Shnassar25/-Digital-IC-Design-SoC-RTL2GDS/spyglass/post_rtl/spyglass-1/consolidated_reports/lint_lint_abstract/README

################################################################################
#
# This file has been generated by SpyGlass:
#     Consolidated Reports Created by: ICer
#     Consolidated Reports Created on: Sun Sep 27 03:24:59 2026
#     Working Directory              : /home/ICer/ASS/Final_System/spyglass/post_rtl
#     Consolidated Reports Location  : ./spyglass-1/consolidated_reports/lint_lint_abstract/
#     SpyGlass Version               : SpyGlass_vL-2016.06
#
################################################################################

This directory contains critical reports generated in current run
In case this directory needs to be compressed using gtar, you may use - 

    % gtar -cvzf <compressed_tar_file_name> ./spyglass-1/consolidated_reports/lint_lint_abstract/
