Shnassar25/-Digital-IC-Design-SoC-RTL2GDS/spyglass/post_syn/spyglass-1/consolidated_reports/Design_Read/README

################################################################################
#
# This file has been generated by SpyGlass:
#     Consolidated Reports Created by: ICer
#     Consolidated Reports Created on: Mon Sep 21 02:56:27 2026
#     Working Directory              : /home/ICer/ASS/Final_System/spyglass/post_syn
#     Consolidated Reports Location  : ./spyglass-1/consolidated_reports/Design_Read/
#     SpyGlass Version               : SpyGlass_vL-2016.06
#
################################################################################

This directory contains critical reports generated in current run
In case this directory needs to be compressed using gtar, you may use - 

    % gtar -cvzf <compressed_tar_file_name> ./spyglass-1/consolidated_reports/Design_Read/
