Shnassar25/-Digital-IC-Design-SoC-RTL2GDS/final report.pdf

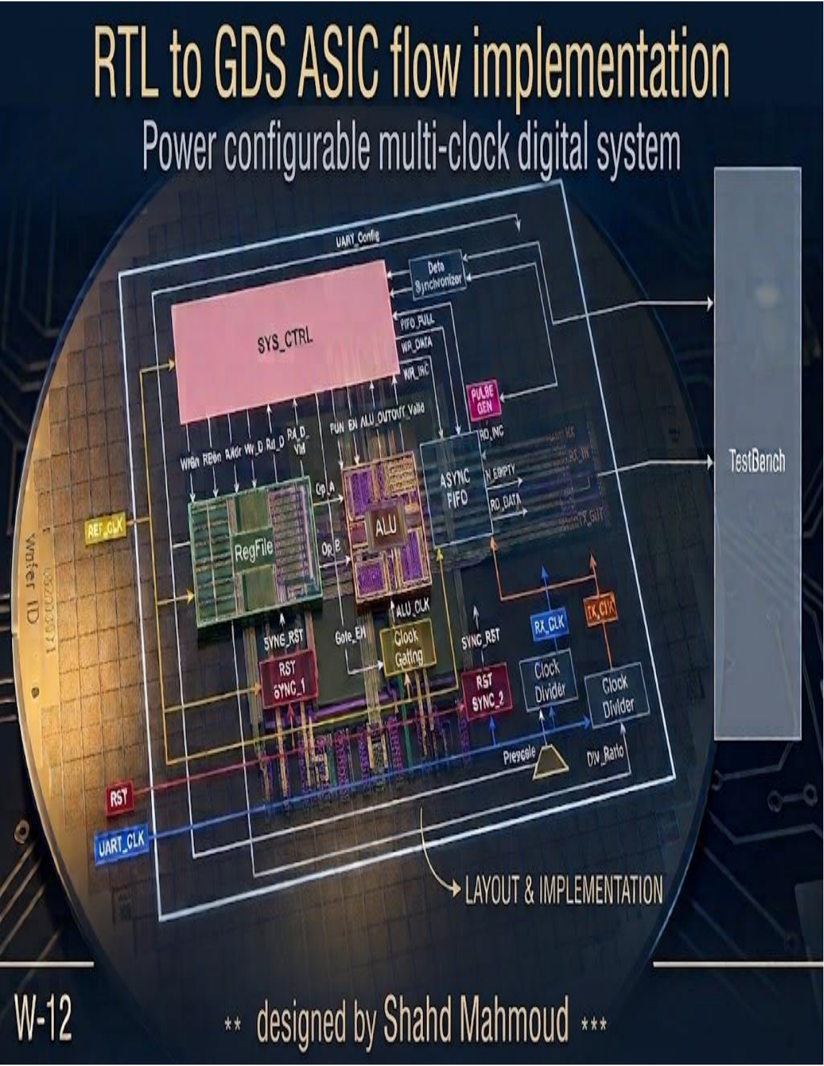
[picture p1: page 1]

### Table of Contents

### Table of Figures

Figure 1.1 — Complete Top-Level Block Diagram of the Configurable Multi-Clock Digital
Processing System, illustrating the dual-clock domains | 6
Figure 2.1.1 —Reg_file Symbol and Port Connections | 8

Figure 2.1.2 — Reg_file Internal Datapath, Multiplexers, and Arithmetic Logic RTL Structure
| 8
Figure 2.2.1 — ALU Symbol and Port Connections | 10

Figure 2.2.2 — ALU Internal Datapath, Multiplexers, and Arithmetic Logic RTL Structure
| 10
Figure 2.3 — Clock Gating Unit RTL / Internal Architecture | 11

Figure 2.4.1 — System Controller FSM State Transition Diagram, illustrating command
decoding paths, handshake conditions, and data serialization flows | 13
Figure 2.4.2 — System Controller Symbol and Top-Level Port Interfaces | 14

Figure 2.4.3 — System Controller Internal FSM State Transition Diagram and Datapath RTL
Schematic | 14

Figure 2.5 — Clock Divider Internal Counter, Dual-Edge Flip-Flops, and Multiplexing Logic
RTL View | 15
Figure 2.6.1 — UART Transmitter (UART_TX) Internal Block Diagram | 16

Figure 2.6.2 — UART Receiver (UART_RX) Internal RTL Schematic generated via Vivado
| 17

Figure 2.6.3 — UART Top-Level RTL Schematic generated via Vivado, illustrating the structural
integration of UART_TX and UART_RX sub modules | 18

Figure 2.6.4 — UART Transmitter (UART_TX) internal RTL schematic generated via Vivado,
illustrating the structural sub-modules | 18

Figure 2.6.5 — UART Transmitter (UART_RX) internal RTL schematic generated via Vivado,
illustrating the structural sub-modules | 19
Figure 2.7 — Pulse Generator (PULSE_GEN) Internal RTL Schematic | 20

Figure 2.8 — Reset Synchronizer | 20
Figure 2.9 — Data Synchronizer | 21
Figure 2.10 — Asynchronous FIFO Top-Level Architecture | 22

Figure 3.3.1 — Simulation Waveform Snapshot Focusing on the Read and WriteVerification
Phase | 24

Figure 3.3.2 — Simulation Waveform Snapshot Focusing on the ALU Operations and Execution
Verification Phase | 25

Figure 3.4 — Text-Based Simulation Log Output from ModelSim Console, Displaying Real-Time Execution Messages and Automated Self-Checking Verification Results
| 26

Figure 4.1 — Hierarchical RTL schematic view of the SYS_TOP design post-
synthesis | 27

Figure 4.2 — Area report summary generated via Synopsys Design Compiler for
SYS_TOP | 28
Figure 4.3 — Static Timing Analysis (STA) / Critical Path Report | 29

Figure 4.4.1 — Setup Timing Slack Report Demonstrating a Met Timing Condition
| 29

Figure 4.4.2 — Constraint Check Report Demonstrating Successful Adherence to Design Rules
| 29
Figure 4.5 — Hierarchical Power Consumption Analysis | 28

Figure 6.1 — Post-DFT formal verification results log confirming complete logical equivalence...... 32

Figure 6.2 — Post-Place and Route (PNR) formal verification success log confirming structural and
logical integrity | 32
Figure 7.1 — Area utilization report post-DFT insertion | 33
Figure 7.2 — Hierarchical power consumption report for SYS_TOP after DFT insertion | 33

Figure 8.1 — Specify Floorplan configuration GUI showing physical dimensions and core
margins | 34

Figure 8.2 — Fully routed layout view showing multi-metal layer interconnections across the
chip | 35

### 1. Introduction & System Overview

This project presents the complete RTL-to-Synthesis design flow of a commanddriven, multi-module digital processing architecture implemented in Verilog HDL. The system operates as a dedicated hardware processing unit that receives asynchronous serial commands and data packets from an external master via a UART interface, decodes and processes them through an Arithmetic Logic Unit (ALU) or a Register File, and transmits the resulting data back through a synchronized transmission channel .

1.1 Key System Features:

- Dual-Clock Domain Architecture: Operates across two independent clock domains (REF_CLK at 50 MHz and UART_CLK at 3.6864 MHz) to ensure safe communication and robust clock-domain crossing (CDC).
- Comprehensive ALU Operations: Supports 14 distinct arithmetic, logical, comparative, and shift operations.
- Configurable Register File: Features an 8 x 16 register file structure supporting general-purpose data storage (addresses 0x4 to 0x15) as well as reserved configuration and operand registers (addresses 0x0 to 0x3).
- Robust UART Subsystem: Integrated UART Transmitter (UART_TX) and Receiver (UART_RX) equipped with programmable baud rate generation, prescalers, and parity checking.
- Advanced Power Management & Synchronization: Utilizes internal Clock Gating for the ALU, active-low asynchronous reset synchronizers (RST_SYNC), data synchronizers, and an Asynchronous FIFO for safe data buffering between clock domains.

1.2 System Architecture Breakdown :

1. Clock Domain 1 (REF_CLK - 50 MHz):
- RegFile: Manages read and write operations for data storage and system configuration.
- ALU: Executes mathematical and logical instructions commanded by the system controller.
- Clock Gating: Dynamically controls the clock signal to the ALU (ALU_CLK) to optimize power consumption. o SYS_CTRL: The central Finite State Machine (FSM) that orchestrates command decoding, register access, and data flow.
2. Clock Domain 2 (UART_CLK - 3.6864 MHz):
- UART_TX & UART_RX: Handle serial-to-parallel and parallel-toserial data conversion. o Clock Dividers: Generate precise internal clock signals based on configuration division ratios.
- Pulse Generator & Data Synchronizers / Async FIFO: Mitigate metastability issues and safely bridge the asynchronous boundary between the UART domain and the system reference domain.

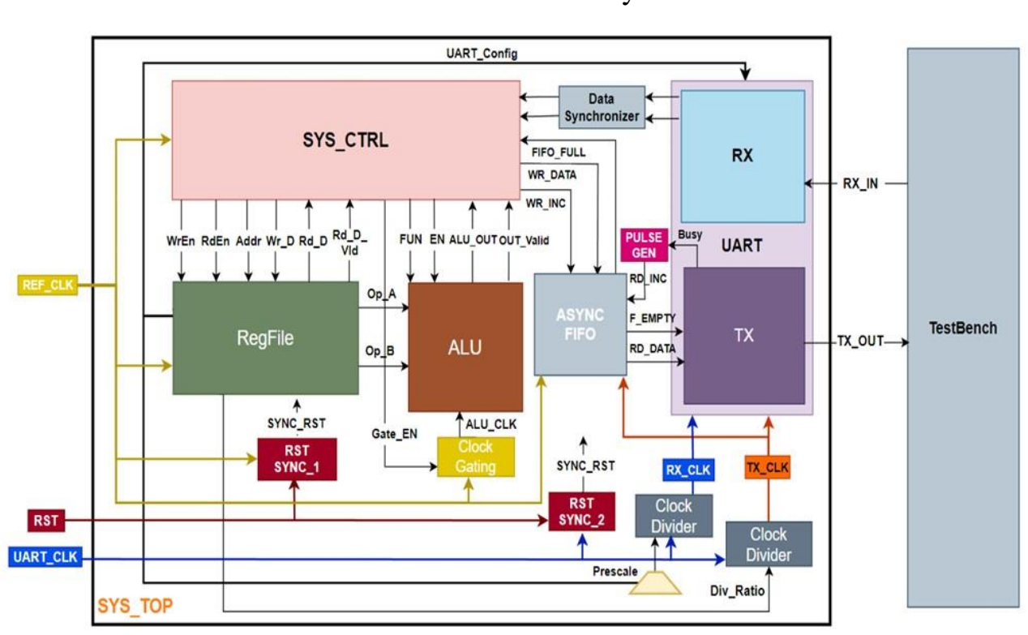
[picture p2: figure]

Figure 1.1: Complete Top-Level Block Diagram of the Configurable Multi-Clock Digital Processing System, illustrating the dual-clock domains

### 2. RTL Architecture & Sub-Modules Description

2.1 Register File :

The Register File module acts as the internal storage and configuration hub of the system, operating under REF_CLK (Clock Domain 1). It features a parameterizable architecture (defaulting to 16 registers of 8-bit width each) to handle data storage, ALU operand buffering, and subsystem configuration parameters.

- Core Functionality & Operations:
- Reset State: Upon the activation of an active-low asynchronous reset (RST_regfile), the internal memory locations are initialized. Specifically, preset default values are assigned to configuration registers REG2 (Parity Enable = 1, Parity Type = 0, Prescale = 32) and REG3 (Division Ratio = 32), while all other registers are cleared to zero.
- Write Operation: Enabled via the WrEn signal (asserted and exclusive of RdEn), allowing incoming write data (WrData) to be stored at the specified Address.
- Read Operation: Initiated via the RdEn signal (exclusive of WrEn), retrieving data from the addressed register into RdData alongside asserting the RdData_Valid flag for one clock cycle.
- Dedicated Register Mapping:
- REG0 (Address 0x0): Feeds ALU Operand A directly. o REG1 (Address 0x1): Feeds ALU Operand B directly.
- REG2 (Address 0x2): Configures UART parameters (Parity and Prescale).
- REG3 (Address 0x3): Supplies the division ratio to the clock divider.
- General-Purpose Registers (Addresses 0x4 to 0x15): Reserved for normal internal read and write data transactions.

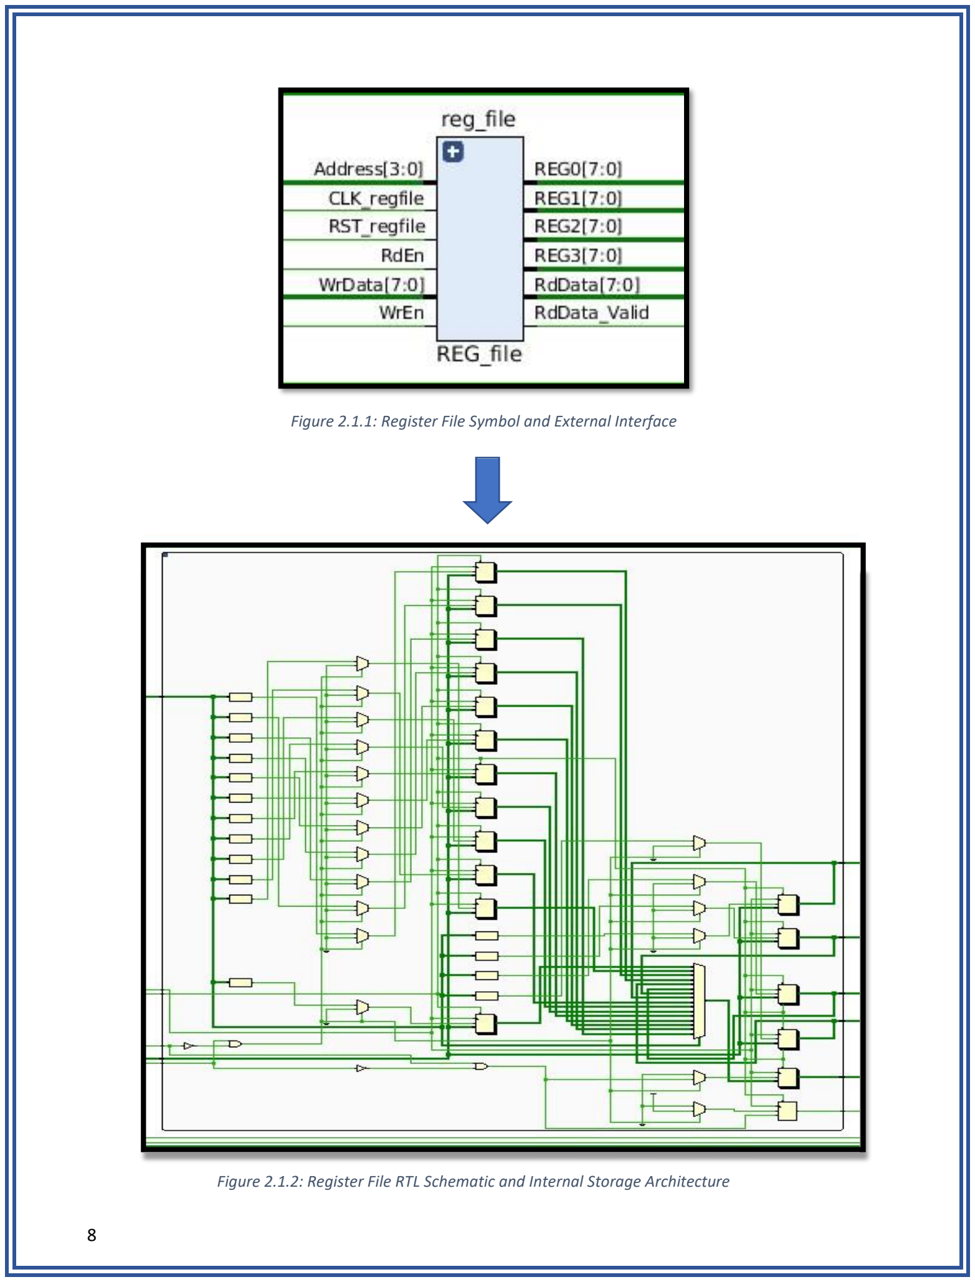
[picture p3: page 8]

Figure 2.1.1: Register File Symbol and External Interface

Figure 2.1.2: Register File RTL Schematic and Internal Storage Architecture

2.2 Arithmetic Logic Unit :

The Arithmetic Logic Unit (ALU) serves as the primary data processing engine of the system, operating under the gated clock domain (CLK_alu) and controlled by an active-low reset (RST_alu). Designed with parameterizable operand widths (defaulting to 8-bit inputs yielding a 16-bit output), the ALU executes 14 distinct functional operations based on the 4-bit selection code (ALU_FUN) when enabled via the EN_alu signal.

- Core Functionality & Architecture:
- Sequential Output Registering: Internal combinational logic computes the requested operation (reg_OUT) and validity status (reg_Valid), which are then registered on the positive edge of CLK_alu to drive ALU_OUT and OUT_VALID reliably.
- Reset Behavior: Upon assertion of the active-low reset (RST_alu), both ALU_OUT and OUT_VALID are cleared to zero.
- Supported Operation Categories (ALU_FUN):
- Arithmetic Operations (Codes 4'b0000 to 4'b0011): Includes addition (A + B), subtraction (A - B), multiplication (A * B), and safe division (A / B with built-in zero-denominator protection).
- Logical Operations (Codes 4'b0100 to 4'b1001): Performs bitwise operations including AND, OR, NAND, NOR, XOR, and XNOR.
- Comparison Operations (Codes 4'b1010 to 4'b1100): Evaluates relations between inputs, yielding specific flag outputs for equality (A == B returns 1), greater-than (A > B returns 2), and less-than (A < B returns 3), defaulting to 0 otherwise.
- Shift Operations (Codes 4'b1101 and 4'b1110): Executes bitwise right shift (A >> 1) and left shift (A << 1). o Default / NOP (Code 4'b1111 or unmapped values): Outputs zero safely when no valid operation is selected.

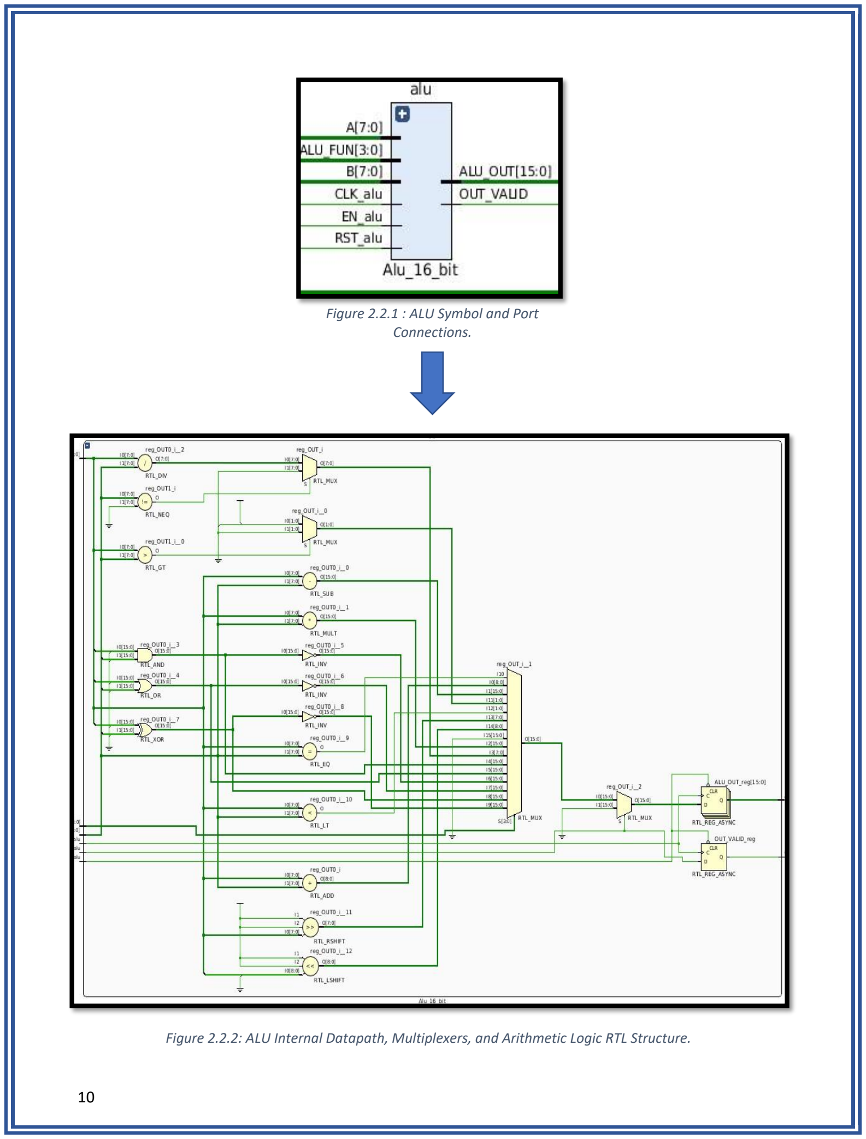
[picture p4: page 10]

Figure 2.2.2: ALU Internal Datapath, Multiplexers, and Arithmetic Logic RTL Structure.

Figure 2.2.1 : ALU Symbol and Port Connections.

2.3 Clock Gating Unit:

The Clock Gating unit is responsible for optimizing dynamic power consumption by selectively enabling or disabling the reference clock (CLK) supplied to the ALU (CLK_GATED) based on the control signal EN_CLK originating from the system controller.

- Core Architecture & Implementation Approaches:
- Standard Cell Integration (ASIC Flow): In the physical implementation flow, the design utilizes an integrated technologyspecific standard cell (TLATNCAX12M). This latch-based integrated clock-gating (ICG) cell safely combines the enable signal and the clock using a negative-level sensitive latch to prevent clock glitches, producing a glitch-free gated clock output (ECK). o RTL Behavioral Modeling: Alternatively, the architecture can be modeled behaviorally at the RTL level using a transparent levelsensitive latch (active when the clock is low) combined with a logical AND operation to gate the clock signal safely.

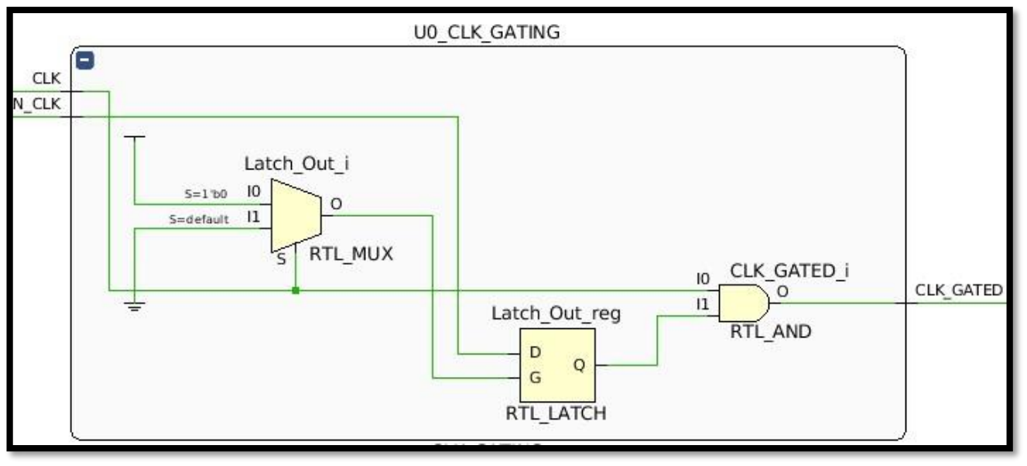
[picture p5: figure]

Figure 2.3 : Clock Gating Internal Implementation View (showing either the Behavioral Latch-AND structure

2.4 System Controller :

The System Controller acts as the central finite state machine (FSM) and master coordination unit of the architecture, managing command decoding, register file access, ALU operations, clock gating activation, and data transmission through the asynchronous FIFO.

- Core Architecture & FSM States:
- Command Decoding (IDLE State): The controller starts in the IDLE state, constantly monitoring the receiver valid signal (RX_VLD). When a command byte (RX_DATA) arrives, the FSM decodes it into core operations including Register Write (0xAA), Register Read (0xBB), ALU Operation (0xCC), and NOP (0xDD).
- Multi-Cycle Command Handling: The FSM transitions through specific sequential states (such as WR_ADDR WR_DATA for writes,
or ALU_OP_A ALU_OP_B ALU_FUN_ST for ALU execution) to
capture multi-byte command frames coming asynchronously from the UART receiver.
- Data Routing & Register File Interaction:
- Address & Data Capture: During write sequences, the target register address is latched into an internal register (reg_addr), WR_EN is asserted, and RX_DATA is routed directly to WR_DATA_S to update the addressed storage location. o Read Coordination: For read commands, the controller captures the address, asserts RD_EN, and once RD_DATA_VLD is asserted, it captures the read data and routes it (TX_P_DATA) to the FIFO for transmission.
- ALU Execution & Power Management Control:
- Clock Gating Activation: Prior to computation, the controller asserts CLKG_EN to activate the clock-gating cell, ensuring the ALU clock (CLK_alu) runs only when needed, while setting ALU_EN and routing the function code (ALU_FUN).
- Result Capturing: The FSM waits in the EXECUTE_ALU state until ALU_OUT_Valid is received. The 16-bit result is then safely latched into reg_alu_out, and a completion flag (reg_alu_saved) is set.

- Byte Serialization & FIFO Handshaking (PUSH_FIFO):
- 16-bit to 8-bit Splitting: Because the UART transmission interface handles 8-bit frames while the ALU output is 16-bit wide, an internal byte_counter in the PUSH_FIFO state extracts and pushes the high byte (reg_alu_out[15:8]) first, followed by the low byte (reg_alu_out[7:0]).
- Flow Control: The controller continuously monitors the FIFO_FULL flag to pause transmission (TX_D_VLD = 1'b0) when the FIFO is full, preventing data overflow across the asynchronous boundary.

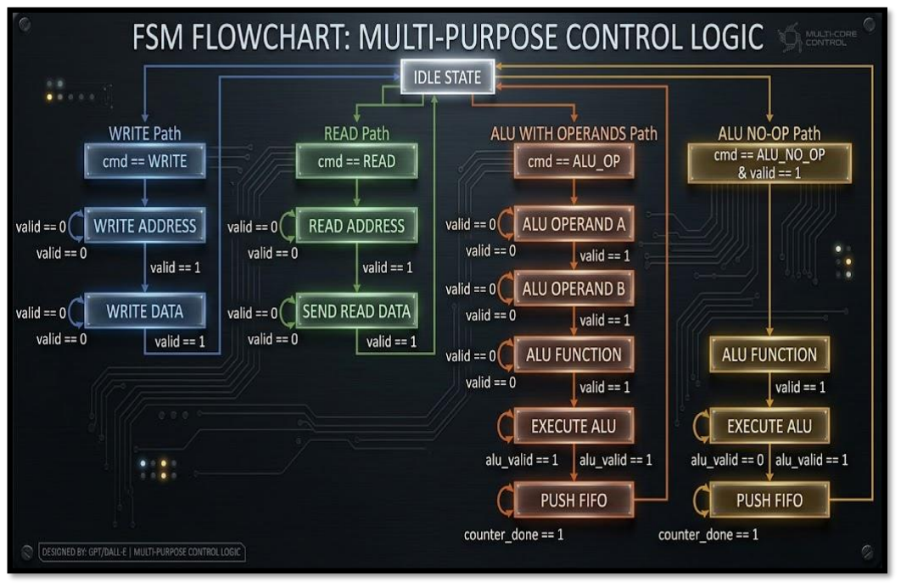
[picture p6: figure]

Figure 2.4.1:System Controller FSM State Transition Diagram, illustrating command decoding paths, handshake conditions, and data serialization flows

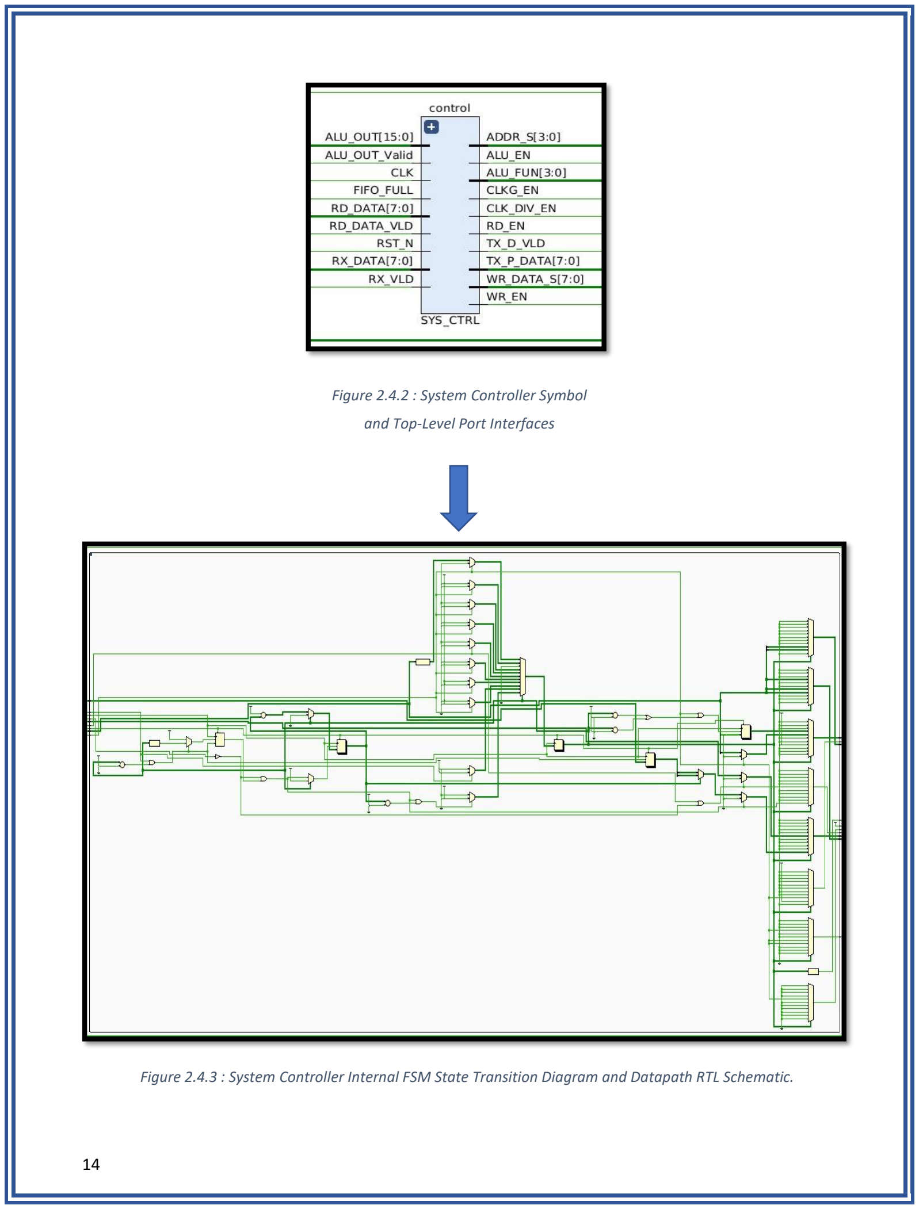
[picture p7: page 14]

Figure 2.4.2 : System Controller Symbol

Figure 2.4.3 : System Controller Internal FSM State Transition Diagram and Datapath RTL Schematic.

and Top-Level Port Interfaces

2.5 Clock Divider :

The Clock Divider module generates stable, configurable clock signals derived from the reference clock (i_ref_clk, operating in the UART domain) to supply the UART transmitter and receiver subsystems. It features a parameterizable division ratio (Div_Ratio) driven dynamically by configuration values stored in REG3 of the Register File.

- Core Architecture & Functionality:
- Configurable Enable & Division: Controlled via i_clk_en and regulated by the division ratio factor, allowing the module to bypass division or scale down the frequency accurately.
- Duty Cycle Correction (Odd/Even Handling): Implements a dualedge triggering mechanism combining positive-edge (q1) and negative-edge (q2) D flip-flops. For odd division ratios, it applies an
OR-logic combination (q1 | q2) to maintain a precise 50% duty cycle,
while even ratios utilize q1 directly.
- Asynchronous Reset: Operates under an active-low asynchronous reset (i_rst_n) supplied by the reset synchronizer (RST_SYNC_2), ensuring reliable initialization of the internal counter and flip-flops.

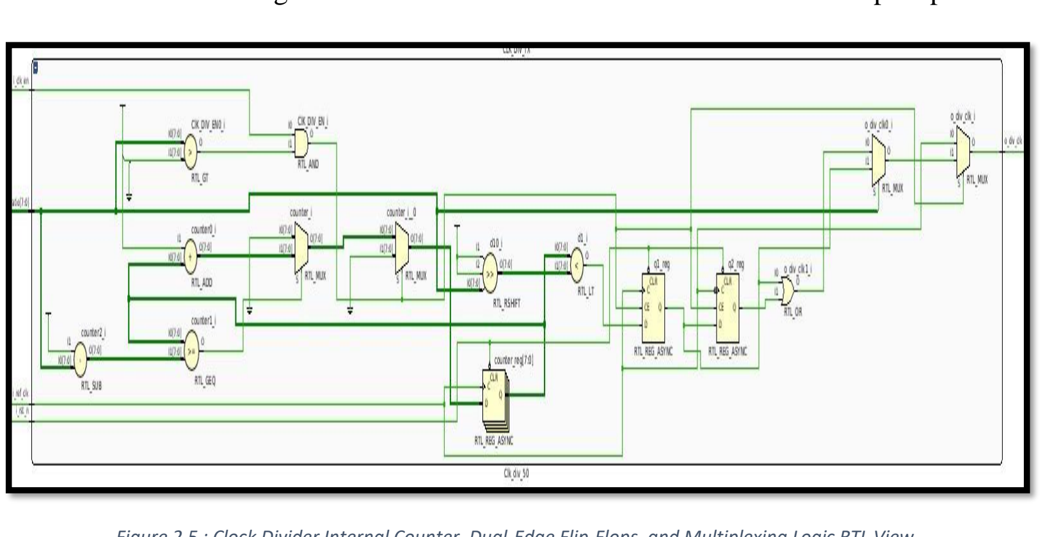
[picture p8: figure]

Figure 2.5 : Clock Divider Internal Counter, Dual-Edge Flip-Flops, and Multiplexing Logic RTL View.

2.6 UART Subsystem:

The Universal Asynchronous Receiver-Transmitter (UART) is a fundamental asynchronous serial communication protocol widely used in embedded systems. The UART subsystem is designed as a configurable communication interface comprising dedicated transmitter and receiver modules to serialize parallel data into robust serial bitstreams and deserialize incoming data back with high reliability.

### 2.6.1 UART Transmitter (UART_TX)

The UART Transmitter architecture is modularly divided into internal sub-blocks to ensure clean data flow, low power, and robust state transitions:

- Finite State Machine (FSM): Manages the transmitter states (Idle, Start, Data, Parity, and Stop) based on control signals and data validity.
- Parity Calculator: Computes either Even or Odd parity dynamically depending on the selected configuration (i_PAR_TYP_TX and i_PAR_EN_TX).
- Multiplexer (Mux): Selects the correct bit to transmit at each clock cycle (Start bit 0, data bits sequentially, parity bit, and Stop bit 1).
- Serializer / Data Path: Shifts and streams out parallel data bits synchronously with the internal baud clock

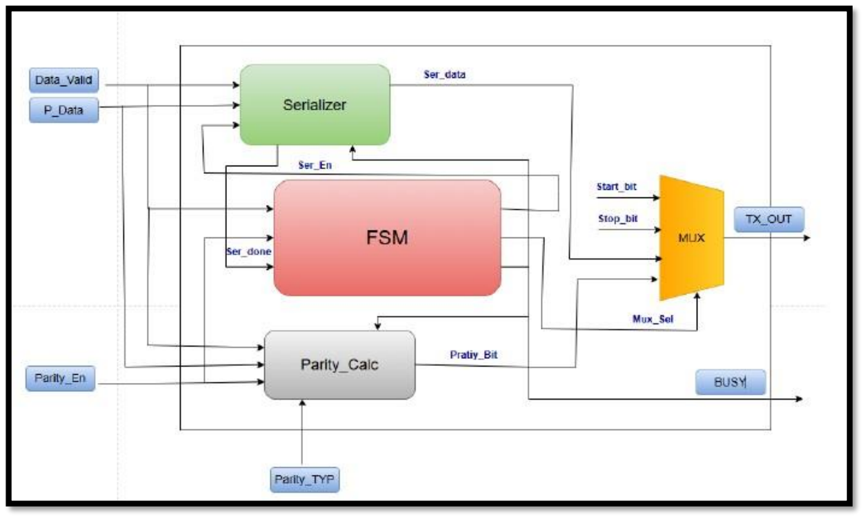
[picture p9: figure]

Figure 2.6.1 : UART Transmitter (UART_TX) internal block diagram

### 2.6.2 UART Receiver (UART_RX)

The UART Receiver architecture focuses on noise immunity, precise oversampling, and robust error detection:

- Finite State Machine (FSM_RX): Uses 3-bit Gray Code encoding (IDLE: 000, START: 001, DATA: 011, PARITY: 010, STOP: 110) to control sampling enables, deserialization, and error-check timing pulses.
- Data Sampler / Oversampler: Samples incoming serial lines multiple times per bit period at the center edge count (Prescale / 2) for noise-resilient detection.
- Deserializer: Shifts and converts sequential serial bits into an 8-bit parallel output register (o_P_Data_RX).
- Parity Checker: Computes expected parity and asserts o_Parity_Error_RX upon mismatch.
- Stop Bit Checker: Validates that frames end with logic high (1); asserts o_Stop_Error_RX and suppresses o_Data_Valid_RX if a framing error occurs.
- Start Glitch Detector: Verifies that the start bit remains low (0) through its sampling midpoint. If noise bounces the line high, it asserts o_Start_Glitch_RX and returns safely to IDLE without data corruption

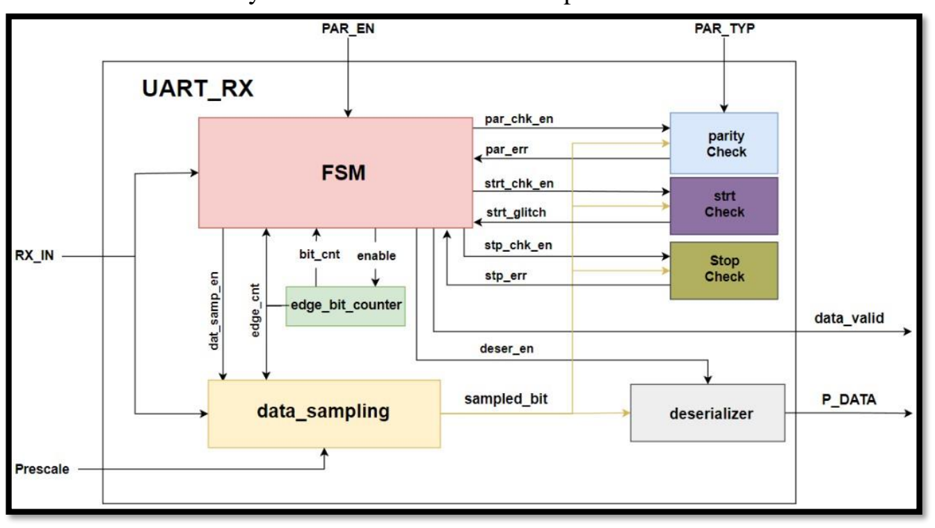
[picture p10: figure]

Figure 2.6.2 : UART Receiver (UART_RX) architecture and oversampling mechanism

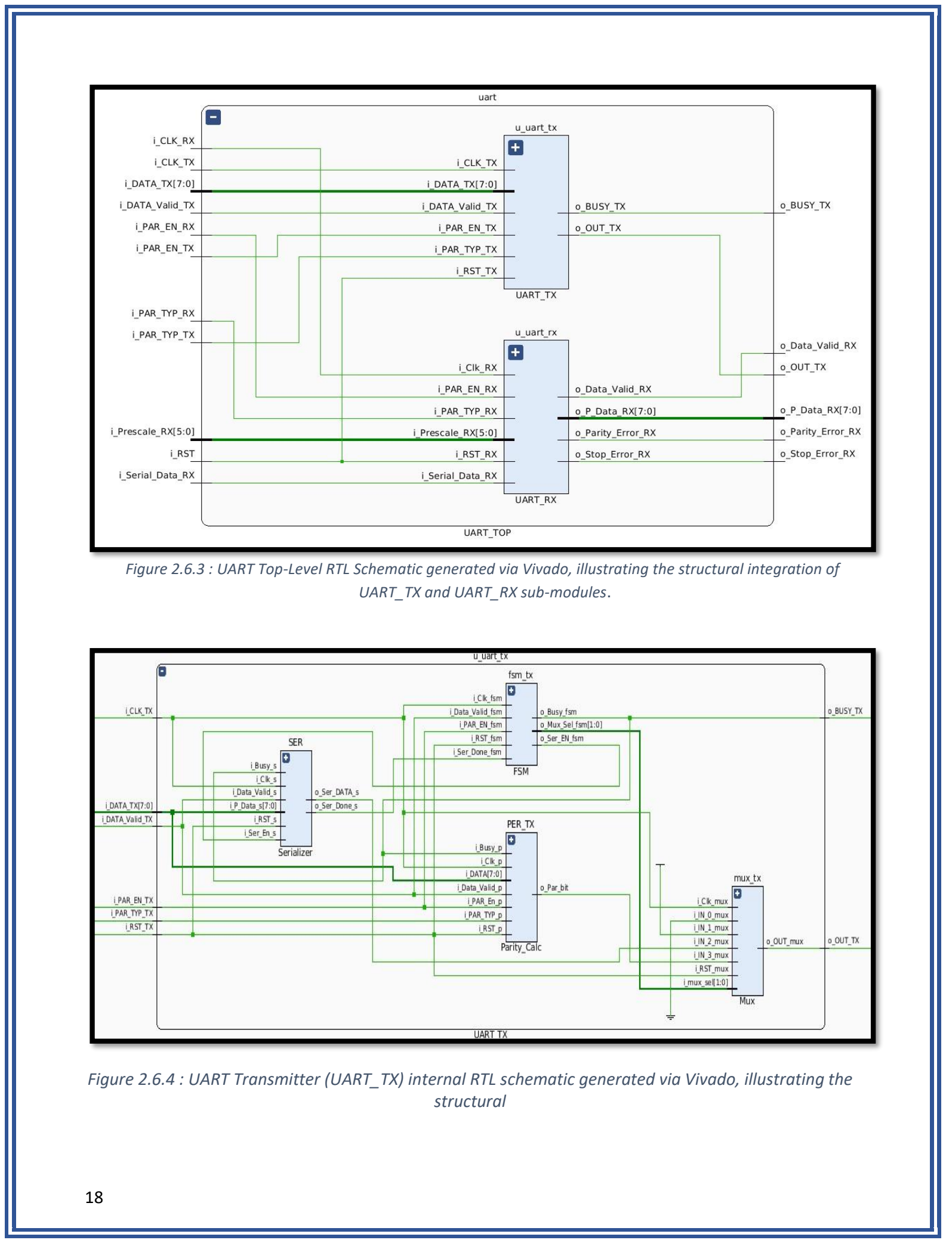
[picture p11: page 18]

UART_TX and UART_RX sub-modules.

Figure 2.6.4 : UART Transmitter (UART_TX) internal RTL schematic generated via Vivado, illustrating the structural

Figure 2.6.3 : UART Top-Level RTL Schematic generated via Vivado, illustrating the structural integration of

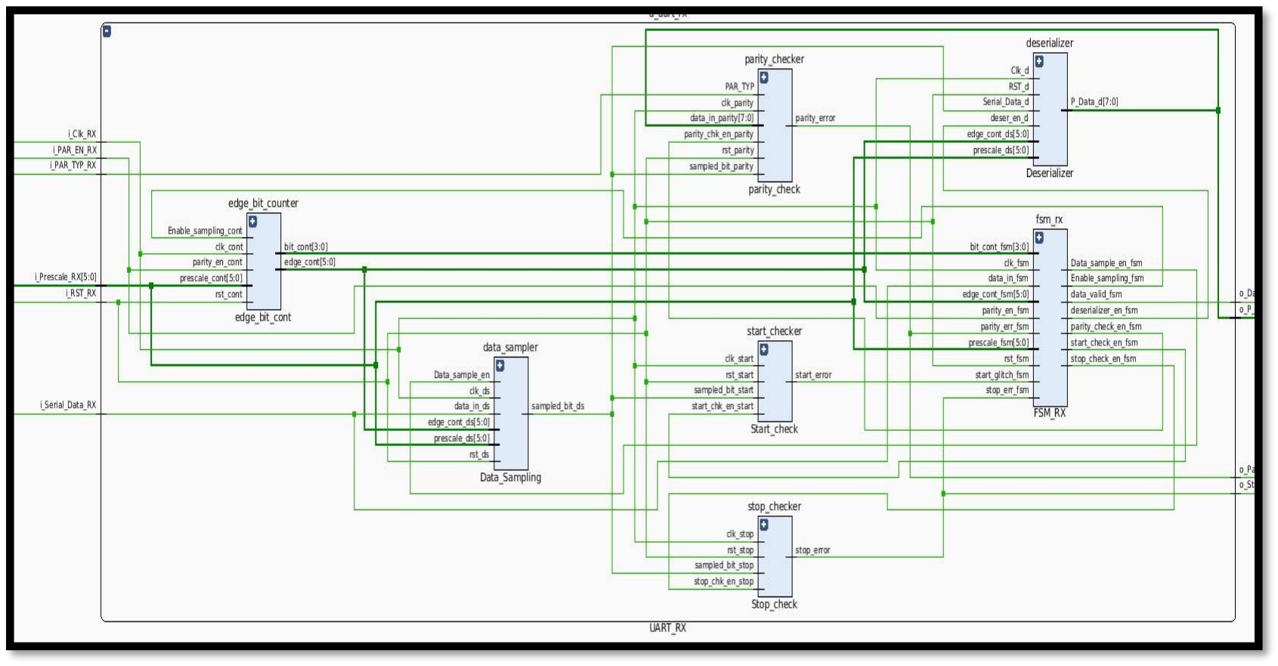
[picture p12: figure]

Figure 2.6.5 : UART Receiver (UART_RX) internal RTL schematic generated via Vivado, illustrating the structural submodules and signal interconnections
2.7 Pulse Generator:

The PULSE_GEN module acts as a pulse-shaping edge detector that transforms a level-sensitive signal (lvl_sig) into a single-cycle pulse (pulse_sig). This is crucial for interfacing control signals safely into asynchronous clock domains without registering redundant pulses.

- Design Operation:
- Uses a two-stage flip-flop structure (lvl_sig_ff and pulse_flop) synchronized with the internal clock (clk) and asynchronous activelow reset (rst).
- Implements combinatorial edge detection using the expression: pulse_sig = lvl_sig_ff && (~pulse_flop);
- Generates a clean 1-clock-cycle pulse when a rising transition of the level signal is detected.

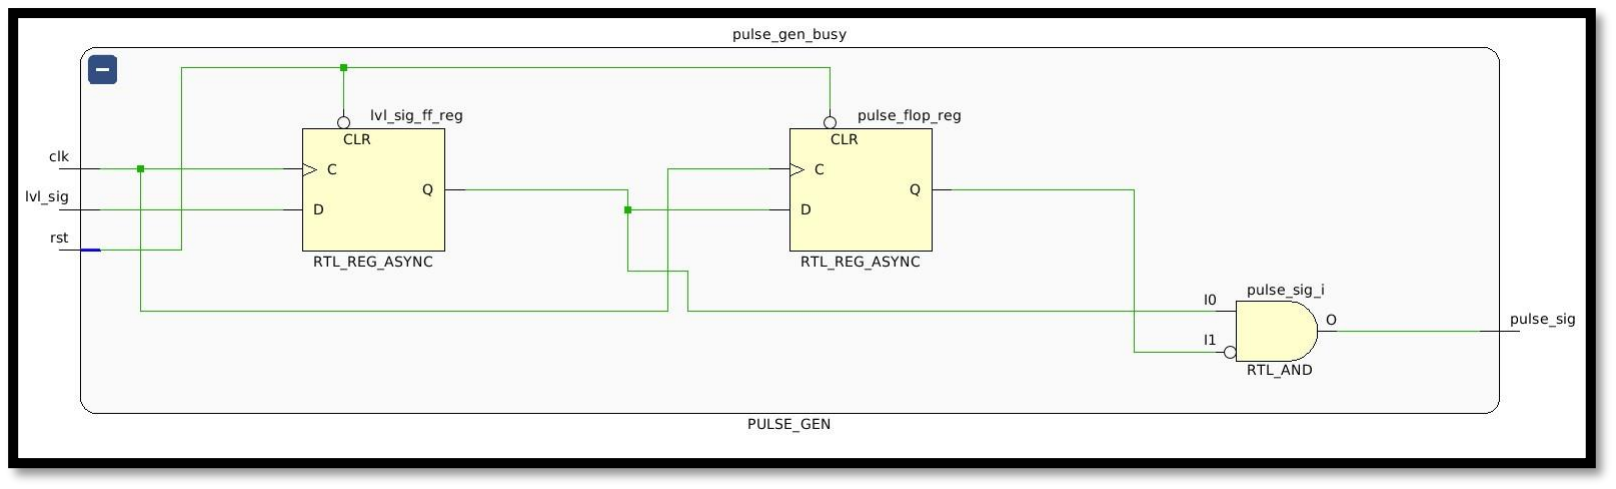
[picture p13: figure]

Figure 2.7 : Pulse Generator (PULSE_GEN) internal RTL schematic
2.8 Reset Synchronizer :

The RST_SYNC module is a multi-stage flip-flop synchronizer designed to eliminate metastability issues during the release (de-assertion) of an asynchronous reset signal across different clock domains.

- Design Operation:
- Utilizes a configurable shift register (sync_reg) governed by the parameter NUM_STAGES (default set to 2 stages).
- Operates on the positive edge of the target clock (CLK_Rsync) with an active-low asynchronous reset (RST_Rsync). o Asynchronous Assertion: When RST_Rsync goes low, the internal registers are instantly cleared to zero ({NUM_STAGES{1'b0}}), ensuring immediate system reset. o Synchronous De-assertion: Upon the release of the reset line, logic 1 values are shifted sequentially through the register chain on each rising clock edge, preventing metastable states from propagating to the internal logic via SYNC_RST.

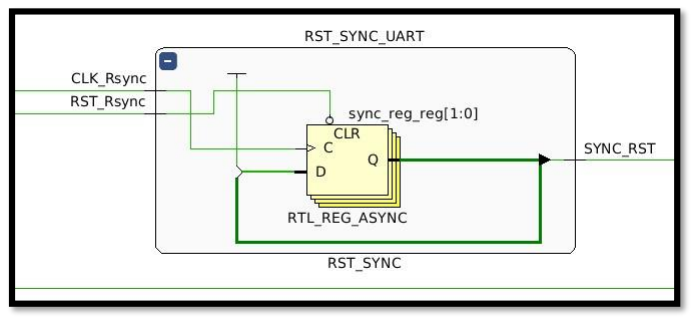
[picture p14: figure]

Figure 2.8: Reset Synchronizer

2.9 Data Synchronizer:

The Data_SYNC module is a robust multi-clock domain synchronization circuit designed to securely transfer multi-bit parallel data (ASYNC) alongside a control flag (BUS_EN) from a source clock domain to a destination clock domain (CLK) without data corruption or metastability issues.

- Design Operation & Architecture:
- Configurable Parameters: Uses NUM_STAGES (default 2 stages) for the synchronizer chain and BUS_WIDTH (default 8 bits) to accommodate flexible parallel data sizes. o Control Signal Synchronization: Employs a multi-stage shift register (sync_enable_reg) to synchronize the asynchronous enable signal (BUS_EN) safely into the destination clock domain.
- Pulse Generation: Integrates an internal pulse-shaping circuit (pulse_gen) that detects the synchronized rising edge of the enable signal, producing a clean single-cycle indicator (ENABLE_PULSE).
- Data Latching Mechanism: Utilizes a conditional register block governed by pulse_gen to capture and latch the asynchronous bus data (ASYNC) into SYNC_BUS precisely when the control signal is stable, preventing race conditions or invalid data sampling.

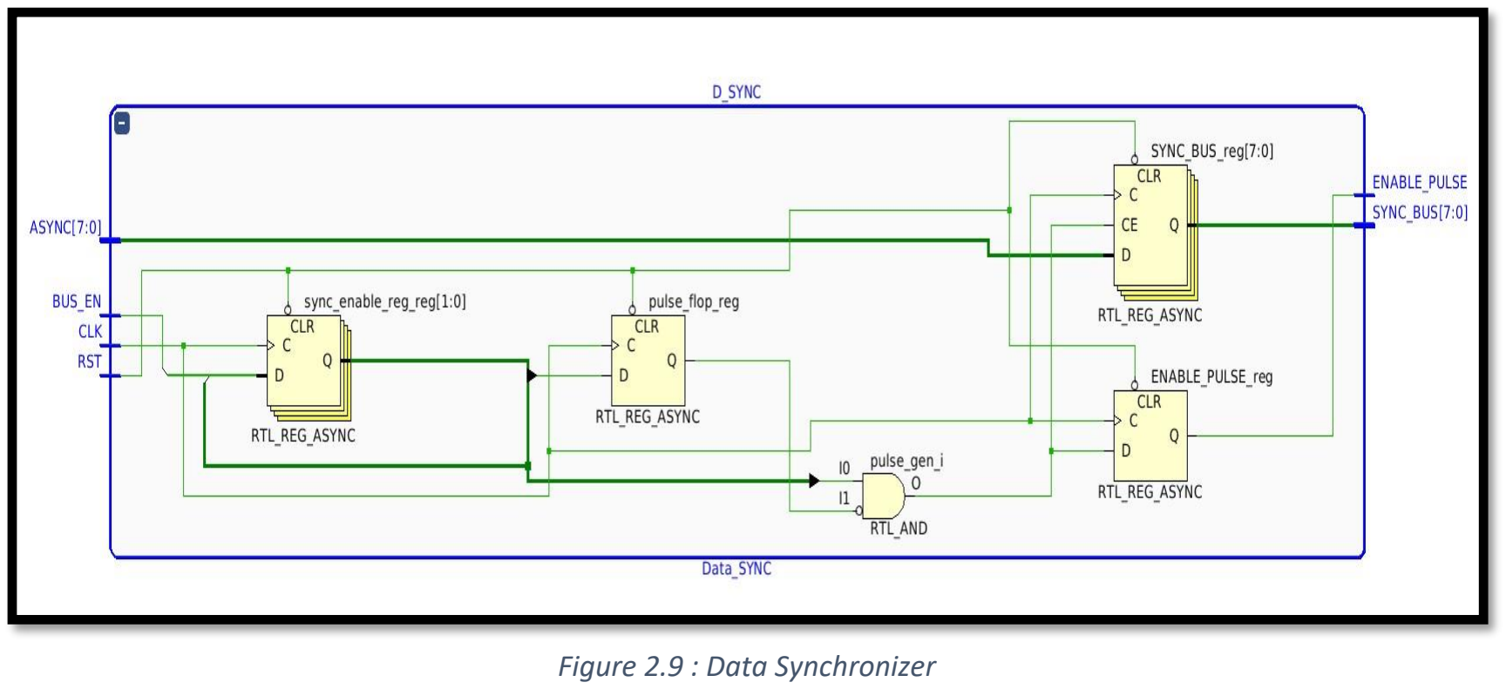
[picture p15: figure]
Figure 2.9 : Data Synchronizer

2.10 Asynchronous FIFO Top-Level:

The ASYNC_FIFO module serves as the top-level wrapper for a robust, clockdomain-crossing (CDC) asynchronous First-In-First-Out memory buffer. It enables safe data streaming between independent write and read clock domains (W_CLK and R_CLK) using Gray-code pointer synchronization.

- Design Architecture & Sub-blocks:
- 1. Write Control & Full Generation (FIFO_WR): Manages write operations, internal write addresses (W_ADDR), and generates the write full status (W_FULL) by comparing the write pointer against the synchronized read pointer.
- 2. Read Control & Empty Generation (FIFO_RD): Manages read increments, internal read addresses (R_ADDR), and generates the read empty status (R_EMPTY) by comparing the read pointer against the synchronized write pointer.
- 3 & 4. Pointer Synchronizers (BIT_SYNC): Utilizes dual-rank synchronizer chains (u_sync_w2r and u_sync_r2w) to safely cross multi-bit Gray pointers between asynchronous write and read domains without metastability risks. o 5. Dual-Port RAM Memory Array (FIFO_MEM_CNTRL):
Implements the underlying dual-port memory block handling concurrent write data buffering and asynchronous read access based on the generated pointers

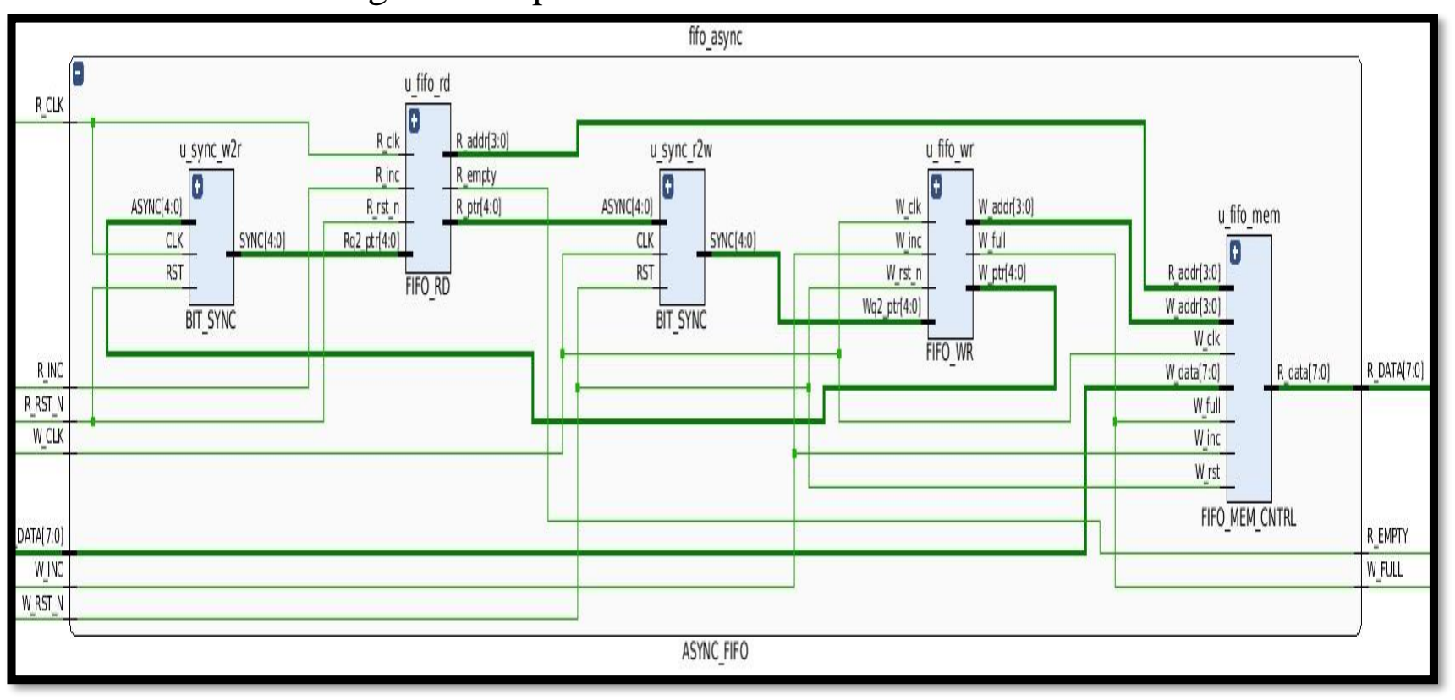
[picture p16: figure]

Figure 2.10 : Asynchronous FIFO top-level RTL schematic

### 3. Verification and Testbench Methodology

To ensure the functional correctness, protocol compliance, and robust integration of the multi-module SoC system (SYS_TOP), a comprehensive self-checking testbench (SYS_TOP_TB) was developed. The verification environment emulates serial communication interactions, dynamic parity configurations, register-file transactions, and arithmetic logic unit (ALU) executions.

3.1 Testbench Architecture & Timing Parameters:

The testbench is structured around dual clock domains and configurable serial transmission delays:

- Clock Generation: Generates a high-speed reference clock (REF_CLK_tb at 50 MHz, 20 nsperiod) and a baud-rate UART clock (UART_CLK_tb). • Timing Modeling: Incorporates precise bit-period calculations (BIT_PERIOD = PRESCALE * BIT_TIME) matching a prescale factor of 32 to simulate realistic asynchronous UART frame transmissions.
- Command Encapsulation: Defines standardized command local parameters (CMD_WR_REG, CMD_RD_REG, CMD_ALU_OP, and CMD_ALU_NOP) to drive system operations seamlessly.

3.2 Register File Write and Read Verification

The first primary verification phase validates the system's capability to configure internal registers, write data bytes securely via the serial interface, and read them back with accurate data matching.

- Test Scenario & Execution Flow:
1. Configuration Phase: Sends write commands to set up internal configuration registers (e.g., enabling dynamic parity with even configuration via address 8'h02 and 8'h81, and configuring baud or control parameters at 8'h03).
2. Write Operations (write_reg task): Issues the CMD_WR_REG (8'hAA), followed by the target address and data payload serially using uart_send_byte.

3. Read and Check Operations (read_reg_and_check task): Issues the CMD_RD_REG (8'hBB) and target address, captures the returning serial stream via uart_receive_byte, and performs an automated selfchecking comparison against expected data values.

3.3 Simulation Test Scenarios & Verification Phases .

- Test Case 1: Phase 1 (Configuration)
- Action: Initializes the system and configures parity settings.
- Address & Data: Written via addresses 8'h02 and 8'h03.
- Objective: Enables dynamic parity checking and establishes baseline control configurations.
- Test Case 2: Phase 2 (Register File Write & Read Tests)
- Action: Writes test data payloads (8'h55, 8'hAA, 8'h3F) into specific register addresses (8'h04, 8'h05, 8'h06).
- Verification: Followed by readback commands to verify complete data matching.
- Objective: Validates internal register storage and retrieval accuracy.
- Test Case 3: Phase 3 (ALU Operations & Verification)
- Action: Executes arithmetic and logic operations within the system.
- Data Capture: Captures 16-bit combined results across consecutive serial bytes.
- Objective: Ensures accurate data processing and correct execution of computational tasks.

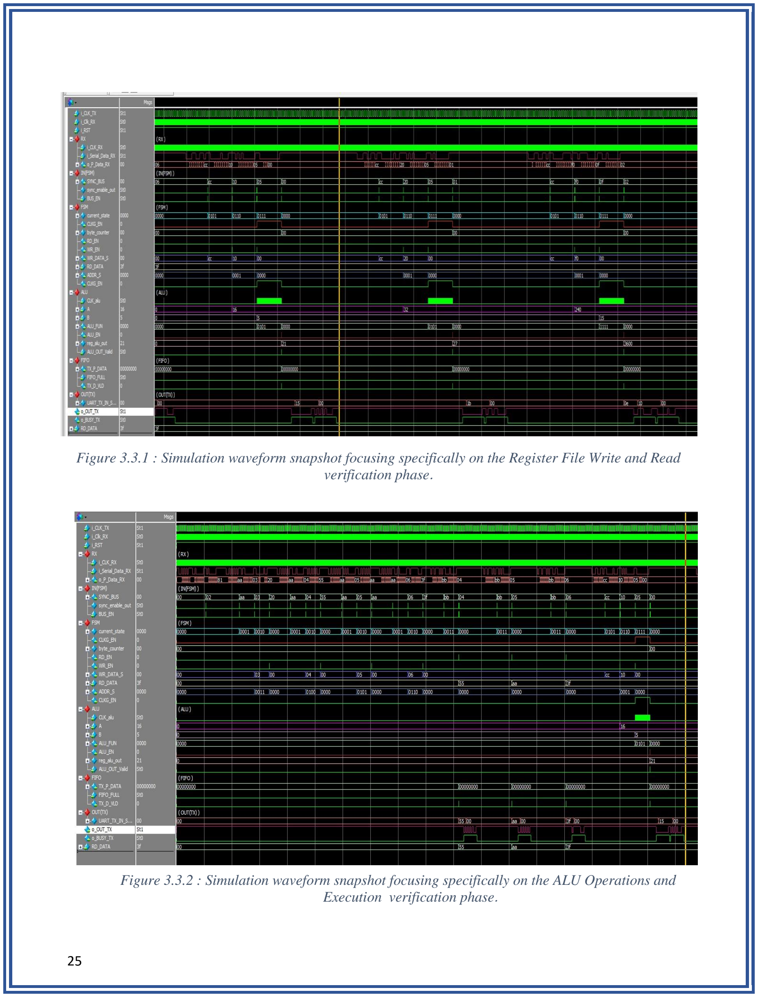
[picture p17: page 25]

Figure 3.3.1 : Simulation waveform snapshot focusing specifically on the Register File Write and Read verification phase .

Figure 3.3.2 : Simulation waveform snapshot focusing specifically on the ALU Operations and Execution verification phase .

3.4 Simulation Console Output & Verification Log

- Configuration & Status: Displays initial register programming and dynamic parity monitoring logs
- Register File Validation: Confirms successful write and readback matching for data bytes (0x55, 0xaa, 0x3f) with [PASS] assertions.
- ALU Computation Checks: Verifies accurate 16-bit computational results against expected values.
- Final Summary: Concludes with the successful system verification message (ALL TESTS

PASSED SUCCESSFULLY! No errors detected.).

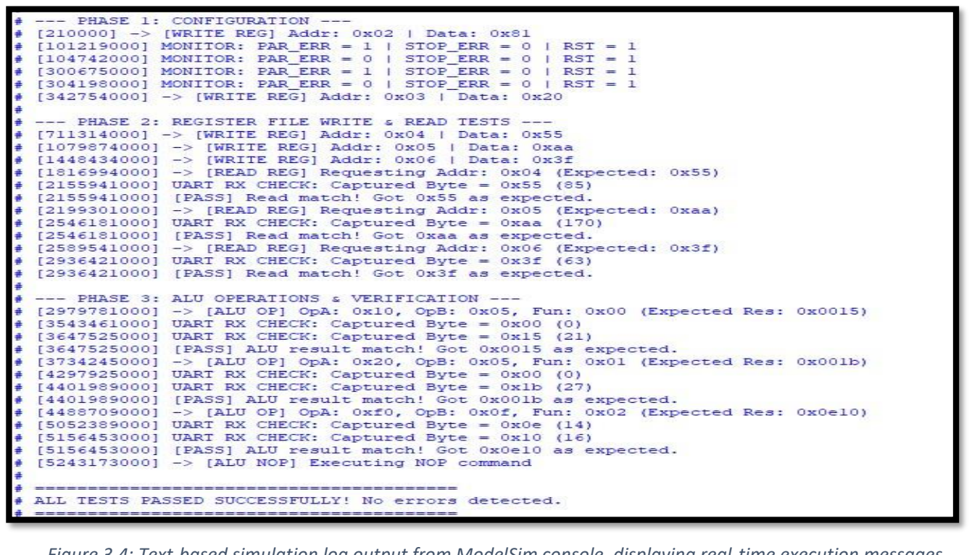
[picture p18: figure]

Figure 3.4: Text-based simulation log output from ModelSim console, displaying real-time execution messages and automated self-checking verification results.

### 4. Synthesis and Timing Analysis Report

After completing functional verification, the top-level design (SYS_TOP) was synthesized using Synopsys Design Compiler targeting the
scmetro_tsmc_cl013g_rvt_ss_lp08v_125c standard cell library. This section
comprehensively covers area utilization, static timing analysis (STA), constraint compliance, and power distribution metrics.

4.1 Synthesized RTL Schematic View

The generated schematic provides a high-level graphical representation of the synthesized hardware, illustrating the interconnects between the primary functional blocks:

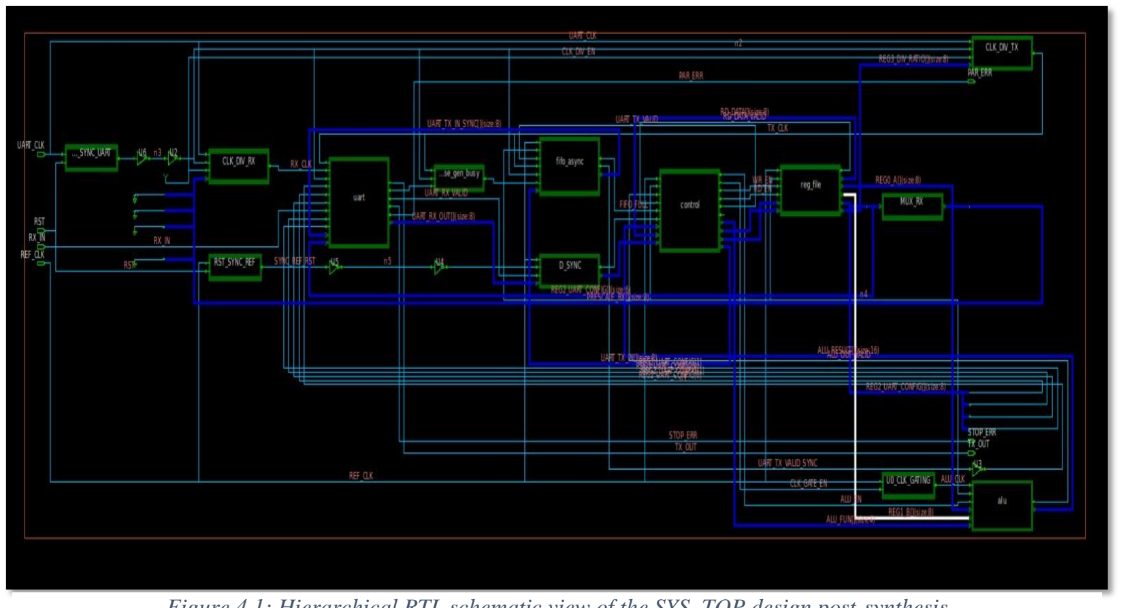
[picture p19: figure]

Figure 4.1: Hierarchical RTL schematic view of the SYS_TOP design post-synthesis

4.2 Area Utilization Summary

The area report details the footprint and hardware resource distribution of the synthesized design across combinational and sequential logic:

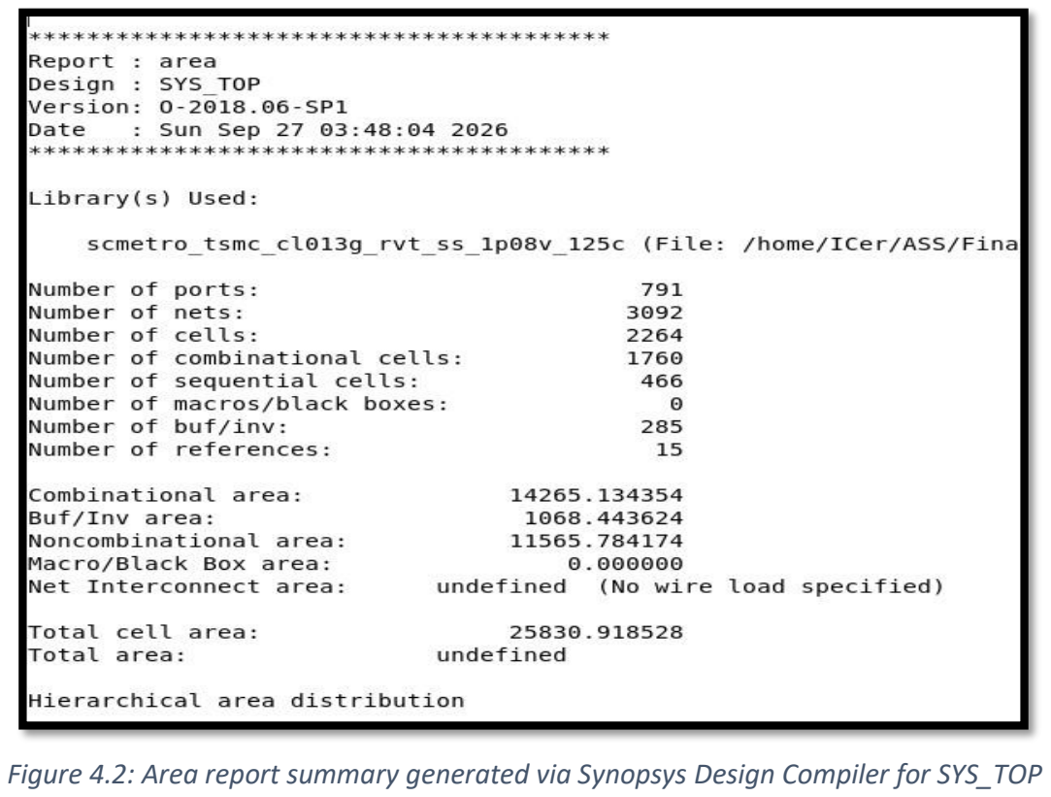
[picture p20: figure]

Description: This report highlights the key structural area metrics:

- Cell Distribution: Total cells = 2264 (Combinational cells = 1760, Sequential cells = 466, Buffers/Inverters = 285).
- Area Allocation: Combinational area = 14265.13, Non-combinational area = 11565.78, yielding a Total cell area of 25830.92.

Figure 4.2: Area report summary generated via Synopsys Design Compiler for SYS_TOP

4.3 Static Timing Analysis (STA) & Critical Path

The timing engine evaluates the worst-case propagation delays to ensure the design can operate reliably at target clock frequencies.

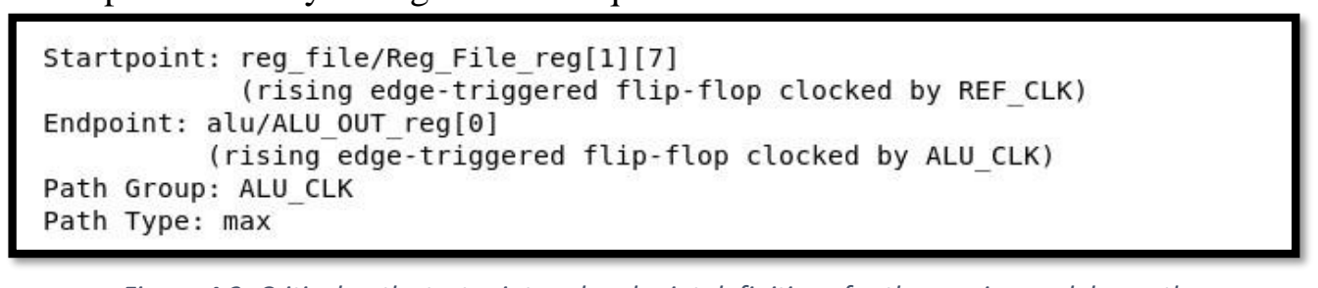
[picture p21: figure]

Figure 4.3: Critical path startpoint and endpoint definitions for the maximum delay path group.
4.4 Setup Timing Slack & Constraints Compliance

The timing margin and constraint checks verify that all design rules and setup requirements are fully satisfied without violation.

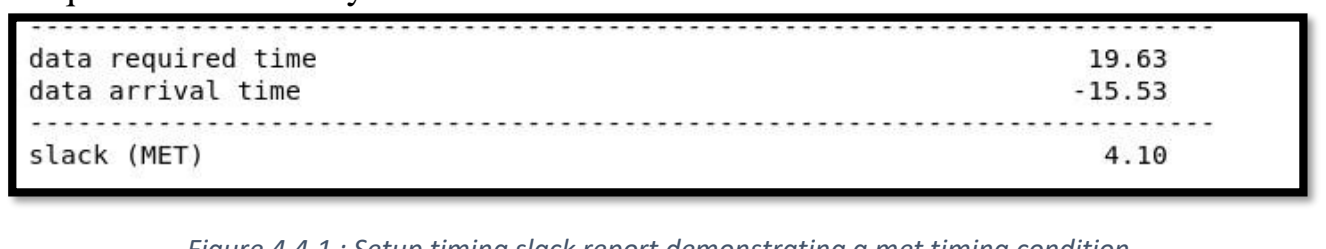
[picture p22: figure]

Figure 4.4.1 : Setup timing slack report demonstrating a met timing condition.
Description:
- Data Required Time: 19.63 ns
- Data Arrival Time: -15.53 ns
- Slack (MET): +4.10 ns (confirming a safe positive timing margin).

Description:

This log explicitly confirms that "This design has no violated constraints," validating that all timing, environmental, and structural parameters were fully met

Figure 4.4.2: Constraint check report demonstrating successful adherence to design rules.

4.5 Hierarchical Power Consumption Analysis

The power report provides an estimation of power dissipation categorized by switching, internal, and leakage components across the design hierarchy.

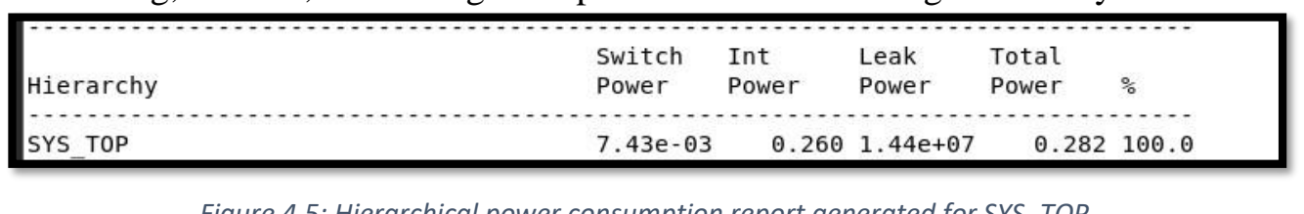
[picture p23: figure]

Figure 4.5: Hierarchical power consumption report generated for SYS_TOP.
Description:

This breakdown outlines the power metrics for the top-level module:

- Switching Power: 7.43e-03
- Internal Power: 0.260
- Leakage Power: 1.44e+07
- Total Power: 0.282 (100% distribution across the hierarchy).

### 5. Spyglass Lint and CDC Waivers

During the static code analysis and linting phase using Synopsys/Spyglass, specific rule checks and clock-domain crossing (CDC) warnings were reviewed. To ensure clean design sign-off while managing safe internal architectural exceptions, designated waivers were established and documented.

5.1 Lint and Setup Waivers

The following waiver configurations were applied to handle specific design exceptions and prevent false-positive violations during the linting process:

- Rule STARC05-1.4.3.4 (Clock Signal Usage):
- Design Unit (-du): Clk_div_50
- Waiver Message: Handled clock signals utilized as non-clock inputs (specifically SYS_TOP.CLK_DIV_TX.q1 and related instances).
- Justification: Explicitly waived as parent-waived constraints, ensuring that internal clock divider outputs routed into logic paths are properly recognized without triggering redundant lint errors.

- Rule ReportIgnoredOverlappingRules:
- Justification: Applied to streamline reporting outputs by filtering out overlapping redundant rule checks, maintaining a clean and concise lint summary log.
5.2 CDC and Advanced Rule Waivers

To handle asynchronous clock domain crossings and structural signal checks during CDC and linting analysis, specific rules were formally waived with timestamped tracking:

- Rule Ac_conv04 (Asynchronous Conversion / Synchronization Check):
- Timestamped Waivers: Created on 27-Sep-2026 (at 06:27:41 and 06:33:38). o Justification: Waived to acknowledge handled asynchronous control signals crossing clock boundaries where proper synchronizer chains are intentionally implemented.
- Rules Ac_cdc01a & Ac_datahold01a (CDC & Data Hold Verifications):
- Timestamped Waivers: Created on 27-Sep-2026 (Ac_cdc01a at 06:33:52 and Ac_datahold01a at 06:39:18). o Justification: Applied to suppress safe structural CDC warnings and data hold checks across multi-clock domains after verifying design safety and stability.
- Rules Setup_port01 & Clock_check04 (Port Setup & Clock Interaction Checks): o Timestamped Waivers: Created on 27-Sep-2026 (Setup_port01 at 03:25:47 and 04:53:17; Clock_check04 at 04:20:40). o Justification: Implemented to clear port setup and clock verification constraints that are managed externally or verified via static timing analysis (STA) rather than structural linting rules.

### 6. Formal Verification and Equivalence Checking

To ensure that the functional behavior of the design remains completely intact throughout the physical and testability transformation flows, Formal Equivalence Checking (LEC) was performed using Synopsys Formality. The synthesized golden RTL model was compared against various implementation netlists (Post-Synthesis, Post-DFT, and Post-PNR).

6.1 Post-DFT Formal Verification Results

Following the test insertion and optimization stages, equivalence checking was executed to verify that the gate-level netlist logically matches the golden reference model without introducing any functional discrepancies.

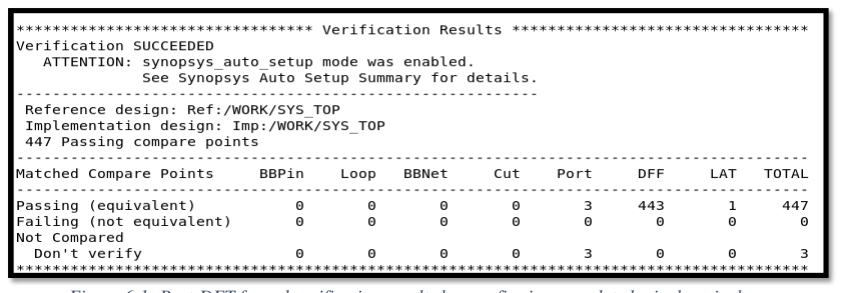
[picture p24: figure]

6.2 Post-PNR Formal Verification Results

After completing the physical Place and Route (PNR) stage, formal verification was re-run against the netlist to guarantee that the physical routing, cell placements, and optimizations did not disrupt the core functionality of the design.

Figure 6.1: Post-DFT formal verification results log confirming complete logical equivalence

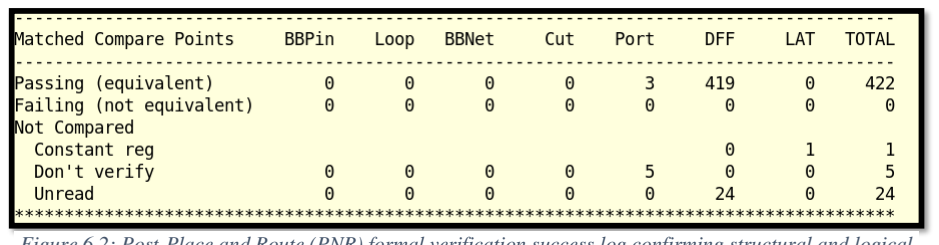
[picture p25: figure]

Figure 6.2: Post-Place and Route (PNR) formal verification success log confirming structural and logical integrity.

### 7. Design for Testability (DFT)

To ensure high test coverage and facilitate manufacturing defect detection (such as stuck-at faults and transition faults) during post-fabrication testing, Design for Testability (DFT) techniques were integrated into the SoC architecture.

7.1 Scan Chain & Hardware Overhead Insertion

- Scan Architecture: Sequential elements within the core design (SYS_TOP) were replaced with scan-enabled flip-flops, creating structured scan chains.
- Structural Impact on Area: Following DFT insertion, the hardware resource distribution was updated as reflected in the synthesis/DFT report:
- Cell Distribution: Total cells = 3111 (Combinational = 2601, Sequential = 466, Buffers/Inverters = 1107, Ports = 920).
- Area Allocation: Combinational area = 21284.15, Non-combinational area = 14715.81, yielding a Total cell area of 35999.96 (accounting for the test logic overhead).

7.2 Power Analysis Post-DFT

The power consumption profile was re-evaluated after integrating the test logic to monitor any impact on dynamic and leakage power dissipation:

Figure 7.1: Area utilization report post-DFT insertion

Figure 7.2: Hierarchical power consumption report for SYS_TOP after DFT insertion.

7.3 Formal Verification Validation

As demonstrated previously in Section 6, the structural insertion of the test logic was rigorously checked using formal equivalence checking (Formality), proving zero functional corruption to the original RTL datapath.

### 8. Backend & Place and Route (PNR)

To transition the gate-level netlist into a physical, manufacture-ready layout, the Place and Route (PNR) flow was executed. This phase encompasses core floorplanning, standard cell placement, clock tree synthesis (CTS), and global/detailed routing.

8.1 Floorplan Specifications & Design Dimensions

The physical boundaries, core margins, and aspect ratios of the chip were defined during the initial floorplanning stage using structured sizing parameters:

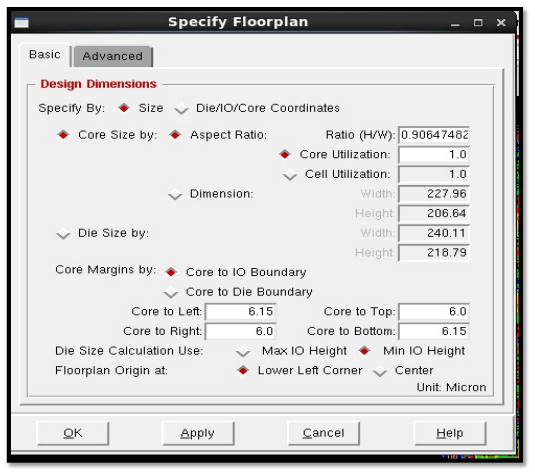
[picture p26: figure]

Figure 8.1: Specify Floorplan configuration GUI showing physical dimensions and core margins

Description: Key floorplanning dimensions and metrics:

- Core Size: Width = 227.96 µm, Height = 206.64 µm.
- Die Size: Width = 240.11 µm, Height = 218.79 µm.
- Aspect Ratio: 0.906 (near-square optimal layout).
- Core Margins: Symmetrical core-to-IO boundaries (~6.0 µm to 6.15 µm) ensuring adequate routing channels for power rings and signal breakouts.

8.2 Cell Placement and Routing Phase

Following floorplanning, standard cells were placed within the core rows, followed by clock tree synthesis and multi-layer interconnect routing.

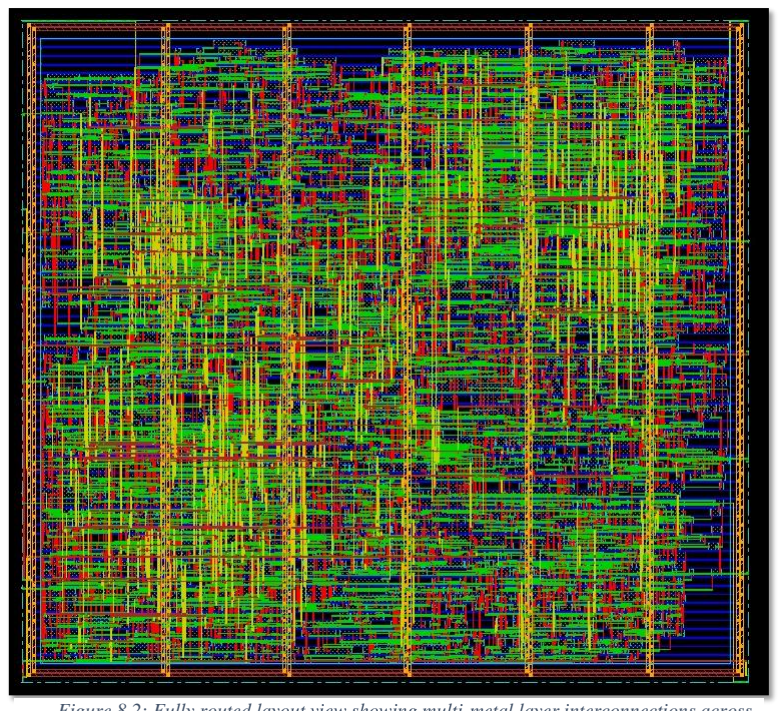
[picture p27: figure]

Figure 8.2: Fully routed layout view showing multi-metal layer interconnections across the chip.

### 9. Gate-Level Simulation (GLS) & Power Correlation

- Gate-Level Verification: GLS was performed on the final routed netlist using back-annotated SDF (Standard Delay Format) files to validate timing and functionality under realistic gate delays.
- Transcript Result: The simulation successfully passed all test vectors, confirming robust operation (All tests successful).
- Power Correlation: PrimeTime power analysis demonstrated tight correlation and optimal dynamic/leakage power trade-offs compared to pre-layout estimates.

### 10. Conclusion

This project successfully delivered a complete, industry-standard ASIC/SoC design flow—spanning from micro-architectural RTL specification to physical PNR sign-off and manufacture-ready layout.

- Summary of Key Milestones:
- Architecture & Integration: Successfully integrated a UART interface, asynchronous FIFOs, a Register File, and an ALU managed by a centralized control FSM.
- Synthesis & Timing Closure: Achieved robust timing closure with a positive setup slack of +4.10 ns using the TSMC 130nm library.
- Formal Verification: Rigorous LEC (Synopsys Formality) confirmed 100% logical equivalence across pre-DFT, post-DFT, and post-PNR stages, achieving up to 447 passing compare points with zero logic discrepancies.
- Physical Implementation & DFT: Completed scan-chain DFT insertion, core floorplanning (227.96 *2 06.64 µm), clock tree synthesis, and multi-layer routing yielding a DRC-clean layout.

In summary, the designed SoC meets stringent digital integrated circuit standards, establishing a robust, silicon-proven architecture ready for advanced hardware communication applications.
