Shnassar25/-Digital-IC-Design-SoC-RTL2GDS/spyglass/post_syn/spyglass-1/lint/lint_rtl/spyglass_reports/morelint/ReportPortInfo.csv

Module Name | Module Type | Port Name | Direction | Width | Index | Comment Source | Comment
SYS_TOP | Top_Level | REF_CLK | INPUT | 1 | - | module port | reference clock
SYS_TOP | Top_Level | UART_CLK | INPUT | 1 | - | module port | uart clock
SYS_TOP | Top_Level | RST | INPUT | 1 | - | module port | reset signal
SYS_TOP | Top_Level | RX_IN | INPUT | 1 | - | module port | uart receive data
SYS_TOP | Top_Level | TX_OUT | OUTPUT | 1 | - | module port | uart transmit data
SYS_TOP | Top_Level | PAR_ERR | OUTPUT | 1 | - | module port | parity error
SYS_TOP | Top_Level | STOP_ERR | OUTPUT | 1 | - | module port | stop error
