Shnassar25/-Digital-IC-Design-SoC-RTL2GDS/spyglass/post_syn/spyglass-1/Design_Read/spyglass_reports/sdc2sgdc/sdcMapping.csv

# Purpose:
# This file contains the information about the sdc2sgdc commands Mapping.n##Sheet_Prop: coltooltip: 1##SDC command defined in the sdc file 2##Line num and SDC file name 3##Translated SGDC command
SDC Command | SDC FileName:LineNumber | Mapped SGDC Command
create_clock | ../../syn/sdc/SYS_TOP.sdc:14 | clock
create_clock | ../../syn/sdc/SYS_TOP.sdc:22 | clock
create_clock | ../../syn/sdc/SYS_TOP.sdc:30 | clock
create_clock | ../../syn/sdc/SYS_TOP.sdc:33 | clock
create_clock | ../../syn/sdc/SYS_TOP.sdc:36 | clock
set_input_delay | ../../syn/sdc/SYS_TOP.sdc:39 | abstract_port
set_output_delay | ../../syn/sdc/SYS_TOP.sdc:40 | output
set_output_delay | ../../syn/sdc/SYS_TOP.sdc:41 | output
set_output_delay | ../../syn/sdc/SYS_TOP.sdc:42 | output
