Shnassar25/-Digital-IC-Design-SoC-RTL2GDS/Logs.png

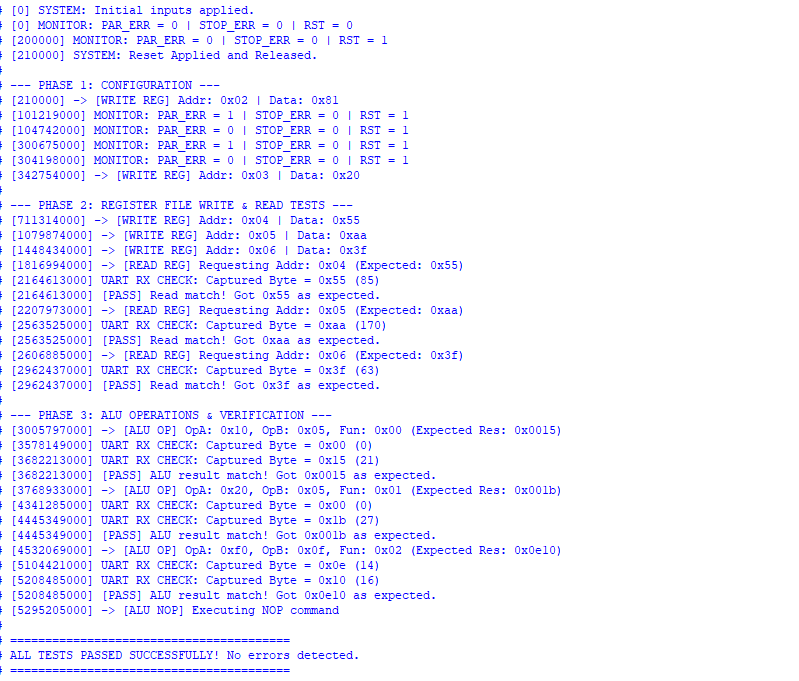
Logs.png
