Shnassar25/-Digital-IC-Design-SoC-RTL2GDS/(list of files, cad)

Other CAD files:
GLS/rtl/RTL/work/@f@i@f@o_@m@e@m_@c@n@t@r@l/verilog.psm
GLS/rtl/RTL/work/@f@i@f@o_@r@d/verilog.psm
GLS/rtl/RTL/work/@f@s@m/verilog.psm
GLS/rtl/RTL/work/@f@s@m_@r@x/verilog.psm
GLS/rtl/RTL/work/@p@u@l@s@e_@g@e@n/verilog.psm
GLS/rtl/RTL/work/@r@s@t_@s@y@n@c/verilog.psm
GLS/rtl/RTL/work/@serializer/verilog.psm
GLS/rtl/RTL/work/@u@a@r@t_@r@x/verilog.psm
GLS/rtl/RTL/work/@u@a@r@t_@t@o@p/verilog.psm
GLS/rtl/RTL/work/@u@a@r@t_@t@x/verilog.psm
GLS/rtl/RTL/work/edge_bit_cont/verilog.psm
rtl/RTL/work/@a@s@y@n@c_@f@i@f@o/verilog.psm
rtl/RTL/work/@b@i@t_@s@y@n@c/verilog.psm
rtl/RTL/work/@c@l@k_@d@i@v_@m@u@x/verilog.psm
rtl/RTL/work/@data_@s@y@n@c/verilog.psm
rtl/RTL/work/@r@e@g_file/verilog.psm
rtl/RTL/work/@s@y@s_@t@o@p/verilog.psm
rtl/RTL/work/@s@y@s_@t@o@p_@t@b/verilog.psm
rtl/RTL/work/@start_check/verilog.psm
rtl/RTL/work/parity_check/verilog.psm
work/@alu_16_bit/verilog.psm
work/@c@l@k_@g@a@t@i@n@g/verilog.psm
work/@data_@s@y@n@c/verilog.psm
work/@data_@sampling/verilog.psm
work/@deserializer/verilog.psm
work/@f@i@f@o_@w@r/verilog.psm
work/@mux/verilog.psm
work/@parity_@calc/verilog.psm
work/@s@y@s_@c@t@r@l/verilog.psm
work/@s@y@s_@t@o@p/verilog.psm
work/@s@y@s_@t@o@p_@t@b/verilog.psm
work/@stop_check/verilog.psm
