Shnassar25/-Digital-IC-Design-SoC-RTL2GDS/spyglass/post_rtl/spyglass-1/.SG_SaveRestoreDB/autogenerated__default_snapshot/analyzer/1789927923_macro_usage.txt

begin 0
end
begin 1
end
begin 2
end
begin 3
end
begin 4
end
begin 5
end
begin 6
end
begin 7
end
begin 8
end
begin 9
end
begin 10
end
begin 11
end
begin 12
end
begin 13
end
begin 14
end
begin 15
end
begin 16
end
begin 17
end
begin 18
end
begin 19
end
begin 20
end
begin 21
end
begin 22
end
begin 23
end
begin 24
end
begin 25
end
begin 26
end
begin 27
end
begin 28
end
begin 29
end
begin 30
end
begin 30
end
begin 31
end
