Shnassar25/-Digital-IC-Design-SoC-RTL2GDS/Back end/syn/netlists/SYS_TOP.v

/////////////////////////////////////////////////////////////
// Created by: Synopsys DC Expert(TM) in wire load mode
// Version   : O-2018.06-SP1
// Date      : Sun Sep 27 03:48:04 2026
/////////////////////////////////////////////////////////////


module RST_SYNC_NUM_STAGES2_0 ( CLK_Rsync, RST_Rsync, SYNC_RST );
  input CLK_Rsync, RST_Rsync;
  output SYNC_RST;
  wire   \sync_reg[0] ;

  DFFRQX2M \sync_reg_reg[1]  ( .D(\sync_reg[0] ), .CK(CLK_Rsync), .RN(
        RST_Rsync), .Q(SYNC_RST) );
  DFFRQX2M \sync_reg_reg[0]  ( .D(1'b1), .CK(CLK_Rsync), .RN(RST_Rsync), .Q(
        \sync_reg[0] ) );
endmodule


module RST_SYNC_NUM_STAGES2_1 ( CLK_Rsync, RST_Rsync, SYNC_RST );
  input CLK_Rsync, RST_Rsync;
  output SYNC_RST;
  wire   \sync_reg[0] ;

  DFFRQX2M \sync_reg_reg[1]  ( .D(\sync_reg[0] ), .CK(CLK_Rsync), .RN(
        RST_Rsync), .Q(SYNC_RST) );
  DFFRQX2M \sync_reg_reg[0]  ( .D(1'b1), .CK(CLK_Rsync), .RN(RST_Rsync), .Q(
        \sync_reg[0] ) );
endmodule


module Clk_div_50_Div_Ratio8_0_DW01_inc_0 ( A, SUM );
  input [7:0] A;
  output [7:0] SUM;

  wire   [7:2] carry;

  ADDHX1M U1_1_6 ( .A(A[6]), .B(carry[6]), .CO(carry[7]), .S(SUM[6]) );
  ADDHX1M U1_1_1 ( .A(A[1]), .B(A[0]), .CO(carry[2]), .S(SUM[1]) );
  ADDHX1M U1_1_4 ( .A(A[4]), .B(carry[4]), .CO(carry[5]), .S(SUM[4]) );
  ADDHX1M U1_1_3 ( .A(A[3]), .B(carry[3]), .CO(carry[4]), .S(SUM[3]) );
  ADDHX1M U1_1_2 ( .A(A[2]), .B(carry[2]), .CO(carry[3]), .S(SUM[2]) );
  ADDHX1M U1_1_5 ( .A(A[5]), .B(carry[5]), .CO(carry[6]), .S(SUM[5]) );
  CLKXOR2X2M U1 ( .A(carry[7]), .B(A[7]), .Y(SUM[7]) );
  CLKINVX1M U2 ( .A(A[0]), .Y(SUM[0]) );
endmodule


module Clk_div_50_Div_Ratio8_0 ( i_ref_clk, i_rst_n, i_clk_en, i_div_ratio, 
        o_div_clk );
  input [7:0] i_div_ratio;
  input i_ref_clk, i_rst_n, i_clk_en;
  output o_div_clk;
  wire   N8, N9, N10, N11, N12, N15, N18, N19, N20, N21, N22, N23, N24, N25,
         N34, N35, N36, N37, N38, N39, N40, N41, q1, q2, n16, n17, n1, n2, n3,
         n4, n5, n6, n7, n8, n9, n10, n11, n12, n13, n14, n18, n19, n20, n21,
         n22, n23, n24, n25, n26, n27, n28, n29, n30, n31, n32, n33, n34, n35,
         n36, n37, n38, n39, n40, n41, n42, n43, n44, n45, n46, n47, n48, n49,
         n50;
  wire   [7:0] counter;

  DFFNSRHX2M q2_reg ( .D(n16), .CKN(i_ref_clk), .SN(1'b1), .RN(i_rst_n), .Q(q2) );
  Clk_div_50_Div_Ratio8_0_DW01_inc_0 add_36 ( .A(counter), .SUM({N25, N24, N23, 
        N22, N21, N20, N19, N18}) );
  DFFRX1M q1_reg ( .D(n17), .CK(i_ref_clk), .RN(i_rst_n), .Q(q1), .QN(n11) );
  DFFRX1M \counter_reg[7]  ( .D(N41), .CK(i_ref_clk), .RN(i_rst_n), .Q(
        counter[7]), .QN(n18) );
  DFFRX1M \counter_reg[6]  ( .D(N40), .CK(i_ref_clk), .RN(i_rst_n), .Q(
        counter[6]) );
  DFFRX1M \counter_reg[5]  ( .D(N39), .CK(i_ref_clk), .RN(i_rst_n), .Q(
        counter[5]), .QN(n23) );
  DFFRX1M \counter_reg[4]  ( .D(N38), .CK(i_ref_clk), .RN(i_rst_n), .Q(
        counter[4]), .QN(n22) );
  DFFRX1M \counter_reg[3]  ( .D(N37), .CK(i_ref_clk), .RN(i_rst_n), .Q(
        counter[3]), .QN(n29) );
  DFFRX1M \counter_reg[2]  ( .D(N36), .CK(i_ref_clk), .RN(i_rst_n), .Q(
        counter[2]), .QN(n28) );
  DFFRX1M \counter_reg[1]  ( .D(N35), .CK(i_ref_clk), .RN(i_rst_n), .Q(
        counter[1]), .QN(n35) );
  DFFRX1M \counter_reg[0]  ( .D(N34), .CK(i_ref_clk), .RN(i_rst_n), .Q(
        counter[0]), .QN(n34) );
  OA21X2M U3 ( .A0(n6), .A1(n26), .B0(n7), .Y(n1) );
  CLKXOR2X2M U4 ( .A(i_div_ratio[6]), .B(n7), .Y(n2) );
  OR2X2M U5 ( .A(i_div_ratio[1]), .B(i_div_ratio[0]), .Y(n3) );
  CLKINVX1M U6 ( .A(i_div_ratio[0]), .Y(N8) );
  OAI2BB1X1M U7 ( .A0N(i_div_ratio[0]), .A1N(i_div_ratio[1]), .B0(n3), .Y(N9)
         );
  OR2X1M U8 ( .A(n3), .B(i_div_ratio[2]), .Y(n4) );
  OAI2BB1X1M U9 ( .A0N(n3), .A1N(i_div_ratio[2]), .B0(n4), .Y(N10) );
  OR2X1M U10 ( .A(n4), .B(i_div_ratio[3]), .Y(n5) );
  OAI2BB1X1M U11 ( .A0N(n4), .A1N(i_div_ratio[3]), .B0(n5), .Y(N11) );
  NOR2X1M U12 ( .A(n5), .B(i_div_ratio[4]), .Y(n6) );
  AO21XLM U13 ( .A0(n5), .A1(i_div_ratio[4]), .B0(n6), .Y(N12) );
  CLKNAND2X2M U14 ( .A(n6), .B(n26), .Y(n7) );
  NOR2X1M U15 ( .A(i_div_ratio[6]), .B(n7), .Y(n8) );
  CLKXOR2X2M U16 ( .A(i_div_ratio[7]), .B(n8), .Y(N15) );
  CLKMX2X2M U17 ( .A(i_ref_clk), .B(n9), .S0(n10), .Y(o_div_clk) );
  AO21XLM U18 ( .A0(q2), .A1(i_div_ratio[0]), .B0(q1), .Y(n9) );
  MXI2X1M U19 ( .A(n11), .B(n12), .S0(n10), .Y(n17) );
  OAI21X1M U20 ( .A0(n13), .A1(n14), .B0(n18), .Y(n12) );
  NOR2X1M U21 ( .A(counter[6]), .B(n19), .Y(n14) );
  AOI221XLM U22 ( .A0(counter[5]), .A1(n20), .B0(counter[6]), .B1(n19), .C0(
        n21), .Y(n13) );
  AOI221XLM U23 ( .A0(i_div_ratio[5]), .A1(n22), .B0(i_div_ratio[6]), .B1(n23), 
        .C0(n24), .Y(n21) );
  AOI221XLM U25 ( .A0(counter[3]), .A1(n25), .B0(counter[4]), .B1(n26), .C0(
        n27), .Y(n24) );
  AOI221XLM U26 ( .A0(i_div_ratio[3]), .A1(n28), .B0(i_div_ratio[4]), .B1(n29), 
        .C0(n30), .Y(n27) );
  AOI211X1M U27 ( .A0(counter[2]), .A1(n31), .B0(n32), .C0(n33), .Y(n30) );
  AOI31X1M U28 ( .A0(n34), .A1(n35), .A2(i_div_ratio[1]), .B0(i_div_ratio[2]), 
        .Y(n33) );
  AOI21X1M U29 ( .A0(i_div_ratio[1]), .A1(n34), .B0(n35), .Y(n32) );
  CLKINVX1M U30 ( .A(i_div_ratio[3]), .Y(n31) );
  CLKMX2X2M U31 ( .A(q2), .B(q1), .S0(n10), .Y(n16) );
  NOR2BX1M U32 ( .AN(N25), .B(n36), .Y(N41) );
  NOR2BX1M U33 ( .AN(N24), .B(n36), .Y(N40) );
  NOR2BX1M U34 ( .AN(N23), .B(n36), .Y(N39) );
  NOR2BX1M U35 ( .AN(N22), .B(n36), .Y(N38) );
  NOR2BX1M U36 ( .AN(N21), .B(n36), .Y(N37) );
  NOR2BX1M U37 ( .AN(N20), .B(n36), .Y(N36) );
  NOR2BX1M U38 ( .AN(N19), .B(n36), .Y(N35) );
  NOR2BX1M U39 ( .AN(N18), .B(n36), .Y(N34) );
  OAI211X1M U40 ( .A0(N15), .A1(n18), .B0(n37), .C0(n10), .Y(n36) );
  OA21X1M U41 ( .A0(n38), .A1(n39), .B0(i_clk_en), .Y(n10) );
  OR3X1M U42 ( .A(i_div_ratio[2]), .B(i_div_ratio[3]), .C(i_div_ratio[1]), .Y(
        n39) );
  NAND4X1M U43 ( .A(n25), .B(n26), .C(n20), .D(n19), .Y(n38) );
  CLKINVX1M U44 ( .A(i_div_ratio[7]), .Y(n19) );
  CLKINVX1M U45 ( .A(i_div_ratio[6]), .Y(n20) );
  CLKINVX1M U46 ( .A(i_div_ratio[5]), .Y(n26) );
  CLKINVX1M U47 ( .A(i_div_ratio[4]), .Y(n25) );
  OAI221X1M U48 ( .A0(counter[6]), .A1(n2), .B0(counter[7]), .B1(n40), .C0(n41), .Y(n37) );
  OAI2BB2X1M U49 ( .B0(n42), .B1(n43), .A0N(n2), .A1N(counter[6]), .Y(n41) );
  NOR2X1M U50 ( .A(counter[5]), .B(n1), .Y(n43) );
  AOI221XLM U51 ( .A0(counter[4]), .A1(n44), .B0(counter[5]), .B1(n1), .C0(n45), .Y(n42) );
  AOI221XLM U52 ( .A0(N11), .A1(n29), .B0(N12), .B1(n22), .C0(n46), .Y(n45) );
  AOI222X1M U53 ( .A0(counter[2]), .A1(n47), .B0(n48), .B1(n49), .C0(
        counter[3]), .C1(n50), .Y(n46) );
  CLKINVX1M U54 ( .A(N11), .Y(n50) );
  OAI211X1M U55 ( .A0(N9), .A1(n35), .B0(n34), .C0(N8), .Y(n49) );
  AOI22X1M U56 ( .A0(N10), .A1(n28), .B0(N9), .B1(n35), .Y(n48) );
  CLKINVX1M U57 ( .A(N10), .Y(n47) );
  CLKINVX1M U58 ( .A(N12), .Y(n44) );
  CLKINVX1M U59 ( .A(N15), .Y(n40) );
endmodule


module Clk_div_50_Div_Ratio8_1_DW01_inc_0 ( A, SUM );
  input [7:0] A;
  output [7:0] SUM;

  wire   [7:2] carry;

  ADDHX1M U1_1_6 ( .A(A[6]), .B(carry[6]), .CO(carry[7]), .S(SUM[6]) );
  ADDHX1M U1_1_1 ( .A(A[1]), .B(A[0]), .CO(carry[2]), .S(SUM[1]) );
  ADDHX1M U1_1_4 ( .A(A[4]), .B(carry[4]), .CO(carry[5]), .S(SUM[4]) );
  ADDHX1M U1_1_3 ( .A(A[3]), .B(carry[3]), .CO(carry[4]), .S(SUM[3]) );
  ADDHX1M U1_1_2 ( .A(A[2]), .B(carry[2]), .CO(carry[3]), .S(SUM[2]) );
  ADDHX1M U1_1_5 ( .A(A[5]), .B(carry[5]), .CO(carry[6]), .S(SUM[5]) );
  CLKXOR2X2M U1 ( .A(carry[7]), .B(A[7]), .Y(SUM[7]) );
  CLKINVX1M U2 ( .A(A[0]), .Y(SUM[0]) );
endmodule


module Clk_div_50_Div_Ratio8_1 ( i_ref_clk, i_rst_n, i_clk_en, i_div_ratio, 
        o_div_clk );
  input [7:0] i_div_ratio;
  input i_ref_clk, i_rst_n, i_clk_en;
  output o_div_clk;
  wire   N8, N9, N10, N11, N12, N15, N18, N19, N20, N21, N22, N23, N24, N25,
         N34, N35, N36, N37, N38, N39, N40, N41, q1, q2, n1, n2, n3, n4, n5,
         n6, n7, n8, n9, n10, n11, n12, n13, n14, n18, n19, n20, n21, n22, n23,
         n24, n25, n26, n27, n28, n29, n30, n31, n32, n33, n34, n35, n36, n37,
         n38, n39, n40, n41, n42, n43, n44, n45, n46, n47, n48, n49, n50, n51,
         n52;
  wire   [7:0] counter;

  DFFNSRHX2M q2_reg ( .D(n52), .CKN(i_ref_clk), .SN(1'b1), .RN(i_rst_n), .Q(q2) );
  Clk_div_50_Div_Ratio8_1_DW01_inc_0 add_36 ( .A(counter), .SUM({N25, N24, N23, 
        N22, N21, N20, N19, N18}) );
  DFFRQX2M \counter_reg[7]  ( .D(N41), .CK(i_ref_clk), .RN(i_rst_n), .Q(
        counter[7]) );
  DFFRQX2M \counter_reg[4]  ( .D(N38), .CK(i_ref_clk), .RN(i_rst_n), .Q(
        counter[4]) );
  DFFRQX2M \counter_reg[5]  ( .D(N39), .CK(i_ref_clk), .RN(i_rst_n), .Q(
        counter[5]) );
  DFFRQX2M \counter_reg[6]  ( .D(N40), .CK(i_ref_clk), .RN(i_rst_n), .Q(
        counter[6]) );
  DFFRQX2M \counter_reg[0]  ( .D(N34), .CK(i_ref_clk), .RN(i_rst_n), .Q(
        counter[0]) );
  DFFRQX2M \counter_reg[1]  ( .D(N35), .CK(i_ref_clk), .RN(i_rst_n), .Q(
        counter[1]) );
  DFFRQX2M \counter_reg[3]  ( .D(N37), .CK(i_ref_clk), .RN(i_rst_n), .Q(
        counter[3]) );
  DFFRQX2M \counter_reg[2]  ( .D(N36), .CK(i_ref_clk), .RN(i_rst_n), .Q(
        counter[2]) );
  DFFRQX2M q1_reg ( .D(n51), .CK(i_ref_clk), .RN(i_rst_n), .Q(q1) );
  CLKXOR2X2M U3 ( .A(i_div_ratio[6]), .B(n7), .Y(n1) );
  OA21X2M U4 ( .A0(n6), .A1(n9), .B0(n7), .Y(n2) );
  OR2X2M U5 ( .A(i_div_ratio[1]), .B(i_div_ratio[0]), .Y(n3) );
  INVX2M U6 ( .A(i_div_ratio[5]), .Y(n9) );
  CLKINVX1M U7 ( .A(i_div_ratio[0]), .Y(N8) );
  OAI2BB1X1M U8 ( .A0N(i_div_ratio[0]), .A1N(i_div_ratio[1]), .B0(n3), .Y(N9)
         );
  OR2X1M U9 ( .A(n3), .B(i_div_ratio[2]), .Y(n4) );
  OAI2BB1X1M U10 ( .A0N(n3), .A1N(i_div_ratio[2]), .B0(n4), .Y(N10) );
  OR2X1M U11 ( .A(n4), .B(i_div_ratio[3]), .Y(n5) );
  OAI2BB1X1M U12 ( .A0N(n4), .A1N(i_div_ratio[3]), .B0(n5), .Y(N11) );
  NOR2X1M U13 ( .A(n5), .B(i_div_ratio[4]), .Y(n6) );
  AO21XLM U14 ( .A0(n5), .A1(i_div_ratio[4]), .B0(n6), .Y(N12) );
  CLKNAND2X2M U15 ( .A(n6), .B(n9), .Y(n7) );
  NOR2X1M U16 ( .A(i_div_ratio[6]), .B(n7), .Y(n8) );
  CLKXOR2X2M U17 ( .A(i_div_ratio[7]), .B(n8), .Y(N15) );
  CLKMX2X2M U18 ( .A(i_ref_clk), .B(n10), .S0(n11), .Y(o_div_clk) );
  AO21XLM U19 ( .A0(q2), .A1(i_div_ratio[0]), .B0(q1), .Y(n10) );
  MXI2X1M U20 ( .A(n12), .B(n13), .S0(n11), .Y(n51) );
  OAI21X1M U21 ( .A0(n14), .A1(n18), .B0(n19), .Y(n13) );
  NOR2X1M U22 ( .A(counter[6]), .B(n20), .Y(n18) );
  AOI221XLM U23 ( .A0(counter[5]), .A1(n21), .B0(counter[6]), .B1(n20), .C0(
        n22), .Y(n14) );
  AOI221XLM U25 ( .A0(i_div_ratio[5]), .A1(n23), .B0(i_div_ratio[6]), .B1(n24), 
        .C0(n25), .Y(n22) );
  AOI221XLM U26 ( .A0(counter[3]), .A1(n26), .B0(counter[4]), .B1(n9), .C0(n27), .Y(n25) );
  AOI221XLM U27 ( .A0(i_div_ratio[3]), .A1(n28), .B0(i_div_ratio[4]), .B1(n29), 
        .C0(n30), .Y(n27) );
  AOI211X1M U28 ( .A0(counter[2]), .A1(n31), .B0(n32), .C0(n33), .Y(n30) );
  AOI31X1M U29 ( .A0(n34), .A1(n35), .A2(i_div_ratio[1]), .B0(i_div_ratio[2]), 
        .Y(n33) );
  AOI21X1M U30 ( .A0(i_div_ratio[1]), .A1(n34), .B0(n35), .Y(n32) );
  CLKINVX1M U31 ( .A(i_div_ratio[3]), .Y(n31) );
  CLKINVX1M U32 ( .A(counter[5]), .Y(n24) );
  CLKINVX1M U33 ( .A(q1), .Y(n12) );
  CLKMX2X2M U34 ( .A(q2), .B(q1), .S0(n11), .Y(n52) );
  NOR2BX1M U35 ( .AN(N25), .B(n36), .Y(N41) );
  NOR2BX1M U36 ( .AN(N24), .B(n36), .Y(N40) );
  NOR2BX1M U37 ( .AN(N23), .B(n36), .Y(N39) );
  NOR2BX1M U38 ( .AN(N22), .B(n36), .Y(N38) );
  NOR2BX1M U39 ( .AN(N21), .B(n36), .Y(N37) );
  NOR2BX1M U40 ( .AN(N20), .B(n36), .Y(N36) );
  NOR2BX1M U41 ( .AN(N19), .B(n36), .Y(N35) );
  NOR2BX1M U42 ( .AN(N18), .B(n36), .Y(N34) );
  OAI211X1M U43 ( .A0(N15), .A1(n19), .B0(n37), .C0(n11), .Y(n36) );
  OA21X1M U44 ( .A0(n38), .A1(n39), .B0(i_clk_en), .Y(n11) );
  OR3X1M U45 ( .A(i_div_ratio[2]), .B(i_div_ratio[3]), .C(i_div_ratio[1]), .Y(
        n39) );
  NAND4X1M U46 ( .A(n26), .B(n9), .C(n21), .D(n20), .Y(n38) );
  CLKINVX1M U47 ( .A(i_div_ratio[7]), .Y(n20) );
  CLKINVX1M U48 ( .A(i_div_ratio[6]), .Y(n21) );
  CLKINVX1M U49 ( .A(i_div_ratio[4]), .Y(n26) );
  OAI221X1M U50 ( .A0(counter[6]), .A1(n1), .B0(counter[7]), .B1(n40), .C0(n41), .Y(n37) );
  OAI2BB2X1M U51 ( .B0(n42), .B1(n43), .A0N(n1), .A1N(counter[6]), .Y(n41) );
  NOR2X1M U52 ( .A(counter[5]), .B(n2), .Y(n43) );
  AOI221XLM U53 ( .A0(counter[4]), .A1(n44), .B0(counter[5]), .B1(n2), .C0(n45), .Y(n42) );
  AOI221XLM U54 ( .A0(N11), .A1(n29), .B0(N12), .B1(n23), .C0(n46), .Y(n45) );
  AOI222X1M U55 ( .A0(counter[2]), .A1(n47), .B0(n48), .B1(n49), .C0(
        counter[3]), .C1(n50), .Y(n46) );
  CLKINVX1M U56 ( .A(N11), .Y(n50) );
  OAI211X1M U57 ( .A0(N9), .A1(n35), .B0(n34), .C0(N8), .Y(n49) );
  CLKINVX1M U58 ( .A(counter[0]), .Y(n34) );
  AOI22X1M U59 ( .A0(N10), .A1(n28), .B0(N9), .B1(n35), .Y(n48) );
  CLKINVX1M U60 ( .A(counter[1]), .Y(n35) );
  CLKINVX1M U61 ( .A(counter[2]), .Y(n28) );
  CLKINVX1M U62 ( .A(N10), .Y(n47) );
  CLKINVX1M U63 ( .A(counter[4]), .Y(n23) );
  CLKINVX1M U64 ( .A(counter[3]), .Y(n29) );
  CLKINVX1M U65 ( .A(N12), .Y(n44) );
  CLKINVX1M U66 ( .A(N15), .Y(n40) );
  CLKINVX1M U67 ( .A(counter[7]), .Y(n19) );
endmodule


module CLK_DIV_MUX_WIDTH8 ( IN, OUT );
  input [5:0] IN;
  output [7:0] OUT;
  wire   n5, n6, n7, n8, n9, n14, n15, n16, n17;

  INVX2M U3 ( .A(1'b1), .Y(OUT[7]) );
  INVX2M U5 ( .A(1'b1), .Y(OUT[6]) );
  INVX2M U7 ( .A(1'b1), .Y(OUT[5]) );
  INVX2M U9 ( .A(1'b1), .Y(OUT[4]) );
  NAND4BX1M U11 ( .AN(IN[4]), .B(IN[3]), .C(n15), .D(n14), .Y(n6) );
  NAND4BX1M U12 ( .AN(IN[3]), .B(IN[4]), .C(n15), .D(n14), .Y(n7) );
  OAI211X2M U13 ( .A0(n8), .A1(n9), .B0(n17), .C0(n16), .Y(OUT[0]) );
  NAND2X2M U14 ( .A(n7), .B(n6), .Y(n9) );
  NOR4X1M U15 ( .A(IN[5]), .B(IN[4]), .C(IN[3]), .D(n15), .Y(n8) );
  NOR3X2M U16 ( .A(n7), .B(IN[1]), .C(IN[0]), .Y(OUT[1]) );
  NOR4X1M U17 ( .A(n5), .B(IN[3]), .C(IN[5]), .D(IN[4]), .Y(OUT[3]) );
  NAND3X2M U18 ( .A(n17), .B(n16), .C(IN[2]), .Y(n5) );
  NOR3X2M U19 ( .A(n6), .B(IN[1]), .C(IN[0]), .Y(OUT[2]) );
  INVX2M U20 ( .A(IN[2]), .Y(n15) );
  INVX2M U21 ( .A(IN[0]), .Y(n17) );
  INVX2M U22 ( .A(IN[1]), .Y(n16) );
  INVX2M U23 ( .A(IN[5]), .Y(n14) );
endmodule


module PULSE_GEN ( clk, rst, lvl_sig, pulse_sig );
  input clk, rst, lvl_sig;
  output pulse_sig;
  wire   lvl_sig_ff, pulse_flop;

  DFFRQX2M lvl_sig_ff_reg ( .D(lvl_sig), .CK(clk), .RN(rst), .Q(lvl_sig_ff) );
  DFFRQX2M pulse_flop_reg ( .D(lvl_sig_ff), .CK(clk), .RN(rst), .Q(pulse_flop)
         );
  NOR2BX2M U3 ( .AN(lvl_sig_ff), .B(pulse_flop), .Y(pulse_sig) );
endmodule


module CLK_GATING ( CLK, EN_CLK, CLK_GATED );
  input CLK, EN_CLK;
  output CLK_GATED;


  TLATNCAX12M U0_TLATNCAX12M ( .E(EN_CLK), .CK(CLK), .ECK(CLK_GATED) );
endmodule


module Data_SYNC_NUM_STAGES2_BUS_WIDTH8 ( CLK, RST, ASYNC, BUS_EN, 
        ENABLE_PULSE, SYNC_BUS );
  input [7:0] ASYNC;
  output [7:0] SYNC_BUS;
  input CLK, RST, BUS_EN;
  output ENABLE_PULSE;
  wire   pulse_flop, n1, n2, n3, n4, n5, n6, n7, n8, n9, n10;
  wire   [1:0] sync_enable_reg;

  DFFRQX2M pulse_flop_reg ( .D(sync_enable_reg[1]), .CK(CLK), .RN(RST), .Q(
        pulse_flop) );
  DFFRQX2M \SYNC_BUS_reg[7]  ( .D(n9), .CK(CLK), .RN(RST), .Q(SYNC_BUS[7]) );
  DFFRQX2M \sync_enable_reg_reg[1]  ( .D(sync_enable_reg[0]), .CK(CLK), .RN(
        RST), .Q(sync_enable_reg[1]) );
  DFFRQX2M \SYNC_BUS_reg[5]  ( .D(n7), .CK(CLK), .RN(RST), .Q(SYNC_BUS[5]) );
  DFFRQX2M \SYNC_BUS_reg[6]  ( .D(n8), .CK(CLK), .RN(RST), .Q(SYNC_BUS[6]) );
  DFFRQX2M \SYNC_BUS_reg[4]  ( .D(n6), .CK(CLK), .RN(RST), .Q(SYNC_BUS[4]) );
  DFFRQX2M \SYNC_BUS_reg[3]  ( .D(n5), .CK(CLK), .RN(RST), .Q(SYNC_BUS[3]) );
  DFFRQX2M \SYNC_BUS_reg[2]  ( .D(n4), .CK(CLK), .RN(RST), .Q(SYNC_BUS[2]) );
  DFFRQX2M ENABLE_PULSE_reg ( .D(n10), .CK(CLK), .RN(RST), .Q(ENABLE_PULSE) );
  DFFRQX2M \SYNC_BUS_reg[1]  ( .D(n3), .CK(CLK), .RN(RST), .Q(SYNC_BUS[1]) );
  DFFRQX2M \SYNC_BUS_reg[0]  ( .D(n2), .CK(CLK), .RN(RST), .Q(SYNC_BUS[0]) );
  DFFRQX2M \sync_enable_reg_reg[0]  ( .D(BUS_EN), .CK(CLK), .RN(RST), .Q(
        sync_enable_reg[0]) );
  INVX2M U3 ( .A(n1), .Y(n10) );
  NAND2BX2M U4 ( .AN(pulse_flop), .B(sync_enable_reg[1]), .Y(n1) );
  AO22X1M U5 ( .A0(ASYNC[0]), .A1(n10), .B0(SYNC_BUS[0]), .B1(n1), .Y(n2) );
  AO22X1M U6 ( .A0(ASYNC[1]), .A1(n10), .B0(SYNC_BUS[1]), .B1(n1), .Y(n3) );
  AO22X1M U7 ( .A0(ASYNC[2]), .A1(n10), .B0(SYNC_BUS[2]), .B1(n1), .Y(n4) );
  AO22X1M U8 ( .A0(ASYNC[3]), .A1(n10), .B0(SYNC_BUS[3]), .B1(n1), .Y(n5) );
  AO22X1M U9 ( .A0(ASYNC[4]), .A1(n10), .B0(SYNC_BUS[4]), .B1(n1), .Y(n6) );
  AO22X1M U10 ( .A0(ASYNC[5]), .A1(n10), .B0(SYNC_BUS[5]), .B1(n1), .Y(n7) );
  AO22X1M U11 ( .A0(ASYNC[6]), .A1(n10), .B0(SYNC_BUS[6]), .B1(n1), .Y(n8) );
  AO22X1M U12 ( .A0(ASYNC[7]), .A1(n10), .B0(SYNC_BUS[7]), .B1(n1), .Y(n9) );
endmodule


module REG_file_WIDTH8_NO_OF_REG16_ADDR4 ( CLK_regfile, RST_regfile, WrData, 
        Address, WrEn, RdEn, RdData, RdData_Valid, REG0, REG1, REG2, REG3 );
  input [7:0] WrData;
  input [3:0] Address;
  output [7:0] RdData;
  output [7:0] REG0;
  output [7:0] REG1;
  output [7:0] REG2;
  output [7:0] REG3;
  input CLK_regfile, RST_regfile, WrEn, RdEn;
  output RdData_Valid;
  wire   N11, N12, N13, N14, \Reg_File[15][7] , \Reg_File[15][6] ,
         \Reg_File[15][5] , \Reg_File[15][4] , \Reg_File[15][3] ,
         \Reg_File[15][2] , \Reg_File[15][1] , \Reg_File[15][0] ,
         \Reg_File[14][7] , \Reg_File[14][6] , \Reg_File[14][5] ,
         \Reg_File[14][4] , \Reg_File[14][3] , \Reg_File[14][2] ,
         \Reg_File[14][1] , \Reg_File[14][0] , \Reg_File[13][7] ,
         \Reg_File[13][6] , \Reg_File[13][5] , \Reg_File[13][4] ,
         \Reg_File[13][3] , \Reg_File[13][2] , \Reg_File[13][1] ,
         \Reg_File[13][0] , \Reg_File[12][7] , \Reg_File[12][6] ,
         \Reg_File[12][5] , \Reg_File[12][4] , \Reg_File[12][3] ,
         \Reg_File[12][2] , \Reg_File[12][1] , \Reg_File[12][0] ,
         \Reg_File[11][7] , \Reg_File[11][6] , \Reg_File[11][5] ,
         \Reg_File[11][4] , \Reg_File[11][3] , \Reg_File[11][2] ,
         \Reg_File[11][1] , \Reg_File[11][0] , \Reg_File[10][7] ,
         \Reg_File[10][6] , \Reg_File[10][5] , \Reg_File[10][4] ,
         \Reg_File[10][3] , \Reg_File[10][2] , \Reg_File[10][1] ,
         \Reg_File[10][0] , \Reg_File[9][7] , \Reg_File[9][6] ,
         \Reg_File[9][5] , \Reg_File[9][4] , \Reg_File[9][3] ,
         \Reg_File[9][2] , \Reg_File[9][1] , \Reg_File[9][0] ,
         \Reg_File[8][7] , \Reg_File[8][6] , \Reg_File[8][5] ,
         \Reg_File[8][4] , \Reg_File[8][3] , \Reg_File[8][2] ,
         \Reg_File[8][1] , \Reg_File[8][0] , \Reg_File[7][7] ,
         \Reg_File[7][6] , \Reg_File[7][5] , \Reg_File[7][4] ,
         \Reg_File[7][3] , \Reg_File[7][2] , \Reg_File[7][1] ,
         \Reg_File[7][0] , \Reg_File[6][7] , \Reg_File[6][6] ,
         \Reg_File[6][5] , \Reg_File[6][4] , \Reg_File[6][3] ,
         \Reg_File[6][2] , \Reg_File[6][1] , \Reg_File[6][0] ,
         \Reg_File[5][7] , \Reg_File[5][6] , \Reg_File[5][5] ,
         \Reg_File[5][4] , \Reg_File[5][3] , \Reg_File[5][2] ,
         \Reg_File[5][1] , \Reg_File[5][0] , \Reg_File[4][7] ,
         \Reg_File[4][6] , \Reg_File[4][5] , \Reg_File[4][4] ,
         \Reg_File[4][3] , \Reg_File[4][2] , \Reg_File[4][1] ,
         \Reg_File[4][0] , N36, N37, N38, N39, N40, N41, N42, N43, n12, n13,
         n14, n15, n16, n17, n18, n19, n20, n21, n22, n23, n24, n25, n26, n27,
         n28, n29, n30, n31, n32, n33, n34, n35, n36, n37, n38, n39, n40, n41,
         n42, n43, n44, n45, n46, n47, n48, n49, n50, n51, n52, n53, n54, n55,
         n56, n57, n58, n59, n60, n61, n62, n63, n64, n65, n66, n67, n68, n69,
         n70, n71, n72, n73, n74, n75, n76, n77, n78, n79, n80, n81, n82, n83,
         n84, n85, n86, n87, n88, n89, n90, n91, n92, n93, n94, n95, n96, n97,
         n98, n99, n100, n101, n102, n103, n104, n105, n106, n107, n108, n109,
         n110, n111, n112, n113, n114, n115, n116, n117, n118, n119, n120,
         n121, n122, n123, n124, n125, n126, n127, n128, n129, n130, n131,
         n132, n133, n134, n135, n136, n137, n138, n139, n140, n141, n142,
         n143, n144, n145, n146, n147, n148, n149, n150, n151, n152, n153,
         n154, n155, n156, n157, n158, n159, n160, n161, n162, n163, n164,
         n165, n166, n167, n168, n169, n170, n171, n172, n173, n174, n175,
         n176, n1, n2, n3, n4, n5, n6, n7, n8, n9, n10, n11, n177, n178, n179,
         n180, n181, n182, n183, n184, n185, n186, n187, n188, n189, n190,
         n191, n192, n193, n194, n195, n196, n197, n198, n199, n200, n201,
         n202, n203, n204, n205, n206, n207, n208, n209, n210, n211, n212,
         n213, n214, n215, n216, n217, n218, n219, n220, n221, n222, n223,
         n224, n225, n226, n227, n228, n229, n230, n231, n232, n233, n234,
         n235, n236, n237, n238, n239, n240, n241, n242, n243, n244, n245,
         n246, n247, n248, n249, n250, n251, n252, n253, n254, n255, n256,
         n257, n258, n259, n260, n261, n262, n263, n264, n265, n266, n267,
         n268, n269, n270, n271, n272, n273, n274, n275, n276, n277, n278,
         n279, n280, n281, n282, n283, n284, n285, n286, n287, n288, n289,
         n290, n291, n292, n293, n294, n295, n296, n297, n298, n299, n300,
         n301, n302, n303;
  assign N11 = Address[0];
  assign N12 = Address[1];
  assign N13 = Address[2];
  assign N14 = Address[3];

  DFFRQX2M \Reg_File_reg[15][7]  ( .D(n175), .CK(CLK_regfile), .RN(n280), .Q(
        \Reg_File[15][7] ) );
  DFFRQX2M \Reg_File_reg[15][6]  ( .D(n174), .CK(CLK_regfile), .RN(n284), .Q(
        \Reg_File[15][6] ) );
  DFFRQX2M \Reg_File_reg[15][5]  ( .D(n173), .CK(CLK_regfile), .RN(n281), .Q(
        \Reg_File[15][5] ) );
  DFFRQX2M \Reg_File_reg[15][4]  ( .D(n172), .CK(CLK_regfile), .RN(n281), .Q(
        \Reg_File[15][4] ) );
  DFFRQX2M \Reg_File_reg[15][3]  ( .D(n171), .CK(CLK_regfile), .RN(n281), .Q(
        \Reg_File[15][3] ) );
  DFFRQX2M \Reg_File_reg[15][2]  ( .D(n170), .CK(CLK_regfile), .RN(n281), .Q(
        \Reg_File[15][2] ) );
  DFFRQX2M \Reg_File_reg[15][1]  ( .D(n169), .CK(CLK_regfile), .RN(n281), .Q(
        \Reg_File[15][1] ) );
  DFFRQX2M \Reg_File_reg[15][0]  ( .D(n168), .CK(CLK_regfile), .RN(n280), .Q(
        \Reg_File[15][0] ) );
  DFFRQX2M \Reg_File_reg[13][7]  ( .D(n159), .CK(CLK_regfile), .RN(n280), .Q(
        \Reg_File[13][7] ) );
  DFFRQX2M \Reg_File_reg[13][6]  ( .D(n158), .CK(CLK_regfile), .RN(n282), .Q(
        \Reg_File[13][6] ) );
  DFFRQX2M \Reg_File_reg[13][5]  ( .D(n157), .CK(CLK_regfile), .RN(n282), .Q(
        \Reg_File[13][5] ) );
  DFFRQX2M \Reg_File_reg[13][4]  ( .D(n156), .CK(CLK_regfile), .RN(n282), .Q(
        \Reg_File[13][4] ) );
  DFFRQX2M \Reg_File_reg[13][3]  ( .D(n155), .CK(CLK_regfile), .RN(n282), .Q(
        \Reg_File[13][3] ) );
  DFFRQX2M \Reg_File_reg[13][2]  ( .D(n154), .CK(CLK_regfile), .RN(n282), .Q(
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
         );
  AOI21X1M U309 ( .A0(n262), .A1(n261), .B0(n260), .Y(n267) );
  AOI22X1M U310 ( .A0(\Reg_File[6][7] ), .A1(n276), .B0(\Reg_File[7][7] ), 
        .B1(n275), .Y(n265) );
  AOI22X1M U311 ( .A0(\Reg_File[4][7] ), .A1(n279), .B0(\Reg_File[5][7] ), 
        .B1(n277), .Y(n264) );
  AOI21X1M U312 ( .A0(n265), .A1(n264), .B0(n263), .Y(n266) );
  OR4X1M U313 ( .A(n269), .B(n268), .C(n267), .D(n266), .Y(N36) );
endmodule


module Alu_16_bit_OPER_WIDTH8_OUT_WIDTH16_ALU_FUN_WIDTH4_DW_div_uns_0 ( a, b, 
        quotient, remainder, divide_by_0 );
  input [7:0] a;
  input [7:0] b;
  output [7:0] quotient;
  output [7:0] remainder;
  output divide_by_0;
  wire   \u_div/SumTmp[1][0] , \u_div/SumTmp[1][1] , \u_div/SumTmp[1][2] ,
         \u_div/SumTmp[1][3] , \u_div/SumTmp[1][4] , \u_div/SumTmp[1][5] ,
         \u_div/SumTmp[1][6] , \u_div/SumTmp[2][0] , \u_div/SumTmp[2][1] ,
         \u_div/SumTmp[2][2] , \u_div/SumTmp[2][3] , \u_div/SumTmp[2][4] ,
         \u_div/SumTmp[2][5] , \u_div/SumTmp[3][0] , \u_div/SumTmp[3][1] ,
         \u_div/SumTmp[3][2] , \u_div/SumTmp[3][3] , \u_div/SumTmp[3][4] ,
         \u_div/SumTmp[4][0] , \u_div/SumTmp[4][1] , \u_div/SumTmp[4][2] ,
         \u_div/SumTmp[4][3] , \u_div/SumTmp[5][0] , \u_div/SumTmp[5][1] ,
         \u_div/SumTmp[5][2] , \u_div/SumTmp[6][0] , \u_div/SumTmp[6][1] ,
         \u_div/SumTmp[7][0] , \u_div/CryTmp[0][1] , \u_div/CryTmp[0][2] ,
         \u_div/CryTmp[0][3] , \u_div/CryTmp[0][4] , \u_div/CryTmp[0][5] ,
         \u_div/CryTmp[0][6] , \u_div/CryTmp[0][7] , \u_div/CryTmp[1][1] ,
         \u_div/CryTmp[1][2] , \u_div/CryTmp[1][3] , \u_div/CryTmp[1][4] ,
         \u_div/CryTmp[1][5] , \u_div/CryTmp[1][6] , \u_div/CryTmp[1][7] ,
         \u_div/CryTmp[2][1] , \u_div/CryTmp[2][2] , \u_div/CryTmp[2][3] ,
         \u_div/CryTmp[2][4] , \u_div/CryTmp[2][5] , \u_div/CryTmp[2][6] ,
         \u_div/CryTmp[3][1] , \u_div/CryTmp[3][2] , \u_div/CryTmp[3][3] ,
         \u_div/CryTmp[3][4] , \u_div/CryTmp[3][5] , \u_div/CryTmp[4][1] ,
         \u_div/CryTmp[4][2] , \u_div/CryTmp[4][3] , \u_div/CryTmp[4][4] ,
         \u_div/CryTmp[5][1] , \u_div/CryTmp[5][2] , \u_div/CryTmp[5][3] ,
         \u_div/CryTmp[6][1] , \u_div/CryTmp[6][2] , \u_div/CryTmp[7][1] ,
         \u_div/PartRem[1][1] , \u_div/PartRem[1][2] , \u_div/PartRem[1][3] ,
         \u_div/PartRem[1][4] , \u_div/PartRem[1][5] , \u_div/PartRem[1][6] ,
         \u_div/PartRem[1][7] , \u_div/PartRem[2][1] , \u_div/PartRem[2][2] ,
         \u_div/PartRem[2][3] , \u_div/PartRem[2][4] , \u_div/PartRem[2][5] ,
         \u_div/PartRem[2][6] , \u_div/PartRem[3][1] , \u_div/PartRem[3][2] ,
         \u_div/PartRem[3][3] , \u_div/PartRem[3][4] , \u_div/PartRem[3][5] ,
         \u_div/PartRem[4][1] , \u_div/PartRem[4][2] , \u_div/PartRem[4][3] ,
         \u_div/PartRem[4][4] , \u_div/PartRem[5][1] , \u_div/PartRem[5][2] ,
         \u_div/PartRem[5][3] , \u_div/PartRem[6][1] , \u_div/PartRem[6][2] ,
         \u_div/PartRem[7][1] , n1, n2, n3, n4, n5, n6, n7, n8, n9, n10, n11,
         n12, n13, n14, n15, n16, n17, n18, n19, n20, n21;

  ADDFX2M \u_div/u_fa_PartRem_0_2_5  ( .A(\u_div/PartRem[3][5] ), .B(n13), 
        .CI(\u_div/CryTmp[2][5] ), .CO(\u_div/CryTmp[2][6] ), .S(
        \u_div/SumTmp[2][5] ) );
  ADDFX2M \u_div/u_fa_PartRem_0_4_3  ( .A(\u_div/PartRem[5][3] ), .B(n15), 
        .CI(\u_div/CryTmp[4][3] ), .CO(\u_div/CryTmp[4][4] ), .S(
        \u_div/SumTmp[4][3] ) );
  ADDFX2M \u_div/u_fa_PartRem_0_5_2  ( .A(\u_div/PartRem[6][2] ), .B(n16), 
        .CI(\u_div/CryTmp[5][2] ), .CO(\u_div/CryTmp[5][3] ), .S(
        \u_div/SumTmp[5][2] ) );
  ADDFX2M \u_div/u_fa_PartRem_0_6_1  ( .A(\u_div/PartRem[7][1] ), .B(n17), 
        .CI(\u_div/CryTmp[6][1] ), .CO(\u_div/CryTmp[6][2] ), .S(
        \u_div/SumTmp[6][1] ) );
  ADDFX2M \u_div/u_fa_PartRem_0_3_4  ( .A(\u_div/PartRem[4][4] ), .B(n14), 
        .CI(\u_div/CryTmp[3][4] ), .CO(\u_div/CryTmp[3][5] ), .S(
        \u_div/SumTmp[3][4] ) );
  ADDFX2M \u_div/u_fa_PartRem_0_0_7  ( .A(\u_div/PartRem[1][7] ), .B(n11), 
        .CI(\u_div/CryTmp[0][7] ), .CO(quotient[0]) );
  ADDFX2M \u_div/u_fa_PartRem_0_0_1  ( .A(\u_div/PartRem[1][1] ), .B(n17), 
        .CI(\u_div/CryTmp[0][1] ), .CO(\u_div/CryTmp[0][2] ) );
  ADDFX2M \u_div/u_fa_PartRem_0_0_2  ( .A(\u_div/PartRem[1][2] ), .B(n16), 
        .CI(\u_div/CryTmp[0][2] ), .CO(\u_div/CryTmp[0][3] ) );
  ADDFX2M \u_div/u_fa_PartRem_0_1_1  ( .A(\u_div/PartRem[2][1] ), .B(n17), 
        .CI(\u_div/CryTmp[1][1] ), .CO(\u_div/CryTmp[1][2] ), .S(
        \u_div/SumTmp[1][1] ) );
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
        quotient[2]), .Y(\u_div/PartRem[2][3] ) );
  CLKMX2X2M U54 ( .A(\u_div/PartRem[4][1] ), .B(\u_div/SumTmp[3][1] ), .S0(
        quotient[3]), .Y(\u_div/PartRem[3][2] ) );
  CLKMX2X2M U55 ( .A(a[4]), .B(\u_div/SumTmp[4][0] ), .S0(quotient[4]), .Y(
        \u_div/PartRem[4][1] ) );
  CLKMX2X2M U56 ( .A(\u_div/PartRem[2][2] ), .B(\u_div/SumTmp[1][2] ), .S0(
        quotient[1]), .Y(\u_div/PartRem[1][3] ) );
  CLKMX2X2M U57 ( .A(\u_div/PartRem[3][1] ), .B(\u_div/SumTmp[2][1] ), .S0(
        quotient[2]), .Y(\u_div/PartRem[2][2] ) );
  CLKMX2X2M U58 ( .A(a[3]), .B(\u_div/SumTmp[3][0] ), .S0(quotient[3]), .Y(
        \u_div/PartRem[3][1] ) );
  CLKMX2X2M U59 ( .A(\u_div/PartRem[2][1] ), .B(\u_div/SumTmp[1][1] ), .S0(
        quotient[1]), .Y(\u_div/PartRem[1][2] ) );
  CLKMX2X2M U60 ( .A(a[2]), .B(\u_div/SumTmp[2][0] ), .S0(quotient[2]), .Y(
        \u_div/PartRem[2][1] ) );
  CLKMX2X2M U61 ( .A(a[1]), .B(\u_div/SumTmp[1][0] ), .S0(quotient[1]), .Y(
        \u_div/PartRem[1][1] ) );
  AND4X1M U62 ( .A(\u_div/CryTmp[7][1] ), .B(n19), .C(n17), .D(n16), .Y(
        quotient[7]) );
  AND3X1M U63 ( .A(n19), .B(n16), .C(\u_div/CryTmp[6][2] ), .Y(quotient[6]) );
  AND2X1M U64 ( .A(\u_div/CryTmp[5][3] ), .B(n19), .Y(quotient[5]) );
  AND2X1M U65 ( .A(n20), .B(n15), .Y(n19) );
  AND2X1M U66 ( .A(\u_div/CryTmp[4][4] ), .B(n20), .Y(quotient[4]) );
  AND3X1M U67 ( .A(n21), .B(n14), .C(n13), .Y(n20) );
  AND3X1M U68 ( .A(n21), .B(n13), .C(\u_div/CryTmp[3][5] ), .Y(quotient[3]) );
  AND2X1M U69 ( .A(\u_div/CryTmp[2][6] ), .B(n21), .Y(quotient[2]) );
  NOR2X1M U70 ( .A(b[6]), .B(b[7]), .Y(n21) );
  AND2X1M U71 ( .A(\u_div/CryTmp[1][7] ), .B(n11), .Y(quotient[1]) );
endmodule


module Alu_16_bit_OPER_WIDTH8_OUT_WIDTH16_ALU_FUN_WIDTH4_DW01_sub_0 ( A, B, CI, 
        DIFF, CO );
  input [8:0] A;
  input [8:0] B;
  output [8:0] DIFF;
  input CI;
  output CO;
  wire   n1, n2, n3, n4, n5, n6, n7, n8, n9;
  wire   [9:0] carry;

  ADDFX2M U2_5 ( .A(A[5]), .B(n4), .CI(carry[5]), .CO(carry[6]), .S(DIFF[5])
         );
  ADDFX2M U2_4 ( .A(A[4]), .B(n5), .CI(carry[4]), .CO(carry[5]), .S(DIFF[4])
         );
  ADDFX2M U2_3 ( .A(A[3]), .B(n6), .CI(carry[3]), .CO(carry[4]), .S(DIFF[3])
         );
  ADDFX2M U2_2 ( .A(A[2]), .B(n7), .CI(carry[2]), .CO(carry[3]), .S(DIFF[2])
         );
  ADDFX2M U2_7 ( .A(A[7]), .B(n2), .CI(carry[7]), .CO(carry[8]), .S(DIFF[7])
         );
  ADDFX2M U2_1 ( .A(A[1]), .B(n8), .CI(carry[1]), .CO(carry[2]), .S(DIFF[1])
         );
  ADDFX2M U2_6 ( .A(A[6]), .B(n3), .CI(carry[6]), .CO(carry[7]), .S(DIFF[6])
         );
  INVX2M U1 ( .A(B[6]), .Y(n3) );
  INVX2M U2 ( .A(B[1]), .Y(n8) );
  NAND2X2M U3 ( .A(B[0]), .B(n1), .Y(carry[1]) );
  INVX2M U4 ( .A(A[0]), .Y(n1) );
  INVX2M U5 ( .A(B[7]), .Y(n2) );
  XNOR2X2M U6 ( .A(n9), .B(A[0]), .Y(DIFF[0]) );
  INVX2M U7 ( .A(B[0]), .Y(n9) );
  INVX2M U8 ( .A(B[2]), .Y(n7) );
  INVX2M U9 ( .A(B[3]), .Y(n6) );
  INVX2M U10 ( .A(B[4]), .Y(n5) );
  INVX2M U11 ( .A(B[5]), .Y(n4) );
  CLKINVX1M U12 ( .A(carry[8]), .Y(DIFF[8]) );
endmodule


module Alu_16_bit_OPER_WIDTH8_OUT_WIDTH16_ALU_FUN_WIDTH4_DW01_add_0 ( A, B, CI, 
        SUM, CO );
  input [8:0] A;
  input [8:0] B;
  output [8:0] SUM;
  input CI;
  output CO;
  wire   n1;
  wire   [8:1] carry;

  ADDFX2M U1_1 ( .A(A[1]), .B(B[1]), .CI(n1), .CO(carry[2]), .S(SUM[1]) );
  ADDFX2M U1_5 ( .A(A[5]), .B(B[5]), .CI(carry[5]), .CO(carry[6]), .S(SUM[5])
         );
  ADDFX2M U1_4 ( .A(A[4]), .B(B[4]), .CI(carry[4]), .CO(carry[5]), .S(SUM[4])
         );
  ADDFX2M U1_3 ( .A(A[3]), .B(B[3]), .CI(carry[3]), .CO(carry[4]), .S(SUM[3])
         );
  ADDFX2M U1_2 ( .A(A[2]), .B(B[2]), .CI(carry[2]), .CO(carry[3]), .S(SUM[2])
         );
  ADDFX2M U1_7 ( .A(A[7]), .B(B[7]), .CI(carry[7]), .CO(SUM[8]), .S(SUM[7]) );
  ADDFX2M U1_6 ( .A(A[6]), .B(B[6]), .CI(carry[6]), .CO(carry[7]), .S(SUM[6])
         );
  AND2X2M U1 ( .A(B[0]), .B(A[0]), .Y(n1) );
  CLKXOR2X2M U2 ( .A(B[0]), .B(A[0]), .Y(SUM[0]) );
endmodule


module Alu_16_bit_OPER_WIDTH8_OUT_WIDTH16_ALU_FUN_WIDTH4_DW01_add_1 ( A, B, CI, 
        SUM, CO );
  input [13:0] A;
  input [13:0] B;
  output [13:0] SUM;
  input CI;
  output CO;
  wire   n1, n8, n9, n10, n11, n12, n13, n14, n15, n16, n17, n18, n19, n20,
         n21, n22, n23, n24, n25, n26, n27;

  AOI21BX2M U2 ( .A0(n18), .A1(A[12]), .B0N(n19), .Y(n1) );
  NAND2X2M U3 ( .A(A[7]), .B(B[7]), .Y(n15) );
  XNOR2X2M U4 ( .A(B[13]), .B(n1), .Y(SUM[13]) );
  XNOR2X2M U5 ( .A(A[7]), .B(n8), .Y(SUM[7]) );
  INVX2M U6 ( .A(B[7]), .Y(n8) );
  INVX2M U7 ( .A(A[6]), .Y(n9) );
  INVX2M U8 ( .A(n9), .Y(SUM[6]) );
  BUFX2M U9 ( .A(A[0]), .Y(SUM[0]) );
  BUFX2M U10 ( .A(A[1]), .Y(SUM[1]) );
  BUFX2M U11 ( .A(A[2]), .Y(SUM[2]) );
  BUFX2M U12 ( .A(A[3]), .Y(SUM[3]) );
  BUFX2M U13 ( .A(A[4]), .Y(SUM[4]) );
  BUFX2M U14 ( .A(A[5]), .Y(SUM[5]) );
  XNOR2X1M U15 ( .A(n10), .B(n11), .Y(SUM[9]) );
  NOR2X1M U16 ( .A(n12), .B(n13), .Y(n11) );
  CLKXOR2X2M U17 ( .A(n14), .B(n15), .Y(SUM[8]) );
  NAND2BX1M U18 ( .AN(n16), .B(n17), .Y(n14) );
  OAI21X1M U19 ( .A0(A[12]), .A1(n18), .B0(B[12]), .Y(n19) );
  XOR3XLM U20 ( .A(B[12]), .B(A[12]), .C(n18), .Y(SUM[12]) );
  OAI21BX1M U21 ( .A0(n20), .A1(n21), .B0N(n22), .Y(n18) );
  XNOR2X1M U22 ( .A(n21), .B(n23), .Y(SUM[11]) );
  NOR2X1M U23 ( .A(n22), .B(n20), .Y(n23) );
  NOR2X1M U24 ( .A(B[11]), .B(A[11]), .Y(n20) );
  AND2X1M U25 ( .A(B[11]), .B(A[11]), .Y(n22) );
  OA21X1M U26 ( .A0(n24), .A1(n25), .B0(n26), .Y(n21) );
  CLKXOR2X2M U27 ( .A(n27), .B(n25), .Y(SUM[10]) );
  AOI2BB1X1M U28 ( .A0N(n10), .A1N(n13), .B0(n12), .Y(n25) );
  AND2X1M U29 ( .A(B[9]), .B(A[9]), .Y(n12) );
  NOR2X1M U30 ( .A(B[9]), .B(A[9]), .Y(n13) );
  OA21X1M U31 ( .A0(n15), .A1(n16), .B0(n17), .Y(n10) );
  CLKNAND2X2M U32 ( .A(B[8]), .B(A[8]), .Y(n17) );
  NOR2X1M U33 ( .A(B[8]), .B(A[8]), .Y(n16) );
  NAND2BX1M U34 ( .AN(n24), .B(n26), .Y(n27) );
  CLKNAND2X2M U35 ( .A(B[10]), .B(A[10]), .Y(n26) );
  NOR2X1M U36 ( .A(B[10]), .B(A[10]), .Y(n24) );
endmodule


module Alu_16_bit_OPER_WIDTH8_OUT_WIDTH16_ALU_FUN_WIDTH4_DW02_mult_0 ( A, B, 
        TC, PRODUCT );
  input [7:0] A;
  input [7:0] B;
  output [15:0] PRODUCT;
  input TC;
  wire   \ab[7][7] , \ab[7][6] , \ab[7][5] , \ab[7][4] , \ab[7][3] ,
         \ab[7][2] , \ab[7][1] , \ab[7][0] , \ab[6][7] , \ab[6][6] ,
         \ab[6][5] , \ab[6][4] , \ab[6][3] , \ab[6][2] , \ab[6][1] ,
         \ab[6][0] , \ab[5][7] , \ab[5][6] , \ab[5][5] , \ab[5][4] ,
         \ab[5][3] , \ab[5][2] , \ab[5][1] , \ab[5][0] , \ab[4][7] ,
         \ab[4][6] , \ab[4][5] , \ab[4][4] , \ab[4][3] , \ab[4][2] ,
         \ab[4][1] , \ab[4][0] , \ab[3][7] , \ab[3][6] , \ab[3][5] ,
         \ab[3][4] , \ab[3][3] , \ab[3][2] , \ab[3][1] , \ab[3][0] ,
         \ab[2][7] , \ab[2][6] , \ab[2][5] , \ab[2][4] , \ab[2][3] ,
         \ab[2][2] , \ab[2][1] , \ab[2][0] , \ab[1][7] , \ab[1][6] ,
         \ab[1][5] , \ab[1][4] , \ab[1][3] , \ab[1][2] , \ab[1][1] ,
         \ab[1][0] , \ab[0][7] , \ab[0][6] , \ab[0][5] , \ab[0][4] ,
         \ab[0][3] , \ab[0][2] , \ab[0][1] , \CARRYB[7][6] , \CARRYB[7][5] ,
         \CARRYB[7][4] , \CARRYB[7][3] , \CARRYB[7][2] , \CARRYB[7][1] ,
         \CARRYB[7][0] , \CARRYB[6][6] , \CARRYB[6][5] , \CARRYB[6][4] ,
         \CARRYB[6][3] , \CARRYB[6][2] , \CARRYB[6][1] , \CARRYB[6][0] ,
         \CARRYB[5][6] , \CARRYB[5][5] , \CARRYB[5][4] , \CARRYB[5][3] ,
         \CARRYB[5][2] , \CARRYB[5][1] , \CARRYB[5][0] , \CARRYB[4][6] ,
         \CARRYB[4][5] , \CARRYB[4][4] , \CARRYB[4][3] , \CARRYB[4][2] ,
         \CARRYB[4][1] , \CARRYB[4][0] , \CARRYB[3][6] , \CARRYB[3][5] ,
         \CARRYB[3][4] , \CARRYB[3][3] , \CARRYB[3][2] , \CARRYB[3][1] ,
         \CARRYB[3][0] , \CARRYB[2][6] , \CARRYB[2][5] , \CARRYB[2][4] ,
         \CARRYB[2][3] , \CARRYB[2][2] , \CARRYB[2][1] , \CARRYB[2][0] ,
         \SUMB[7][6] , \SUMB[7][5] , \SUMB[7][4] , \SUMB[7][3] , \SUMB[7][2] ,
         \SUMB[7][1] , \SUMB[7][0] , \SUMB[6][6] , \SUMB[6][5] , \SUMB[6][4] ,
         \SUMB[6][3] , \SUMB[6][2] , \SUMB[6][1] , \SUMB[5][6] , \SUMB[5][5] ,
         \SUMB[5][4] , \SUMB[5][3] , \SUMB[5][2] , \SUMB[5][1] , \SUMB[4][6] ,
         \SUMB[4][5] , \SUMB[4][4] , \SUMB[4][3] , \SUMB[4][2] , \SUMB[4][1] ,
         \SUMB[3][6] , \SUMB[3][5] , \SUMB[3][4] , \SUMB[3][3] , \SUMB[3][2] ,
         \SUMB[3][1] , \SUMB[2][6] , \SUMB[2][5] , \SUMB[2][4] , \SUMB[2][3] ,
         \SUMB[2][2] , \SUMB[2][1] , \SUMB[1][6] , \SUMB[1][5] , \SUMB[1][4] ,
         \SUMB[1][3] , \SUMB[1][2] , \SUMB[1][1] , \A1[12] , \A1[11] ,
         \A1[10] , \A1[9] , \A1[8] , \A1[7] , \A1[6] , \A1[4] , \A1[3] ,
         \A1[2] , \A1[1] , \A1[0] , n3, n4, n5, n6, n7, n8, n9, n10, n11, n12,
         n13, n14, n15, n16, n17, n18, n19, n20, n21, n22, n23, n24, n25, n26,
         n27, n28, n29, n30, n31, n32, n33, n34, n35, n36, n37, n38, n39;

  Alu_16_bit_OPER_WIDTH8_OUT_WIDTH16_ALU_FUN_WIDTH4_DW01_add_1 FS_1 ( .A({1'b0, 
        \A1[12] , \A1[11] , \A1[10] , \A1[9] , \A1[8] , \A1[7] , \A1[6] , 
        \SUMB[7][0] , \A1[4] , \A1[3] , \A1[2] , \A1[1] , \A1[0] }), .B({n10, 
        n16, n15, n14, n13, n11, n12, 1'b0, 1'b0, 1'b0, 1'b0, 1'b0, 1'b0, 1'b0}), .CI(1'b0), .SUM(PRODUCT[15:2]) );
  ADDFX2M S1_6_0 ( .A(\ab[6][0] ), .B(\CARRYB[5][0] ), .CI(\SUMB[5][1] ), .CO(
        \CARRYB[6][0] ), .S(\A1[4] ) );
  ADDFX2M S1_5_0 ( .A(\ab[5][0] ), .B(\CARRYB[4][0] ), .CI(\SUMB[4][1] ), .CO(
        \CARRYB[5][0] ), .S(\A1[3] ) );
  ADDFX2M S1_4_0 ( .A(\ab[4][0] ), .B(\CARRYB[3][0] ), .CI(\SUMB[3][1] ), .CO(
        \CARRYB[4][0] ), .S(\A1[2] ) );
  ADDFX2M S1_3_0 ( .A(\ab[3][0] ), .B(\CARRYB[2][0] ), .CI(\SUMB[2][1] ), .CO(
        \CARRYB[3][0] ), .S(\A1[1] ) );
  ADDFX2M S1_2_0 ( .A(\ab[2][0] ), .B(n6), .CI(\SUMB[1][1] ), .CO(
        \CARRYB[2][0] ), .S(\A1[0] ) );
  ADDFX2M S2_6_5 ( .A(\ab[6][5] ), .B(\CARRYB[5][5] ), .CI(\SUMB[5][6] ), .CO(
        \CARRYB[6][5] ), .S(\SUMB[6][5] ) );
  ADDFX2M S4_5 ( .A(\ab[7][5] ), .B(\CARRYB[6][5] ), .CI(\SUMB[6][6] ), .CO(
        \CARRYB[7][5] ), .S(\SUMB[7][5] ) );
  ADDFX2M S4_4 ( .A(\ab[7][4] ), .B(\CARRYB[6][4] ), .CI(\SUMB[6][5] ), .CO(
        \CARRYB[7][4] ), .S(\SUMB[7][4] ) );
  ADDFX2M S2_6_2 ( .A(\ab[6][2] ), .B(\CARRYB[5][2] ), .CI(\SUMB[5][3] ), .CO(
        \CARRYB[6][2] ), .S(\SUMB[6][2] ) );
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
  NOR2X1M U66 ( .A(n28), .B(n33), .Y(\ab[6][3] ) );
  NOR2X1M U67 ( .A(n29), .B(n33), .Y(\ab[6][2] ) );
  NOR2X1M U68 ( .A(n30), .B(n33), .Y(\ab[6][1] ) );
  NOR2X1M U69 ( .A(n31), .B(n33), .Y(\ab[6][0] ) );
  NOR2X1M U70 ( .A(n24), .B(n34), .Y(\ab[5][7] ) );
  NOR2X1M U71 ( .A(n25), .B(n34), .Y(\ab[5][6] ) );
  NOR2X1M U72 ( .A(n26), .B(n34), .Y(\ab[5][5] ) );
  NOR2X1M U73 ( .A(n27), .B(n34), .Y(\ab[5][4] ) );
  NOR2X1M U74 ( .A(n28), .B(n34), .Y(\ab[5][3] ) );
  NOR2X1M U75 ( .A(n29), .B(n34), .Y(\ab[5][2] ) );
  NOR2X1M U76 ( .A(n30), .B(n34), .Y(\ab[5][1] ) );
  NOR2X1M U77 ( .A(n31), .B(n34), .Y(\ab[5][0] ) );
  NOR2X1M U78 ( .A(n24), .B(n35), .Y(\ab[4][7] ) );
  NOR2X1M U79 ( .A(n25), .B(n35), .Y(\ab[4][6] ) );
  NOR2X1M U80 ( .A(n26), .B(n35), .Y(\ab[4][5] ) );
  NOR2X1M U81 ( .A(n27), .B(n35), .Y(\ab[4][4] ) );
  NOR2X1M U82 ( .A(n28), .B(n35), .Y(\ab[4][3] ) );
  NOR2X1M U83 ( .A(n29), .B(n35), .Y(\ab[4][2] ) );
  NOR2X1M U84 ( .A(n30), .B(n35), .Y(\ab[4][1] ) );
  NOR2X1M U85 ( .A(n31), .B(n35), .Y(\ab[4][0] ) );
  NOR2X1M U86 ( .A(n24), .B(n36), .Y(\ab[3][7] ) );
  NOR2X1M U87 ( .A(n25), .B(n36), .Y(\ab[3][6] ) );
  NOR2X1M U88 ( .A(n26), .B(n36), .Y(\ab[3][5] ) );
  NOR2X1M U89 ( .A(n27), .B(n36), .Y(\ab[3][4] ) );
  NOR2X1M U90 ( .A(n28), .B(n36), .Y(\ab[3][3] ) );
  NOR2X1M U91 ( .A(n29), .B(n36), .Y(\ab[3][2] ) );
  NOR2X1M U92 ( .A(n30), .B(n36), .Y(\ab[3][1] ) );
  NOR2X1M U93 ( .A(n31), .B(n36), .Y(\ab[3][0] ) );
  NOR2X1M U94 ( .A(n24), .B(n37), .Y(\ab[2][7] ) );
  NOR2X1M U95 ( .A(n25), .B(n37), .Y(\ab[2][6] ) );
  NOR2X1M U96 ( .A(n26), .B(n37), .Y(\ab[2][5] ) );
  NOR2X1M U97 ( .A(n27), .B(n37), .Y(\ab[2][4] ) );
  NOR2X1M U98 ( .A(n28), .B(n37), .Y(\ab[2][3] ) );
  NOR2X1M U99 ( .A(n29), .B(n37), .Y(\ab[2][2] ) );
  NOR2X1M U100 ( .A(n30), .B(n37), .Y(\ab[2][1] ) );
  NOR2X1M U101 ( .A(n31), .B(n37), .Y(\ab[2][0] ) );
  NOR2X1M U102 ( .A(n24), .B(n38), .Y(\ab[1][7] ) );
  NOR2X1M U103 ( .A(n25), .B(n38), .Y(\ab[1][6] ) );
  NOR2X1M U104 ( .A(n26), .B(n38), .Y(\ab[1][5] ) );
  NOR2X1M U105 ( .A(n27), .B(n38), .Y(\ab[1][4] ) );
  NOR2X1M U106 ( .A(n28), .B(n38), .Y(\ab[1][3] ) );
  NOR2X1M U107 ( .A(n29), .B(n38), .Y(\ab[1][2] ) );
  NOR2X1M U108 ( .A(n30), .B(n38), .Y(\ab[1][1] ) );
  NOR2X1M U109 ( .A(n31), .B(n38), .Y(\ab[1][0] ) );
  NOR2X1M U110 ( .A(n24), .B(n39), .Y(\ab[0][7] ) );
  NOR2X1M U111 ( .A(n25), .B(n39), .Y(\ab[0][6] ) );
  NOR2X1M U112 ( .A(n26), .B(n39), .Y(\ab[0][5] ) );
  NOR2X1M U113 ( .A(n27), .B(n39), .Y(\ab[0][4] ) );
  NOR2X1M U114 ( .A(n28), .B(n39), .Y(\ab[0][3] ) );
  NOR2X1M U115 ( .A(n29), .B(n39), .Y(\ab[0][2] ) );
  NOR2X1M U116 ( .A(n30), .B(n39), .Y(\ab[0][1] ) );
  NOR2X1M U117 ( .A(n31), .B(n39), .Y(PRODUCT[0]) );
endmodule


module Alu_16_bit_OPER_WIDTH8_OUT_WIDTH16_ALU_FUN_WIDTH4 ( CLK_alu, RST_alu, 
        EN_alu, A, B, ALU_FUN, ALU_OUT, OUT_VALID );
  input [7:0] A;
  input [7:0] B;
  input [3:0] ALU_FUN;
  output [15:0] ALU_OUT;
  input CLK_alu, RST_alu, EN_alu;
  output OUT_VALID;
  wire   N91, N92, N93, N94, N95, N96, N97, N98, N99, N100, N101, N102, N103,
         N104, N105, N106, N107, N108, N109, N110, N111, N112, N113, N114,
         N115, N116, N117, N118, N119, N120, N121, N122, N123, N124, N127,
         N128, N129, N130, N131, N132, N133, N134, N167, N168, N169, n35, n36,
         n37, n38, n39, n40, n41, n42, n43, n44, n45, n46, n47, n48, n49, n50,
         n51, n52, n53, n54, n55, n56, n57, n58, n59, n60, n61, n62, n63, n64,
         n65, n66, n67, n68, n69, n70, n71, n72, n73, n74, n75, n76, n77, n78,
         n79, n80, n81, n82, n83, n84, n85, n86, n87, n88, n89, n90, n91, n92,
         n93, n94, n95, n96, n97, n98, n99, n100, n101, n102, n103, n104, n105,
         n106, n107, n108, n109, n110, n111, n112, n113, n114, n115, n116,
         n117, n118, n3, n4, n5, n6, n7, n8, n9, n10, n11, n12, n13, n14, n15,
         n16, n17, n18, n19, n20, n21, n22, n23, n24, n25, n26, n27, n28, n29,
         n30, n31, n32, n33, n34, n119, n120, n121, n122, n123, n124, n125,
         n126, n127, n128, n129, n130, n131, n132, n133, n134, n135, n136,
         n137, n138, n139, n140, n141, n142, n143, n144, n145, n146, n147,
         n148, n149, n150, n151, n152;
  wire   [15:0] reg_OUT;

  Alu_16_bit_OPER_WIDTH8_OUT_WIDTH16_ALU_FUN_WIDTH4_DW_div_uns_0 div_45 ( .a({
        n15, n14, n13, n12, n11, n10, n9, n8}), .b({n7, n6, B[5:2], n5, B[0]}), 
        .quotient({N134, N133, N132, N131, N130, N129, N128, N127}) );
  Alu_16_bit_OPER_WIDTH8_OUT_WIDTH16_ALU_FUN_WIDTH4_DW01_sub_0 sub_38 ( .A({
        1'b0, n15, n14, n13, n12, n11, n10, n9, n8}), .B({1'b0, n7, n6, B[5:2], 
        n5, B[0]}), .CI(1'b0), .DIFF({N108, N107, N106, N105, N104, N103, N102, 
        N101, N100}) );
  Alu_16_bit_OPER_WIDTH8_OUT_WIDTH16_ALU_FUN_WIDTH4_DW01_add_0 add_35 ( .A({
        1'b0, n15, n14, n13, n12, n11, n10, n9, n8}), .B({1'b0, n7, n6, B[5:2], 
        n5, B[0]}), .CI(1'b0), .SUM({N99, N98, N97, N96, N95, N94, N93, N92, 
        N91}) );
  Alu_16_bit_OPER_WIDTH8_OUT_WIDTH16_ALU_FUN_WIDTH4_DW02_mult_0 mult_41 ( .A({
        n15, n14, n13, n12, n11, n10, n9, n8}), .B({n7, n6, B[5:2], n5, B[0]}), 
        .TC(1'b0), .PRODUCT({N124, N123, N122, N121, N120, N119, N118, N117, 
        N116, N115, N114, N113, N112, N111, N110, N109}) );
  DFFRQX2M \ALU_OUT_reg[15]  ( .D(reg_OUT[15]), .CK(CLK_alu), .RN(RST_alu), 
        .Q(ALU_OUT[15]) );
  DFFRQX2M \ALU_OUT_reg[14]  ( .D(reg_OUT[14]), .CK(CLK_alu), .RN(RST_alu), 
        .Q(ALU_OUT[14]) );
  DFFRQX2M \ALU_OUT_reg[13]  ( .D(reg_OUT[13]), .CK(CLK_alu), .RN(RST_alu), 
        .Q(ALU_OUT[13]) );
  DFFRQX2M \ALU_OUT_reg[12]  ( .D(reg_OUT[12]), .CK(CLK_alu), .RN(RST_alu), 
        .Q(ALU_OUT[12]) );
  DFFRQX2M \ALU_OUT_reg[11]  ( .D(reg_OUT[11]), .CK(CLK_alu), .RN(RST_alu), 
        .Q(ALU_OUT[11]) );
  DFFRQX2M \ALU_OUT_reg[10]  ( .D(reg_OUT[10]), .CK(CLK_alu), .RN(RST_alu), 
        .Q(ALU_OUT[10]) );
  DFFRQX2M \ALU_OUT_reg[9]  ( .D(reg_OUT[9]), .CK(CLK_alu), .RN(RST_alu), .Q(
        ALU_OUT[9]) );
  DFFRQX2M \ALU_OUT_reg[8]  ( .D(reg_OUT[8]), .CK(CLK_alu), .RN(RST_alu), .Q(
        ALU_OUT[8]) );
  DFFRQX2M \ALU_OUT_reg[7]  ( .D(reg_OUT[7]), .CK(CLK_alu), .RN(RST_alu), .Q(
        ALU_OUT[7]) );
  DFFRQX2M \ALU_OUT_reg[6]  ( .D(reg_OUT[6]), .CK(CLK_alu), .RN(RST_alu), .Q(
        ALU_OUT[6]) );
  DFFRQX2M \ALU_OUT_reg[5]  ( .D(reg_OUT[5]), .CK(CLK_alu), .RN(RST_alu), .Q(
        ALU_OUT[5]) );
  DFFRQX2M \ALU_OUT_reg[4]  ( .D(reg_OUT[4]), .CK(CLK_alu), .RN(RST_alu), .Q(
        ALU_OUT[4]) );
  DFFRQX2M \ALU_OUT_reg[3]  ( .D(reg_OUT[3]), .CK(CLK_alu), .RN(RST_alu), .Q(
        ALU_OUT[3]) );
  DFFRQX2M \ALU_OUT_reg[2]  ( .D(reg_OUT[2]), .CK(CLK_alu), .RN(RST_alu), .Q(
        ALU_OUT[2]) );
  DFFRQX2M \ALU_OUT_reg[1]  ( .D(reg_OUT[1]), .CK(CLK_alu), .RN(RST_alu), .Q(
        ALU_OUT[1]) );
  DFFRQX2M \ALU_OUT_reg[0]  ( .D(reg_OUT[0]), .CK(CLK_alu), .RN(RST_alu), .Q(
        ALU_OUT[0]) );
  DFFRQX2M OUT_VALID_reg ( .D(EN_alu), .CK(CLK_alu), .RN(RST_alu), .Q(
        OUT_VALID) );
  BUFX2M U3 ( .A(A[7]), .Y(n15) );
  BUFX2M U4 ( .A(A[6]), .Y(n14) );
  BUFX2M U5 ( .A(A[1]), .Y(n9) );
  INVX2M U8 ( .A(n97), .Y(n138) );
  INVX2M U9 ( .A(n47), .Y(n137) );
  INVX2M U10 ( .A(n53), .Y(n140) );
  INVX2M U11 ( .A(n102), .Y(n136) );
  OAI2BB1X2M U12 ( .A0N(N123), .A1N(n35), .B0(n36), .Y(reg_OUT[14]) );
  OAI2BB1X2M U13 ( .A0N(N124), .A1N(n35), .B0(n36), .Y(reg_OUT[15]) );
  OAI2BB1X2M U14 ( .A0N(N120), .A1N(n35), .B0(n36), .Y(reg_OUT[11]) );
  OAI2BB1X2M U15 ( .A0N(N121), .A1N(n35), .B0(n36), .Y(reg_OUT[12]) );
  OAI2BB1X2M U16 ( .A0N(N122), .A1N(n35), .B0(n36), .Y(reg_OUT[13]) );
  OAI2BB1X2M U17 ( .A0N(N118), .A1N(n35), .B0(n36), .Y(reg_OUT[9]) );
  OAI2BB1X2M U18 ( .A0N(N119), .A1N(n35), .B0(n36), .Y(reg_OUT[10]) );
  OAI21X2M U19 ( .A0(n3), .A1(n112), .B0(n111), .Y(n52) );
  OAI2B1X2M U20 ( .A1N(n110), .A0(n101), .B0(n111), .Y(n97) );
  NAND2X2M U21 ( .A(n141), .B(n110), .Y(n47) );
  INVX2M U22 ( .A(n50), .Y(n135) );
  INVX2M U23 ( .A(n112), .Y(n141) );
  NOR2X2M U24 ( .A(n101), .B(n3), .Y(n53) );
  NOR2BX2M U25 ( .AN(n113), .B(n3), .Y(n41) );
  NOR2BX2M U26 ( .AN(n40), .B(n133), .Y(n35) );
  NAND2X2M U27 ( .A(n113), .B(n110), .Y(n102) );
  OAI2BB2X1M U28 ( .B0(n146), .B1(n47), .A0N(N116), .A1N(n40), .Y(n46) );
  NOR2X2M U29 ( .A(ALU_FUN[2]), .B(ALU_FUN[1]), .Y(n113) );
  NOR2X2M U30 ( .A(n139), .B(n4), .Y(n110) );
  NAND3X2M U31 ( .A(n113), .B(n139), .C(n4), .Y(n50) );
  NAND2X2M U32 ( .A(ALU_FUN[2]), .B(ALU_FUN[1]), .Y(n101) );
  NAND2X2M U33 ( .A(ALU_FUN[2]), .B(n142), .Y(n112) );
  NAND2X2M U34 ( .A(EN_alu), .B(n42), .Y(n36) );
  INVX2M U35 ( .A(ALU_FUN[0]), .Y(n139) );
  INVX2M U36 ( .A(ALU_FUN[1]), .Y(n142) );
  NAND3X2M U37 ( .A(n113), .B(ALU_FUN[0]), .C(n4), .Y(n111) );
  AND4X2M U38 ( .A(N169), .B(n141), .C(n4), .D(n139), .Y(n100) );
  OAI2B11X2M U39 ( .A1N(N108), .A0(n102), .B0(n140), .C0(n138), .Y(n42) );
  NOR3BX2M U40 ( .AN(n4), .B(n101), .C(ALU_FUN[0]), .Y(n39) );
  NOR3BX2M U41 ( .AN(n4), .B(n139), .C(n112), .Y(n57) );
  NOR3X2M U42 ( .A(n3), .B(ALU_FUN[2]), .C(n142), .Y(n40) );
  OR2X2M U43 ( .A(n4), .B(ALU_FUN[0]), .Y(n3) );
  INVX2M U44 ( .A(EN_alu), .Y(n133) );
  AOI31X2M U45 ( .A0(n103), .A1(n104), .A2(n105), .B0(n133), .Y(reg_OUT[0]) );
  AOI22X1M U46 ( .A0(N100), .A1(n136), .B0(N91), .B1(n41), .Y(n103) );
  AOI222X1M U47 ( .A0(N109), .A1(n40), .B0(n53), .B1(n152), .C0(n8), .C1(n137), 
        .Y(n104) );
  AOI211X2M U48 ( .A0(n9), .A1(n57), .B0(n106), .C0(n107), .Y(n105) );
  OAI2BB1X2M U49 ( .A0N(N127), .A1N(n48), .B0(n114), .Y(n106) );
  AOI31X2M U50 ( .A0(N167), .A1(n4), .A2(n115), .B0(n100), .Y(n114) );
  NOR3X2M U51 ( .A(n142), .B(ALU_FUN[2]), .C(ALU_FUN[0]), .Y(n115) );
  AOI31X2M U52 ( .A0(n90), .A1(n91), .A2(n92), .B0(n133), .Y(reg_OUT[1]) );
  AOI222X1M U53 ( .A0(N92), .A1(n41), .B0(N110), .B1(n40), .C0(N101), .C1(n136), .Y(n90) );
  AOI222X1M U54 ( .A0(n9), .A1(n137), .B0(n10), .B1(n57), .C0(n53), .C1(n126), 
        .Y(n91) );
  AOI211X2M U55 ( .A0(n8), .A1(n39), .B0(n93), .C0(n94), .Y(n92) );
  OAI2BB1X2M U56 ( .A0N(N128), .A1N(n48), .B0(n98), .Y(n93) );
  AOI31X2M U57 ( .A0(N168), .A1(n4), .A2(n99), .B0(n100), .Y(n98) );
  NOR3X2M U58 ( .A(n139), .B(ALU_FUN[2]), .C(n142), .Y(n99) );
  AOI31X2M U59 ( .A0(n83), .A1(n84), .A2(n85), .B0(n133), .Y(reg_OUT[2]) );
  AOI22X1M U60 ( .A0(N102), .A1(n136), .B0(N93), .B1(n41), .Y(n83) );
  AOI222X1M U61 ( .A0(N111), .A1(n40), .B0(n53), .B1(n151), .C0(n10), .C1(n137), .Y(n84) );
  AOI221XLM U62 ( .A0(n9), .A1(n39), .B0(n11), .B1(n57), .C0(n86), .Y(n85) );
  AOI31X2M U63 ( .A0(n76), .A1(n77), .A2(n78), .B0(n133), .Y(reg_OUT[3]) );
  AOI22X1M U64 ( .A0(N103), .A1(n136), .B0(N94), .B1(n41), .Y(n76) );
  AOI222X1M U65 ( .A0(N112), .A1(n40), .B0(n53), .B1(n150), .C0(n11), .C1(n137), .Y(n77) );
  AOI221XLM U66 ( .A0(n10), .A1(n39), .B0(n12), .B1(n57), .C0(n79), .Y(n78) );
  AOI31X2M U67 ( .A0(n69), .A1(n70), .A2(n71), .B0(n133), .Y(reg_OUT[4]) );
  AOI22X1M U68 ( .A0(N104), .A1(n136), .B0(N95), .B1(n41), .Y(n69) );
  AOI222X1M U69 ( .A0(N113), .A1(n40), .B0(n53), .B1(n149), .C0(n12), .C1(n137), .Y(n70) );
  AOI221XLM U70 ( .A0(n11), .A1(n39), .B0(n57), .B1(n13), .C0(n72), .Y(n71) );
  AOI31X2M U71 ( .A0(n62), .A1(n63), .A2(n64), .B0(n133), .Y(reg_OUT[5]) );
  AOI22X1M U72 ( .A0(N105), .A1(n136), .B0(N96), .B1(n41), .Y(n62) );
  AOI222X1M U73 ( .A0(N114), .A1(n40), .B0(n53), .B1(n148), .C0(n13), .C1(n137), .Y(n63) );
  AOI221XLM U74 ( .A0(n12), .A1(n39), .B0(n57), .B1(n14), .C0(n65), .Y(n64) );
  AOI21X2M U75 ( .A0(n37), .A1(n38), .B0(n133), .Y(reg_OUT[8]) );
  AOI21X2M U76 ( .A0(N99), .A1(n41), .B0(n42), .Y(n37) );
  AOI22X1M U77 ( .A0(n15), .A1(n39), .B0(N117), .B1(n40), .Y(n38) );
  AOI31X2M U78 ( .A0(n54), .A1(n55), .A2(n56), .B0(n133), .Y(reg_OUT[6]) );
  AOI22X1M U79 ( .A0(N106), .A1(n136), .B0(N97), .B1(n41), .Y(n54) );
  AOI221XLM U80 ( .A0(n13), .A1(n39), .B0(n57), .B1(n15), .C0(n58), .Y(n56) );
  AOI222X1M U81 ( .A0(N115), .A1(n40), .B0(n53), .B1(n147), .C0(n137), .C1(n14), .Y(n55) );
  AOI31X2M U82 ( .A0(n43), .A1(n44), .A2(n45), .B0(n133), .Y(reg_OUT[7]) );
  AOI22X1M U83 ( .A0(n14), .A1(n39), .B0(n53), .B1(n146), .Y(n43) );
  AOI222X1M U84 ( .A0(n7), .A1(n134), .B0(N134), .B1(n48), .C0(n49), .C1(n143), 
        .Y(n44) );
  AOI221XLM U85 ( .A0(N107), .A1(n136), .B0(N98), .B1(n41), .C0(n46), .Y(n45)
         );
  INVX2M U86 ( .A(n6), .Y(n132) );
  OAI2B2X1M U87 ( .A1N(n5), .A0(n95), .B0(n5), .B1(n96), .Y(n94) );
  AOI221XLM U88 ( .A0(n135), .A1(n126), .B0(n9), .B1(n52), .C0(n137), .Y(n95)
         );
  AOI221XLM U89 ( .A0(n9), .A1(n135), .B0(n97), .B1(n126), .C0(n53), .Y(n96)
         );
  OAI221X1M U90 ( .A0(n10), .A1(n138), .B0(n50), .B1(n151), .C0(n140), .Y(n89)
         );
  OAI221X1M U91 ( .A0(n11), .A1(n138), .B0(n50), .B1(n150), .C0(n140), .Y(n82)
         );
  OAI221X1M U92 ( .A0(n12), .A1(n138), .B0(n50), .B1(n149), .C0(n140), .Y(n75)
         );
  OAI221X1M U93 ( .A0(n13), .A1(n138), .B0(n50), .B1(n148), .C0(n140), .Y(n68)
         );
  OAI221X1M U94 ( .A0(n14), .A1(n138), .B0(n50), .B1(n147), .C0(n140), .Y(n61)
         );
  OAI221X1M U95 ( .A0(n15), .A1(n138), .B0(n146), .B1(n50), .C0(n140), .Y(n49)
         );
  INVX2M U96 ( .A(n16), .Y(n128) );
  INVX2M U97 ( .A(n27), .Y(n130) );
  OAI21X2M U98 ( .A0(n59), .A1(n132), .B0(n60), .Y(n58) );
  AOI221XLM U99 ( .A0(n135), .A1(n147), .B0(n14), .B1(n52), .C0(n137), .Y(n59)
         );
  AOI22X1M U100 ( .A0(N133), .A1(n48), .B0(n61), .B1(n132), .Y(n60) );
  INVX2M U101 ( .A(n51), .Y(n134) );
  AOI221XLM U102 ( .A0(n52), .A1(n15), .B0(n146), .B1(n135), .C0(n137), .Y(n51) );
  INVX2M U103 ( .A(n9), .Y(n126) );
  BUFX2M U104 ( .A(ALU_FUN[3]), .Y(n4) );
  INVX2M U105 ( .A(n15), .Y(n146) );
  INVX2M U106 ( .A(n14), .Y(n147) );
  INVX2M U107 ( .A(n8), .Y(n152) );
  INVX2M U108 ( .A(n10), .Y(n151) );
  INVX2M U109 ( .A(n11), .Y(n150) );
  INVX2M U110 ( .A(n13), .Y(n148) );
  INVX2M U111 ( .A(n12), .Y(n149) );
  INVX2M U112 ( .A(n7), .Y(n143) );
  BUFX2M U113 ( .A(B[6]), .Y(n6) );
  BUFX2M U114 ( .A(B[7]), .Y(n7) );
  BUFX2M U115 ( .A(B[1]), .Y(n5) );
  BUFX2M U116 ( .A(A[5]), .Y(n13) );
  OAI21X2M U117 ( .A0(n87), .A1(n129), .B0(n88), .Y(n86) );
  AOI221XLM U118 ( .A0(n135), .A1(n151), .B0(n10), .B1(n52), .C0(n137), .Y(n87) );
  AOI22X1M U119 ( .A0(N129), .A1(n48), .B0(n89), .B1(n129), .Y(n88) );
  BUFX2M U120 ( .A(A[4]), .Y(n12) );
  BUFX2M U121 ( .A(A[3]), .Y(n11) );
  OAI21X2M U122 ( .A0(n80), .A1(n131), .B0(n81), .Y(n79) );
  AOI221XLM U123 ( .A0(n135), .A1(n150), .B0(n11), .B1(n52), .C0(n137), .Y(n80) );
  AOI22X1M U124 ( .A0(N130), .A1(n48), .B0(n82), .B1(n131), .Y(n81) );
  BUFX2M U125 ( .A(A[2]), .Y(n10) );
  OAI21X2M U126 ( .A0(n73), .A1(n145), .B0(n74), .Y(n72) );
  AOI221XLM U127 ( .A0(n135), .A1(n149), .B0(n12), .B1(n52), .C0(n137), .Y(n73) );
  AOI22X1M U128 ( .A0(N131), .A1(n48), .B0(n75), .B1(n145), .Y(n74) );
  INVX2M U129 ( .A(B[4]), .Y(n145) );
  BUFX2M U130 ( .A(A[0]), .Y(n8) );
  OAI21X2M U131 ( .A0(n66), .A1(n144), .B0(n67), .Y(n65) );
  AOI221XLM U132 ( .A0(n135), .A1(n148), .B0(n13), .B1(n52), .C0(n137), .Y(n66) );
  AOI22X1M U133 ( .A0(N132), .A1(n48), .B0(n68), .B1(n144), .Y(n67) );
  INVX2M U134 ( .A(B[5]), .Y(n144) );
  OAI2B2X1M U135 ( .A1N(B[0]), .A0(n108), .B0(B[0]), .B1(n109), .Y(n107) );
  AOI221XLM U136 ( .A0(n135), .A1(n152), .B0(n8), .B1(n52), .C0(n137), .Y(n108) );
  AOI221XLM U137 ( .A0(n8), .A1(n135), .B0(n97), .B1(n152), .C0(n53), .Y(n109)
         );
  INVX2M U138 ( .A(B[0]), .Y(n127) );
  INVX2M U139 ( .A(B[2]), .Y(n129) );
  AND3X2M U140 ( .A(n110), .B(ALU_FUN[1]), .C(n116), .Y(n48) );
  AOI21X2M U141 ( .A0(n117), .A1(n118), .B0(ALU_FUN[2]), .Y(n116) );
  NOR4X1M U142 ( .A(n7), .B(n6), .C(B[5]), .D(B[4]), .Y(n118) );
  NOR4X1M U143 ( .A(B[3]), .B(B[2]), .C(n5), .D(B[0]), .Y(n117) );
  INVX2M U144 ( .A(B[3]), .Y(n131) );
  NOR2X1M U145 ( .A(n146), .B(n7), .Y(n122) );
  NAND2BX1M U146 ( .AN(B[4]), .B(n12), .Y(n31) );
  NAND2BX1M U147 ( .AN(n12), .B(B[4]), .Y(n20) );
  CLKNAND2X2M U148 ( .A(n31), .B(n20), .Y(n33) );
  NOR2X1M U149 ( .A(n131), .B(n11), .Y(n28) );
  NOR2X1M U150 ( .A(n129), .B(n10), .Y(n19) );
  NOR2X1M U151 ( .A(n127), .B(n8), .Y(n16) );
  CLKNAND2X2M U152 ( .A(n10), .B(n129), .Y(n30) );
  NAND2BX1M U153 ( .AN(n19), .B(n30), .Y(n25) );
  AOI21X1M U154 ( .A0(n16), .A1(n126), .B0(n5), .Y(n17) );
  AOI211X1M U155 ( .A0(n9), .A1(n128), .B0(n25), .C0(n17), .Y(n18) );
  CLKNAND2X2M U156 ( .A(n11), .B(n131), .Y(n29) );
  OAI31X1M U157 ( .A0(n28), .A1(n19), .A2(n18), .B0(n29), .Y(n21) );
  NAND2BX1M U158 ( .AN(n13), .B(B[5]), .Y(n120) );
  OAI211X1M U159 ( .A0(n33), .A1(n21), .B0(n20), .C0(n120), .Y(n22) );
  NAND2BX1M U160 ( .AN(B[5]), .B(n13), .Y(n32) );
  XNOR2X1M U161 ( .A(n14), .B(n6), .Y(n119) );
  AOI32X1M U162 ( .A0(n22), .A1(n32), .A2(n119), .B0(n6), .B1(n147), .Y(n23)
         );
  CLKNAND2X2M U163 ( .A(n7), .B(n146), .Y(n123) );
  OAI21X1M U164 ( .A0(n122), .A1(n23), .B0(n123), .Y(N169) );
  CLKNAND2X2M U165 ( .A(n8), .B(n127), .Y(n26) );
  OA21X1M U166 ( .A0(n26), .A1(n126), .B0(n5), .Y(n24) );
  AOI211X1M U167 ( .A0(n26), .A1(n126), .B0(n25), .C0(n24), .Y(n27) );
  AOI31X1M U168 ( .A0(n130), .A1(n30), .A2(n29), .B0(n28), .Y(n34) );
  OAI2B11X1M U169 ( .A1N(n34), .A0(n33), .B0(n32), .C0(n31), .Y(n121) );
  AOI32X1M U170 ( .A0(n121), .A1(n120), .A2(n119), .B0(n14), .B1(n132), .Y(
        n124) );
  AOI2B1X1M U171 ( .A1N(n124), .A0(n123), .B0(n122), .Y(n125) );
  CLKINVX1M U172 ( .A(n125), .Y(N168) );
  NOR2X1M U173 ( .A(N169), .B(N168), .Y(N167) );
endmodule


module FIFO_WR_ADDR4 ( W_clk, W_rst_n, W_inc, Wq2_ptr, W_ptr, W_addr, W_full
 );
  input [4:0] Wq2_ptr;
  output [4:0] W_ptr;
  output [3:0] W_addr;
  input W_clk, W_rst_n, W_inc;
  output W_full;
  wire   \reg_W_bin[4] , N0, wire_W_full, n1, n2, n3, n4, n5, n6,
         \add_28/carry[4] , \add_28/carry[3] , \add_28/carry[2] ,
         \add_28/carry[1] ;
  wire   [4:0] wire_W_bin_next;
  wire   [3:0] wire_W_gray;

  DFFRQX2M \reg_W_bin_reg[4]  ( .D(wire_W_bin_next[4]), .CK(W_clk), .RN(
        W_rst_n), .Q(\reg_W_bin[4] ) );
  DFFRQX2M \reg_W_bin_reg[3]  ( .D(wire_W_bin_next[3]), .CK(W_clk), .RN(
        W_rst_n), .Q(W_addr[3]) );
  DFFRQX2M \reg_W_bin_reg[0]  ( .D(wire_W_bin_next[0]), .CK(W_clk), .RN(
        W_rst_n), .Q(W_addr[0]) );
  DFFRQX2M \reg_W_bin_reg[2]  ( .D(wire_W_bin_next[2]), .CK(W_clk), .RN(
        W_rst_n), .Q(W_addr[2]) );
  DFFRQX2M \reg_W_bin_reg[1]  ( .D(wire_W_bin_next[1]), .CK(W_clk), .RN(
        W_rst_n), .Q(W_addr[1]) );
  DFFRQX2M W_full_reg ( .D(wire_W_full), .CK(W_clk), .RN(W_rst_n), .Q(W_full)
         );
  DFFRQX2M \W_ptr_reg[4]  ( .D(wire_W_bin_next[4]), .CK(W_clk), .RN(W_rst_n), 
        .Q(W_ptr[4]) );
  DFFRQX2M \W_ptr_reg[0]  ( .D(wire_W_gray[0]), .CK(W_clk), .RN(W_rst_n), .Q(
        W_ptr[0]) );
  DFFRQX2M \W_ptr_reg[1]  ( .D(wire_W_gray[1]), .CK(W_clk), .RN(W_rst_n), .Q(
        W_ptr[1]) );
  DFFRQX2M \W_ptr_reg[2]  ( .D(wire_W_gray[2]), .CK(W_clk), .RN(W_rst_n), .Q(
        W_ptr[2]) );
  DFFRQX2M \W_ptr_reg[3]  ( .D(wire_W_gray[3]), .CK(W_clk), .RN(W_rst_n), .Q(
        W_ptr[3]) );
  CLKXOR2X2M U3 ( .A(wire_W_bin_next[2]), .B(wire_W_bin_next[3]), .Y(
        wire_W_gray[2]) );
  CLKXOR2X2M U4 ( .A(wire_W_bin_next[1]), .B(wire_W_bin_next[2]), .Y(
        wire_W_gray[1]) );
  CLKXOR2X2M U5 ( .A(wire_W_bin_next[3]), .B(wire_W_bin_next[4]), .Y(
        wire_W_gray[3]) );
  CLKXOR2X2M U6 ( .A(wire_W_bin_next[1]), .B(wire_W_bin_next[0]), .Y(
        wire_W_gray[0]) );
  XNOR2X2M U7 ( .A(wire_W_gray[3]), .B(Wq2_ptr[3]), .Y(n4) );
  XNOR2X2M U8 ( .A(wire_W_gray[1]), .B(Wq2_ptr[1]), .Y(n6) );
  XNOR2X2M U9 ( .A(wire_W_gray[0]), .B(Wq2_ptr[0]), .Y(n5) );
  NOR4X1M U10 ( .A(n1), .B(n2), .C(n3), .D(n4), .Y(wire_W_full) );
  NAND2X2M U11 ( .A(n5), .B(n6), .Y(n1) );
  XNOR2X2M U12 ( .A(wire_W_bin_next[4]), .B(Wq2_ptr[4]), .Y(n3) );
  CLKXOR2X2M U13 ( .A(Wq2_ptr[2]), .B(wire_W_gray[2]), .Y(n2) );
  NOR2BX2M U14 ( .AN(W_inc), .B(W_full), .Y(N0) );
  CLKXOR2X2M U15 ( .A(\reg_W_bin[4] ), .B(\add_28/carry[4] ), .Y(
        wire_W_bin_next[4]) );
  AND2X1M U16 ( .A(W_addr[3]), .B(\add_28/carry[3] ), .Y(\add_28/carry[4] ) );
  CLKXOR2X2M U17 ( .A(W_addr[3]), .B(\add_28/carry[3] ), .Y(wire_W_bin_next[3]) );
  AND2X1M U18 ( .A(W_addr[2]), .B(\add_28/carry[2] ), .Y(\add_28/carry[3] ) );
  CLKXOR2X2M U19 ( .A(W_addr[2]), .B(\add_28/carry[2] ), .Y(wire_W_bin_next[2]) );
  AND2X1M U20 ( .A(W_addr[1]), .B(\add_28/carry[1] ), .Y(\add_28/carry[2] ) );
  CLKXOR2X2M U21 ( .A(W_addr[1]), .B(\add_28/carry[1] ), .Y(wire_W_bin_next[1]) );
  AND2X1M U22 ( .A(N0), .B(W_addr[0]), .Y(\add_28/carry[1] ) );
  CLKXOR2X2M U23 ( .A(N0), .B(W_addr[0]), .Y(wire_W_bin_next[0]) );
endmodule


module FIFO_RD_ADDR4 ( R_clk, R_rst_n, R_inc, Rq2_ptr, R_ptr, R_addr, R_empty
 );
  input [4:0] Rq2_ptr;
  output [4:0] R_ptr;
  output [3:0] R_addr;
  input R_clk, R_rst_n, R_inc;
  output R_empty;
  wire   \reg_R_bin[4] , N0, wire_R_empty, \add_28/carry[4] ,
         \add_28/carry[3] , \add_28/carry[2] , \add_28/carry[1] , n1, n2, n3,
         n4, n5, n6, n7, n8;
  wire   [4:0] wire_R_bin_next;
  wire   [3:0] wire_R_gray;

  DFFRQX2M \reg_R_bin_reg[4]  ( .D(wire_R_bin_next[4]), .CK(R_clk), .RN(
        R_rst_n), .Q(\reg_R_bin[4] ) );
  DFFRQX2M \reg_R_bin_reg[3]  ( .D(wire_R_bin_next[3]), .CK(R_clk), .RN(
        R_rst_n), .Q(R_addr[3]) );
  DFFSQX2M R_empty_reg ( .D(wire_R_empty), .CK(R_clk), .SN(R_rst_n), .Q(
        R_empty) );
  DFFRQX2M \reg_R_bin_reg[0]  ( .D(wire_R_bin_next[0]), .CK(R_clk), .RN(
        R_rst_n), .Q(R_addr[0]) );
  DFFRQX2M \reg_R_bin_reg[1]  ( .D(wire_R_bin_next[1]), .CK(R_clk), .RN(
        R_rst_n), .Q(R_addr[1]) );
  DFFRQX2M \reg_R_bin_reg[2]  ( .D(wire_R_bin_next[2]), .CK(R_clk), .RN(
        R_rst_n), .Q(R_addr[2]) );
  DFFRQX2M \R_ptr_reg[4]  ( .D(wire_R_bin_next[4]), .CK(R_clk), .RN(R_rst_n), 
        .Q(R_ptr[4]) );
  DFFRQX2M \R_ptr_reg[0]  ( .D(wire_R_gray[0]), .CK(R_clk), .RN(R_rst_n), .Q(
        R_ptr[0]) );
  DFFRQX2M \R_ptr_reg[1]  ( .D(wire_R_gray[1]), .CK(R_clk), .RN(R_rst_n), .Q(
        R_ptr[1]) );
  DFFRQX2M \R_ptr_reg[2]  ( .D(wire_R_gray[2]), .CK(R_clk), .RN(R_rst_n), .Q(
        R_ptr[2]) );
  DFFRQX2M \R_ptr_reg[3]  ( .D(wire_R_gray[3]), .CK(R_clk), .RN(R_rst_n), .Q(
        R_ptr[3]) );
  CLKXOR2X2M U3 ( .A(wire_R_bin_next[2]), .B(wire_R_bin_next[1]), .Y(
        wire_R_gray[1]) );
  CLKXOR2X2M U4 ( .A(wire_R_bin_next[4]), .B(wire_R_bin_next[3]), .Y(
        wire_R_gray[3]) );
  CLKXOR2X2M U5 ( .A(wire_R_bin_next[3]), .B(wire_R_bin_next[2]), .Y(
        wire_R_gray[2]) );
  CLKXOR2X2M U6 ( .A(wire_R_bin_next[1]), .B(wire_R_bin_next[0]), .Y(
        wire_R_gray[0]) );
  NOR2BX2M U7 ( .AN(R_inc), .B(R_empty), .Y(N0) );
  CLKXOR2X2M U8 ( .A(\reg_R_bin[4] ), .B(\add_28/carry[4] ), .Y(
        wire_R_bin_next[4]) );
  AND2X1M U9 ( .A(R_addr[3]), .B(\add_28/carry[3] ), .Y(\add_28/carry[4] ) );
  CLKXOR2X2M U10 ( .A(R_addr[3]), .B(\add_28/carry[3] ), .Y(wire_R_bin_next[3]) );
  AND2X1M U11 ( .A(R_addr[2]), .B(\add_28/carry[2] ), .Y(\add_28/carry[3] ) );
  CLKXOR2X2M U12 ( .A(R_addr[2]), .B(\add_28/carry[2] ), .Y(wire_R_bin_next[2]) );
  AND2X1M U13 ( .A(R_addr[1]), .B(\add_28/carry[1] ), .Y(\add_28/carry[2] ) );
  CLKXOR2X2M U14 ( .A(R_addr[1]), .B(\add_28/carry[1] ), .Y(wire_R_bin_next[1]) );
  AND2X1M U15 ( .A(N0), .B(R_addr[0]), .Y(\add_28/carry[1] ) );
  CLKXOR2X2M U16 ( .A(N0), .B(R_addr[0]), .Y(wire_R_bin_next[0]) );
  CLKXOR2X2M U17 ( .A(Rq2_ptr[2]), .B(wire_R_gray[2]), .Y(n8) );
  NOR2BX1M U18 ( .AN(Rq2_ptr[0]), .B(wire_R_gray[0]), .Y(n1) );
  OAI2B2X1M U19 ( .A1N(wire_R_gray[1]), .A0(n1), .B0(Rq2_ptr[1]), .B1(n1), .Y(
        n4) );
  NOR2BX1M U20 ( .AN(wire_R_gray[0]), .B(Rq2_ptr[0]), .Y(n2) );
  OAI2B2X1M U21 ( .A1N(Rq2_ptr[1]), .A0(n2), .B0(wire_R_gray[1]), .B1(n2), .Y(
        n3) );
  CLKNAND2X2M U22 ( .A(n4), .B(n3), .Y(n7) );
  CLKXOR2X2M U23 ( .A(Rq2_ptr[3]), .B(wire_R_gray[3]), .Y(n6) );
  CLKXOR2X2M U24 ( .A(Rq2_ptr[4]), .B(wire_R_bin_next[4]), .Y(n5) );
  NOR4X1M U25 ( .A(n8), .B(n7), .C(n6), .D(n5), .Y(wire_R_empty) );
endmodule


module BIT_SYNC_NUM_STAGES2_BUS_WIDTH5_0 ( CLK, RST, ASYNC, SYNC );
  input [4:0] ASYNC;
  output [4:0] SYNC;
  input CLK, RST;
  wire   \sync_reg[0][4] , \sync_reg[0][3] , \sync_reg[0][2] ,
         \sync_reg[0][1] , \sync_reg[0][0] ;

  DFFRQX2M \sync_reg_reg[1][1]  ( .D(\sync_reg[0][1] ), .CK(CLK), .RN(RST), 
        .Q(SYNC[1]) );
  DFFRQX2M \sync_reg_reg[1][4]  ( .D(\sync_reg[0][4] ), .CK(CLK), .RN(RST), 
        .Q(SYNC[4]) );
  DFFRQX2M \sync_reg_reg[1][3]  ( .D(\sync_reg[0][3] ), .CK(CLK), .RN(RST), 
        .Q(SYNC[3]) );
  DFFRQX2M \sync_reg_reg[1][2]  ( .D(\sync_reg[0][2] ), .CK(CLK), .RN(RST), 
        .Q(SYNC[2]) );
  DFFRQX2M \sync_reg_reg[1][0]  ( .D(\sync_reg[0][0] ), .CK(CLK), .RN(RST), 
        .Q(SYNC[0]) );
  DFFRQX2M \sync_reg_reg[0][4]  ( .D(ASYNC[4]), .CK(CLK), .RN(RST), .Q(
        \sync_reg[0][4] ) );
  DFFRQX2M \sync_reg_reg[0][3]  ( .D(ASYNC[3]), .CK(CLK), .RN(RST), .Q(
        \sync_reg[0][3] ) );
  DFFRQX2M \sync_reg_reg[0][2]  ( .D(ASYNC[2]), .CK(CLK), .RN(RST), .Q(
        \sync_reg[0][2] ) );
  DFFRQX2M \sync_reg_reg[0][1]  ( .D(ASYNC[1]), .CK(CLK), .RN(RST), .Q(
        \sync_reg[0][1] ) );
  DFFRQX2M \sync_reg_reg[0][0]  ( .D(ASYNC[0]), .CK(CLK), .RN(RST), .Q(
        \sync_reg[0][0] ) );
endmodule


module BIT_SYNC_NUM_STAGES2_BUS_WIDTH5_1 ( CLK, RST, ASYNC, SYNC );
  input [4:0] ASYNC;
  output [4:0] SYNC;
  input CLK, RST;
  wire   \sync_reg[0][4] , \sync_reg[0][3] , \sync_reg[0][2] ,
         \sync_reg[0][1] , \sync_reg[0][0] ;

  DFFRQX2M \sync_reg_reg[1][4]  ( .D(\sync_reg[0][4] ), .CK(CLK), .RN(RST), 
        .Q(SYNC[4]) );
  DFFRQX2M \sync_reg_reg[1][3]  ( .D(\sync_reg[0][3] ), .CK(CLK), .RN(RST), 
        .Q(SYNC[3]) );
  DFFRQX2M \sync_reg_reg[1][1]  ( .D(\sync_reg[0][1] ), .CK(CLK), .RN(RST), 
        .Q(SYNC[1]) );
  DFFRQX2M \sync_reg_reg[1][0]  ( .D(\sync_reg[0][0] ), .CK(CLK), .RN(RST), 
        .Q(SYNC[0]) );
  DFFRQX2M \sync_reg_reg[1][2]  ( .D(\sync_reg[0][2] ), .CK(CLK), .RN(RST), 
        .Q(SYNC[2]) );
  DFFRQX2M \sync_reg_reg[0][4]  ( .D(ASYNC[4]), .CK(CLK), .RN(RST), .Q(
        \sync_reg[0][4] ) );
  DFFRQX2M \sync_reg_reg[0][3]  ( .D(ASYNC[3]), .CK(CLK), .RN(RST), .Q(
        \sync_reg[0][3] ) );
  DFFRQX2M \sync_reg_reg[0][2]  ( .D(ASYNC[2]), .CK(CLK), .RN(RST), .Q(
        \sync_reg[0][2] ) );
  DFFRQX2M \sync_reg_reg[0][1]  ( .D(ASYNC[1]), .CK(CLK), .RN(RST), .Q(
        \sync_reg[0][1] ) );
  DFFRQX2M \sync_reg_reg[0][0]  ( .D(ASYNC[0]), .CK(CLK), .RN(RST), .Q(
        \sync_reg[0][0] ) );
endmodule
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
