Shnassar25/-Digital-IC-Design-SoC-RTL2GDS/PNR/dft/netlists/SYS_TOP.v

/////////////////////////////////////////////////////////////
// Created by: Synopsys DC Expert(TM) in wire load mode
// Version   : O-2018.06-SP1
// Date      : Wed Oct  7 01:18:13 2026
/////////////////////////////////////////////////////////////


module mux2X1_1 ( IN_0, IN_1, SEL, OUT );
  input IN_0, IN_1, SEL;
  output OUT;
  wire   N0;
  assign N0 = SEL;

  MX2X6M U1 ( .A(IN_0), .B(IN_1), .S0(N0), .Y(OUT) );
endmodule


module mux2X1_4 ( IN_0, IN_1, SEL, OUT );
  input IN_0, IN_1, SEL;
  output OUT;
  wire   N0;
  assign N0 = SEL;

  MX2X6M U1 ( .A(IN_0), .B(IN_1), .S0(N0), .Y(OUT) );
endmodule


module mux2X1_3 ( IN_0, IN_1, SEL, OUT );
  input IN_0, IN_1, SEL;
  output OUT;
  wire   N0;
  assign N0 = SEL;

  MX2X6M U1 ( .A(IN_0), .B(IN_1), .S0(N0), .Y(OUT) );
endmodule


module mux2X1_2 ( IN_0, IN_1, SEL, OUT );
  input IN_0, IN_1, SEL;
  output OUT;
  wire   N0;
  assign N0 = SEL;

  MX2X6M U1 ( .A(IN_0), .B(IN_1), .S0(N0), .Y(OUT) );
endmodule


module mux2X1_0 ( IN_0, IN_1, SEL, OUT );
  input IN_0, IN_1, SEL;
  output OUT;
  wire   N0;
  assign N0 = SEL;

  MX2X2M U1 ( .A(IN_0), .B(IN_1), .S0(N0), .Y(OUT) );
endmodule


module mux2X1_6 ( IN_0, IN_1, SEL, OUT );
  input IN_0, IN_1, SEL;
  output OUT;
  wire   N0;
  assign N0 = SEL;

  MX2X2M U1 ( .A(IN_0), .B(IN_1), .S0(N0), .Y(OUT) );
endmodule


module mux2X1_5 ( IN_0, IN_1, SEL, OUT );
  input IN_0, IN_1, SEL;
  output OUT;
  wire   N0;
  assign N0 = SEL;

  MX2X2M U1 ( .A(IN_0), .B(IN_1), .S0(N0), .Y(OUT) );
endmodule


module RST_SYNC_NUM_STAGES2_test_0 ( CLK_Rsync, RST_Rsync, SYNC_RST, test_si, 
        test_se );
  input CLK_Rsync, RST_Rsync, test_si, test_se;
  output SYNC_RST;
  wire   \sync_reg[0] ;

  SDFFRQX2M \sync_reg_reg[1]  ( .D(\sync_reg[0] ), .SI(\sync_reg[0] ), .SE(
        test_se), .CK(CLK_Rsync), .RN(RST_Rsync), .Q(SYNC_RST) );
  SDFFRQX2M \sync_reg_reg[0]  ( .D(1'b1), .SI(test_si), .SE(test_se), .CK(
        CLK_Rsync), .RN(RST_Rsync), .Q(\sync_reg[0] ) );
endmodule


module RST_SYNC_NUM_STAGES2_test_1 ( CLK_Rsync, RST_Rsync, SYNC_RST, test_si, 
        test_se );
  input CLK_Rsync, RST_Rsync, test_si, test_se;
  output SYNC_RST;
  wire   \sync_reg[0] ;

  SDFFRQX1M \sync_reg_reg[1]  ( .D(\sync_reg[0] ), .SI(\sync_reg[0] ), .SE(
        test_se), .CK(CLK_Rsync), .RN(RST_Rsync), .Q(SYNC_RST) );
  SDFFRQX1M \sync_reg_reg[0]  ( .D(1'b1), .SI(test_si), .SE(test_se), .CK(
        CLK_Rsync), .RN(RST_Rsync), .Q(\sync_reg[0] ) );
endmodule


module Clk_div_50_Div_Ratio8_0_DW01_inc_0 ( A, SUM );
  input [7:0] A;
  output [7:0] SUM;

  wire   [7:2] carry;

  ADDHX1M U1_1_6 ( .A(A[6]), .B(carry[6]), .CO(carry[7]), .S(SUM[6]) );
  ADDHX1M U1_1_4 ( .A(A[4]), .B(carry[4]), .CO(carry[5]), .S(SUM[4]) );
  ADDHX1M U1_1_5 ( .A(A[5]), .B(carry[5]), .CO(carry[6]), .S(SUM[5]) );
  ADDHX1M U1_1_3 ( .A(A[3]), .B(carry[3]), .CO(carry[4]), .S(SUM[3]) );
  ADDHX1M U1_1_2 ( .A(A[2]), .B(carry[2]), .CO(carry[3]), .S(SUM[2]) );
  ADDHX1M U1_1_1 ( .A(A[1]), .B(A[0]), .CO(carry[2]), .S(SUM[1]) );
  CLKXOR2X2M U1 ( .A(carry[7]), .B(A[7]), .Y(SUM[7]) );
  CLKINVX1M U2 ( .A(A[0]), .Y(SUM[0]) );
endmodule


module Clk_div_50_Div_Ratio8_test_0 ( i_ref_clk, i_rst_n, i_clk_en, 
        i_div_ratio, o_div_clk, test_si2, test_si1, test_so2, test_so1, 
        test_se );
  input [7:0] i_div_ratio;
  input i_ref_clk, i_rst_n, i_clk_en, test_si2, test_si1, test_se;
  output o_div_clk, test_so2, test_so1;
  wire   N8, N9, N10, N11, N12, N13, N14, N15, N18, N19, N20, N21, N22, N23,
         N24, N25, N34, N35, N36, N37, N38, N39, N40, N41, q1, n17, n19, n1,
         n2, n3, n4, n9, n10, n11, n12, n13, n14, n28, n29, n30, n31, n32, n33,
         n34, n35, n36, n37, n38, n39, n40, n41, n42, n43, n44, n45, n46, n47,
         n48, n49, n50, n51, n52, n53, n54, n55, n56, n57, n58, n59, n60, n61,
         n62, n63, n64, n65, n66, n67, n68, n69, n70, n71, n75, n76, n77, n78,
         n79, n80, n81, n82, n83, n84, n85, n86, n87, n88, n90, n5;
  wire   [7:0] counter;
  assign test_so1 = q1;

  SDFFRQX2M \counter_reg[4]  ( .D(N38), .SI(n85), .SE(n82), .CK(i_ref_clk), 
        .RN(n9), .Q(counter[4]) );
  SDFFRQX2M \counter_reg[5]  ( .D(N39), .SI(counter[4]), .SE(n82), .CK(
        i_ref_clk), .RN(n9), .Q(counter[5]) );
  SDFFRQX2M \counter_reg[3]  ( .D(N37), .SI(n86), .SE(n81), .CK(i_ref_clk), 
        .RN(n9), .Q(counter[3]) );
  SDFFRQX2M \counter_reg[1]  ( .D(N35), .SI(counter[0]), .SE(n80), .CK(
        i_ref_clk), .RN(n9), .Q(counter[1]) );
  SDFFRQX2M \counter_reg[2]  ( .D(N36), .SI(n84), .SE(n79), .CK(i_ref_clk), 
        .RN(n9), .Q(counter[2]) );
  SDFFNSRHX1M q2_reg ( .D(n17), .SI(test_si2), .SE(n78), .CKN(i_ref_clk), .SN(
        1'b1), .RN(n9), .Q(n90) );
  SDFFRQX2M q1_reg ( .D(n19), .SI(counter[7]), .SE(n78), .CK(i_ref_clk), .RN(
        n9), .Q(q1) );
  SDFFRQX2M \counter_reg[7]  ( .D(N41), .SI(counter[6]), .SE(n81), .CK(
        i_ref_clk), .RN(n9), .Q(counter[7]) );
  INVX2M U3 ( .A(n1), .Y(n2) );
  INVX2M U4 ( .A(counter[0]), .Y(n1) );
  INVX2M U5 ( .A(i_div_ratio[5]), .Y(n46) );
  INVX2M U6 ( .A(n3), .Y(n4) );
  INVX2M U7 ( .A(counter[6]), .Y(n3) );
  XNOR2X4M U12 ( .A(i_div_ratio[6]), .B(n28), .Y(N14) );
  AOI222X2M U13 ( .A0(counter[3]), .A1(n43), .B0(n44), .B1(n45), .C0(
        counter[4]), .C1(n46), .Y(n42) );
  AOI222X2M U14 ( .A0(N15), .A1(n36), .B0(n60), .B1(n61), .C0(N14), .C1(n3), 
        .Y(n56) );
  OAI32X2M U15 ( .A0(n62), .A1(n63), .A2(n64), .B0(counter[5]), .B1(n65), .Y(
        n60) );
  OAI31X2M U16 ( .A0(n52), .A1(counter[1]), .A2(n2), .B0(n53), .Y(n49) );
  AOI221X2M U17 ( .A0(n87), .A1(n38), .B0(n4), .B1(n37), .C0(n39), .Y(n34) );
  AOI221X2M U18 ( .A0(i_div_ratio[5]), .A1(n40), .B0(i_div_ratio[6]), .B1(n41), 
        .C0(n42), .Y(n39) );
  AOI221X2M U19 ( .A0(N11), .A1(n51), .B0(N12), .B1(n40), .C0(n66), .Y(n63) );
  AOI222X2M U20 ( .A0(n67), .A1(counter[2]), .B0(n68), .B1(n69), .C0(n70), 
        .C1(counter[3]), .Y(n66) );
  NAND2X2M U21 ( .A(n14), .B(n46), .Y(n28) );
  AO21X2M U22 ( .A0(n13), .A1(i_div_ratio[4]), .B0(n14), .Y(N12) );
  NOR2X4M U23 ( .A(n13), .B(i_div_ratio[4]), .Y(n14) );
  OR3X4M U35 ( .A(n56), .B(n57), .C(n31), .Y(n55) );
  MX2X2M U36 ( .A(q1), .B(n88), .S0(n31), .Y(n17) );
  OAI21X6M U37 ( .A0(n58), .A1(n59), .B0(i_clk_en), .Y(n31) );
  OAI21X2M U38 ( .A0(n14), .A1(n46), .B0(n28), .Y(N13) );
  MX2XLM U39 ( .A(n30), .B(i_ref_clk), .S0(n31), .Y(o_div_clk) );
  INVX2M U40 ( .A(i_div_ratio[7]), .Y(n37) );
  INVX2M U41 ( .A(i_div_ratio[1]), .Y(n52) );
  INVXLM U42 ( .A(N13), .Y(n65) );
  OR2X2M U43 ( .A(n12), .B(i_div_ratio[3]), .Y(n13) );
  OR2X2M U44 ( .A(n11), .B(i_div_ratio[2]), .Y(n12) );
  INVX2M U45 ( .A(counter[4]), .Y(n40) );
  INVX2M U46 ( .A(counter[7]), .Y(n36) );
  INVX6M U47 ( .A(n10), .Y(n9) );
  INVX2M U48 ( .A(i_rst_n), .Y(n10) );
  OR2X2M U49 ( .A(i_div_ratio[1]), .B(i_div_ratio[0]), .Y(n11) );
  CLKINVX1M U50 ( .A(i_div_ratio[0]), .Y(N8) );
  OAI2BB1X1M U51 ( .A0N(i_div_ratio[0]), .A1N(i_div_ratio[1]), .B0(n11), .Y(N9) );
  OAI2BB1X1M U52 ( .A0N(n11), .A1N(i_div_ratio[2]), .B0(n12), .Y(N10) );
  OAI2BB1X1M U53 ( .A0N(n12), .A1N(i_div_ratio[3]), .B0(n13), .Y(N11) );
  NOR2X1M U54 ( .A(i_div_ratio[6]), .B(n28), .Y(n29) );
  CLKXOR2X2M U55 ( .A(i_div_ratio[7]), .B(n29), .Y(N15) );
  OAI2BB1X1M U56 ( .A0N(n88), .A1N(i_div_ratio[0]), .B0(n32), .Y(n30) );
  MXI2X1M U57 ( .A(n33), .B(n32), .S0(n31), .Y(n19) );
  CLKINVX1M U58 ( .A(q1), .Y(n32) );
  OAI21X1M U59 ( .A0(n34), .A1(n35), .B0(n36), .Y(n33) );
  NOR2X1M U60 ( .A(n4), .B(n37), .Y(n35) );
  CLKNAND2X2M U61 ( .A(i_div_ratio[3]), .B(n47), .Y(n45) );
  AOI32X1M U62 ( .A0(n48), .A1(n49), .A2(n50), .B0(i_div_ratio[4]), .B1(n51), 
        .Y(n44) );
  OAI21X1M U63 ( .A0(n2), .A1(n52), .B0(counter[1]), .Y(n50) );
  CLKNAND2X2M U64 ( .A(counter[2]), .B(n54), .Y(n48) );
  NOR2BX1M U65 ( .AN(N25), .B(n55), .Y(N41) );
  NOR2BX1M U66 ( .AN(N24), .B(n55), .Y(N40) );
  NOR2BX1M U67 ( .AN(N23), .B(n55), .Y(N39) );
  NOR2BX1M U68 ( .AN(N22), .B(n55), .Y(N38) );
  NOR2BX1M U69 ( .AN(N21), .B(n55), .Y(N37) );
  NOR2BX1M U70 ( .AN(N20), .B(n55), .Y(N36) );
  NOR2BX1M U71 ( .AN(N19), .B(n55), .Y(N35) );
  NOR2BX1M U72 ( .AN(N18), .B(n55), .Y(N34) );
  NAND3X1M U73 ( .A(n53), .B(n54), .C(n52), .Y(n59) );
  CLKINVX1M U74 ( .A(i_div_ratio[3]), .Y(n54) );
  CLKINVX1M U75 ( .A(i_div_ratio[2]), .Y(n53) );
  NAND4X1M U76 ( .A(n43), .B(n46), .C(n38), .D(n37), .Y(n58) );
  CLKINVX1M U77 ( .A(i_div_ratio[6]), .Y(n38) );
  CLKINVX1M U78 ( .A(i_div_ratio[4]), .Y(n43) );
  NOR2X1M U79 ( .A(N15), .B(n36), .Y(n57) );
  NAND2BX1M U80 ( .AN(N14), .B(n4), .Y(n61) );
  NOR2X1M U81 ( .A(N13), .B(n41), .Y(n64) );
  CLKINVX1M U82 ( .A(counter[5]), .Y(n41) );
  CLKINVX1M U83 ( .A(N11), .Y(n70) );
  OAI211X1M U84 ( .A0(N9), .A1(n71), .B0(n1), .C0(N8), .Y(n69) );
  AOI22X1M U85 ( .A0(N10), .A1(n47), .B0(N9), .B1(n71), .Y(n68) );
  CLKINVX1M U86 ( .A(counter[1]), .Y(n71) );
  CLKINVX1M U87 ( .A(counter[2]), .Y(n47) );
  CLKINVX1M U88 ( .A(N10), .Y(n67) );
  CLKINVX1M U89 ( .A(counter[3]), .Y(n51) );
  NOR2X1M U90 ( .A(N12), .B(n40), .Y(n62) );
  DLY1X1M U91 ( .A(test_se), .Y(n75) );
  DLY1X1M U92 ( .A(n75), .Y(n76) );
  DLY1X1M U93 ( .A(n75), .Y(n77) );
  DLY1X1M U94 ( .A(n76), .Y(n78) );
  DLY1X1M U95 ( .A(n76), .Y(n79) );
  DLY1X1M U96 ( .A(n77), .Y(n80) );
  DLY1X1M U97 ( .A(n77), .Y(n81) );
  DLY1X1M U98 ( .A(n80), .Y(n82) );
  DLY1X1M U99 ( .A(n79), .Y(n83) );
  DLY1X1M U100 ( .A(counter[1]), .Y(n84) );
  DLY1X1M U101 ( .A(counter[3]), .Y(n85) );
  DLY1X1M U102 ( .A(counter[2]), .Y(n86) );
  DLY1X1M U103 ( .A(counter[5]), .Y(n87) );
  DLY1X1M U104 ( .A(test_so2), .Y(n88) );
  Clk_div_50_Div_Ratio8_0_DW01_inc_0 add_36 ( .A({counter[7], n4, counter[5:4], 
        n85, n86, n84, n2}), .SUM({N25, N24, N23, N22, N21, N20, N19, N18}) );
  SDFFRQX2M \counter_reg[6]  ( .D(N40), .SI(n87), .SE(n83), .CK(i_ref_clk), 
        .RN(n9), .Q(counter[6]) );
  SDFFRQX2M \counter_reg[0]  ( .D(N34), .SI(test_si1), .SE(n83), .CK(i_ref_clk), .RN(n9), .Q(counter[0]) );
  INVXLM U8 ( .A(n90), .Y(n5) );
  INVX2M U9 ( .A(n5), .Y(test_so2) );
endmodule


module Clk_div_50_Div_Ratio8_1_DW01_inc_0 ( A, SUM );
  input [7:0] A;
  output [7:0] SUM;

  wire   [7:2] carry;

  ADDHX1M U1_1_6 ( .A(A[6]), .B(carry[6]), .CO(carry[7]), .S(SUM[6]) );
  ADDHX1M U1_1_4 ( .A(A[4]), .B(carry[4]), .CO(carry[5]), .S(SUM[4]) );
  ADDHX1M U1_1_5 ( .A(A[5]), .B(carry[5]), .CO(carry[6]), .S(SUM[5]) );
  ADDHX1M U1_1_3 ( .A(A[3]), .B(carry[3]), .CO(carry[4]), .S(SUM[3]) );
  ADDHX1M U1_1_2 ( .A(A[2]), .B(carry[2]), .CO(carry[3]), .S(SUM[2]) );
  ADDHX1M U1_1_1 ( .A(A[1]), .B(A[0]), .CO(carry[2]), .S(SUM[1]) );
  CLKXOR2X2M U1 ( .A(carry[7]), .B(A[7]), .Y(SUM[7]) );
  CLKINVX1M U2 ( .A(A[0]), .Y(SUM[0]) );
endmodule


module Clk_div_50_Div_Ratio8_test_1 ( i_ref_clk, i_rst_n, i_clk_en, 
        i_div_ratio, o_div_clk, test_si2, test_si1, test_so2, test_so1, 
        test_se );
  input [7:0] i_div_ratio;
  input i_ref_clk, i_rst_n, i_clk_en, test_si2, test_si1, test_se;
  output o_div_clk, test_so2, test_so1;
  wire   N9, N10, N11, N12, N13, N14, N15, N18, N19, N20, N21, N22, N23, N24,
         N25, N34, N35, N36, N37, N38, N39, N40, N41, q1, q2, n1, n2, n3, n4,
         n5, n6, n7, n8, n9, n10, n11, n12, n13, n14, n28, n29, n30, n31, n32,
         n33, n34, n35, n36, n37, n38, n39, n40, n41, n42, n43, n44, n45, n46,
         n47, n48, n49, n50, n51, n52, n53, n54, n55, n56, n57, n58, n59, n60,
         n61, n62, n63, n64, n65, n66, n67, n76, n78, n85, n86, n87, n88, n89,
         n90, n91, n92, n93, n94, n95, n96, n98;
  wire   [7:0] counter;

  SDFFRQX4M \counter_reg[6]  ( .D(N40), .SI(n96), .SE(n85), .CK(i_ref_clk), 
        .RN(n2), .Q(counter[6]) );
  SDFFRQX1M \counter_reg[7]  ( .D(N41), .SI(counter[6]), .SE(n86), .CK(
        i_ref_clk), .RN(n2), .Q(counter[7]) );
  SDFFRQX2M \counter_reg[4]  ( .D(N38), .SI(n94), .SE(n86), .CK(i_ref_clk), 
        .RN(n2), .Q(counter[4]) );
  SDFFRQX4M \counter_reg[0]  ( .D(N34), .SI(test_si1), .SE(n92), .CK(i_ref_clk), .RN(n2), .Q(counter[0]) );
  SDFFRQX1M q1_reg ( .D(n76), .SI(counter[7]), .SE(n91), .CK(i_ref_clk), .RN(
        n2), .Q(q1) );
  SDFFRQX2M \counter_reg[5]  ( .D(N39), .SI(counter[4]), .SE(n91), .CK(
        i_ref_clk), .RN(n2), .Q(counter[5]) );
  SDFFRQX2M \counter_reg[3]  ( .D(N37), .SI(n95), .SE(n85), .CK(i_ref_clk), 
        .RN(n2), .Q(counter[3]) );
  SDFFRQX2M \counter_reg[1]  ( .D(N35), .SI(counter[0]), .SE(n90), .CK(
        i_ref_clk), .RN(n2), .Q(counter[1]) );
  SDFFRQX2M \counter_reg[2]  ( .D(N36), .SI(n93), .SE(n89), .CK(i_ref_clk), 
        .RN(n2), .Q(counter[2]) );
  SDFFNSRHX1M q2_reg ( .D(n78), .SI(test_si2), .SE(n89), .CKN(i_ref_clk), .SN(
        1'b1), .RN(n2), .Q(q2), .QN(test_so2) );
  OR2X1M U3 ( .A(n5), .B(i_div_ratio[3]), .Y(n1) );
  AOI222X2M U4 ( .A0(counter[3]), .A1(n38), .B0(n39), .B1(n40), .C0(counter[4]), .C1(n10), .Y(n37) );
  INVX2M U5 ( .A(i_div_ratio[1]), .Y(n46) );
  OAI32X2M U6 ( .A0(n57), .A1(n58), .A2(n59), .B0(counter[5]), .B1(n60), .Y(
        n54) );
  NOR2X2M U7 ( .A(N13), .B(n36), .Y(n59) );
  AOI221X2M U8 ( .A0(n96), .A1(n33), .B0(counter[6]), .B1(n32), .C0(n34), .Y(
        n29) );
  AOI221X2M U9 ( .A0(i_div_ratio[5]), .A1(n35), .B0(i_div_ratio[6]), .B1(n36), 
        .C0(n37), .Y(n34) );
  AOI221X2M U10 ( .A0(N11), .A1(n45), .B0(N12), .B1(n35), .C0(n61), .Y(n58) );
  AOI222X2M U11 ( .A0(n62), .A1(counter[2]), .B0(n63), .B1(n64), .C0(n65), 
        .C1(counter[3]), .Y(n61) );
  OAI21X6M U12 ( .A0(n52), .A1(n53), .B0(i_clk_en), .Y(n13) );
  NAND3X1M U13 ( .A(n47), .B(n48), .C(n46), .Y(n53) );
  OR2X2M U14 ( .A(n4), .B(i_div_ratio[2]), .Y(n5) );
  NAND2BX2M U15 ( .AN(i_div_ratio[1]), .B(n11), .Y(n4) );
  OAI31X2M U16 ( .A0(n46), .A1(counter[1]), .A2(counter[0]), .B0(n47), .Y(n43)
         );
  NAND2X2M U17 ( .A(n7), .B(n10), .Y(n8) );
  AO21X1M U18 ( .A0(n1), .A1(i_div_ratio[4]), .B0(n7), .Y(N12) );
  NOR2X3M U19 ( .A(n1), .B(i_div_ratio[4]), .Y(n7) );
  OR3X4M U20 ( .A(n50), .B(n51), .C(n13), .Y(n49) );
  AOI222X2M U21 ( .A0(N15), .A1(n31), .B0(n54), .B1(n55), .C0(N14), .C1(n56), 
        .Y(n50) );
  OAI21X2M U22 ( .A0(n7), .A1(n10), .B0(n8), .Y(N13) );
  MX2XLM U23 ( .A(n12), .B(i_ref_clk), .S0(n13), .Y(o_div_clk) );
  MX2XLM U35 ( .A(q1), .B(q2), .S0(n13), .Y(n78) );
  INVXLM U36 ( .A(N13), .Y(n60) );
  XNOR2X2M U37 ( .A(i_div_ratio[6]), .B(n8), .Y(N14) );
  NAND2XLM U38 ( .A(i_div_ratio[3]), .B(n41), .Y(n40) );
  INVX2M U39 ( .A(counter[4]), .Y(n35) );
  INVX2M U40 ( .A(counter[7]), .Y(n31) );
  INVX2M U41 ( .A(i_div_ratio[7]), .Y(n32) );
  INVX2M U42 ( .A(i_div_ratio[0]), .Y(n11) );
  INVX6M U43 ( .A(n3), .Y(n2) );
  INVX2M U44 ( .A(i_rst_n), .Y(n3) );
  INVX2M U45 ( .A(i_div_ratio[5]), .Y(n10) );
  OAI2BB1X1M U46 ( .A0N(i_div_ratio[0]), .A1N(i_div_ratio[1]), .B0(n4), .Y(N9)
         );
  OAI2BB1X1M U47 ( .A0N(n4), .A1N(i_div_ratio[2]), .B0(n5), .Y(N10) );
  OR2X1M U48 ( .A(n5), .B(i_div_ratio[3]), .Y(n6) );
  OAI2BB1X1M U49 ( .A0N(n5), .A1N(i_div_ratio[3]), .B0(n6), .Y(N11) );
  NOR2X1M U50 ( .A(i_div_ratio[6]), .B(n8), .Y(n9) );
  CLKXOR2X2M U51 ( .A(i_div_ratio[7]), .B(n9), .Y(N15) );
  OAI2BB1X1M U52 ( .A0N(q2), .A1N(i_div_ratio[0]), .B0(n14), .Y(n12) );
  MXI2X1M U53 ( .A(n28), .B(n14), .S0(n13), .Y(n76) );
  CLKINVX1M U54 ( .A(test_so1), .Y(n14) );
  OAI21X1M U55 ( .A0(n29), .A1(n30), .B0(n31), .Y(n28) );
  NOR2X1M U56 ( .A(counter[6]), .B(n32), .Y(n30) );
  AOI32X1M U57 ( .A0(n42), .A1(n43), .A2(n44), .B0(i_div_ratio[4]), .B1(n45), 
        .Y(n39) );
  OAI21X1M U58 ( .A0(counter[0]), .A1(n46), .B0(counter[1]), .Y(n44) );
  CLKNAND2X2M U59 ( .A(counter[2]), .B(n48), .Y(n42) );
  NOR2BX1M U60 ( .AN(N25), .B(n49), .Y(N41) );
  NOR2BX1M U61 ( .AN(N24), .B(n49), .Y(N40) );
  NOR2BX1M U62 ( .AN(N23), .B(n49), .Y(N39) );
  NOR2BX1M U63 ( .AN(N22), .B(n49), .Y(N38) );
  NOR2BX1M U64 ( .AN(N21), .B(n49), .Y(N37) );
  NOR2BX1M U65 ( .AN(N20), .B(n49), .Y(N36) );
  NOR2BX1M U66 ( .AN(N19), .B(n49), .Y(N35) );
  NOR2BX1M U67 ( .AN(N18), .B(n49), .Y(N34) );
  CLKINVX1M U68 ( .A(i_div_ratio[3]), .Y(n48) );
  CLKINVX1M U69 ( .A(i_div_ratio[2]), .Y(n47) );
  NAND4X1M U70 ( .A(n38), .B(n10), .C(n33), .D(n32), .Y(n52) );
  CLKINVX1M U71 ( .A(i_div_ratio[6]), .Y(n33) );
  CLKINVX1M U72 ( .A(i_div_ratio[4]), .Y(n38) );
  NOR2X1M U73 ( .A(N15), .B(n31), .Y(n51) );
  CLKINVX1M U74 ( .A(counter[6]), .Y(n56) );
  NAND2BX1M U75 ( .AN(N14), .B(counter[6]), .Y(n55) );
  CLKINVX1M U76 ( .A(counter[5]), .Y(n36) );
  CLKINVX1M U77 ( .A(N11), .Y(n65) );
  OAI211X1M U78 ( .A0(N9), .A1(n66), .B0(n67), .C0(n11), .Y(n64) );
  CLKINVX1M U79 ( .A(counter[0]), .Y(n67) );
  AOI22X1M U80 ( .A0(N10), .A1(n41), .B0(N9), .B1(n66), .Y(n63) );
  CLKINVX1M U81 ( .A(counter[1]), .Y(n66) );
  CLKINVX1M U82 ( .A(counter[2]), .Y(n41) );
  CLKINVX1M U83 ( .A(N10), .Y(n62) );
  CLKINVX1M U84 ( .A(counter[3]), .Y(n45) );
  NOR2X1M U85 ( .A(N12), .B(n35), .Y(n57) );
  DLY1X1M U86 ( .A(n92), .Y(n85) );
  DLY1X1M U87 ( .A(n90), .Y(n86) );
  DLY1X1M U88 ( .A(test_se), .Y(n87) );
  DLY1X1M U89 ( .A(test_se), .Y(n88) );
  DLY1X1M U90 ( .A(n87), .Y(n89) );
  DLY1X1M U91 ( .A(n87), .Y(n90) );
  DLY1X1M U92 ( .A(n88), .Y(n91) );
  DLY1X1M U93 ( .A(n88), .Y(n92) );
  DLY1X1M U94 ( .A(counter[1]), .Y(n93) );
  DLY1X1M U95 ( .A(counter[3]), .Y(n94) );
  DLY1X1M U96 ( .A(counter[2]), .Y(n95) );
  DLY1X1M U97 ( .A(counter[5]), .Y(n96) );
  DLY1X1M U98 ( .A(q1), .Y(test_so1) );
  INVXLM U99 ( .A(n31), .Y(n98) );
  Clk_div_50_Div_Ratio8_1_DW01_inc_0 add_36 ( .A({n98, counter[6:4], n94, n95, 
        n93, counter[0]}), .SUM({N25, N24, N23, N22, N21, N20, N19, N18}) );
endmodule


module CLK_DIV_MUX_WIDTH8 ( IN, OUT );
  input [5:0] IN;
  output [7:0] OUT;
  wire   n5, n6, n7, n8, n9, n14, n15, n16, n17;

  OAI211X4M U11 ( .A0(n8), .A1(n9), .B0(n17), .C0(n16), .Y(OUT[0]) );
  NOR4X6M U12 ( .A(n5), .B(IN[3]), .C(IN[5]), .D(IN[4]), .Y(OUT[3]) );
  INVX2M U13 ( .A(IN[2]), .Y(n15) );
  NOR3X6M U14 ( .A(n6), .B(IN[1]), .C(IN[0]), .Y(OUT[2]) );
  NOR3X6M U15 ( .A(n7), .B(IN[1]), .C(IN[0]), .Y(OUT[1]) );
  NOR4X2M U16 ( .A(IN[5]), .B(IN[4]), .C(IN[3]), .D(n15), .Y(n8) );
  CLKINVX1M U17 ( .A(IN[1]), .Y(n16) );
  NAND4BX2M U18 ( .AN(IN[3]), .B(IN[4]), .C(n15), .D(n14), .Y(n7) );
  NAND4BX2M U19 ( .AN(IN[4]), .B(IN[3]), .C(n15), .D(n14), .Y(n6) );
  NAND3X1M U20 ( .A(n17), .B(n16), .C(IN[2]), .Y(n5) );
  CLKINVX1M U21 ( .A(IN[5]), .Y(n14) );
  INVX2M U22 ( .A(IN[0]), .Y(n17) );
  NAND2X2M U23 ( .A(n7), .B(n6), .Y(n9) );
  INVX2M U3 ( .A(1'b1), .Y(OUT[7]) );
  INVX2M U5 ( .A(1'b1), .Y(OUT[6]) );
  INVX2M U7 ( .A(1'b1), .Y(OUT[5]) );
  INVX2M U9 ( .A(1'b1), .Y(OUT[4]) );
endmodule


module PULSE_GEN_test_1 ( clk, rst, lvl_sig, pulse_sig, test_si, test_so, 
        test_se );
  input clk, rst, lvl_sig, test_si, test_se;
  output pulse_sig, test_so;
  wire   lvl_sig_ff, pulse_flop;
  assign test_so = pulse_flop;

  SDFFRQX2M pulse_flop_reg ( .D(lvl_sig_ff), .SI(lvl_sig_ff), .SE(test_se), 
        .CK(clk), .RN(rst), .Q(pulse_flop) );
  SDFFRQX2M lvl_sig_ff_reg ( .D(lvl_sig), .SI(test_si), .SE(test_se), .CK(clk), 
        .RN(rst), .Q(lvl_sig_ff) );
  NOR2BX2M U5 ( .AN(lvl_sig_ff), .B(pulse_flop), .Y(pulse_sig) );
endmodule


module Data_SYNC_NUM_STAGES2_BUS_WIDTH8_test_1 ( CLK, RST, ASYNC, BUS_EN, 
        ENABLE_PULSE, SYNC_BUS, test_si, test_so, test_se );
  input [7:0] ASYNC;
  output [7:0] SYNC_BUS;
  input CLK, RST, BUS_EN, test_si, test_se;
  output ENABLE_PULSE, test_so;
  wire   pulse_flop, n1, n4, n6, n8, n10, n12, n14, n16, n18, n27, n28, n29,
         n30, n33, n34, n35, n36, n37, n38, n39, n40, n41, n42, n43, n44;
  wire   [1:0] sync_enable_reg;
  assign test_so = sync_enable_reg[1];

  SDFFRQX2M pulse_flop_reg ( .D(sync_enable_reg[1]), .SI(SYNC_BUS[7]), .SE(n41), .CK(CLK), .RN(n28), .Q(pulse_flop) );
  SDFFRQX2M \sync_enable_reg_reg[1]  ( .D(sync_enable_reg[0]), .SI(
        sync_enable_reg[0]), .SE(n42), .CK(CLK), .RN(n28), .Q(
        sync_enable_reg[1]) );
  SDFFRQX2M \SYNC_BUS_reg[7]  ( .D(n18), .SI(SYNC_BUS[6]), .SE(n39), .CK(CLK), 
        .RN(n28), .Q(SYNC_BUS[7]) );
  SDFFRQX2M \SYNC_BUS_reg[3]  ( .D(n10), .SI(SYNC_BUS[2]), .SE(n35), .CK(CLK), 
        .RN(n28), .Q(SYNC_BUS[3]) );
  SDFFRQX2M \sync_enable_reg_reg[0]  ( .D(BUS_EN), .SI(pulse_flop), .SE(n36), 
        .CK(CLK), .RN(n28), .Q(sync_enable_reg[0]) );
  SDFFRQX2M \SYNC_BUS_reg[5]  ( .D(n14), .SI(SYNC_BUS[4]), .SE(n40), .CK(CLK), 
        .RN(n28), .Q(SYNC_BUS[5]) );
  SDFFRQX2M \SYNC_BUS_reg[1]  ( .D(n6), .SI(SYNC_BUS[0]), .SE(n36), .CK(CLK), 
        .RN(n28), .Q(SYNC_BUS[1]) );
  INVX4M U8 ( .A(n1), .Y(n30) );
  BUFX4M U9 ( .A(n1), .Y(n27) );
  INVX6M U10 ( .A(n29), .Y(n28) );
  INVX2M U11 ( .A(RST), .Y(n29) );
  NAND2BX2M U12 ( .AN(pulse_flop), .B(sync_enable_reg[1]), .Y(n1) );
  AO22X1M U25 ( .A0(ASYNC[0]), .A1(n30), .B0(SYNC_BUS[0]), .B1(n27), .Y(n4) );
  AO22X1M U26 ( .A0(ASYNC[4]), .A1(n30), .B0(SYNC_BUS[4]), .B1(n27), .Y(n12)
         );
  AO22X1M U27 ( .A0(ASYNC[2]), .A1(n30), .B0(SYNC_BUS[2]), .B1(n27), .Y(n8) );
  AO22X1M U28 ( .A0(ASYNC[6]), .A1(n30), .B0(SYNC_BUS[6]), .B1(n27), .Y(n16)
         );
  AO22X1M U29 ( .A0(ASYNC[1]), .A1(n30), .B0(n43), .B1(n27), .Y(n6) );
  AO22X1M U30 ( .A0(ASYNC[5]), .A1(n30), .B0(n44), .B1(n27), .Y(n14) );
  AO22X1M U31 ( .A0(ASYNC[3]), .A1(n30), .B0(SYNC_BUS[3]), .B1(n27), .Y(n10)
         );
  AO22X1M U32 ( .A0(ASYNC[7]), .A1(n30), .B0(SYNC_BUS[7]), .B1(n27), .Y(n18)
         );
  DLY1X1M U33 ( .A(test_se), .Y(n33) );
  DLY1X1M U34 ( .A(n33), .Y(n34) );
  DLY1X1M U35 ( .A(n38), .Y(n35) );
  DLY1X1M U36 ( .A(n37), .Y(n36) );
  DLY1X1M U37 ( .A(test_se), .Y(n37) );
  DLY1X1M U38 ( .A(n33), .Y(n38) );
  DLY1X1M U41 ( .A(n34), .Y(n41) );
  DLY1X1M U42 ( .A(n37), .Y(n42) );
  DLY1X1M U43 ( .A(SYNC_BUS[1]), .Y(n43) );
  DLY1X1M U44 ( .A(SYNC_BUS[5]), .Y(n44) );
  SDFFRQX4M ENABLE_PULSE_reg ( .D(n30), .SI(test_si), .SE(n35), .CK(CLK), .RN(
        n28), .Q(ENABLE_PULSE) );
  SDFFRQX4M \SYNC_BUS_reg[0]  ( .D(n4), .SI(ENABLE_PULSE), .SE(n41), .CK(CLK), 
        .RN(n28), .Q(SYNC_BUS[0]) );
  SDFFRQX4M \SYNC_BUS_reg[2]  ( .D(n8), .SI(n43), .SE(n40), .CK(CLK), .RN(n28), 
        .Q(SYNC_BUS[2]) );
  SDFFRQX4M \SYNC_BUS_reg[6]  ( .D(n16), .SI(n44), .SE(n39), .CK(CLK), .RN(n28), .Q(SYNC_BUS[6]) );
  SDFFRQX4M \SYNC_BUS_reg[4]  ( .D(n12), .SI(SYNC_BUS[3]), .SE(n42), .CK(CLK), 
        .RN(n28), .Q(SYNC_BUS[4]) );
  BUFX2M U3 ( .A(n38), .Y(n39) );
  BUFX2M U4 ( .A(n34), .Y(n40) );
endmodule


module REG_file_WIDTH8_NO_OF_REG16_ADDR4_test_1 ( CLK_regfile, RST_regfile, 
        WrData, Address, WrEn, RdEn, RdData, RdData_Valid, REG0, REG1, REG2, 
        REG3, test_si3, test_si2, test_si1, test_so2, test_so1, test_se );
  input [7:0] WrData;
  input [3:0] Address;
  output [7:0] RdData;
  output [7:0] REG0;
  output [7:0] REG1;
  output [7:0] REG2;
  output [7:0] REG3;
  input CLK_regfile, RST_regfile, WrEn, RdEn, test_si3, test_si2, test_si1,
         test_se;
  output RdData_Valid, test_so2, test_so1;
  wire   N11, N12, N13, N14, n511, n512, n513, n514, n515, n516, n517, n518,
         n519, \Reg_File[15][7] , \Reg_File[15][6] , \Reg_File[15][5] ,
         \Reg_File[15][4] , \Reg_File[15][3] , \Reg_File[15][2] ,
         \Reg_File[15][1] , \Reg_File[15][0] , \Reg_File[14][7] ,
         \Reg_File[14][6] , \Reg_File[14][5] , \Reg_File[14][4] ,
         \Reg_File[14][3] , \Reg_File[14][2] , \Reg_File[14][1] ,
         \Reg_File[14][0] , \Reg_File[13][7] , \Reg_File[13][6] ,
         \Reg_File[13][5] , \Reg_File[13][4] , \Reg_File[13][3] ,
         \Reg_File[13][2] , \Reg_File[13][1] , \Reg_File[13][0] ,
         \Reg_File[12][7] , \Reg_File[12][6] , \Reg_File[12][5] ,
         \Reg_File[12][4] , \Reg_File[12][3] , \Reg_File[12][2] ,
         \Reg_File[12][1] , \Reg_File[12][0] , \Reg_File[11][7] ,
         \Reg_File[11][6] , \Reg_File[11][5] , \Reg_File[11][4] ,
         \Reg_File[11][3] , \Reg_File[11][2] , \Reg_File[11][1] ,
         \Reg_File[11][0] , \Reg_File[10][7] , \Reg_File[10][6] ,
         \Reg_File[10][5] , \Reg_File[10][4] , \Reg_File[10][3] ,
         \Reg_File[10][2] , \Reg_File[10][1] , \Reg_File[10][0] ,
         \Reg_File[9][7] , \Reg_File[9][6] , \Reg_File[9][5] ,
         \Reg_File[9][4] , \Reg_File[9][3] , \Reg_File[9][2] ,
         \Reg_File[9][1] , \Reg_File[9][0] , \Reg_File[8][7] ,
         \Reg_File[8][6] , \Reg_File[8][5] , \Reg_File[8][4] ,
         \Reg_File[8][3] , \Reg_File[8][2] , \Reg_File[8][1] ,
         \Reg_File[8][0] , \Reg_File[7][7] , \Reg_File[7][6] ,
         \Reg_File[7][5] , \Reg_File[7][4] , \Reg_File[7][3] ,
         \Reg_File[7][2] , \Reg_File[7][1] , \Reg_File[7][0] ,
         \Reg_File[6][7] , \Reg_File[6][6] , \Reg_File[6][5] ,
         \Reg_File[6][4] , \Reg_File[6][3] , \Reg_File[6][2] ,
         \Reg_File[6][1] , \Reg_File[6][0] , \Reg_File[5][7] ,
         \Reg_File[5][6] , \Reg_File[5][5] , \Reg_File[5][4] ,
         \Reg_File[5][3] , \Reg_File[5][2] , \Reg_File[5][1] ,
         \Reg_File[5][0] , \Reg_File[4][7] , \Reg_File[4][6] ,
         \Reg_File[4][5] , \Reg_File[4][4] , \Reg_File[4][3] ,
         \Reg_File[4][2] , \Reg_File[4][1] , \Reg_File[4][0] , N36, N37, N38,
         N39, N40, N41, N42, N43, n149, n150, n151, n152, n153, n154, n155,
         n156, n157, n158, n159, n160, n161, n162, n163, n164, n165, n166,
         n167, n168, n169, n170, n171, n172, n173, n174, n175, n176, n177,
         n178, n179, n180, n181, n182, n183, n184, n185, n186, n187, n188,
         n189, n190, n191, n192, n193, n194, n195, n196, n197, n198, n199,
         n200, n201, n202, n203, n204, n205, n206, n207, n208, n209, n210,
         n211, n212, n213, n214, n215, n216, n217, n218, n219, n220, n221,
         n222, n223, n224, n225, n226, n227, n228, n229, n230, n231, n232,
         n233, n234, n235, n236, n237, n238, n239, n240, n241, n242, n243,
         n244, n245, n246, n247, n248, n249, n250, n251, n252, n253, n254,
         n255, n256, n257, n258, n259, n260, n261, n262, n263, n264, n265,
         n266, n267, n268, n269, n270, n271, n272, n273, n274, n275, n276,
         n277, n278, n279, n280, n281, n282, n283, n284, n285, n286, n287,
         n288, n289, n290, n291, n292, n293, n294, n295, n296, n297, n298,
         n299, n300, n301, n302, n303, n304, n305, n306, n307, n308, n309,
         n310, n311, n312, n313, n138, n139, n141, n143, n145, n329, n330,
         n331, n332, n333, n334, n335, n336, n337, n338, n339, n340, n341,
         n342, n343, n344, n345, n346, n347, n348, n349, n350, n351, n352,
         n353, n354, n355, n356, n357, n358, n359, n360, n361, n362, n363,
         n364, n365, n366, n367, n368, n369, n370, n371, n372, n373, n374,
         n375, n376, n377, n378, n379, n380, n381, n382, n383, n384, n385,
         n386, n387, n388, n389, n390, n391, n392, n393, n394, n395, n396,
         n397, n398, n399, n400, n401, n402, n403, n404, n405, n406, n407,
         n408, n409, n410, n411, n412, n413, n414, n415, n416, n417, n418,
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
        .CK(CLK_regfile), .RN(n491), .Q(\Reg_File[9][3] ) );
  SDFFRQX2M \Reg_File_reg[9][2]  ( .D(n259), .SI(\Reg_File[9][1] ), .SE(n647), 
        .CK(CLK_regfile), .RN(n491), .Q(\Reg_File[9][2] ) );
  SDFFRQX2M \Reg_File_reg[9][1]  ( .D(n258), .SI(\Reg_File[9][0] ), .SE(n647), 
        .CK(CLK_regfile), .RN(n491), .Q(\Reg_File[9][1] ) );
  SDFFRQX2M \Reg_File_reg[9][0]  ( .D(n257), .SI(\Reg_File[8][7] ), .SE(n646), 
        .CK(CLK_regfile), .RN(n491), .Q(\Reg_File[9][0] ) );
  SDFFRQX2M \Reg_File_reg[14][7]  ( .D(n304), .SI(\Reg_File[14][6] ), .SE(n646), .CK(CLK_regfile), .RN(n494), .Q(\Reg_File[14][7] ) );
  SDFFRQX2M \Reg_File_reg[14][6]  ( .D(n303), .SI(\Reg_File[14][5] ), .SE(n645), .CK(CLK_regfile), .RN(n494), .Q(\Reg_File[14][6] ) );
  SDFFRQX2M \Reg_File_reg[14][5]  ( .D(n302), .SI(\Reg_File[14][4] ), .SE(n645), .CK(CLK_regfile), .RN(n494), .Q(\Reg_File[14][5] ) );
  SDFFRQX2M \Reg_File_reg[14][4]  ( .D(n301), .SI(\Reg_File[14][3] ), .SE(n644), .CK(CLK_regfile), .RN(n494), .Q(\Reg_File[14][4] ) );
  SDFFRQX2M \Reg_File_reg[14][3]  ( .D(n300), .SI(\Reg_File[14][2] ), .SE(n644), .CK(CLK_regfile), .RN(n494), .Q(\Reg_File[14][3] ) );
  SDFFRQX2M \Reg_File_reg[14][2]  ( .D(n299), .SI(\Reg_File[14][1] ), .SE(n643), .CK(CLK_regfile), .RN(n494), .Q(\Reg_File[14][2] ) );
  SDFFRQX2M \Reg_File_reg[14][1]  ( .D(n298), .SI(\Reg_File[14][0] ), .SE(n643), .CK(CLK_regfile), .RN(n494), .Q(\Reg_File[14][1] ) );
  SDFFRQX2M \Reg_File_reg[14][0]  ( .D(n297), .SI(\Reg_File[13][7] ), .SE(n642), .CK(CLK_regfile), .RN(n494), .Q(\Reg_File[14][0] ) );
  SDFFRQX2M \Reg_File_reg[12][7]  ( .D(n288), .SI(\Reg_File[12][6] ), .SE(n642), .CK(CLK_regfile), .RN(n493), .Q(\Reg_File[12][7] ) );
  SDFFRQX2M \Reg_File_reg[12][6]  ( .D(n287), .SI(\Reg_File[12][5] ), .SE(n641), .CK(CLK_regfile), .RN(n493), .Q(\Reg_File[12][6] ) );
  SDFFRQX2M \Reg_File_reg[12][5]  ( .D(n286), .SI(\Reg_File[12][4] ), .SE(n641), .CK(CLK_regfile), .RN(n493), .Q(\Reg_File[12][5] ) );
  SDFFRQX2M \Reg_File_reg[12][4]  ( .D(n285), .SI(\Reg_File[12][3] ), .SE(n640), .CK(CLK_regfile), .RN(n493), .Q(\Reg_File[12][4] ) );
  SDFFRQX2M \Reg_File_reg[12][3]  ( .D(n284), .SI(\Reg_File[12][2] ), .SE(n640), .CK(CLK_regfile), .RN(n493), .Q(\Reg_File[12][3] ) );
  SDFFRQX2M \Reg_File_reg[12][2]  ( .D(n283), .SI(\Reg_File[12][1] ), .SE(n639), .CK(CLK_regfile), .RN(n493), .Q(\Reg_File[12][2] ) );
  SDFFRQX2M \Reg_File_reg[12][1]  ( .D(n282), .SI(\Reg_File[12][0] ), .SE(n639), .CK(CLK_regfile), .RN(n493), .Q(\Reg_File[12][1] ) );
  SDFFRQX2M \Reg_File_reg[12][0]  ( .D(n281), .SI(\Reg_File[11][7] ), .SE(n638), .CK(CLK_regfile), .RN(n493), .Q(\Reg_File[12][0] ) );
  SDFFRQX2M \Reg_File_reg[10][7]  ( .D(n272), .SI(\Reg_File[10][6] ), .SE(n638), .CK(CLK_regfile), .RN(n492), .Q(\Reg_File[10][7] ) );
  SDFFRQX2M \Reg_File_reg[10][6]  ( .D(n271), .SI(\Reg_File[10][5] ), .SE(n637), .CK(CLK_regfile), .RN(n492), .Q(\Reg_File[10][6] ) );
  SDFFRQX2M \Reg_File_reg[10][5]  ( .D(n270), .SI(\Reg_File[10][4] ), .SE(n637), .CK(CLK_regfile), .RN(n492), .Q(\Reg_File[10][5] ) );
  SDFFRQX2M \Reg_File_reg[10][4]  ( .D(n269), .SI(\Reg_File[10][3] ), .SE(n636), .CK(CLK_regfile), .RN(n492), .Q(\Reg_File[10][4] ) );
  SDFFRQX2M \Reg_File_reg[10][3]  ( .D(n268), .SI(\Reg_File[10][2] ), .SE(n636), .CK(CLK_regfile), .RN(n492), .Q(\Reg_File[10][3] ) );
  SDFFRQX2M \Reg_File_reg[10][2]  ( .D(n267), .SI(\Reg_File[10][1] ), .SE(n635), .CK(CLK_regfile), .RN(n492), .Q(\Reg_File[10][2] ) );
  SDFFRQX2M \Reg_File_reg[10][1]  ( .D(n266), .SI(\Reg_File[10][0] ), .SE(n635), .CK(CLK_regfile), .RN(n491), .Q(\Reg_File[10][1] ) );
  SDFFRQX2M \Reg_File_reg[10][0]  ( .D(n265), .SI(\Reg_File[9][7] ), .SE(n634), 
        .CK(CLK_regfile), .RN(n491), .Q(\Reg_File[10][0] ) );
  SDFFRQX2M \Reg_File_reg[8][7]  ( .D(n256), .SI(\Reg_File[8][6] ), .SE(n634), 
        .CK(CLK_regfile), .RN(n491), .Q(\Reg_File[8][7] ) );
  SDFFRQX2M \Reg_File_reg[8][6]  ( .D(n255), .SI(\Reg_File[8][5] ), .SE(n633), 
        .CK(CLK_regfile), .RN(n491), .Q(\Reg_File[8][6] ) );
  SDFFRQX2M \Reg_File_reg[8][5]  ( .D(n254), .SI(\Reg_File[8][4] ), .SE(n633), 
        .CK(CLK_regfile), .RN(n491), .Q(\Reg_File[8][5] ) );
  SDFFRQX2M \Reg_File_reg[8][4]  ( .D(n253), .SI(\Reg_File[8][3] ), .SE(n632), 
        .CK(CLK_regfile), .RN(n490), .Q(\Reg_File[8][4] ) );
  SDFFRQX2M \Reg_File_reg[8][3]  ( .D(n252), .SI(\Reg_File[8][2] ), .SE(n632), 
        .CK(CLK_regfile), .RN(n490), .Q(\Reg_File[8][3] ) );
  SDFFRQX2M \Reg_File_reg[8][2]  ( .D(n251), .SI(\Reg_File[8][1] ), .SE(n631), 
        .CK(CLK_regfile), .RN(n490), .Q(\Reg_File[8][2] ) );
  SDFFRQX2M \Reg_File_reg[8][1]  ( .D(n250), .SI(\Reg_File[8][0] ), .SE(n631), 
        .CK(CLK_regfile), .RN(n490), .Q(\Reg_File[8][1] ) );
  SDFFRQX2M \Reg_File_reg[8][0]  ( .D(n249), .SI(\Reg_File[7][7] ), .SE(n630), 
        .CK(CLK_regfile), .RN(n490), .Q(\Reg_File[8][0] ) );
  SDFFRQX2M \Reg_File_reg[4][7]  ( .D(n224), .SI(\Reg_File[4][6] ), .SE(n630), 
        .CK(CLK_regfile), .RN(n488), .Q(\Reg_File[4][7] ) );
  SDFFRQX2M \Reg_File_reg[4][6]  ( .D(n223), .SI(\Reg_File[4][5] ), .SE(n629), 
        .CK(CLK_regfile), .RN(n488), .Q(\Reg_File[4][6] ) );
  SDFFRQX2M \Reg_File_reg[4][5]  ( .D(n222), .SI(\Reg_File[4][4] ), .SE(n629), 
        .CK(CLK_regfile), .RN(n488), .Q(\Reg_File[4][5] ) );
  SDFFRQX2M \Reg_File_reg[4][4]  ( .D(n221), .SI(\Reg_File[4][3] ), .SE(n628), 
        .CK(CLK_regfile), .RN(n488), .Q(\Reg_File[4][4] ) );
  SDFFRQX2M \Reg_File_reg[4][3]  ( .D(n220), .SI(\Reg_File[4][2] ), .SE(n628), 
        .CK(CLK_regfile), .RN(n488), .Q(\Reg_File[4][3] ) );
  SDFFRQX2M \Reg_File_reg[4][2]  ( .D(n219), .SI(\Reg_File[4][1] ), .SE(n627), 
        .CK(CLK_regfile), .RN(n488), .Q(\Reg_File[4][2] ) );
  SDFFRQX2M \Reg_File_reg[4][1]  ( .D(n218), .SI(\Reg_File[4][0] ), .SE(n627), 
        .CK(CLK_regfile), .RN(n488), .Q(\Reg_File[4][1] ) );
  SDFFRQX2M \Reg_File_reg[4][0]  ( .D(n217), .SI(n665), .SE(n626), .CK(
        CLK_regfile), .RN(n488), .Q(\Reg_File[4][0] ) );
  SDFFRQX2M \Reg_File_reg[15][7]  ( .D(n312), .SI(\Reg_File[15][6] ), .SE(n626), .CK(CLK_regfile), .RN(n495), .Q(\Reg_File[15][7] ) );
  SDFFRQX2M \Reg_File_reg[15][6]  ( .D(n311), .SI(\Reg_File[15][5] ), .SE(n625), .CK(CLK_regfile), .RN(n495), .Q(\Reg_File[15][6] ) );
  SDFFRQX2M \Reg_File_reg[15][5]  ( .D(n310), .SI(\Reg_File[15][4] ), .SE(n625), .CK(CLK_regfile), .RN(n495), .Q(\Reg_File[15][5] ) );
  SDFFRQX2M \Reg_File_reg[15][4]  ( .D(n309), .SI(\Reg_File[15][3] ), .SE(n624), .CK(CLK_regfile), .RN(n495), .Q(\Reg_File[15][4] ) );
  SDFFRQX2M \Reg_File_reg[15][3]  ( .D(n308), .SI(\Reg_File[15][2] ), .SE(n624), .CK(CLK_regfile), .RN(n495), .Q(\Reg_File[15][3] ) );
  SDFFRQX2M \Reg_File_reg[15][2]  ( .D(n307), .SI(\Reg_File[15][1] ), .SE(n623), .CK(CLK_regfile), .RN(n495), .Q(\Reg_File[15][2] ) );
  SDFFRQX2M \Reg_File_reg[15][1]  ( .D(n306), .SI(\Reg_File[15][0] ), .SE(n623), .CK(CLK_regfile), .RN(n495), .Q(\Reg_File[15][1] ) );
  SDFFRQX2M \Reg_File_reg[15][0]  ( .D(n305), .SI(\Reg_File[14][7] ), .SE(n622), .CK(CLK_regfile), .RN(n494), .Q(\Reg_File[15][0] ) );
  SDFFRQX2M \Reg_File_reg[11][7]  ( .D(n280), .SI(\Reg_File[11][6] ), .SE(n622), .CK(CLK_regfile), .RN(n493), .Q(\Reg_File[11][7] ) );
  SDFFRQX2M \Reg_File_reg[11][6]  ( .D(n279), .SI(test_si3), .SE(n621), .CK(
        CLK_regfile), .RN(n492), .Q(\Reg_File[11][6] ) );
  SDFFRQX2M \Reg_File_reg[11][4]  ( .D(n277), .SI(\Reg_File[11][3] ), .SE(n620), .CK(CLK_regfile), .RN(n492), .Q(\Reg_File[11][4] ) );
  SDFFRQX2M \Reg_File_reg[11][3]  ( .D(n276), .SI(\Reg_File[11][2] ), .SE(n620), .CK(CLK_regfile), .RN(n492), .Q(\Reg_File[11][3] ) );
  SDFFRQX2M \Reg_File_reg[11][2]  ( .D(n275), .SI(\Reg_File[11][1] ), .SE(n619), .CK(CLK_regfile), .RN(n492), .Q(\Reg_File[11][2] ) );
  SDFFRQX2M \Reg_File_reg[11][1]  ( .D(n274), .SI(\Reg_File[11][0] ), .SE(n619), .CK(CLK_regfile), .RN(n492), .Q(\Reg_File[11][1] ) );
  SDFFRQX2M \Reg_File_reg[11][0]  ( .D(n273), .SI(\Reg_File[10][7] ), .SE(n618), .CK(CLK_regfile), .RN(n492), .Q(\Reg_File[11][0] ) );
  SDFFRQX2M \Reg_File_reg[7][7]  ( .D(n248), .SI(\Reg_File[7][6] ), .SE(n618), 
        .CK(CLK_regfile), .RN(n490), .Q(\Reg_File[7][7] ) );
  SDFFRQX2M \Reg_File_reg[7][6]  ( .D(n247), .SI(\Reg_File[7][5] ), .SE(n617), 
        .CK(CLK_regfile), .RN(n490), .Q(\Reg_File[7][6] ) );
  SDFFRQX2M \Reg_File_reg[7][5]  ( .D(n246), .SI(\Reg_File[7][4] ), .SE(n617), 
        .CK(CLK_regfile), .RN(n490), .Q(\Reg_File[7][5] ) );
  SDFFRQX2M \Reg_File_reg[7][4]  ( .D(n245), .SI(\Reg_File[7][3] ), .SE(n616), 
        .CK(CLK_regfile), .RN(n490), .Q(\Reg_File[7][4] ) );
  SDFFRQX2M \Reg_File_reg[7][3]  ( .D(n244), .SI(\Reg_File[7][2] ), .SE(n616), 
        .CK(CLK_regfile), .RN(n490), .Q(\Reg_File[7][3] ) );
  SDFFRQX2M \Reg_File_reg[7][2]  ( .D(n243), .SI(\Reg_File[7][1] ), .SE(n615), 
        .CK(CLK_regfile), .RN(n490), .Q(\Reg_File[7][2] ) );
  SDFFRQX2M \Reg_File_reg[7][1]  ( .D(n242), .SI(\Reg_File[7][0] ), .SE(n615), 
        .CK(CLK_regfile), .RN(n490), .Q(\Reg_File[7][1] ) );
  SDFFRQX2M \Reg_File_reg[7][0]  ( .D(n241), .SI(\Reg_File[6][7] ), .SE(n614), 
        .CK(CLK_regfile), .RN(n489), .Q(\Reg_File[7][0] ) );
  SDFFRQX2M \Reg_File_reg[5][7]  ( .D(n232), .SI(\Reg_File[5][6] ), .SE(n614), 
        .CK(CLK_regfile), .RN(n489), .Q(\Reg_File[5][7] ) );
  SDFFRQX2M \Reg_File_reg[5][6]  ( .D(n231), .SI(\Reg_File[5][5] ), .SE(n613), 
        .CK(CLK_regfile), .RN(n489), .Q(\Reg_File[5][6] ) );
  SDFFRQX2M \Reg_File_reg[5][5]  ( .D(n230), .SI(\Reg_File[5][4] ), .SE(n613), 
        .CK(CLK_regfile), .RN(n489), .Q(\Reg_File[5][5] ) );
  SDFFRQX2M \Reg_File_reg[5][4]  ( .D(n229), .SI(\Reg_File[5][3] ), .SE(n612), 
        .CK(CLK_regfile), .RN(n489), .Q(\Reg_File[5][4] ) );
  SDFFRQX2M \Reg_File_reg[5][3]  ( .D(n228), .SI(\Reg_File[5][2] ), .SE(n612), 
        .CK(CLK_regfile), .RN(n488), .Q(\Reg_File[5][3] ) );
  SDFFRQX2M \Reg_File_reg[5][2]  ( .D(n227), .SI(\Reg_File[5][1] ), .SE(n611), 
        .CK(CLK_regfile), .RN(n488), .Q(\Reg_File[5][2] ) );
  SDFFRQX2M \Reg_File_reg[5][1]  ( .D(n226), .SI(\Reg_File[5][0] ), .SE(n611), 
        .CK(CLK_regfile), .RN(n488), .Q(\Reg_File[5][1] ) );
  SDFFRQX2M \Reg_File_reg[5][0]  ( .D(n225), .SI(\Reg_File[4][7] ), .SE(n610), 
        .CK(CLK_regfile), .RN(n488), .Q(\Reg_File[5][0] ) );
  SDFFRQX2M \Reg_File_reg[6][7]  ( .D(n240), .SI(\Reg_File[6][6] ), .SE(n610), 
        .CK(CLK_regfile), .RN(n489), .Q(\Reg_File[6][7] ) );
  SDFFRQX2M \Reg_File_reg[6][6]  ( .D(n239), .SI(\Reg_File[6][5] ), .SE(n609), 
        .CK(CLK_regfile), .RN(n489), .Q(\Reg_File[6][6] ) );
  SDFFRQX2M \Reg_File_reg[6][5]  ( .D(n238), .SI(\Reg_File[6][4] ), .SE(n609), 
        .CK(CLK_regfile), .RN(n489), .Q(\Reg_File[6][5] ) );
  SDFFRQX2M \Reg_File_reg[6][4]  ( .D(n237), .SI(\Reg_File[6][3] ), .SE(n608), 
        .CK(CLK_regfile), .RN(n489), .Q(\Reg_File[6][4] ) );
  SDFFRQX2M \Reg_File_reg[6][3]  ( .D(n236), .SI(\Reg_File[6][2] ), .SE(n608), 
        .CK(CLK_regfile), .RN(n489), .Q(\Reg_File[6][3] ) );
  SDFFRQX2M \Reg_File_reg[6][2]  ( .D(n235), .SI(\Reg_File[6][1] ), .SE(n607), 
        .CK(CLK_regfile), .RN(n489), .Q(\Reg_File[6][2] ) );
  SDFFRQX2M \Reg_File_reg[6][1]  ( .D(n234), .SI(\Reg_File[6][0] ), .SE(n607), 
        .CK(CLK_regfile), .RN(n489), .Q(\Reg_File[6][1] ) );
  SDFFRQX2M \Reg_File_reg[6][0]  ( .D(n233), .SI(\Reg_File[5][7] ), .SE(n606), 
        .CK(CLK_regfile), .RN(n489), .Q(\Reg_File[6][0] ) );
  SDFFRQX2M \Reg_File_reg[1][7]  ( .D(n200), .SI(REG1[6]), .SE(n606), .CK(
        CLK_regfile), .RN(n486), .Q(REG1[7]) );
  SDFFRQX2M \Reg_File_reg[1][6]  ( .D(n199), .SI(n511), .SE(n605), .CK(
        CLK_regfile), .RN(n486), .Q(REG1[6]) );
  SDFFRQX2M \Reg_File_reg[1][1]  ( .D(n194), .SI(n513), .SE(n605), .CK(
        CLK_regfile), .RN(n486), .Q(REG1[1]) );
  SDFFRQX2M \Reg_File_reg[0][0]  ( .D(n185), .SI(RdData[7]), .SE(n604), .CK(
        CLK_regfile), .RN(n485), .Q(REG0[0]) );
  SDFFRQX2M \Reg_File_reg[0][7]  ( .D(n192), .SI(REG0[6]), .SE(n604), .CK(
        CLK_regfile), .RN(n486), .Q(REG0[7]) );
  SDFFRQX2M \Reg_File_reg[0][6]  ( .D(n191), .SI(test_si2), .SE(n603), .CK(
        CLK_regfile), .RN(n486), .Q(REG0[6]) );
  SDFFRQX2M \Reg_File_reg[0][4]  ( .D(n189), .SI(REG0[3]), .SE(n602), .CK(
        CLK_regfile), .RN(n486), .Q(REG0[4]) );
  SDFFRQX2M \Reg_File_reg[0][3]  ( .D(n188), .SI(REG0[2]), .SE(n602), .CK(
        CLK_regfile), .RN(n486), .Q(REG0[3]) );
  SDFFRQX2M \Reg_File_reg[0][2]  ( .D(n187), .SI(REG0[1]), .SE(n601), .CK(
        CLK_regfile), .RN(n485), .Q(REG0[2]) );
  SDFFRQX2M \Reg_File_reg[0][1]  ( .D(n186), .SI(REG0[0]), .SE(n601), .CK(
        CLK_regfile), .RN(n485), .Q(REG0[1]) );
  SDFFRQX2M \Reg_File_reg[2][1]  ( .D(n202), .SI(REG2[0]), .SE(n600), .CK(
        CLK_regfile), .RN(n487), .Q(REG2[1]) );
  SDFFSQX4M \Reg_File_reg[2][0]  ( .D(n201), .SI(REG1[7]), .SE(n662), .CK(
        CLK_regfile), .SN(n485), .Q(REG2[0]) );
  SDFFRQX2M RdData_Valid_reg ( .D(n313), .SI(test_si1), .SE(n600), .CK(
        CLK_regfile), .RN(n485), .Q(RdData_Valid) );
  SDFFRQX2M \Reg_File_reg[3][7]  ( .D(n216), .SI(REG3[6]), .SE(n599), .CK(
        CLK_regfile), .RN(n488), .Q(REG3[7]) );
  SDFFRQX2M \Reg_File_reg[2][6]  ( .D(n207), .SI(n516), .SE(n599), .CK(
        CLK_regfile), .RN(n487), .Q(n515) );
  SDFFRQX2M \Reg_File_reg[2][3]  ( .D(n204), .SI(n519), .SE(n598), .CK(
        CLK_regfile), .RN(n487), .Q(n518) );
  SDFFRQX2M \Reg_File_reg[2][5]  ( .D(n206), .SI(n517), .SE(n598), .CK(
        CLK_regfile), .RN(n487), .Q(n516) );
  SDFFRQX2M \Reg_File_reg[2][4]  ( .D(n205), .SI(n518), .SE(n597), .CK(
        CLK_regfile), .RN(n487), .Q(n517) );
  SDFFSQX2M \Reg_File_reg[2][7]  ( .D(n208), .SI(n515), .SE(n663), .CK(
        CLK_regfile), .SN(n485), .Q(n514) );
  SDFFRQX2M \Reg_File_reg[2][2]  ( .D(n203), .SI(n664), .SE(n597), .CK(
        CLK_regfile), .RN(n487), .Q(n519) );
  SDFFRQX2M \Reg_File_reg[1][5]  ( .D(n198), .SI(n512), .SE(n596), .CK(
        CLK_regfile), .RN(n486), .Q(n511) );
  SDFFRQX2M \Reg_File_reg[1][0]  ( .D(n193), .SI(REG0[7]), .SE(n596), .CK(
        CLK_regfile), .RN(n486), .Q(n513) );
  SDFFRQX2M \Reg_File_reg[1][4]  ( .D(n197), .SI(REG1[3]), .SE(n595), .CK(
        CLK_regfile), .RN(n486), .Q(n512) );
  BUFX10M U140 ( .A(n516), .Y(REG2[5]) );
  NOR2X6M U141 ( .A(N11), .B(N12), .Y(n138) );
  NOR2X2M U142 ( .A(n434), .B(n435), .Y(n422) );
  NOR2X2M U143 ( .A(n435), .B(N12), .Y(n424) );
  NOR2X2M U144 ( .A(n434), .B(N11), .Y(n423) );
  INVX6M U145 ( .A(n145), .Y(REG2[2]) );
  INVXLM U146 ( .A(n512), .Y(n139) );
  INVX6M U147 ( .A(n139), .Y(REG1[4]) );
  INVXLM U148 ( .A(n511), .Y(n141) );
  INVX6M U149 ( .A(n141), .Y(REG1[5]) );
  INVXLM U150 ( .A(n513), .Y(n143) );
  INVX6M U151 ( .A(n143), .Y(REG1[0]) );
  INVXLM U152 ( .A(n519), .Y(n145) );
  BUFX10M U165 ( .A(n514), .Y(REG2[7]) );
  BUFX10M U166 ( .A(n517), .Y(REG2[4]) );
  CLKINVX1M U167 ( .A(N11), .Y(n435) );
  NAND2X4M U168 ( .A(N14), .B(n433), .Y(n413) );
  NAND2X4M U169 ( .A(N13), .B(n432), .Y(n425) );
  CLKINVX1M U170 ( .A(N14), .Y(n432) );
  BUFX10M U171 ( .A(n518), .Y(REG2[3]) );
  BUFX10M U172 ( .A(n515), .Y(REG2[6]) );
  NAND2X4M U173 ( .A(N14), .B(N13), .Y(n416) );
  NAND2X4M U174 ( .A(n433), .B(n432), .Y(n419) );
  CLKINVX1M U175 ( .A(N11), .Y(n501) );
  NOR2X4M U176 ( .A(n434), .B(N13), .Y(n156) );
  NOR2BX2M U177 ( .AN(n165), .B(N14), .Y(n163) );
  NOR2X4M U178 ( .A(N12), .B(N13), .Y(n151) );
  NOR2BX4M U179 ( .AN(n175), .B(N11), .Y(n167) );
  NOR2BX4M U180 ( .AN(n163), .B(N11), .Y(n152) );
  NOR2BX4M U181 ( .AN(N13), .B(n434), .Y(n162) );
  NOR2BX4M U182 ( .AN(N13), .B(N12), .Y(n159) );
  INVX8M U183 ( .A(WrData[7]), .Y(n509) );
  CLKBUFX6M U184 ( .A(n436), .Y(n438) );
  BUFX4M U185 ( .A(n422), .Y(n437) );
  CLKBUFX8M U186 ( .A(n499), .Y(n485) );
  CLKBUFX8M U187 ( .A(n498), .Y(n487) );
  CLKBUFX8M U188 ( .A(n498), .Y(n488) );
  CLKBUFX8M U189 ( .A(n498), .Y(n489) );
  CLKBUFX8M U190 ( .A(n497), .Y(n490) );
  CLKBUFX8M U191 ( .A(n497), .Y(n491) );
  CLKBUFX8M U192 ( .A(n497), .Y(n492) );
  CLKBUFX8M U193 ( .A(n496), .Y(n493) );
  CLKBUFX8M U194 ( .A(n496), .Y(n494) );
  CLKBUFX8M U195 ( .A(n499), .Y(n486) );
  BUFX4M U196 ( .A(n496), .Y(n495) );
  CLKBUFX6M U197 ( .A(n423), .Y(n442) );
  CLKBUFX6M U198 ( .A(n449), .Y(n450) );
  CLKBUFX6M U199 ( .A(n444), .Y(n446) );
  CLKBUFX6M U200 ( .A(n436), .Y(n439) );
  BUFX2M U201 ( .A(n422), .Y(n436) );
  BUFX4M U202 ( .A(n440), .Y(n441) );
  BUFX4M U203 ( .A(n424), .Y(n445) );
  BUFX4M U204 ( .A(n153), .Y(n482) );
  BUFX4M U205 ( .A(n168), .Y(n466) );
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
        CLK_regfile), .RN(n486), .Q(REG1[3]) );
  SDFFRQX4M \Reg_File_reg[1][2]  ( .D(n195), .SI(REG1[1]), .SE(n662), .CK(
        CLK_regfile), .RN(n486), .Q(REG1[2]) );
  SDFFRQX4M \Reg_File_reg[3][4]  ( .D(n213), .SI(REG3[3]), .SE(n661), .CK(
        CLK_regfile), .RN(n487), .Q(REG3[4]) );
  SDFFRQX4M \Reg_File_reg[3][3]  ( .D(n212), .SI(REG3[2]), .SE(n660), .CK(
        CLK_regfile), .RN(n487), .Q(REG3[3]) );
  SDFFRQX4M \Reg_File_reg[3][6]  ( .D(n215), .SI(REG3[5]), .SE(n660), .CK(
        CLK_regfile), .RN(n487), .Q(REG3[6]) );
  SDFFSQX4M \Reg_File_reg[3][5]  ( .D(n214), .SI(REG3[4]), .SE(n663), .CK(
        CLK_regfile), .SN(n485), .Q(REG3[5]) );
  SDFFRQX4M \Reg_File_reg[3][0]  ( .D(n209), .SI(n514), .SE(n659), .CK(
        CLK_regfile), .RN(n487), .Q(REG3[0]) );
  SDFFRQX4M \Reg_File_reg[3][1]  ( .D(n210), .SI(REG3[0]), .SE(n659), .CK(
        CLK_regfile), .RN(n487), .Q(REG3[1]) );
  SDFFRQX4M \Reg_File_reg[3][2]  ( .D(n211), .SI(REG3[1]), .SE(n658), .CK(
        CLK_regfile), .RN(n487), .Q(REG3[2]) );
  SDFFRQX4M \Reg_File_reg[0][5]  ( .D(n190), .SI(REG0[4]), .SE(n603), .CK(
        CLK_regfile), .RN(n486), .Q(REG0[5]) );
  SDFFRQX4M \Reg_File_reg[11][5]  ( .D(n278), .SI(\Reg_File[11][4] ), .SE(n621), .CK(CLK_regfile), .RN(n492), .Q(\Reg_File[11][5] ) );
  BUFX2M U3 ( .A(n575), .Y(n621) );
  BUFX2M U4 ( .A(n566), .Y(n603) );
  BUFX2M U5 ( .A(n562), .Y(n662) );
  BUFX2M U6 ( .A(n595), .Y(n661) );
endmodule


module Alu_16_bit_OPER_WIDTH8_OUT_WIDTH16_ALU_FUN_WIDTH4_DW_div_uns_0 ( a, b, 
        quotient, remainder, divide_by_0 );
  input [7:0] a;
  input [7:0] b;
  output [7:0] quotient;
  output [7:0] remainder;
  output divide_by_0;
  wire   \u_div/SumTmp[1][0] , \u_div/SumTmp[1][1] , \u_div/SumTmp[1][2] ,
         \u_div/SumTmp[1][3] , \u_div/SumTmp[1][4] , \u_div/SumTmp[1][5] ,
         \u_div/SumTmp[1][6] , \u_div/SumTmp[2][0] , \u_div/SumTmp[2][1] ,
         \u_div/SumTmp[2][2] , \u_div/SumTmp[2][3] , \u_div/SumTmp[2][4] ,
         \u_div/SumTmp[2][5] , \u_div/SumTmp[3][0] , \u_div/SumTmp[3][1] ,
         \u_div/SumTmp[3][2] , \u_div/SumTmp[3][3] , \u_div/SumTmp[3][4] ,
         \u_div/SumTmp[4][0] , \u_div/SumTmp[4][1] , \u_div/SumTmp[4][2] ,
         \u_div/SumTmp[4][3] , \u_div/SumTmp[5][0] , \u_div/SumTmp[5][1] ,
         \u_div/SumTmp[5][2] , \u_div/SumTmp[6][0] , \u_div/SumTmp[6][1] ,
         \u_div/SumTmp[7][0] , \u_div/CryTmp[0][1] , \u_div/CryTmp[0][2] ,
         \u_div/CryTmp[0][3] , \u_div/CryTmp[0][4] , \u_div/CryTmp[0][5] ,
         \u_div/CryTmp[0][6] , \u_div/CryTmp[0][7] , \u_div/CryTmp[1][1] ,
         \u_div/CryTmp[1][2] , \u_div/CryTmp[1][3] , \u_div/CryTmp[1][4] ,
         \u_div/CryTmp[1][5] , \u_div/CryTmp[1][6] , \u_div/CryTmp[1][7] ,
         \u_div/CryTmp[2][1] , \u_div/CryTmp[2][2] , \u_div/CryTmp[2][3] ,
         \u_div/CryTmp[2][4] , \u_div/CryTmp[2][5] , \u_div/CryTmp[2][6] ,
         \u_div/CryTmp[3][1] , \u_div/CryTmp[3][2] , \u_div/CryTmp[3][3] ,
         \u_div/CryTmp[3][4] , \u_div/CryTmp[3][5] , \u_div/CryTmp[4][1] ,
         \u_div/CryTmp[4][2] , \u_div/CryTmp[4][3] , \u_div/CryTmp[4][4] ,
         \u_div/CryTmp[5][1] , \u_div/CryTmp[5][2] , \u_div/CryTmp[5][3] ,
         \u_div/CryTmp[6][1] , \u_div/CryTmp[6][2] , \u_div/CryTmp[7][1] ,
         \u_div/PartRem[1][1] , \u_div/PartRem[1][2] , \u_div/PartRem[1][3] ,
         \u_div/PartRem[1][4] , \u_div/PartRem[1][5] , \u_div/PartRem[1][6] ,
         \u_div/PartRem[1][7] , \u_div/PartRem[2][1] , \u_div/PartRem[2][2] ,
         \u_div/PartRem[2][3] , \u_div/PartRem[2][4] , \u_div/PartRem[2][5] ,
         \u_div/PartRem[2][6] , \u_div/PartRem[3][1] , \u_div/PartRem[3][2] ,
         \u_div/PartRem[3][3] , \u_div/PartRem[3][4] , \u_div/PartRem[3][5] ,
         \u_div/PartRem[4][1] , \u_div/PartRem[4][2] , \u_div/PartRem[4][3] ,
         \u_div/PartRem[4][4] , \u_div/PartRem[5][1] , \u_div/PartRem[5][2] ,
         \u_div/PartRem[5][3] , \u_div/PartRem[6][1] , \u_div/PartRem[6][2] ,
         \u_div/PartRem[7][1] , n1, n2, n3, n4, n5, n6, n7, n8, n9, n10, n11;

  ADDFX2M \u_div/u_fa_PartRem_0_2_5  ( .A(\u_div/PartRem[3][5] ), .B(n3), .CI(
        \u_div/CryTmp[2][5] ), .CO(\u_div/CryTmp[2][6] ), .S(
        \u_div/SumTmp[2][5] ) );
  ADDFX2M \u_div/u_fa_PartRem_0_4_3  ( .A(\u_div/PartRem[5][3] ), .B(n5), .CI(
        \u_div/CryTmp[4][3] ), .CO(\u_div/CryTmp[4][4] ), .S(
        \u_div/SumTmp[4][3] ) );
  ADDFX2M \u_div/u_fa_PartRem_0_3_4  ( .A(\u_div/PartRem[4][4] ), .B(n4), .CI(
        \u_div/CryTmp[3][4] ), .CO(\u_div/CryTmp[3][5] ), .S(
        \u_div/SumTmp[3][4] ) );
  ADDFX2M \u_div/u_fa_PartRem_0_5_2  ( .A(\u_div/PartRem[6][2] ), .B(n6), .CI(
        \u_div/CryTmp[5][2] ), .CO(\u_div/CryTmp[5][3] ), .S(
        \u_div/SumTmp[5][2] ) );
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
  XNOR2X2M U35 ( .A(n8), .B(a[6]), .Y(\u_div/SumTmp[6][0] ) );
  XNOR2X2M U36 ( .A(n8), .B(a[7]), .Y(\u_div/SumTmp[7][0] ) );
  INVX4M U37 ( .A(b[1]), .Y(n7) );
  XNOR2X2M U38 ( .A(n8), .B(a[1]), .Y(\u_div/SumTmp[1][0] ) );
  INVX2M U39 ( .A(b[6]), .Y(n2) );
  INVX2M U40 ( .A(b[7]), .Y(n1) );
  OR2X2M U41 ( .A(a[5]), .B(n8), .Y(\u_div/CryTmp[5][1] ) );
  OR2X2M U42 ( .A(a[4]), .B(n8), .Y(\u_div/CryTmp[4][1] ) );
  OR2X2M U43 ( .A(a[3]), .B(n8), .Y(\u_div/CryTmp[3][1] ) );
  OR2X2M U44 ( .A(a[2]), .B(n8), .Y(\u_div/CryTmp[2][1] ) );
  OR2X2M U45 ( .A(a[1]), .B(n8), .Y(\u_div/CryTmp[1][1] ) );
  NAND2BX2M U46 ( .AN(a[0]), .B(b[0]), .Y(\u_div/CryTmp[0][1] ) );
  OR2X2M U47 ( .A(a[6]), .B(n8), .Y(\u_div/CryTmp[6][1] ) );
  INVX4M U48 ( .A(b[3]), .Y(n5) );
  INVX4M U49 ( .A(b[5]), .Y(n3) );
  CLKMX2X2M U50 ( .A(\u_div/PartRem[7][1] ), .B(\u_div/SumTmp[6][1] ), .S0(
        quotient[6]), .Y(\u_div/PartRem[6][2] ) );
  CLKMX2X2M U51 ( .A(a[7]), .B(\u_div/SumTmp[7][0] ), .S0(quotient[7]), .Y(
        \u_div/PartRem[7][1] ) );
  CLKMX2X2M U52 ( .A(a[6]), .B(\u_div/SumTmp[6][0] ), .S0(quotient[6]), .Y(
        \u_div/PartRem[6][1] ) );
  CLKMX2X2M U53 ( .A(\u_div/PartRem[2][4] ), .B(\u_div/SumTmp[1][4] ), .S0(
        quotient[1]), .Y(\u_div/PartRem[1][5] ) );
  CLKMX2X2M U54 ( .A(a[5]), .B(\u_div/SumTmp[5][0] ), .S0(quotient[5]), .Y(
        \u_div/PartRem[5][1] ) );
  CLKMX2X2M U55 ( .A(a[4]), .B(\u_div/SumTmp[4][0] ), .S0(quotient[4]), .Y(
        \u_div/PartRem[4][1] ) );
  CLKMX2X2M U56 ( .A(a[3]), .B(\u_div/SumTmp[3][0] ), .S0(quotient[3]), .Y(
        \u_div/PartRem[3][1] ) );
  CLKMX2X2M U57 ( .A(\u_div/PartRem[2][1] ), .B(\u_div/SumTmp[1][1] ), .S0(
        quotient[1]), .Y(\u_div/PartRem[1][2] ) );
  CLKMX2X2M U58 ( .A(a[2]), .B(\u_div/SumTmp[2][0] ), .S0(quotient[2]), .Y(
        \u_div/PartRem[2][1] ) );
  CLKMX2X2M U59 ( .A(a[1]), .B(\u_div/SumTmp[1][0] ), .S0(quotient[1]), .Y(
        \u_div/PartRem[1][1] ) );
  AND4X1M U60 ( .A(\u_div/CryTmp[7][1] ), .B(n9), .C(n7), .D(n6), .Y(
        quotient[7]) );
  AND3X1M U61 ( .A(n11), .B(n4), .C(n3), .Y(n10) );
endmodule


module Alu_16_bit_OPER_WIDTH8_OUT_WIDTH16_ALU_FUN_WIDTH4_DW01_sub_0 ( A, B, CI, 
        DIFF, CO );
  input [8:0] A;
  input [8:0] B;
  output [8:0] DIFF;
  input CI;
  output CO;
  wire   n1, n2, n3, n4, n5, n6, n7, n8;
  wire   [9:0] carry;

  ADDFX2M U2_5 ( .A(A[5]), .B(n3), .CI(carry[5]), .CO(carry[6]), .S(DIFF[5])
         );
  ADDFX2M U2_4 ( .A(A[4]), .B(n4), .CI(carry[4]), .CO(carry[5]), .S(DIFF[4])
         );
  ADDFX2M U2_3 ( .A(A[3]), .B(n5), .CI(carry[3]), .CO(carry[4]), .S(DIFF[3])
         );
  ADDFX2M U2_2 ( .A(A[2]), .B(n6), .CI(carry[2]), .CO(carry[3]), .S(DIFF[2])
         );
  ADDFX2M U2_7 ( .A(A[7]), .B(n1), .CI(carry[7]), .CO(carry[8]), .S(DIFF[7])
         );
  ADDFX2M U2_6 ( .A(A[6]), .B(n2), .CI(carry[6]), .CO(carry[7]), .S(DIFF[6])
         );
  ADDFX2M U2_1 ( .A(A[1]), .B(n7), .CI(carry[1]), .CO(carry[2]), .S(DIFF[1])
         );
  XNOR2X2M U1 ( .A(n8), .B(A[0]), .Y(DIFF[0]) );
  OR2X2M U2 ( .A(A[0]), .B(n8), .Y(carry[1]) );
  INVX2M U3 ( .A(B[1]), .Y(n7) );
  INVX2M U4 ( .A(B[6]), .Y(n2) );
  INVX2M U5 ( .A(B[7]), .Y(n1) );
  INVX2M U6 ( .A(B[0]), .Y(n8) );
  INVX2M U7 ( .A(B[2]), .Y(n6) );
  INVX2M U8 ( .A(B[3]), .Y(n5) );
  INVX2M U9 ( .A(B[4]), .Y(n4) );
  INVX2M U10 ( .A(B[5]), .Y(n3) );
  CLKINVX1M U11 ( .A(carry[8]), .Y(DIFF[8]) );
endmodule


module Alu_16_bit_OPER_WIDTH8_OUT_WIDTH16_ALU_FUN_WIDTH4_DW01_add_0 ( A, B, CI, 
        SUM, CO );
  input [8:0] A;
  input [8:0] B;
  output [8:0] SUM;
  input CI;
  output CO;
  wire   n1;
  wire   [8:1] carry;

  ADDFX2M U1_1 ( .A(A[1]), .B(B[1]), .CI(n1), .CO(carry[2]), .S(SUM[1]) );
  ADDFX2M U1_2 ( .A(A[2]), .B(B[2]), .CI(carry[2]), .CO(carry[3]), .S(SUM[2])
         );
  ADDFX2M U1_3 ( .A(A[3]), .B(B[3]), .CI(carry[3]), .CO(carry[4]), .S(SUM[3])
         );
  ADDFX2M U1_4 ( .A(A[4]), .B(B[4]), .CI(carry[4]), .CO(carry[5]), .S(SUM[4])
         );
  ADDFX2M U1_5 ( .A(A[5]), .B(B[5]), .CI(carry[5]), .CO(carry[6]), .S(SUM[5])
         );
  ADDFX2M U1_7 ( .A(A[7]), .B(B[7]), .CI(carry[7]), .CO(SUM[8]), .S(SUM[7]) );
  ADDFX2M U1_6 ( .A(A[6]), .B(B[6]), .CI(carry[6]), .CO(carry[7]), .S(SUM[6])
         );
  AND2X2M U1 ( .A(B[0]), .B(A[0]), .Y(n1) );
  CLKXOR2X2M U2 ( .A(B[0]), .B(A[0]), .Y(SUM[0]) );
endmodule


module Alu_16_bit_OPER_WIDTH8_OUT_WIDTH16_ALU_FUN_WIDTH4_DW01_add_1 ( A, B, CI, 
        SUM, CO );
  input [13:0] A;
  input [13:0] B;
  output [13:0] SUM;
  input CI;
  output CO;
  wire   n7, n8, n9, n10, n11, n12, n13, n14, n15, n16, n17, n18, n19, n20,
         n21, n22, n23, n24, n25, n26;

  OAI21BX4M U2 ( .A0(n19), .A1(n20), .B0N(n21), .Y(n17) );
  AOI2BB1X2M U3 ( .A0N(n8), .A1N(n11), .B0(n10), .Y(n24) );
  NOR2X2M U4 ( .A(B[11]), .B(A[11]), .Y(n19) );
  NOR2X2M U5 ( .A(B[9]), .B(A[9]), .Y(n11) );
  NOR2X2M U6 ( .A(B[10]), .B(A[10]), .Y(n23) );
  NOR2X2M U7 ( .A(B[8]), .B(A[8]), .Y(n14) );
  CLKXOR2X2M U8 ( .A(A[7]), .B(B[7]), .Y(SUM[7]) );
  CLKXOR2X2M U9 ( .A(B[13]), .B(n16), .Y(SUM[13]) );
  NAND2X2M U10 ( .A(A[7]), .B(B[7]), .Y(n13) );
  INVX2M U11 ( .A(n7), .Y(SUM[6]) );
  INVX2M U12 ( .A(A[6]), .Y(n7) );
  BUFX2M U13 ( .A(A[0]), .Y(SUM[0]) );
  BUFX2M U14 ( .A(A[1]), .Y(SUM[1]) );
  BUFX2M U15 ( .A(A[2]), .Y(SUM[2]) );
  BUFX2M U16 ( .A(A[3]), .Y(SUM[3]) );
  BUFX2M U17 ( .A(A[4]), .Y(SUM[4]) );
  BUFX2M U18 ( .A(A[5]), .Y(SUM[5]) );
  XNOR2X1M U19 ( .A(n8), .B(n9), .Y(SUM[9]) );
  NOR2X1M U20 ( .A(n10), .B(n11), .Y(n9) );
  CLKXOR2X2M U21 ( .A(n12), .B(n13), .Y(SUM[8]) );
  NAND2BX1M U22 ( .AN(n14), .B(n15), .Y(n12) );
  OAI2BB1X1M U23 ( .A0N(n17), .A1N(A[12]), .B0(n18), .Y(n16) );
  OAI21X1M U24 ( .A0(A[12]), .A1(n17), .B0(B[12]), .Y(n18) );
  XOR3XLM U25 ( .A(B[12]), .B(A[12]), .C(n17), .Y(SUM[12]) );
  XNOR2X1M U26 ( .A(n20), .B(n22), .Y(SUM[11]) );
  NOR2X1M U27 ( .A(n21), .B(n19), .Y(n22) );
  AND2X1M U28 ( .A(B[11]), .B(A[11]), .Y(n21) );
  OA21X1M U29 ( .A0(n23), .A1(n24), .B0(n25), .Y(n20) );
  CLKXOR2X2M U30 ( .A(n26), .B(n24), .Y(SUM[10]) );
  AND2X1M U31 ( .A(B[9]), .B(A[9]), .Y(n10) );
  OA21X1M U32 ( .A0(n13), .A1(n14), .B0(n15), .Y(n8) );
  CLKNAND2X2M U33 ( .A(B[8]), .B(A[8]), .Y(n15) );
  NAND2BX1M U34 ( .AN(n23), .B(n25), .Y(n26) );
  CLKNAND2X2M U35 ( .A(B[10]), .B(A[10]), .Y(n25) );
endmodule


module Alu_16_bit_OPER_WIDTH8_OUT_WIDTH16_ALU_FUN_WIDTH4_DW02_mult_0 ( A, B, 
        TC, PRODUCT );
  input [7:0] A;
  input [7:0] B;
  output [15:0] PRODUCT;
  input TC;
  wire   \ab[7][7] , \ab[7][6] , \ab[7][5] , \ab[7][4] , \ab[7][3] ,
         \ab[7][2] , \ab[7][1] , \ab[7][0] , \ab[6][7] , \ab[6][6] ,
         \ab[6][5] , \ab[6][4] , \ab[6][3] , \ab[6][2] , \ab[6][1] ,
         \ab[6][0] , \ab[5][7] , \ab[5][6] , \ab[5][5] , \ab[5][4] ,
         \ab[5][3] , \ab[5][2] , \ab[5][1] , \ab[5][0] , \ab[4][7] ,
         \ab[4][6] , \ab[4][5] , \ab[4][4] , \ab[4][3] , \ab[4][2] ,
         \ab[4][1] , \ab[4][0] , \ab[3][7] , \ab[3][6] , \ab[3][5] ,
         \ab[3][4] , \ab[3][3] , \ab[3][2] , \ab[3][1] , \ab[3][0] ,
         \ab[2][7] , \ab[2][6] , \ab[2][5] , \ab[2][4] , \ab[2][3] ,
         \ab[2][2] , \ab[2][1] , \ab[2][0] , \ab[1][7] , \ab[1][6] ,
         \ab[1][5] , \ab[1][4] , \ab[1][3] , \ab[1][2] , \ab[1][1] ,
         \ab[1][0] , \ab[0][7] , \ab[0][6] , \ab[0][5] , \ab[0][4] ,
         \ab[0][3] , \ab[0][2] , \ab[0][1] , \CARRYB[7][6] , \CARRYB[7][5] ,
         \CARRYB[7][4] , \CARRYB[7][3] , \CARRYB[7][2] , \CARRYB[7][1] ,
         \CARRYB[7][0] , \CARRYB[6][6] , \CARRYB[6][5] , \CARRYB[6][4] ,
         \CARRYB[6][3] , \CARRYB[6][2] , \CARRYB[6][1] , \CARRYB[6][0] ,
         \CARRYB[5][6] , \CARRYB[5][5] , \CARRYB[5][4] , \CARRYB[5][3] ,
         \CARRYB[5][2] , \CARRYB[5][1] , \CARRYB[5][0] , \CARRYB[4][6] ,
         \CARRYB[4][5] , \CARRYB[4][4] , \CARRYB[4][3] , \CARRYB[4][2] ,
         \CARRYB[4][1] , \CARRYB[4][0] , \CARRYB[3][6] , \CARRYB[3][5] ,
         \CARRYB[3][4] , \CARRYB[3][3] , \CARRYB[3][2] , \CARRYB[3][1] ,
         \CARRYB[3][0] , \CARRYB[2][6] , \CARRYB[2][5] , \CARRYB[2][4] ,
         \CARRYB[2][3] , \CARRYB[2][2] , \CARRYB[2][1] , \CARRYB[2][0] ,
         \SUMB[7][6] , \SUMB[7][5] , \SUMB[7][4] , \SUMB[7][3] , \SUMB[7][2] ,
         \SUMB[7][1] , \SUMB[7][0] , \SUMB[6][6] , \SUMB[6][5] , \SUMB[6][4] ,
         \SUMB[6][3] , \SUMB[6][2] , \SUMB[6][1] , \SUMB[5][6] , \SUMB[5][5] ,
         \SUMB[5][4] , \SUMB[5][3] , \SUMB[5][2] , \SUMB[5][1] , \SUMB[4][6] ,
         \SUMB[4][5] , \SUMB[4][4] , \SUMB[4][3] , \SUMB[4][2] , \SUMB[4][1] ,
         \SUMB[3][6] , \SUMB[3][5] , \SUMB[3][4] , \SUMB[3][3] , \SUMB[3][2] ,
         \SUMB[3][1] , \SUMB[2][6] , \SUMB[2][5] , \SUMB[2][4] , \SUMB[2][3] ,
         \SUMB[2][2] , \SUMB[2][1] , \SUMB[1][6] , \SUMB[1][5] , \SUMB[1][4] ,
         \SUMB[1][3] , \SUMB[1][2] , \SUMB[1][1] , \A1[12] , \A1[11] ,
         \A1[10] , \A1[9] , \A1[8] , \A1[7] , \A1[6] , \A1[4] , \A1[3] ,
         \A1[2] , \A1[1] , \A1[0] , n3, n4, n5, n6, n7, n8, n9, n10, n11, n12,
         n13, n14, n15, n16, n17, n18, n19, n20, n21, n22, n23, n24, n25, n26,
         n27, n28, n29, n30, n31, n32;

  ADDFX2M S1_6_0 ( .A(\ab[6][0] ), .B(\CARRYB[5][0] ), .CI(\SUMB[5][1] ), .CO(
        \CARRYB[6][0] ), .S(\A1[4] ) );
  ADDFX2M S1_5_0 ( .A(\ab[5][0] ), .B(\CARRYB[4][0] ), .CI(\SUMB[4][1] ), .CO(
        \CARRYB[5][0] ), .S(\A1[3] ) );
  ADDFX2M S1_4_0 ( .A(\ab[4][0] ), .B(\CARRYB[3][0] ), .CI(\SUMB[3][1] ), .CO(
        \CARRYB[4][0] ), .S(\A1[2] ) );
  ADDFX2M S2_6_5 ( .A(\ab[6][5] ), .B(\CARRYB[5][5] ), .CI(\SUMB[5][6] ), .CO(
        \CARRYB[6][5] ), .S(\SUMB[6][5] ) );
  ADDFX2M S1_3_0 ( .A(\ab[3][0] ), .B(\CARRYB[2][0] ), .CI(\SUMB[2][1] ), .CO(
        \CARRYB[3][0] ), .S(\A1[1] ) );
  ADDFX2M S2_6_4 ( .A(\ab[6][4] ), .B(\CARRYB[5][4] ), .CI(\SUMB[5][5] ), .CO(
        \CARRYB[6][4] ), .S(\SUMB[6][4] ) );
  ADDFX2M S2_5_5 ( .A(\ab[5][5] ), .B(\CARRYB[4][5] ), .CI(\SUMB[4][6] ), .CO(
        \CARRYB[5][5] ), .S(\SUMB[5][5] ) );
  ADDFX2M S2_6_3 ( .A(\ab[6][3] ), .B(\CARRYB[5][3] ), .CI(\SUMB[5][4] ), .CO(
        \CARRYB[6][3] ), .S(\SUMB[6][3] ) );
  ADDFX2M S2_5_4 ( .A(\ab[5][4] ), .B(\CARRYB[4][4] ), .CI(\SUMB[4][5] ), .CO(
        \CARRYB[5][4] ), .S(\SUMB[5][4] ) );
  ADDFX2M S2_6_2 ( .A(\ab[6][2] ), .B(\CARRYB[5][2] ), .CI(\SUMB[5][3] ), .CO(
        \CARRYB[6][2] ), .S(\SUMB[6][2] ) );
  ADDFX2M S2_4_5 ( .A(\ab[4][5] ), .B(\CARRYB[3][5] ), .CI(\SUMB[3][6] ), .CO(
        \CARRYB[4][5] ), .S(\SUMB[4][5] ) );
  ADDFX2M S2_5_2 ( .A(\ab[5][2] ), .B(\CARRYB[4][2] ), .CI(\SUMB[4][3] ), .CO(
        \CARRYB[5][2] ), .S(\SUMB[5][2] ) );
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
        \A1[12] , \A1[11] , \A1[10] , \A1[9] , \A1[8] , \A1[7] , \A1[6] , 
        \SUMB[7][0] , \A1[4] , \A1[3] , \A1[2] , \A1[1] , \A1[0] }), .B({n3, 
        n14, n16, n13, n15, n12, n11, 1'b0, 1'b0, 1'b0, 1'b0, 1'b0, 1'b0, 1'b0}), .CI(1'b0), .SUM(PRODUCT[15:2]) );
endmodule
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
