Shnassar25/-Digital-IC-Design-SoC-RTL2GDS/PNR/pnr/SYS_TOP_Finish.enc.dat/SYS_TOP.v

module SYS_TOP (
	REF_CLK, 
	UART_CLK, 
	RST, 
	RX_IN, 
	SCAN_CLK, 
	SCAN_RST, 
	TEST_MODE, 
	SE, 
	SI, 
	SO, 
	TX_OUT, 
	PAR_ERR, 
	STOP_ERR, 
	test_si6);
   input REF_CLK;
   input UART_CLK;
   input RST;
   input RX_IN;
   input SCAN_CLK;
   input SCAN_RST;
   input TEST_MODE;
   input SE;
   input [4:0] SI;
   output [4:0] SO;
   output TX_OUT;
   output PAR_ERR;
   output STOP_ERR;
   input test_si6;

   // Internal wires
   wire REF_CLK__L2_N0;
   wire REF_CLK__L1_N0;
   wire UART_CLK__L2_N0;
   wire UART_CLK__L1_N0;
   wire SCAN_CLK__L19_N0;
   wire SCAN_CLK__L18_N0;
   wire SCAN_CLK__L17_N0;
   wire SCAN_CLK__L16_N0;
   wire SCAN_CLK__L15_N1;
   wire SCAN_CLK__L15_N0;
   wire SCAN_CLK__L14_N0;
   wire SCAN_CLK__L13_N0;
   wire SCAN_CLK__L12_N0;
   wire SCAN_CLK__L11_N0;
   wire SCAN_CLK__L10_N0;
   wire SCAN_CLK__L9_N0;
   wire SCAN_CLK__L8_N0;
   wire SCAN_CLK__L7_N0;
   wire SCAN_CLK__L6_N0;
   wire SCAN_CLK__L5_N0;
   wire SCAN_CLK__L4_N0;
   wire SCAN_CLK__L3_N0;
   wire SCAN_CLK__L2_N0;
   wire SCAN_CLK__L1_N0;
   wire CLK_SCAN_REF__L5_N15;
   wire CLK_SCAN_REF__L5_N14;
   wire CLK_SCAN_REF__L5_N13;
   wire CLK_SCAN_REF__L5_N12;
   wire CLK_SCAN_REF__L5_N11;
   wire CLK_SCAN_REF__L5_N10;
   wire CLK_SCAN_REF__L5_N9;
   wire CLK_SCAN_REF__L5_N8;
   wire CLK_SCAN_REF__L5_N7;
   wire CLK_SCAN_REF__L5_N6;
   wire CLK_SCAN_REF__L5_N5;
   wire CLK_SCAN_REF__L5_N4;
   wire CLK_SCAN_REF__L5_N3;
   wire CLK_SCAN_REF__L5_N2;
   wire CLK_SCAN_REF__L5_N1;
   wire CLK_SCAN_REF__L5_N0;
   wire CLK_SCAN_REF__L4_N7;
   wire CLK_SCAN_REF__L4_N6;
   wire CLK_SCAN_REF__L4_N5;
   wire CLK_SCAN_REF__L4_N4;
   wire CLK_SCAN_REF__L4_N3;
   wire CLK_SCAN_REF__L4_N2;
   wire CLK_SCAN_REF__L4_N1;
   wire CLK_SCAN_REF__L4_N0;
   wire CLK_SCAN_REF__L3_N1;
   wire CLK_SCAN_REF__L3_N0;
   wire CLK_SCAN_REF__L2_N0;
   wire CLK_SCAN_REF__L1_N1;
   wire CLK_SCAN_REF__L1_N0;
   wire ALU_CLK__L3_N0;
   wire ALU_CLK__L2_N0;
   wire ALU_CLK__L1_N0;
   wire CLK_SCAN_UART__L18_N1;
   wire CLK_SCAN_UART__L18_N0;
   wire CLK_SCAN_UART__L17_N0;
   wire CLK_SCAN_UART__L16_N0;
   wire CLK_SCAN_UART__L15_N0;
   wire CLK_SCAN_UART__L14_N0;
   wire CLK_SCAN_UART__L13_N0;
   wire CLK_SCAN_UART__L12_N0;
   wire CLK_SCAN_UART__L11_N1;
   wire CLK_SCAN_UART__L11_N0;
   wire CLK_SCAN_UART__L10_N1;
   wire CLK_SCAN_UART__L10_N0;
   wire CLK_SCAN_UART__L9_N1;
   wire CLK_SCAN_UART__L9_N0;
   wire CLK_SCAN_UART__L8_N1;
   wire CLK_SCAN_UART__L8_N0;
   wire CLK_SCAN_UART__L7_N1;
   wire CLK_SCAN_UART__L7_N0;
   wire CLK_SCAN_UART__L6_N1;
   wire CLK_SCAN_UART__L6_N0;
   wire CLK_SCAN_UART__L5_N1;
   wire CLK_SCAN_UART__L5_N0;
   wire CLK_SCAN_UART__L4_N0;
   wire CLK_SCAN_UART__L3_N0;
   wire CLK_SCAN_UART__L2_N0;
   wire CLK_SCAN_UART__L1_N0;
   wire SO_3____SRC;
   wire n24__Exclude_0_NET;
   wire TX_CLK__L1_N0;
   wire n25__Exclude_0_NET;
   wire CLK_SCAN_UART_RX__L3_N1;
   wire CLK_SCAN_UART_RX__L3_N0;
   wire CLK_SCAN_UART_RX__L2_N0;
   wire CLK_SCAN_UART_RX__L1_N0;
   wire CLK_SCAN_UART_TX__L3_N3;
   wire CLK_SCAN_UART_TX__L3_N2;
   wire CLK_SCAN_UART_TX__L3_N1;
   wire CLK_SCAN_UART_TX__L3_N0;
   wire CLK_SCAN_UART_TX__L2_N0;
   wire CLK_SCAN_UART_TX__L1_N0;
   wire FE_OFN21_SE;
   wire FE_OFN20_SE;
   wire FE_OFN19_SE;
   wire FE_OFN18_SE;
   wire FE_OFN17_SE;
   wire FE_OFN16_SE;
   wire FE_OFN15_SE;
   wire FE_OFN14_SE;
   wire FE_OFN5_RST_SCAN_UART;
   wire FE_OFN4_RST_SCAN_REF;
   wire FE_OFN3_RST_SCAN_REF;
   wire FE_OFN2_RST_SCAN_REF;
   wire FE_OFN1_RST_SCAN_REF;
   wire FE_OFN0_RST_SCAN_REF;
   wire CLK_SCAN_REF;
   wire CLK_SCAN_UART;
   wire RX_CLK;
   wire CLK_SCAN_UART_RX;
   wire TX_CLK;
   wire CLK_SCAN_UART_TX;
   wire RST_SCAN;
   wire SYNC_REF_RST;
   wire RST_SCAN_REF;
   wire SYNC_UART_RST;
   wire RST_SCAN_UART;
   wire UART_TX_BUSY;
   wire UART_TX_BUSY_PULSE;
   wire _0_net_;
   wire ALU_CLK;
   wire CLK_GATE_EN;
   wire UART_RX_VALID;
   wire UART_RX_VALID_SYNC;
   wire WR_EN;
   wire RD_EN;
   wire RD_DATA_VALID;
   wire ALU_EN;
   wire ALU_OUT_VALID;
   wire UART_TX_VALID;
   wire FIFO_FULL;
   wire UART_TX_VALID_SYNC;
   wire n1;
   wire n2;
   wire n9;
   wire n13;
   wire n14;
   wire n19;
   wire n22;
   wire n23;
   wire n24;
   wire n25;
   wire [7:0] REG3_DIV_RATIO;
   wire [7:0] PRESCALE_RX;
   wire [7:0] REG2_UART_CONFIG;
   wire [7:0] UART_RX_OUT;
   wire [7:0] UART_RX_OUT_SYNC;
   wire [7:0] WR_DATA;
   wire [3:0] WR_ADDR;
   wire [7:0] RD_DATA;
   wire [7:0] REG0_A;
   wire [7:0] REG1_B;
   wire [3:0] ALU_FUN;
   wire [15:0] ALU_RESULT;
   wire [7:0] UART_TX_IN;
   wire [7:0] UART_TX_IN_SYNC;
   wire SYNOPSYS_UNCONNECTED__0;
   wire SYNOPSYS_UNCONNECTED__1;
   wire SYNOPSYS_UNCONNECTED__2;
   wire SYNOPSYS_UNCONNECTED__3;

   assign SO[1] = REG0_A[5] ;

   CLKINVX8M REF_CLK__L2_I0 (.Y(REF_CLK__L2_N0), 
	.A(REF_CLK__L1_N0));
   CLKINVX40M REF_CLK__L1_I0 (.Y(REF_CLK__L1_N0), 
	.A(REF_CLK));
   CLKINVX16M UART_CLK__L2_I0 (.Y(UART_CLK__L2_N0), 
	.A(UART_CLK__L1_N0));
   CLKINVX40M UART_CLK__L1_I0 (.Y(UART_CLK__L1_N0), 
	.A(UART_CLK));
   CLKINVX32M SCAN_CLK__L19_I0 (.Y(SCAN_CLK__L19_N0), 
	.A(SCAN_CLK__L18_N0));
   CLKINVX40M SCAN_CLK__L18_I0 (.Y(SCAN_CLK__L18_N0), 
	.A(SCAN_CLK__L17_N0));
   CLKBUFX40M SCAN_CLK__L17_I0 (.Y(SCAN_CLK__L17_N0), 
	.A(SCAN_CLK__L16_N0));
   CLKBUFX24M SCAN_CLK__L16_I0 (.Y(SCAN_CLK__L16_N0), 
	.A(SCAN_CLK__L15_N1));
   CLKBUFX24M SCAN_CLK__L15_I1 (.Y(SCAN_CLK__L15_N1), 
	.A(SCAN_CLK__L14_N0));
   CLKBUFX24M SCAN_CLK__L15_I0 (.Y(SCAN_CLK__L15_N0), 
	.A(SCAN_CLK__L14_N0));
   CLKBUFX24M SCAN_CLK__L14_I0 (.Y(SCAN_CLK__L14_N0), 
	.A(SCAN_CLK__L13_N0));
   CLKBUFX24M SCAN_CLK__L13_I0 (.Y(SCAN_CLK__L13_N0), 
	.A(SCAN_CLK__L12_N0));
   CLKBUFX24M SCAN_CLK__L12_I0 (.Y(SCAN_CLK__L12_N0), 
	.A(SCAN_CLK__L11_N0));
   CLKBUFX24M SCAN_CLK__L11_I0 (.Y(SCAN_CLK__L11_N0), 
	.A(SCAN_CLK__L10_N0));
   CLKBUFX24M SCAN_CLK__L10_I0 (.Y(SCAN_CLK__L10_N0), 
	.A(SCAN_CLK__L9_N0));
   CLKINVX40M SCAN_CLK__L9_I0 (.Y(SCAN_CLK__L9_N0), 
	.A(SCAN_CLK__L8_N0));
   CLKBUFX24M SCAN_CLK__L8_I0 (.Y(SCAN_CLK__L8_N0), 
	.A(SCAN_CLK__L7_N0));
   CLKBUFX24M SCAN_CLK__L7_I0 (.Y(SCAN_CLK__L7_N0), 
	.A(SCAN_CLK__L6_N0));
   CLKBUFX24M SCAN_CLK__L6_I0 (.Y(SCAN_CLK__L6_N0), 
	.A(SCAN_CLK__L5_N0));
   CLKBUFX24M SCAN_CLK__L5_I0 (.Y(SCAN_CLK__L5_N0), 
	.A(SCAN_CLK__L4_N0));
   CLKBUFX24M SCAN_CLK__L4_I0 (.Y(SCAN_CLK__L4_N0), 
	.A(SCAN_CLK__L3_N0));
   CLKINVX40M SCAN_CLK__L3_I0 (.Y(SCAN_CLK__L3_N0), 
	.A(SCAN_CLK__L2_N0));
   CLKINVX40M SCAN_CLK__L2_I0 (.Y(SCAN_CLK__L2_N0), 
	.A(SCAN_CLK__L1_N0));
   CLKINVX40M SCAN_CLK__L1_I0 (.Y(SCAN_CLK__L1_N0), 
	.A(SCAN_CLK));
   CLKINVX40M CLK_SCAN_REF__L5_I15 (.Y(CLK_SCAN_REF__L5_N15), 
	.A(CLK_SCAN_REF__L4_N7));
   CLKINVX40M CLK_SCAN_REF__L5_I14 (.Y(CLK_SCAN_REF__L5_N14), 
	.A(CLK_SCAN_REF__L4_N7));
   CLKINVX40M CLK_SCAN_REF__L5_I13 (.Y(CLK_SCAN_REF__L5_N13), 
	.A(CLK_SCAN_REF__L4_N6));
   CLKINVX40M CLK_SCAN_REF__L5_I12 (.Y(CLK_SCAN_REF__L5_N12), 
	.A(CLK_SCAN_REF__L4_N6));
   CLKINVX40M CLK_SCAN_REF__L5_I11 (.Y(CLK_SCAN_REF__L5_N11), 
	.A(CLK_SCAN_REF__L4_N5));
   CLKINVX40M CLK_SCAN_REF__L5_I10 (.Y(CLK_SCAN_REF__L5_N10), 
	.A(CLK_SCAN_REF__L4_N5));
   CLKINVX40M CLK_SCAN_REF__L5_I9 (.Y(CLK_SCAN_REF__L5_N9), 
	.A(CLK_SCAN_REF__L4_N4));
   CLKINVX40M CLK_SCAN_REF__L5_I8 (.Y(CLK_SCAN_REF__L5_N8), 
	.A(CLK_SCAN_REF__L4_N4));
   CLKINVX40M CLK_SCAN_REF__L5_I7 (.Y(CLK_SCAN_REF__L5_N7), 
	.A(CLK_SCAN_REF__L4_N3));
   CLKINVX40M CLK_SCAN_REF__L5_I6 (.Y(CLK_SCAN_REF__L5_N6), 
	.A(CLK_SCAN_REF__L4_N3));
   CLKINVX40M CLK_SCAN_REF__L5_I5 (.Y(CLK_SCAN_REF__L5_N5), 
	.A(CLK_SCAN_REF__L4_N2));
   CLKINVX40M CLK_SCAN_REF__L5_I4 (.Y(CLK_SCAN_REF__L5_N4), 
	.A(CLK_SCAN_REF__L4_N2));
   CLKINVX40M CLK_SCAN_REF__L5_I3 (.Y(CLK_SCAN_REF__L5_N3), 
	.A(CLK_SCAN_REF__L4_N1));
   CLKINVX40M CLK_SCAN_REF__L5_I2 (.Y(CLK_SCAN_REF__L5_N2), 
	.A(CLK_SCAN_REF__L4_N1));
   CLKINVX40M CLK_SCAN_REF__L5_I1 (.Y(CLK_SCAN_REF__L5_N1), 
	.A(CLK_SCAN_REF__L4_N0));
   CLKINVX40M CLK_SCAN_REF__L5_I0 (.Y(CLK_SCAN_REF__L5_N0), 
	.A(CLK_SCAN_REF__L4_N0));
   CLKINVX40M CLK_SCAN_REF__L4_I7 (.Y(CLK_SCAN_REF__L4_N7), 
	.A(CLK_SCAN_REF__L3_N1));
   CLKINVX40M CLK_SCAN_REF__L4_I6 (.Y(CLK_SCAN_REF__L4_N6), 
	.A(CLK_SCAN_REF__L3_N1));
   CLKINVX40M CLK_SCAN_REF__L4_I5 (.Y(CLK_SCAN_REF__L4_N5), 
	.A(CLK_SCAN_REF__L3_N1));
   CLKINVX40M CLK_SCAN_REF__L4_I4 (.Y(CLK_SCAN_REF__L4_N4), 
	.A(CLK_SCAN_REF__L3_N1));
   CLKINVX40M CLK_SCAN_REF__L4_I3 (.Y(CLK_SCAN_REF__L4_N3), 
	.A(CLK_SCAN_REF__L3_N0));
   CLKINVX40M CLK_SCAN_REF__L4_I2 (.Y(CLK_SCAN_REF__L4_N2), 
	.A(CLK_SCAN_REF__L3_N0));
   CLKINVX40M CLK_SCAN_REF__L4_I1 (.Y(CLK_SCAN_REF__L4_N1), 
	.A(CLK_SCAN_REF__L3_N0));
   CLKINVX40M CLK_SCAN_REF__L4_I0 (.Y(CLK_SCAN_REF__L4_N0), 
	.A(CLK_SCAN_REF__L3_N0));
   CLKINVX40M CLK_SCAN_REF__L3_I1 (.Y(CLK_SCAN_REF__L3_N1), 
	.A(CLK_SCAN_REF__L2_N0));
   CLKINVX40M CLK_SCAN_REF__L3_I0 (.Y(CLK_SCAN_REF__L3_N0), 
	.A(CLK_SCAN_REF__L2_N0));
   CLKINVX40M CLK_SCAN_REF__L2_I0 (.Y(CLK_SCAN_REF__L2_N0), 
	.A(CLK_SCAN_REF__L1_N0));
   BUFX16M CLK_SCAN_REF__L1_I1 (.Y(CLK_SCAN_REF__L1_N1), 
	.A(CLK_SCAN_REF));
   CLKBUFX12M CLK_SCAN_REF__L1_I0 (.Y(CLK_SCAN_REF__L1_N0), 
	.A(CLK_SCAN_REF));
   CLKINVX32M ALU_CLK__L3_I0 (.Y(ALU_CLK__L3_N0), 
	.A(ALU_CLK__L2_N0));
   BUFX14M ALU_CLK__L2_I0 (.Y(ALU_CLK__L2_N0), 
	.A(ALU_CLK__L1_N0));
   CLKINVX6M ALU_CLK__L1_I0 (.Y(ALU_CLK__L1_N0), 
	.A(ALU_CLK));
   CLKINVX24M CLK_SCAN_UART__L18_I1 (.Y(CLK_SCAN_UART__L18_N1), 
	.A(CLK_SCAN_UART__L17_N0));
   CLKINVX24M CLK_SCAN_UART__L18_I0 (.Y(CLK_SCAN_UART__L18_N0), 
	.A(CLK_SCAN_UART__L17_N0));
   CLKINVX40M CLK_SCAN_UART__L17_I0 (.Y(CLK_SCAN_UART__L17_N0), 
	.A(CLK_SCAN_UART__L16_N0));
   CLKBUFX40M CLK_SCAN_UART__L16_I0 (.Y(CLK_SCAN_UART__L16_N0), 
	.A(CLK_SCAN_UART__L15_N0));
   CLKBUFX40M CLK_SCAN_UART__L15_I0 (.Y(CLK_SCAN_UART__L15_N0), 
	.A(CLK_SCAN_UART__L14_N0));
   CLKBUFX24M CLK_SCAN_UART__L14_I0 (.Y(CLK_SCAN_UART__L14_N0), 
	.A(CLK_SCAN_UART__L13_N0));
   CLKBUFX24M CLK_SCAN_UART__L13_I0 (.Y(CLK_SCAN_UART__L13_N0), 
	.A(CLK_SCAN_UART__L12_N0));
   CLKBUFX24M CLK_SCAN_UART__L12_I0 (.Y(CLK_SCAN_UART__L12_N0), 
	.A(CLK_SCAN_UART__L11_N1));
   CLKBUFX24M CLK_SCAN_UART__L11_I1 (.Y(CLK_SCAN_UART__L11_N1), 
	.A(CLK_SCAN_UART__L10_N1));
   CLKBUFX24M CLK_SCAN_UART__L11_I0 (.Y(CLK_SCAN_UART__L11_N0), 
	.A(CLK_SCAN_UART__L10_N0));
   CLKBUFX24M CLK_SCAN_UART__L10_I1 (.Y(CLK_SCAN_UART__L10_N1), 
	.A(CLK_SCAN_UART__L9_N0));
   CLKBUFX24M CLK_SCAN_UART__L10_I0 (.Y(CLK_SCAN_UART__L10_N0), 
	.A(CLK_SCAN_UART__L9_N0));
   CLKBUFX24M CLK_SCAN_UART__L9_I1 (.Y(CLK_SCAN_UART__L9_N1), 
	.A(CLK_SCAN_UART__L8_N1));
   CLKBUFX24M CLK_SCAN_UART__L9_I0 (.Y(CLK_SCAN_UART__L9_N0), 
	.A(CLK_SCAN_UART__L8_N0));
   CLKBUFX24M CLK_SCAN_UART__L8_I1 (.Y(CLK_SCAN_UART__L8_N1), 
	.A(CLK_SCAN_UART__L7_N1));
   CLKBUFX24M CLK_SCAN_UART__L8_I0 (.Y(CLK_SCAN_UART__L8_N0), 
	.A(CLK_SCAN_UART__L7_N0));
   CLKBUFX24M CLK_SCAN_UART__L7_I1 (.Y(CLK_SCAN_UART__L7_N1), 
	.A(CLK_SCAN_UART__L6_N1));
   BUFX14M CLK_SCAN_UART__L7_I0 (.Y(CLK_SCAN_UART__L7_N0), 
	.A(CLK_SCAN_UART__L6_N0));
   CLKBUFX24M CLK_SCAN_UART__L6_I1 (.Y(CLK_SCAN_UART__L6_N1), 
	.A(CLK_SCAN_UART__L5_N1));
   CLKBUFX24M CLK_SCAN_UART__L6_I0 (.Y(CLK_SCAN_UART__L6_N0), 
	.A(CLK_SCAN_UART__L5_N0));
   CLKBUFX24M CLK_SCAN_UART__L5_I1 (.Y(CLK_SCAN_UART__L5_N1), 
	.A(CLK_SCAN_UART__L4_N0));
   BUFX14M CLK_SCAN_UART__L5_I0 (.Y(CLK_SCAN_UART__L5_N0), 
	.A(CLK_SCAN_UART__L4_N0));
   CLKBUFX24M CLK_SCAN_UART__L4_I0 (.Y(CLK_SCAN_UART__L4_N0), 
	.A(CLK_SCAN_UART__L3_N0));
   CLKBUFX20M CLK_SCAN_UART__L3_I0 (.Y(CLK_SCAN_UART__L3_N0), 
	.A(CLK_SCAN_UART__L2_N0));
   CLKBUFX20M CLK_SCAN_UART__L2_I0 (.Y(CLK_SCAN_UART__L2_N0), 
	.A(CLK_SCAN_UART__L1_N0));
   CLKBUFX40M CLK_SCAN_UART__L1_I0 (.Y(CLK_SCAN_UART__L1_N0), 
	.A(CLK_SCAN_UART));
   BUFX8M SO_3___Exclude_0 (.Y(SO[3]), 
	.A(SO_3____SRC));
   BUFX8M n24__Exclude_0 (.Y(n24__Exclude_0_NET), 
	.A(n24));
   CLKBUFX12M TX_CLK__L1_I0 (.Y(TX_CLK__L1_N0), 
	.A(TX_CLK));
   BUFX8M n25__Exclude_0 (.Y(n25__Exclude_0_NET), 
	.A(n25));
   CLKINVX32M CLK_SCAN_UART_RX__L3_I1 (.Y(CLK_SCAN_UART_RX__L3_N1), 
	.A(CLK_SCAN_UART_RX__L2_N0));
   CLKINVX32M CLK_SCAN_UART_RX__L3_I0 (.Y(CLK_SCAN_UART_RX__L3_N0), 
	.A(CLK_SCAN_UART_RX__L2_N0));
   CLKINVX32M CLK_SCAN_UART_RX__L2_I0 (.Y(CLK_SCAN_UART_RX__L2_N0), 
	.A(CLK_SCAN_UART_RX__L1_N0));
   BUFX16M CLK_SCAN_UART_RX__L1_I0 (.Y(CLK_SCAN_UART_RX__L1_N0), 
	.A(CLK_SCAN_UART_RX));
   CLKINVX24M CLK_SCAN_UART_TX__L3_I3 (.Y(CLK_SCAN_UART_TX__L3_N3), 
	.A(CLK_SCAN_UART_TX__L2_N0));
   CLKINVX24M CLK_SCAN_UART_TX__L3_I2 (.Y(CLK_SCAN_UART_TX__L3_N2), 
	.A(CLK_SCAN_UART_TX__L2_N0));
   CLKINVX24M CLK_SCAN_UART_TX__L3_I1 (.Y(CLK_SCAN_UART_TX__L3_N1), 
	.A(CLK_SCAN_UART_TX__L2_N0));
   CLKINVX24M CLK_SCAN_UART_TX__L3_I0 (.Y(CLK_SCAN_UART_TX__L3_N0), 
	.A(CLK_SCAN_UART_TX__L2_N0));
   CLKINVX40M CLK_SCAN_UART_TX__L2_I0 (.Y(CLK_SCAN_UART_TX__L2_N0), 
	.A(CLK_SCAN_UART_TX__L1_N0));
   BUFX16M CLK_SCAN_UART_TX__L1_I0 (.Y(CLK_SCAN_UART_TX__L1_N0), 
	.A(CLK_SCAN_UART_TX));
   BUFX4M FE_OFC21_SE (.Y(FE_OFN21_SE), 
	.A(FE_OFN15_SE));
   BUFX4M FE_OFC20_SE (.Y(FE_OFN20_SE), 
	.A(FE_OFN15_SE));
   CLKINVX6M FE_OFC19_SE (.Y(FE_OFN19_SE), 
	.A(FE_OFN14_SE));
   CLKINVX6M FE_OFC18_SE (.Y(FE_OFN18_SE), 
	.A(FE_OFN14_SE));
   INVX6M FE_OFC17_SE (.Y(FE_OFN17_SE), 
	.A(FE_OFN14_SE));
   CLKINVX6M FE_OFC16_SE (.Y(FE_OFN16_SE), 
	.A(FE_OFN14_SE));
   CLKINVX4M FE_OFC15_SE (.Y(FE_OFN15_SE), 
	.A(FE_OFN14_SE));
   CLKINVX1M FE_OFC14_SE (.Y(FE_OFN14_SE), 
	.A(SE));
   BUFX4M FE_OFC5_RST_SCAN_UART (.Y(FE_OFN5_RST_SCAN_UART), 
	.A(RST_SCAN_UART));
   CLKBUFX8M FE_OFC4_RST_SCAN_REF (.Y(FE_OFN4_RST_SCAN_REF), 
	.A(FE_OFN3_RST_SCAN_REF));
   CLKBUFX8M FE_OFC3_RST_SCAN_REF (.Y(FE_OFN3_RST_SCAN_REF), 
	.A(FE_OFN2_RST_SCAN_REF));
   BUFX4M FE_OFC2_RST_SCAN_REF (.Y(FE_OFN2_RST_SCAN_REF), 
	.A(FE_OFN1_RST_SCAN_REF));
   CLKBUFX8M FE_OFC1_RST_SCAN_REF (.Y(FE_OFN1_RST_SCAN_REF), 
	.A(FE_OFN0_RST_SCAN_REF));
   BUFX4M FE_OFC0_RST_SCAN_REF (.Y(FE_OFN0_RST_SCAN_REF), 
	.A(RST_SCAN_REF));
   TLATNCAX12M U0_TLATNCAX12M (.ECK(ALU_CLK), 
	.E(_0_net_), 
	.CK(CLK_SCAN_REF__L1_N1));
   OR2X2M U5 (.Y(_0_net_), 
	.B(n2), 
	.A(CLK_GATE_EN));
   INVX2M U6 (.Y(n1), 
	.A(UART_TX_VALID_SYNC));
   BUFX4M U7 (.Y(n2), 
	.A(TEST_MODE));
   mux2X1_1 mux_ref (.IN_0(REF_CLK__L2_N0), 
	.IN_1(SCAN_CLK__L15_N0), 
	.SEL(n2), 
	.OUT(CLK_SCAN_REF));
   mux2X1_4 mux_uart (.IN_0(UART_CLK__L2_N0), 
	.IN_1(SCAN_CLK__L2_N0), 
	.SEL(n2), 
	.OUT(CLK_SCAN_UART));
   mux2X1_3 mux_uart_rx (.IN_0(RX_CLK), 
	.IN_1(SCAN_CLK__L19_N0), 
	.SEL(n2), 
	.OUT(CLK_SCAN_UART_RX));
   mux2X1_2 mux_uart_tx (.IN_0(TX_CLK__L1_N0), 
	.IN_1(SCAN_CLK__L19_N0), 
	.SEL(n2), 
	.OUT(CLK_SCAN_UART_TX));
   mux2X1_0 mux_rst (.IN_0(RST), 
	.IN_1(SCAN_RST), 
	.SEL(n2), 
	.OUT(RST_SCAN));
   mux2X1_6 mux_rst_ref (.IN_0(SYNC_REF_RST), 
	.IN_1(SCAN_RST), 
	.SEL(n2), 
	.OUT(RST_SCAN_REF));
   mux2X1_5 mux_rst_uart (.IN_0(SYNC_UART_RST), 
	.IN_1(SCAN_RST), 
	.SEL(n2), 
	.OUT(RST_SCAN_UART));
   RST_SYNC_NUM_STAGES2_test_0 RST_SYNC_REF (.CLK_Rsync(CLK_SCAN_REF__L5_N6), 
	.RST_Rsync(RST_SCAN), 
	.SYNC_RST(SYNC_REF_RST), 
	.test_si(n23), 
	.test_se(FE_OFN15_SE));
   RST_SYNC_NUM_STAGES2_test_1 RST_SYNC_UART (.CLK_Rsync(CLK_SCAN_UART__L18_N0), 
	.RST_Rsync(RST_SCAN), 
	.SYNC_RST(SYNC_UART_RST), 
	.test_si(SYNC_REF_RST), 
	.test_se(FE_OFN15_SE));
   Clk_div_50_Div_Ratio8_test_0 CLK_DIV_TX (.i_ref_clk(CLK_SCAN_UART), 
	.i_rst_n(FE_OFN5_RST_SCAN_UART), 
	.i_clk_en(1'b1), 
	.i_div_ratio({ REG3_DIV_RATIO[7],
		REG3_DIV_RATIO[6],
		REG3_DIV_RATIO[5],
		REG3_DIV_RATIO[4],
		REG3_DIV_RATIO[3],
		REG3_DIV_RATIO[2],
		REG3_DIV_RATIO[1],
		REG3_DIV_RATIO[0] }), 
	.o_div_clk(TX_CLK), 
	.test_si2(n19), 
	.test_si1(n25__Exclude_0_NET), 
	.test_so2(SO_3____SRC), 
	.test_so1(n24), 
	.test_se(FE_OFN20_SE), 
	.n24__Exclude_0_NET(n24__Exclude_0_NET), 
	.SPCPT1_SO_3_(SO[3]), 
	.CLK_SCAN_UART__L18_N1(CLK_SCAN_UART__L18_N1), 
	.CLK_SCAN_UART__L4_N0(CLK_SCAN_UART__L4_N0), 
	.CLK_SCAN_UART__L9_N1(CLK_SCAN_UART__L9_N1));
   Clk_div_50_Div_Ratio8_test_1 CLK_DIV_RX (.i_ref_clk(CLK_SCAN_UART__L11_N0), 
	.i_rst_n(RST_SCAN_UART), 
	.i_clk_en(1'b1), 
	.i_div_ratio({ 1'b0,
		1'b0,
		1'b0,
		1'b0,
		PRESCALE_RX[3],
		PRESCALE_RX[2],
		PRESCALE_RX[1],
		PRESCALE_RX[0] }), 
	.o_div_clk(RX_CLK), 
	.test_si2(SI[3]), 
	.test_si1(SI[4]), 
	.test_so2(n19), 
	.test_so1(n25), 
	.test_se(FE_OFN15_SE), 
	.FE_OFN18_SE(FE_OFN18_SE), 
	.n25__Exclude_0_NET(n25__Exclude_0_NET), 
	.CLK_SCAN_UART__L18_N0(CLK_SCAN_UART__L18_N0), 
	.CLK_SCAN_UART__L3_N0(CLK_SCAN_UART__L3_N0), 
	.CLK_SCAN_UART__L6_N0(CLK_SCAN_UART__L6_N0));
   CLK_DIV_MUX_WIDTH8 MUX_RX (.IN({ REG2_UART_CONFIG[7],
		REG2_UART_CONFIG[6],
		REG2_UART_CONFIG[5],
		REG2_UART_CONFIG[4],
		REG2_UART_CONFIG[3],
		REG2_UART_CONFIG[2] }), 
	.OUT({ SYNOPSYS_UNCONNECTED__0,
		SYNOPSYS_UNCONNECTED__1,
		SYNOPSYS_UNCONNECTED__2,
		SYNOPSYS_UNCONNECTED__3,
		PRESCALE_RX[3],
		PRESCALE_RX[2],
		PRESCALE_RX[1],
		PRESCALE_RX[0] }));
   PULSE_GEN_test_1 pulse_gen_busy (.clk(CLK_SCAN_UART_TX__L3_N0), 
	.rst(RST_SCAN_UART), 
	.lvl_sig(UART_TX_BUSY), 
	.pulse_sig(UART_TX_BUSY_PULSE), 
	.test_si(n14), 
	.test_so(n13), 
	.test_se(FE_OFN15_SE), 
	.CLK_SCAN_UART_TX__L3_N2(CLK_SCAN_UART_TX__L3_N2));
   Data_SYNC_NUM_STAGES2_BUS_WIDTH8_test_1 D_SYNC (.CLK(CLK_SCAN_REF__L5_N1), 
	.RST(FE_OFN1_RST_SCAN_REF), 
	.ASYNC({ UART_RX_OUT[7],
		UART_RX_OUT[6],
		UART_RX_OUT[5],
		UART_RX_OUT[4],
		UART_RX_OUT[3],
		UART_RX_OUT[2],
		UART_RX_OUT[1],
		UART_RX_OUT[0] }), 
	.BUS_EN(UART_RX_VALID), 
	.ENABLE_PULSE(UART_RX_VALID_SYNC), 
	.SYNC_BUS({ UART_RX_OUT_SYNC[7],
		UART_RX_OUT_SYNC[6],
		UART_RX_OUT_SYNC[5],
		UART_RX_OUT_SYNC[4],
		UART_RX_OUT_SYNC[3],
		UART_RX_OUT_SYNC[2],
		UART_RX_OUT_SYNC[1],
		UART_RX_OUT_SYNC[0] }), 
	.test_si(n24__Exclude_0_NET), 
	.test_so(n23), 
	.test_se(FE_OFN17_SE), 
	.FE_OFN4_RST_SCAN_REF(FE_OFN4_RST_SCAN_REF), 
	.CLK_SCAN_REF__L5_N14(CLK_SCAN_REF__L5_N14));
   REG_file_WIDTH8_NO_OF_REG16_ADDR4_test_1 reg_file (.CLK_regfile(CLK_SCAN_REF__L5_N1), 
	.RST_regfile(FE_OFN2_RST_SCAN_REF), 
	.WrData({ WR_DATA[7],
		WR_DATA[6],
		WR_DATA[5],
		WR_DATA[4],
		WR_DATA[3],
		WR_DATA[2],
		WR_DATA[1],
		WR_DATA[0] }), 
	.Address({ WR_ADDR[3],
		WR_ADDR[2],
		WR_ADDR[1],
		WR_ADDR[0] }), 
	.WrEn(WR_EN), 
	.RdEn(RD_EN), 
	.RdData({ RD_DATA[7],
		RD_DATA[6],
		RD_DATA[5],
		RD_DATA[4],
		RD_DATA[3],
		RD_DATA[2],
		RD_DATA[1],
		RD_DATA[0] }), 
	.RdData_Valid(RD_DATA_VALID), 
	.REG0({ REG0_A[7],
		REG0_A[6],
		REG0_A[5],
		REG0_A[4],
		REG0_A[3],
		REG0_A[2],
		REG0_A[1],
		REG0_A[0] }), 
	.REG1({ REG1_B[7],
		REG1_B[6],
		REG1_B[5],
		REG1_B[4],
		REG1_B[3],
		REG1_B[2],
		REG1_B[1],
		REG1_B[0] }), 
	.REG2({ REG2_UART_CONFIG[7],
		REG2_UART_CONFIG[6],
		REG2_UART_CONFIG[5],
		REG2_UART_CONFIG[4],
		REG2_UART_CONFIG[3],
		REG2_UART_CONFIG[2],
		REG2_UART_CONFIG[1],
		REG2_UART_CONFIG[0] }), 
	.REG3({ REG3_DIV_RATIO[7],
		REG3_DIV_RATIO[6],
		REG3_DIV_RATIO[5],
		REG3_DIV_RATIO[4],
		REG3_DIV_RATIO[3],
		REG3_DIV_RATIO[2],
		REG3_DIV_RATIO[1],
		REG3_DIV_RATIO[0] }), 
	.test_si3(test_si6), 
	.test_si2(SI[0]), 
	.test_si1(n13), 
	.test_so2(n9), 
	.test_so1(SO[0]), 
	.test_se(FE_OFN16_SE), 
	.FE_OFN3_RST_SCAN_REF(FE_OFN3_RST_SCAN_REF), 
	.FE_OFN4_RST_SCAN_REF(FE_OFN4_RST_SCAN_REF), 
	.FE_OFN17_SE(FE_OFN17_SE), 
	.FE_OFN18_SE(FE_OFN18_SE), 
	.FE_OFN20_SE(FE_OFN20_SE), 
	.CLK_SCAN_REF__L5_N10(CLK_SCAN_REF__L5_N10), 
	.CLK_SCAN_REF__L5_N12(CLK_SCAN_REF__L5_N12), 
	.CLK_SCAN_REF__L5_N13(CLK_SCAN_REF__L5_N13), 
	.CLK_SCAN_REF__L5_N14(CLK_SCAN_REF__L5_N14), 
	.CLK_SCAN_REF__L5_N15(CLK_SCAN_REF__L5_N15), 
	.CLK_SCAN_REF__L5_N8(CLK_SCAN_REF__L5_N8), 
	.CLK_SCAN_REF__L5_N9(CLK_SCAN_REF__L5_N9));
   Alu_16_bit_OPER_WIDTH8_OUT_WIDTH16_ALU_FUN_WIDTH4_test_1 alu (.CLK_alu(ALU_CLK__L3_N0), 
	.RST_alu(FE_OFN1_RST_SCAN_REF), 
	.EN_alu(ALU_EN), 
	.A({ REG0_A[7],
		REG0_A[6],
		REG0_A[5],
		REG0_A[4],
		REG0_A[3],
		REG0_A[2],
		REG0_A[1],
		REG0_A[0] }), 
	.B({ REG1_B[7],
		REG1_B[6],
		REG1_B[5],
		REG1_B[4],
		REG1_B[3],
		REG1_B[2],
		REG1_B[1],
		REG1_B[0] }), 
	.ALU_FUN({ ALU_FUN[3],
		ALU_FUN[2],
		ALU_FUN[1],
		ALU_FUN[0] }), 
	.ALU_OUT({ ALU_RESULT[15],
		ALU_RESULT[14],
		ALU_RESULT[13],
		ALU_RESULT[12],
		ALU_RESULT[11],
		ALU_RESULT[10],
		ALU_RESULT[9],
		ALU_RESULT[8],
		ALU_RESULT[7],
		ALU_RESULT[6],
		ALU_RESULT[5],
		ALU_RESULT[4],
		ALU_RESULT[3],
		ALU_RESULT[2],
		ALU_RESULT[1],
		ALU_RESULT[0] }), 
	.OUT_VALID(ALU_OUT_VALID), 
	.test_si(SYNC_UART_RST), 
	.test_se(FE_OFN17_SE), 
	.FE_OFN2_RST_SCAN_REF(FE_OFN2_RST_SCAN_REF), 
	.FE_OFN18_SE(FE_OFN18_SE), 
	.FE_OFN19_SE(FE_OFN19_SE));
   ASYNC_FIFO_DATASIZE8_ADDRSIZE4_DEPTHSIZE16_test_1 fifo_async (.W_CLK(CLK_SCAN_REF__L5_N0), 
	.W_RST_N(RST_SCAN_REF), 
	.W_INC(UART_TX_VALID), 
	.W_DATA({ UART_TX_IN[7],
		UART_TX_IN[6],
		UART_TX_IN[5],
		UART_TX_IN[4],
		UART_TX_IN[3],
		UART_TX_IN[2],
		UART_TX_IN[1],
		UART_TX_IN[0] }), 
	.R_CLK(CLK_SCAN_UART_TX__L3_N0), 
	.R_RST_N(RST_SCAN_UART), 
	.R_INC(UART_TX_BUSY_PULSE), 
	.W_FULL(FIFO_FULL), 
	.R_DATA({ UART_TX_IN_SYNC[7],
		UART_TX_IN_SYNC[6],
		UART_TX_IN_SYNC[5],
		UART_TX_IN_SYNC[4],
		UART_TX_IN_SYNC[3],
		UART_TX_IN_SYNC[2],
		UART_TX_IN_SYNC[1],
		UART_TX_IN_SYNC[0] }), 
	.R_EMPTY(UART_TX_VALID_SYNC), 
	.test_si3(SI[1]), 
	.test_si2(SI[2]), 
	.test_si1(n22), 
	.test_so3(n14), 
	.test_so2(SO[2]), 
	.test_so1(SO[4]), 
	.test_se(FE_OFN15_SE), 
	.FE_OFN0_RST_SCAN_REF(FE_OFN0_RST_SCAN_REF), 
	.FE_OFN1_RST_SCAN_REF(FE_OFN1_RST_SCAN_REF), 
	.FE_OFN17_SE(FE_OFN17_SE), 
	.FE_OFN19_SE(FE_OFN19_SE), 
	.FE_OFN20_SE(FE_OFN20_SE), 
	.FE_OFN21_SE(FE_OFN21_SE), 
	.CLK_SCAN_UART_TX__L3_N1(CLK_SCAN_UART_TX__L3_N1), 
	.CLK_SCAN_UART_TX__L3_N2(CLK_SCAN_UART_TX__L3_N2), 
	.CLK_SCAN_REF__L5_N1(CLK_SCAN_REF__L5_N1), 
	.CLK_SCAN_REF__L5_N11(CLK_SCAN_REF__L5_N11), 
	.CLK_SCAN_REF__L5_N2(CLK_SCAN_REF__L5_N2), 
	.CLK_SCAN_REF__L5_N3(CLK_SCAN_REF__L5_N3), 
	.CLK_SCAN_REF__L5_N4(CLK_SCAN_REF__L5_N4), 
	.CLK_SCAN_REF__L5_N5(CLK_SCAN_REF__L5_N5), 
	.CLK_SCAN_REF__L5_N6(CLK_SCAN_REF__L5_N6), 
	.CLK_SCAN_REF__L5_N7(CLK_SCAN_REF__L5_N7));
   UART_TOP_8_6_0_1_0_1_test_1 uart (.i_CLK_TX(CLK_SCAN_UART_TX__L3_N1), 
	.i_CLK_RX(CLK_SCAN_UART_RX__L3_N0), 
	.i_RST(RST_SCAN_UART), 
	.i_DATA_Valid_TX(n1), 
	.i_DATA_TX({ UART_TX_IN_SYNC[7],
		UART_TX_IN_SYNC[6],
		UART_TX_IN_SYNC[5],
		UART_TX_IN_SYNC[4],
		UART_TX_IN_SYNC[3],
		UART_TX_IN_SYNC[2],
		UART_TX_IN_SYNC[1],
		UART_TX_IN_SYNC[0] }), 
	.i_PAR_EN_TX(REG2_UART_CONFIG[0]), 
	.i_PAR_TYP_TX(REG2_UART_CONFIG[1]), 
	.i_Serial_Data_RX(RX_IN), 
	.i_PAR_EN_RX(REG2_UART_CONFIG[0]), 
	.i_PAR_TYP_RX(REG2_UART_CONFIG[1]), 
	.i_Prescale_RX({ REG2_UART_CONFIG[7],
		REG2_UART_CONFIG[6],
		REG2_UART_CONFIG[5],
		REG2_UART_CONFIG[4],
		REG2_UART_CONFIG[3],
		REG2_UART_CONFIG[2] }), 
	.o_OUT_TX(TX_OUT), 
	.o_BUSY_TX(UART_TX_BUSY), 
	.o_P_Data_RX({ UART_RX_OUT[7],
		UART_RX_OUT[6],
		UART_RX_OUT[5],
		UART_RX_OUT[4],
		UART_RX_OUT[3],
		UART_RX_OUT[2],
		UART_RX_OUT[1],
		UART_RX_OUT[0] }), 
	.o_Data_Valid_RX(UART_RX_VALID), 
	.o_Stop_Error_RX(STOP_ERR), 
	.o_Parity_Error_RX(PAR_ERR), 
	.test_si(n9), 
	.test_se(FE_OFN15_SE), 
	.FE_OFN5_RST_SCAN_UART(FE_OFN5_RST_SCAN_UART), 
	.FE_OFN17_SE(FE_OFN17_SE), 
	.FE_OFN18_SE(FE_OFN18_SE), 
	.FE_OFN20_SE(FE_OFN20_SE), 
	.FE_OFN21_SE(FE_OFN21_SE), 
	.CLK_SCAN_UART_TX__L3_N2(CLK_SCAN_UART_TX__L3_N2), 
	.CLK_SCAN_UART_TX__L3_N3(CLK_SCAN_UART_TX__L3_N3), 
	.CLK_SCAN_UART_RX__L3_N1(CLK_SCAN_UART_RX__L3_N1));
   SYS_CTRL_WIDTH8_ADDR4_test_1 control (.CLK(CLK_SCAN_REF__L5_N0), 
	.RST_N(FE_OFN1_RST_SCAN_REF), 
	.ALU_OUT({ ALU_RESULT[15],
		ALU_RESULT[14],
		ALU_RESULT[13],
		ALU_RESULT[12],
		ALU_RESULT[11],
		ALU_RESULT[10],
		ALU_RESULT[9],
		ALU_RESULT[8],
		ALU_RESULT[7],
		ALU_RESULT[6],
		ALU_RESULT[5],
		ALU_RESULT[4],
		ALU_RESULT[3],
		ALU_RESULT[2],
		ALU_RESULT[1],
		ALU_RESULT[0] }), 
	.ALU_OUT_Valid(ALU_OUT_VALID), 
	.RD_DATA({ RD_DATA[7],
		RD_DATA[6],
		RD_DATA[5],
		RD_DATA[4],
		RD_DATA[3],
		RD_DATA[2],
		RD_DATA[1],
		RD_DATA[0] }), 
	.RD_DATA_VLD(RD_DATA_VALID), 
	.FIFO_FULL(FIFO_FULL), 
	.RX_DATA({ UART_RX_OUT_SYNC[7],
		UART_RX_OUT_SYNC[6],
		UART_RX_OUT_SYNC[5],
		UART_RX_OUT_SYNC[4],
		UART_RX_OUT_SYNC[3],
		UART_RX_OUT_SYNC[2],
		UART_RX_OUT_SYNC[1],
		UART_RX_OUT_SYNC[0] }), 
	.RX_VLD(UART_RX_VALID_SYNC), 
	.ALU_FUN({ ALU_FUN[3],
		ALU_FUN[2],
		ALU_FUN[1],
		ALU_FUN[0] }), 
	.ALU_EN(ALU_EN), 
	.CLKG_EN(CLK_GATE_EN), 
	.WR_EN(WR_EN), 
	.RD_EN(RD_EN), 
	.ADDR_S({ WR_ADDR[3],
		WR_ADDR[2],
		WR_ADDR[1],
		WR_ADDR[0] }), 
	.WR_DATA_S({ WR_DATA[7],
		WR_DATA[6],
		WR_DATA[5],
		WR_DATA[4],
		WR_DATA[3],
		WR_DATA[2],
		WR_DATA[1],
		WR_DATA[0] }), 
	.TX_P_DATA({ UART_TX_IN[7],
		UART_TX_IN[6],
		UART_TX_IN[5],
		UART_TX_IN[4],
		UART_TX_IN[3],
		UART_TX_IN[2],
		UART_TX_IN[1],
		UART_TX_IN[0] }), 
	.TX_D_VLD(UART_TX_VALID), 
	.test_so(n22), 
	.test_se(FE_OFN16_SE), 
	.FE_OFN2_RST_SCAN_REF(FE_OFN2_RST_SCAN_REF), 
	.FE_OFN17_SE(FE_OFN17_SE), 
	.FE_OFN18_SE(FE_OFN18_SE), 
	.FE_OFN19_SE(FE_OFN19_SE), 
	.CLK_SCAN_REF__L5_N1(CLK_SCAN_REF__L5_N1), 
	.CLK_SCAN_REF__L5_N10(CLK_SCAN_REF__L5_N10), 
	.CLK_SCAN_REF__L5_N11(CLK_SCAN_REF__L5_N11), 
	.CLK_SCAN_REF__L5_N14(CLK_SCAN_REF__L5_N14));
endmodule

/////////////////////////////////////////////////////////////
// Created by: Synopsys DC Expert(TM) in wire load mode
// Version   : O-2018.06-SP1
// Date      : Wed Oct  7 01:18:13 2026
/////////////////////////////////////////////////////////////
module mux2X1_1 (
	IN_0, 
	IN_1, 
	SEL, 
	OUT);
   input IN_0;
   input IN_1;
   input SEL;
   output OUT;

   // Internal wires
   wire N0;

   assign N0 = SEL ;

   MX2X6M U1 (.Y(OUT), 
	.S0(N0), 
	.B(IN_1), 
	.A(IN_0));
endmodule

module mux2X1_4 (
	IN_0, 
	IN_1, 
	SEL, 
	OUT);
   input IN_0;
   input IN_1;
   input SEL;
   output OUT;

   // Internal wires
   wire N0;

   assign N0 = SEL ;

   MX2X6M U1 (.Y(OUT), 
	.S0(N0), 
	.B(IN_1), 
	.A(IN_0));
endmodule

module mux2X1_3 (
	IN_0, 
	IN_1, 
	SEL, 
	OUT);
   input IN_0;
   input IN_1;
   input SEL;
   output OUT;

   // Internal wires
   wire N0;

   assign N0 = SEL ;

   MX2X6M U1 (.Y(OUT), 
	.S0(N0), 
	.B(IN_1), 
	.A(IN_0));
endmodule

module mux2X1_2 (
	IN_0, 
	IN_1, 
	SEL, 
	OUT);
   input IN_0;
   input IN_1;
   input SEL;
   output OUT;

   // Internal wires
   wire N0;

   assign N0 = SEL ;

   MX2X6M U1 (.Y(OUT), 
	.S0(N0), 
	.B(IN_1), 
	.A(IN_0));
endmodule

module mux2X1_0 (
	IN_0, 
	IN_1, 
	SEL, 
	OUT);
   input IN_0;
   input IN_1;
   input SEL;
   output OUT;

   // Internal wires
   wire N0;

   assign N0 = SEL ;

   MX2X2M U1 (.Y(OUT), 
	.S0(N0), 
	.B(IN_1), 
	.A(IN_0));
endmodule

module mux2X1_6 (
	IN_0, 
	IN_1, 
	SEL, 
	OUT);
   input IN_0;
   input IN_1;
   input SEL;
   output OUT;

   // Internal wires
   wire N0;

   assign N0 = SEL ;

   MX2X8M U1 (.Y(OUT), 
	.S0(N0), 
	.B(IN_1), 
	.A(IN_0));
endmodule

module mux2X1_5 (
	IN_0, 
	IN_1, 
	SEL, 
	OUT);
   input IN_0;
   input IN_1;
   input SEL;
   output OUT;

   // Internal wires
   wire N0;

   assign N0 = SEL ;

   MX2X8M U1 (.Y(OUT), 
	.S0(N0), 
	.B(IN_1), 
	.A(IN_0));
endmodule

module RST_SYNC_NUM_STAGES2_test_0 (
	CLK_Rsync, 
	RST_Rsync, 
	SYNC_RST, 
	test_si, 
	test_se);
   input CLK_Rsync;
   input RST_Rsync;
   output SYNC_RST;
   input test_si;
   input test_se;

   // Internal wires
   wire HTIE_LTIEHI_NET;
   wire \sync_reg[0] ;

   TIEHIM HTIE_LTIEHI (.Y(HTIE_LTIEHI_NET));
   SDFFRQX2M \sync_reg_reg[1]  (.SI(\sync_reg[0] ), 
	.SE(test_se), 
	.RN(RST_Rsync), 
	.Q(SYNC_RST), 
	.D(\sync_reg[0] ), 
	.CK(CLK_Rsync));
   SDFFRQX2M \sync_reg_reg[0]  (.SI(test_si), 
	.SE(test_se), 
	.RN(RST_Rsync), 
	.Q(\sync_reg[0] ), 
	.D(HTIE_LTIEHI_NET), 
	.CK(CLK_Rsync));
endmodule

module RST_SYNC_NUM_STAGES2_test_1 (
	CLK_Rsync, 
	RST_Rsync, 
	SYNC_RST, 
	test_si, 
	test_se);
   input CLK_Rsync;
   input RST_Rsync;
   output SYNC_RST;
   input test_si;
   input test_se;

   // Internal wires
   wire HTIE_LTIEHI_NET;
   wire \sync_reg[0] ;

   TIEHIM HTIE_LTIEHI (.Y(HTIE_LTIEHI_NET));
   SDFFRQX1M \sync_reg_reg[1]  (.SI(\sync_reg[0] ), 
	.SE(test_se), 
	.RN(RST_Rsync), 
	.Q(SYNC_RST), 
	.D(\sync_reg[0] ), 
	.CK(CLK_Rsync));
   SDFFRQX1M \sync_reg_reg[0]  (.SI(test_si), 
	.SE(test_se), 
	.RN(RST_Rsync), 
	.Q(\sync_reg[0] ), 
	.D(HTIE_LTIEHI_NET), 
	.CK(CLK_Rsync));
endmodule

module Clk_div_50_Div_Ratio8_0_DW01_inc_0 (
	A, 
	SUM);
   input [7:0] A;
   output [7:0] SUM;

   // Internal wires
   wire [7:2] carry;

   ADDHX1M U1_1_6 (.S(SUM[6]), 
	.CO(carry[7]), 
	.B(carry[6]), 
	.A(A[6]));
   ADDHX1M U1_1_4 (.S(SUM[4]), 
	.CO(carry[5]), 
	.B(carry[4]), 
	.A(A[4]));
   ADDHX1M U1_1_5 (.S(SUM[5]), 
	.CO(carry[6]), 
	.B(carry[5]), 
	.A(A[5]));
   ADDHX1M U1_1_3 (.S(SUM[3]), 
	.CO(carry[4]), 
	.B(carry[3]), 
	.A(A[3]));
   ADDHX1M U1_1_2 (.S(SUM[2]), 
	.CO(carry[3]), 
	.B(carry[2]), 
	.A(A[2]));
   ADDHX1M U1_1_1 (.S(SUM[1]), 
	.CO(carry[2]), 
	.B(A[0]), 
	.A(A[1]));
   CLKXOR2X2M U1 (.Y(SUM[7]), 
	.B(A[7]), 
	.A(carry[7]));
   CLKINVX1M U2 (.Y(SUM[0]), 
	.A(A[0]));
endmodule

module Clk_div_50_Div_Ratio8_test_0 (
	i_ref_clk, 
	i_rst_n, 
	i_clk_en, 
	i_div_ratio, 
	o_div_clk, 
	test_si2, 
	test_si1, 
	test_so2, 
	test_so1, 
	test_se, 
	n24__Exclude_0_NET, 
	SPCPT1_SO_3_, 
	CLK_SCAN_UART__L18_N1, 
	CLK_SCAN_UART__L4_N0, 
	CLK_SCAN_UART__L9_N1);
   input i_ref_clk;
   input i_rst_n;
   input i_clk_en;
   input [7:0] i_div_ratio;
   output o_div_clk;
   input test_si2;
   input test_si1;
   output test_so2;
   output test_so1;
   input test_se;
   input n24__Exclude_0_NET;
   input SPCPT1_SO_3_;
   input CLK_SCAN_UART__L18_N1;
   input CLK_SCAN_UART__L4_N0;
   input CLK_SCAN_UART__L9_N1;

   // Internal wires
   wire n32__Exclude_0_NET;
   wire HTIE_LTIEHI_NET;
   wire N8;
   wire N9;
   wire N10;
   wire N11;
   wire N12;
   wire N13;
   wire N14;
   wire N15;
   wire N18;
   wire N19;
   wire N20;
   wire N21;
   wire N22;
   wire N23;
   wire N24;
   wire N25;
   wire N34;
   wire N35;
   wire N36;
   wire N37;
   wire N38;
   wire N39;
   wire N40;
   wire N41;
   wire q1;
   wire n17;
   wire n19;
   wire n1;
   wire n2;
   wire n3;
   wire n4;
   wire n11;
   wire n12;
   wire n13;
   wire n14;
   wire n28;
   wire n29;
   wire n30;
   wire n31;
   wire n32;
   wire n33;
   wire n34;
   wire n35;
   wire n36;
   wire n37;
   wire n38;
   wire n39;
   wire n40;
   wire n41;
   wire n42;
   wire n43;
   wire n44;
   wire n45;
   wire n46;
   wire n47;
   wire n48;
   wire n49;
   wire n50;
   wire n51;
   wire n52;
   wire n53;
   wire n54;
   wire n55;
   wire n56;
   wire n57;
   wire n58;
   wire n59;
   wire n60;
   wire n61;
   wire n62;
   wire n63;
   wire n64;
   wire n65;
   wire n66;
   wire n67;
   wire n68;
   wire n69;
   wire n70;
   wire n71;
   wire n90;
   wire n5;
   wire [7:0] counter;

   BUFX8M n32__Exclude_0 (.Y(n32__Exclude_0_NET), 
	.A(n32));
   TIEHIM HTIE_LTIEHI (.Y(HTIE_LTIEHI_NET));
   SDFFRQX2M \counter_reg[4]  (.SI(counter[3]), 
	.SE(test_se), 
	.RN(i_rst_n), 
	.Q(counter[4]), 
	.D(N38), 
	.CK(CLK_SCAN_UART__L18_N1));
   SDFFRQX2M \counter_reg[5]  (.SI(counter[4]), 
	.SE(test_se), 
	.RN(i_rst_n), 
	.Q(counter[5]), 
	.D(N39), 
	.CK(CLK_SCAN_UART__L18_N1));
   SDFFRQX2M \counter_reg[3]  (.SI(counter[2]), 
	.SE(test_se), 
	.RN(i_rst_n), 
	.Q(counter[3]), 
	.D(N37), 
	.CK(CLK_SCAN_UART__L18_N1));
   SDFFRQX2M \counter_reg[1]  (.SI(counter[0]), 
	.SE(test_se), 
	.RN(i_rst_n), 
	.Q(counter[1]), 
	.D(N35), 
	.CK(CLK_SCAN_UART__L18_N1));
   SDFFRQX2M \counter_reg[2]  (.SI(counter[1]), 
	.SE(test_se), 
	.RN(i_rst_n), 
	.Q(counter[2]), 
	.D(N36), 
	.CK(CLK_SCAN_UART__L18_N1));
   SDFFNSRHX1M q2_reg (.SN(HTIE_LTIEHI_NET), 
	.SI(test_si2), 
	.SE(test_se), 
	.RN(i_rst_n), 
	.Q(n90), 
	.D(n17), 
	.CKN(i_ref_clk));
   SDFFRQX2M q1_reg (.SI(counter[7]), 
	.SE(test_se), 
	.RN(i_rst_n), 
	.Q(test_so1), 
	.D(n19), 
	.CK(CLK_SCAN_UART__L4_N0));
   SDFFRQX2M \counter_reg[7]  (.SI(counter[6]), 
	.SE(test_se), 
	.RN(i_rst_n), 
	.Q(counter[7]), 
	.D(N41), 
	.CK(CLK_SCAN_UART__L18_N1));
   INVX2M U3 (.Y(n2), 
	.A(n1));
   INVX2M U4 (.Y(n1), 
	.A(counter[0]));
   INVX2M U5 (.Y(n46), 
	.A(i_div_ratio[5]));
   INVX2M U6 (.Y(n4), 
	.A(n3));
   INVX2M U7 (.Y(n3), 
	.A(counter[6]));
   XNOR2X2M U12 (.Y(N14), 
	.B(n28), 
	.A(i_div_ratio[6]));
   AOI222X1M U13 (.Y(n42), 
	.C1(n46), 
	.C0(counter[4]), 
	.B1(n45), 
	.B0(n44), 
	.A1(n43), 
	.A0(counter[3]));
   AOI222X1M U14 (.Y(n56), 
	.C1(n3), 
	.C0(N14), 
	.B1(n61), 
	.B0(n60), 
	.A1(n36), 
	.A0(N15));
   OAI32X1M U15 (.Y(n60), 
	.B1(n65), 
	.B0(counter[5]), 
	.A2(n64), 
	.A1(n63), 
	.A0(n62));
   OAI31X1M U16 (.Y(n49), 
	.B0(n53), 
	.A2(n2), 
	.A1(counter[1]), 
	.A0(n52));
   AOI221XLM U17 (.Y(n34), 
	.C0(n39), 
	.B1(n37), 
	.B0(n4), 
	.A1(n38), 
	.A0(counter[5]));
   AOI221XLM U18 (.Y(n39), 
	.C0(n42), 
	.B1(n41), 
	.B0(i_div_ratio[6]), 
	.A1(n40), 
	.A0(i_div_ratio[5]));
   AOI221XLM U19 (.Y(n63), 
	.C0(n66), 
	.B1(n40), 
	.B0(N12), 
	.A1(n51), 
	.A0(N11));
   AOI222X1M U20 (.Y(n66), 
	.C1(counter[3]), 
	.C0(n70), 
	.B1(n69), 
	.B0(n68), 
	.A1(counter[2]), 
	.A0(n67));
   NAND2X2M U21 (.Y(n28), 
	.B(n46), 
	.A(n14));
   AO21XLM U22 (.Y(N12), 
	.B0(n14), 
	.A1(i_div_ratio[4]), 
	.A0(n13));
   NOR2X2M U23 (.Y(n14), 
	.B(i_div_ratio[4]), 
	.A(n13));
   OR3X2M U35 (.Y(n55), 
	.C(n31), 
	.B(n57), 
	.A(n56));
   MX2X2M U36 (.Y(n17), 
	.S0(n31), 
	.B(SPCPT1_SO_3_), 
	.A(n24__Exclude_0_NET));
   OAI21X2M U37 (.Y(n31), 
	.B0(HTIE_LTIEHI_NET), 
	.A1(n59), 
	.A0(n58));
   OAI21X2M U38 (.Y(N13), 
	.B0(n28), 
	.A1(n46), 
	.A0(n14));
   MX2XLM U39 (.Y(o_div_clk), 
	.S0(n31), 
	.B(CLK_SCAN_UART__L9_N1), 
	.A(n30));
   INVX2M U40 (.Y(n37), 
	.A(i_div_ratio[7]));
   INVX2M U41 (.Y(n52), 
	.A(i_div_ratio[1]));
   INVXLM U42 (.Y(n65), 
	.A(N13));
   OR2X2M U43 (.Y(n13), 
	.B(i_div_ratio[3]), 
	.A(n12));
   OR2X2M U44 (.Y(n12), 
	.B(i_div_ratio[2]), 
	.A(n11));
   INVX2M U45 (.Y(n40), 
	.A(counter[4]));
   INVX2M U46 (.Y(n36), 
	.A(counter[7]));
   OR2X2M U49 (.Y(n11), 
	.B(i_div_ratio[0]), 
	.A(i_div_ratio[1]));
   CLKINVX1M U50 (.Y(N8), 
	.A(i_div_ratio[0]));
   OAI2BB1X1M U51 (.Y(N9), 
	.B0(n11), 
	.A1N(i_div_ratio[1]), 
	.A0N(i_div_ratio[0]));
   OAI2BB1X1M U52 (.Y(N10), 
	.B0(n12), 
	.A1N(i_div_ratio[2]), 
	.A0N(n11));
   OAI2BB1X1M U53 (.Y(N11), 
	.B0(n13), 
	.A1N(i_div_ratio[3]), 
	.A0N(n12));
   NOR2X1M U54 (.Y(n29), 
	.B(n28), 
	.A(i_div_ratio[6]));
   CLKXOR2X2M U55 (.Y(N15), 
	.B(n29), 
	.A(i_div_ratio[7]));
   OAI2BB1X1M U56 (.Y(n30), 
	.B0(n32), 
	.A1N(i_div_ratio[0]), 
	.A0N(test_so2));
   MXI2X1M U57 (.Y(n19), 
	.S0(n31), 
	.B(n32__Exclude_0_NET), 
	.A(n33));
   CLKINVX1M U58 (.Y(n32), 
	.A(test_so1));
   OAI21X1M U59 (.Y(n33), 
	.B0(n36), 
	.A1(n35), 
	.A0(n34));
   NOR2X1M U60 (.Y(n35), 
	.B(n37), 
	.A(n4));
   CLKNAND2X2M U61 (.Y(n45), 
	.B(n47), 
	.A(i_div_ratio[3]));
   AOI32X1M U62 (.Y(n44), 
	.B1(n51), 
	.B0(i_div_ratio[4]), 
	.A2(n50), 
	.A1(n49), 
	.A0(n48));
   OAI21X1M U63 (.Y(n50), 
	.B0(counter[1]), 
	.A1(n52), 
	.A0(n2));
   CLKNAND2X2M U64 (.Y(n48), 
	.B(n54), 
	.A(counter[2]));
   NOR2BX1M U65 (.Y(N41), 
	.B(n55), 
	.AN(N25));
   NOR2BX1M U66 (.Y(N40), 
	.B(n55), 
	.AN(N24));
   NOR2BX1M U67 (.Y(N39), 
	.B(n55), 
	.AN(N23));
   NOR2BX1M U68 (.Y(N38), 
	.B(n55), 
	.AN(N22));
   NOR2BX1M U69 (.Y(N37), 
	.B(n55), 
	.AN(N21));
   NOR2BX1M U70 (.Y(N36), 
	.B(n55), 
	.AN(N20));
   NOR2BX1M U71 (.Y(N35), 
	.B(n55), 
	.AN(N19));
   NOR2BX1M U72 (.Y(N34), 
	.B(n55), 
	.AN(N18));
   NAND3X1M U73 (.Y(n59), 
	.C(n52), 
	.B(n54), 
	.A(n53));
   CLKINVX1M U74 (.Y(n54), 
	.A(i_div_ratio[3]));
   CLKINVX1M U75 (.Y(n53), 
	.A(i_div_ratio[2]));
   NAND4X1M U76 (.Y(n58), 
	.D(n37), 
	.C(n38), 
	.B(n46), 
	.A(n43));
   CLKINVX1M U77 (.Y(n38), 
	.A(i_div_ratio[6]));
   CLKINVX1M U78 (.Y(n43), 
	.A(i_div_ratio[4]));
   NOR2X1M U79 (.Y(n57), 
	.B(n36), 
	.A(N15));
   NAND2BX1M U80 (.Y(n61), 
	.B(n4), 
	.AN(N14));
   NOR2X1M U81 (.Y(n64), 
	.B(n41), 
	.A(N13));
   CLKINVX1M U82 (.Y(n41), 
	.A(counter[5]));
   CLKINVX1M U83 (.Y(n70), 
	.A(N11));
   OAI211X1M U84 (.Y(n69), 
	.C0(N8), 
	.B0(n1), 
	.A1(n71), 
	.A0(N9));
   AOI22X1M U85 (.Y(n68), 
	.B1(n71), 
	.B0(N9), 
	.A1(n47), 
	.A0(N10));
   CLKINVX1M U86 (.Y(n71), 
	.A(counter[1]));
   CLKINVX1M U87 (.Y(n47), 
	.A(counter[2]));
   CLKINVX1M U88 (.Y(n67), 
	.A(N10));
   CLKINVX1M U89 (.Y(n51), 
	.A(counter[3]));
   NOR2X1M U90 (.Y(n62), 
	.B(n40), 
	.A(N12));
   Clk_div_50_Div_Ratio8_0_DW01_inc_0 add_36 (.A({ counter[7],
		n4,
		counter[5],
		counter[4],
		counter[3],
		counter[2],
		counter[1],
		n2 }), 
	.SUM({ N25,
		N24,
		N23,
		N22,
		N21,
		N20,
		N19,
		N18 }));
   SDFFRQX2M \counter_reg[6]  (.SI(counter[5]), 
	.SE(test_se), 
	.RN(i_rst_n), 
	.Q(counter[6]), 
	.D(N40), 
	.CK(CLK_SCAN_UART__L18_N1));
   SDFFRQX2M \counter_reg[0]  (.SI(test_si1), 
	.SE(test_se), 
	.RN(i_rst_n), 
	.Q(counter[0]), 
	.D(N34), 
	.CK(CLK_SCAN_UART__L18_N1));
   INVXLM U8 (.Y(n5), 
	.A(n90));
   INVX2M U9 (.Y(test_so2), 
	.A(n5));
endmodule

module Clk_div_50_Div_Ratio8_1_DW01_inc_0 (
	A, 
	SUM);
   input [7:0] A;
   output [7:0] SUM;

   // Internal wires
   wire [7:2] carry;

   ADDHX1M U1_1_6 (.S(SUM[6]), 
	.CO(carry[7]), 
	.B(carry[6]), 
	.A(A[6]));
   ADDHX1M U1_1_4 (.S(SUM[4]), 
	.CO(carry[5]), 
	.B(carry[4]), 
	.A(A[4]));
   ADDHX1M U1_1_5 (.S(SUM[5]), 
	.CO(carry[6]), 
	.B(carry[5]), 
	.A(A[5]));
   ADDHX1M U1_1_3 (.S(SUM[3]), 
	.CO(carry[4]), 
	.B(carry[3]), 
	.A(A[3]));
   ADDHX1M U1_1_2 (.S(SUM[2]), 
	.CO(carry[3]), 
	.B(carry[2]), 
	.A(A[2]));
   ADDHX1M U1_1_1 (.S(SUM[1]), 
	.CO(carry[2]), 
	.B(A[0]), 
	.A(A[1]));
   CLKXOR2X2M U1 (.Y(SUM[7]), 
	.B(A[7]), 
	.A(carry[7]));
endmodule

module Clk_div_50_Div_Ratio8_test_1 (
	i_ref_clk, 
	i_rst_n, 
	i_clk_en, 
	i_div_ratio, 
	o_div_clk, 
	test_si2, 
	test_si1, 
	test_so2, 
	test_so1, 
	test_se, 
	FE_OFN18_SE, 
	n25__Exclude_0_NET, 
	CLK_SCAN_UART__L18_N0, 
	CLK_SCAN_UART__L3_N0, 
	CLK_SCAN_UART__L6_N0);
   input i_ref_clk;
   input i_rst_n;
   input i_clk_en;
   input [7:0] i_div_ratio;
   output o_div_clk;
   input test_si2;
   input test_si1;
   output test_so2;
   output test_so1;
   input test_se;
   input FE_OFN18_SE;
   input n25__Exclude_0_NET;
   input CLK_SCAN_UART__L18_N0;
   input CLK_SCAN_UART__L3_N0;
   input CLK_SCAN_UART__L6_N0;

   // Internal wires
   wire n14__Exclude_0_NET;
   wire q2__Exclude_0_NET;
   wire HTIE_LTIEHI_NET;
   wire LTIE_LTIELO_NET;
   wire FE_UNCONNECTED_0;
   wire N9;
   wire N10;
   wire N11;
   wire N12;
   wire N13;
   wire N14;
   wire N15;
   wire N19;
   wire N20;
   wire N21;
   wire N22;
   wire N23;
   wire N24;
   wire N25;
   wire N34;
   wire N35;
   wire N36;
   wire N37;
   wire N38;
   wire N39;
   wire N40;
   wire N41;
   wire q2;
   wire n1;
   wire n4;
   wire n5;
   wire n7;
   wire n8;
   wire n9;
   wire n10;
   wire n11;
   wire n12;
   wire n13;
   wire n14;
   wire n28;
   wire n29;
   wire n30;
   wire n31;
   wire n32;
   wire n33;
   wire n34;
   wire n35;
   wire n36;
   wire n37;
   wire n38;
   wire n39;
   wire n40;
   wire n41;
   wire n42;
   wire n43;
   wire n44;
   wire n45;
   wire n46;
   wire n47;
   wire n48;
   wire n49;
   wire n50;
   wire n51;
   wire n52;
   wire n53;
   wire n54;
   wire n55;
   wire n56;
   wire n57;
   wire n58;
   wire n59;
   wire n60;
   wire n61;
   wire n62;
   wire n63;
   wire n64;
   wire n65;
   wire n66;
   wire n67;
   wire n76;
   wire n78;
   wire n98;
   wire [7:0] counter;

   BUFX8M n14__Exclude_0 (.Y(n14__Exclude_0_NET), 
	.A(n14));
   BUFX8M q2__Exclude_0 (.Y(q2__Exclude_0_NET), 
	.A(q2));
   TIEHIM HTIE_LTIEHI (.Y(HTIE_LTIEHI_NET));
   TIELOM LTIE_LTIELO (.Y(LTIE_LTIELO_NET));
   SDFFRQX4M \counter_reg[6]  (.SI(counter[5]), 
	.SE(FE_OFN18_SE), 
	.RN(i_rst_n), 
	.Q(counter[6]), 
	.D(N40), 
	.CK(CLK_SCAN_UART__L18_N0));
   SDFFRQX1M \counter_reg[7]  (.SI(counter[6]), 
	.SE(test_se), 
	.RN(i_rst_n), 
	.Q(counter[7]), 
	.D(N41), 
	.CK(CLK_SCAN_UART__L18_N0));
   SDFFRQX2M \counter_reg[4]  (.SI(counter[3]), 
	.SE(FE_OFN18_SE), 
	.RN(i_rst_n), 
	.Q(counter[4]), 
	.D(N38), 
	.CK(CLK_SCAN_UART__L18_N0));
   SDFFRQX4M \counter_reg[0]  (.SI(test_si1), 
	.SE(FE_OFN18_SE), 
	.RN(i_rst_n), 
	.Q(counter[0]), 
	.D(N34), 
	.CK(CLK_SCAN_UART__L18_N0));
   SDFFRQX1M q1_reg (.SI(counter[7]), 
	.SE(test_se), 
	.RN(i_rst_n), 
	.Q(test_so1), 
	.D(n76), 
	.CK(CLK_SCAN_UART__L6_N0));
   SDFFRQX2M \counter_reg[5]  (.SI(counter[4]), 
	.SE(FE_OFN18_SE), 
	.RN(i_rst_n), 
	.Q(counter[5]), 
	.D(N39), 
	.CK(CLK_SCAN_UART__L18_N0));
   SDFFRQX2M \counter_reg[3]  (.SI(counter[2]), 
	.SE(FE_OFN18_SE), 
	.RN(i_rst_n), 
	.Q(counter[3]), 
	.D(N37), 
	.CK(CLK_SCAN_UART__L18_N0));
   SDFFRQX2M \counter_reg[1]  (.SI(counter[0]), 
	.SE(FE_OFN18_SE), 
	.RN(i_rst_n), 
	.Q(counter[1]), 
	.D(N35), 
	.CK(CLK_SCAN_UART__L18_N0));
   SDFFRQX2M \counter_reg[2]  (.SI(counter[1]), 
	.SE(FE_OFN18_SE), 
	.RN(i_rst_n), 
	.Q(counter[2]), 
	.D(N36), 
	.CK(CLK_SCAN_UART__L18_N0));
   SDFFNSRHX1M q2_reg (.SN(HTIE_LTIEHI_NET), 
	.SI(test_si2), 
	.SE(test_se), 
	.RN(i_rst_n), 
	.QN(test_so2), 
	.Q(q2), 
	.D(n78), 
	.CKN(CLK_SCAN_UART__L3_N0));
   OR2X1M U3 (.Y(n1), 
	.B(i_div_ratio[3]), 
	.A(n5));
   AOI222X1M U4 (.Y(n37), 
	.C1(n10), 
	.C0(counter[4]), 
	.B1(n40), 
	.B0(n39), 
	.A1(n38), 
	.A0(counter[3]));
   INVX2M U5 (.Y(n46), 
	.A(i_div_ratio[1]));
   OAI32X1M U6 (.Y(n54), 
	.B1(n60), 
	.B0(counter[5]), 
	.A2(n59), 
	.A1(n58), 
	.A0(n57));
   NOR2X2M U7 (.Y(n59), 
	.B(n36), 
	.A(N13));
   AOI221XLM U8 (.Y(n29), 
	.C0(n34), 
	.B1(n32), 
	.B0(counter[6]), 
	.A1(n33), 
	.A0(counter[5]));
   AOI221XLM U9 (.Y(n34), 
	.C0(n37), 
	.B1(n36), 
	.B0(LTIE_LTIELO_NET), 
	.A1(n35), 
	.A0(LTIE_LTIELO_NET));
   AOI221XLM U10 (.Y(n58), 
	.C0(n61), 
	.B1(n35), 
	.B0(N12), 
	.A1(n45), 
	.A0(N11));
   AOI222X1M U11 (.Y(n61), 
	.C1(counter[3]), 
	.C0(n65), 
	.B1(n64), 
	.B0(n63), 
	.A1(counter[2]), 
	.A0(n62));
   OAI21X2M U12 (.Y(n13), 
	.B0(HTIE_LTIEHI_NET), 
	.A1(n53), 
	.A0(n52));
   NAND3X1M U13 (.Y(n53), 
	.C(n46), 
	.B(n48), 
	.A(n47));
   OR2X2M U14 (.Y(n5), 
	.B(i_div_ratio[2]), 
	.A(n4));
   NAND2BX2M U15 (.Y(n4), 
	.B(n11), 
	.AN(i_div_ratio[1]));
   OAI31X1M U16 (.Y(n43), 
	.B0(n47), 
	.A2(counter[0]), 
	.A1(counter[1]), 
	.A0(n46));
   NAND2X2M U17 (.Y(n8), 
	.B(n10), 
	.A(n7));
   AO21XLM U18 (.Y(N12), 
	.B0(n7), 
	.A1(LTIE_LTIELO_NET), 
	.A0(n1));
   NOR2X2M U19 (.Y(n7), 
	.B(LTIE_LTIELO_NET), 
	.A(n1));
   OR3X2M U20 (.Y(n49), 
	.C(n13), 
	.B(n51), 
	.A(n50));
   AOI222X1M U21 (.Y(n50), 
	.C1(n56), 
	.C0(N14), 
	.B1(n55), 
	.B0(n54), 
	.A1(n31), 
	.A0(N15));
   OAI21X2M U22 (.Y(N13), 
	.B0(n8), 
	.A1(n10), 
	.A0(n7));
   MX2XLM U23 (.Y(o_div_clk), 
	.S0(n13), 
	.B(i_ref_clk), 
	.A(n12));
   MX2XLM U35 (.Y(n78), 
	.S0(n13), 
	.B(q2__Exclude_0_NET), 
	.A(n25__Exclude_0_NET));
   INVXLM U36 (.Y(n60), 
	.A(N13));
   XNOR2X2M U37 (.Y(N14), 
	.B(n8), 
	.A(LTIE_LTIELO_NET));
   NAND2XLM U38 (.Y(n40), 
	.B(n41), 
	.A(i_div_ratio[3]));
   INVX2M U39 (.Y(n35), 
	.A(counter[4]));
   INVX2M U40 (.Y(n31), 
	.A(counter[7]));
   INVX2M U41 (.Y(n32), 
	.A(LTIE_LTIELO_NET));
   INVX2M U42 (.Y(n11), 
	.A(i_div_ratio[0]));
   INVX2M U45 (.Y(n10), 
	.A(LTIE_LTIELO_NET));
   OAI2BB1X1M U46 (.Y(N9), 
	.B0(n4), 
	.A1N(i_div_ratio[1]), 
	.A0N(i_div_ratio[0]));
   OAI2BB1X1M U47 (.Y(N10), 
	.B0(n5), 
	.A1N(i_div_ratio[2]), 
	.A0N(n4));
   OAI2BB1X1M U49 (.Y(N11), 
	.B0(n1), 
	.A1N(i_div_ratio[3]), 
	.A0N(n5));
   NOR2X1M U50 (.Y(n9), 
	.B(n8), 
	.A(LTIE_LTIELO_NET));
   CLKXOR2X2M U51 (.Y(N15), 
	.B(n9), 
	.A(LTIE_LTIELO_NET));
   OAI2BB1X1M U52 (.Y(n12), 
	.B0(n14), 
	.A1N(i_div_ratio[0]), 
	.A0N(q2));
   MXI2X1M U53 (.Y(n76), 
	.S0(n13), 
	.B(n14__Exclude_0_NET), 
	.A(n28));
   CLKINVX1M U54 (.Y(n14), 
	.A(test_so1));
   OAI21X1M U55 (.Y(n28), 
	.B0(n31), 
	.A1(n30), 
	.A0(n29));
   NOR2X1M U56 (.Y(n30), 
	.B(n32), 
	.A(counter[6]));
   AOI32X1M U57 (.Y(n39), 
	.B1(n45), 
	.B0(LTIE_LTIELO_NET), 
	.A2(n44), 
	.A1(n43), 
	.A0(n42));
   OAI21X1M U58 (.Y(n44), 
	.B0(counter[1]), 
	.A1(n46), 
	.A0(counter[0]));
   CLKNAND2X2M U59 (.Y(n42), 
	.B(n48), 
	.A(counter[2]));
   NOR2BX1M U60 (.Y(N41), 
	.B(n49), 
	.AN(N25));
   NOR2BX1M U61 (.Y(N40), 
	.B(n49), 
	.AN(N24));
   NOR2BX1M U62 (.Y(N39), 
	.B(n49), 
	.AN(N23));
   NOR2BX1M U63 (.Y(N38), 
	.B(n49), 
	.AN(N22));
   NOR2BX1M U64 (.Y(N37), 
	.B(n49), 
	.AN(N21));
   NOR2BX1M U65 (.Y(N36), 
	.B(n49), 
	.AN(N20));
   NOR2BX1M U66 (.Y(N35), 
	.B(n49), 
	.AN(N19));
   NOR2BX1M U67 (.Y(N34), 
	.B(n49), 
	.AN(n67));
   CLKINVX1M U68 (.Y(n48), 
	.A(i_div_ratio[3]));
   CLKINVX1M U69 (.Y(n47), 
	.A(i_div_ratio[2]));
   NAND4X1M U70 (.Y(n52), 
	.D(n32), 
	.C(n33), 
	.B(n10), 
	.A(n38));
   CLKINVX1M U71 (.Y(n33), 
	.A(LTIE_LTIELO_NET));
   CLKINVX1M U72 (.Y(n38), 
	.A(LTIE_LTIELO_NET));
   NOR2X1M U73 (.Y(n51), 
	.B(n31), 
	.A(N15));
   CLKINVX1M U74 (.Y(n56), 
	.A(counter[6]));
   NAND2BX1M U75 (.Y(n55), 
	.B(counter[6]), 
	.AN(N14));
   CLKINVX1M U76 (.Y(n36), 
	.A(counter[5]));
   CLKINVX1M U77 (.Y(n65), 
	.A(N11));
   OAI211X1M U78 (.Y(n64), 
	.C0(n11), 
	.B0(n67), 
	.A1(n66), 
	.A0(N9));
   CLKINVX1M U79 (.Y(n67), 
	.A(counter[0]));
   AOI22X1M U80 (.Y(n63), 
	.B1(n66), 
	.B0(N9), 
	.A1(n41), 
	.A0(N10));
   CLKINVX1M U81 (.Y(n66), 
	.A(counter[1]));
   CLKINVX1M U82 (.Y(n41), 
	.A(counter[2]));
   CLKINVX1M U83 (.Y(n62), 
	.A(N10));
   CLKINVX1M U84 (.Y(n45), 
	.A(counter[3]));
   NOR2X1M U85 (.Y(n57), 
	.B(n35), 
	.A(N12));
   INVXLM U99 (.Y(n98), 
	.A(n31));
   Clk_div_50_Div_Ratio8_1_DW01_inc_0 add_36 (.A({ n98,
		counter[6],
		counter[5],
		counter[4],
		counter[3],
		counter[2],
		counter[1],
		counter[0] }), 
	.SUM({ N25,
		N24,
		N23,
		N22,
		N21,
		N20,
		N19,
		FE_UNCONNECTED_0 }));
endmodule

module CLK_DIV_MUX_WIDTH8 (
	IN, 
	OUT);
   input [5:0] IN;
   output [7:0] OUT;

   // Internal wires
   wire HTIE_LTIEHI_NET;
   wire n5;
   wire n6;
   wire n7;
   wire n8;
   wire n9;
   wire n14;
   wire n15;
   wire n16;
   wire n17;

   TIEHIM HTIE_LTIEHI (.Y(HTIE_LTIEHI_NET));
   OAI211X2M U11 (.Y(OUT[0]), 
	.C0(n16), 
	.B0(n17), 
	.A1(n9), 
	.A0(n8));
   NOR4X1M U12 (.Y(OUT[3]), 
	.D(IN[4]), 
	.C(IN[5]), 
	.B(IN[3]), 
	.A(n5));
   INVX2M U13 (.Y(n15), 
	.A(IN[2]));
   NOR3X2M U14 (.Y(OUT[2]), 
	.C(IN[0]), 
	.B(IN[1]), 
	.A(n6));
   NOR3X2M U15 (.Y(OUT[1]), 
	.C(IN[0]), 
	.B(IN[1]), 
	.A(n7));
   NOR4X1M U16 (.Y(n8), 
	.D(n15), 
	.C(IN[3]), 
	.B(IN[4]), 
	.A(IN[5]));
   CLKINVX1M U17 (.Y(n16), 
	.A(IN[1]));
   NAND4BX1M U18 (.Y(n7), 
	.D(n14), 
	.C(n15), 
	.B(IN[4]), 
	.AN(IN[3]));
   NAND4BX1M U19 (.Y(n6), 
	.D(n14), 
	.C(n15), 
	.B(IN[3]), 
	.AN(IN[4]));
   NAND3X1M U20 (.Y(n5), 
	.C(IN[2]), 
	.B(n16), 
	.A(n17));
   CLKINVX1M U21 (.Y(n14), 
	.A(IN[5]));
   INVX2M U22 (.Y(n17), 
	.A(IN[0]));
   NAND2X2M U23 (.Y(n9), 
	.B(n6), 
	.A(n7));
   INVX2M U3 (.Y(OUT[7]), 
	.A(HTIE_LTIEHI_NET));
   INVX2M U5 (.Y(OUT[6]), 
	.A(HTIE_LTIEHI_NET));
   INVX2M U7 (.Y(OUT[5]), 
	.A(HTIE_LTIEHI_NET));
   INVX2M U9 (.Y(OUT[4]), 
	.A(HTIE_LTIEHI_NET));
endmodule

module PULSE_GEN_test_1 (
	clk, 
	rst, 
	lvl_sig, 
	pulse_sig, 
	test_si, 
	test_so, 
	test_se, 
	CLK_SCAN_UART_TX__L3_N2);
   input clk;
   input rst;
   input lvl_sig;
   output pulse_sig;
   input test_si;
   output test_so;
   input test_se;
   input CLK_SCAN_UART_TX__L3_N2;

   // Internal wires
   wire lvl_sig_ff;
   wire pulse_flop;

   assign test_so = pulse_flop ;

   SDFFRQX2M pulse_flop_reg (.SI(lvl_sig_ff), 
	.SE(test_se), 
	.RN(rst), 
	.Q(pulse_flop), 
	.D(lvl_sig_ff), 
	.CK(CLK_SCAN_UART_TX__L3_N2));
   SDFFRQX2M lvl_sig_ff_reg (.SI(test_si), 
	.SE(test_se), 
	.RN(rst), 
	.Q(lvl_sig_ff), 
	.D(lvl_sig), 
	.CK(clk));
   NOR2BX2M U5 (.Y(pulse_sig), 
	.B(pulse_flop), 
	.AN(lvl_sig_ff));
endmodule

module Data_SYNC_NUM_STAGES2_BUS_WIDTH8_test_1 (
	CLK, 
	RST, 
	ASYNC, 
	BUS_EN, 
	ENABLE_PULSE, 
	SYNC_BUS, 
	test_si, 
	test_so, 
	test_se, 
	FE_OFN4_RST_SCAN_REF, 
	CLK_SCAN_REF__L5_N14);
   input CLK;
   input RST;
   input [7:0] ASYNC;
   input BUS_EN;
   output ENABLE_PULSE;
   output [7:0] SYNC_BUS;
   input test_si;
   output test_so;
   input test_se;
   input FE_OFN4_RST_SCAN_REF;
   input CLK_SCAN_REF__L5_N14;

   // Internal wires
   wire pulse_flop;
   wire n1;
   wire n4;
   wire n6;
   wire n8;
   wire n10;
   wire n12;
   wire n14;
   wire n16;
   wire n18;
   wire n30;
   wire [1:0] sync_enable_reg;

   assign test_so = sync_enable_reg[1] ;

   SDFFRQX2M pulse_flop_reg (.SI(SYNC_BUS[7]), 
	.SE(test_se), 
	.RN(RST), 
	.Q(pulse_flop), 
	.D(sync_enable_reg[1]), 
	.CK(CLK));
   SDFFRQX2M \sync_enable_reg_reg[1]  (.SI(sync_enable_reg[0]), 
	.SE(test_se), 
	.RN(RST), 
	.Q(sync_enable_reg[1]), 
	.D(sync_enable_reg[0]), 
	.CK(CLK));
   SDFFRQX2M \SYNC_BUS_reg[7]  (.SI(SYNC_BUS[6]), 
	.SE(test_se), 
	.RN(RST), 
	.Q(SYNC_BUS[7]), 
	.D(n18), 
	.CK(CLK));
   SDFFRQX2M \SYNC_BUS_reg[3]  (.SI(SYNC_BUS[2]), 
	.SE(test_se), 
	.RN(RST), 
	.Q(SYNC_BUS[3]), 
	.D(n10), 
	.CK(CLK));
   SDFFRQX2M \sync_enable_reg_reg[0]  (.SI(pulse_flop), 
	.SE(test_se), 
	.RN(RST), 
	.Q(sync_enable_reg[0]), 
	.D(BUS_EN), 
	.CK(CLK));
   SDFFRQX2M \SYNC_BUS_reg[5]  (.SI(SYNC_BUS[4]), 
	.SE(test_se), 
	.RN(RST), 
	.Q(SYNC_BUS[5]), 
	.D(n14), 
	.CK(CLK));
   SDFFRQX2M \SYNC_BUS_reg[1]  (.SI(SYNC_BUS[0]), 
	.SE(test_se), 
	.RN(FE_OFN4_RST_SCAN_REF), 
	.Q(SYNC_BUS[1]), 
	.D(n6), 
	.CK(CLK_SCAN_REF__L5_N14));
   CLKINVX2M U8 (.Y(n30), 
	.A(n1));
   NAND2BX2M U12 (.Y(n1), 
	.B(sync_enable_reg[1]), 
	.AN(pulse_flop));
   AO22X1M U25 (.Y(n4), 
	.B1(n1), 
	.B0(SYNC_BUS[0]), 
	.A1(n30), 
	.A0(ASYNC[0]));
   AO22X1M U26 (.Y(n12), 
	.B1(n1), 
	.B0(SYNC_BUS[4]), 
	.A1(n30), 
	.A0(ASYNC[4]));
   AO22X1M U27 (.Y(n8), 
	.B1(n1), 
	.B0(SYNC_BUS[2]), 
	.A1(n30), 
	.A0(ASYNC[2]));
   AO22X1M U28 (.Y(n16), 
	.B1(n1), 
	.B0(SYNC_BUS[6]), 
	.A1(n30), 
	.A0(ASYNC[6]));
   AO22X1M U29 (.Y(n6), 
	.B1(n1), 
	.B0(SYNC_BUS[1]), 
	.A1(n30), 
	.A0(ASYNC[1]));
   AO22X1M U30 (.Y(n14), 
	.B1(n1), 
	.B0(SYNC_BUS[5]), 
	.A1(n30), 
	.A0(ASYNC[5]));
   AO22X1M U31 (.Y(n10), 
	.B1(n1), 
	.B0(SYNC_BUS[3]), 
	.A1(n30), 
	.A0(ASYNC[3]));
   AO22X1M U32 (.Y(n18), 
	.B1(n1), 
	.B0(SYNC_BUS[7]), 
	.A1(n30), 
	.A0(ASYNC[7]));
   SDFFRQX4M ENABLE_PULSE_reg (.SI(test_si), 
	.SE(test_se), 
	.RN(FE_OFN4_RST_SCAN_REF), 
	.Q(ENABLE_PULSE), 
	.D(n30), 
	.CK(CLK));
   SDFFRQX4M \SYNC_BUS_reg[0]  (.SI(ENABLE_PULSE), 
	.SE(test_se), 
	.RN(FE_OFN4_RST_SCAN_REF), 
	.Q(SYNC_BUS[0]), 
	.D(n4), 
	.CK(CLK));
   SDFFRQX4M \SYNC_BUS_reg[2]  (.SI(SYNC_BUS[1]), 
	.SE(test_se), 
	.RN(FE_OFN4_RST_SCAN_REF), 
	.Q(SYNC_BUS[2]), 
	.D(n8), 
	.CK(CLK));
   SDFFRQX4M \SYNC_BUS_reg[6]  (.SI(SYNC_BUS[5]), 
	.SE(test_se), 
	.RN(RST), 
	.Q(SYNC_BUS[6]), 
	.D(n16), 
	.CK(CLK));
   SDFFRQX4M \SYNC_BUS_reg[4]  (.SI(SYNC_BUS[3]), 
	.SE(test_se), 
	.RN(RST), 
	.Q(SYNC_BUS[4]), 
	.D(n12), 
	.CK(CLK));
endmodule

module REG_file_WIDTH8_NO_OF_REG16_ADDR4_test_1 (
	CLK_regfile, 
	RST_regfile, 
	WrData, 
	Address, 
	WrEn, 
	RdEn, 
	RdData, 
	RdData_Valid, 
	REG0, 
	REG1, 
	REG2, 
	REG3, 
	test_si3, 
	test_si2, 
	test_si1, 
	test_so2, 
	test_so1, 
	test_se, 
	FE_OFN3_RST_SCAN_REF, 
	FE_OFN4_RST_SCAN_REF, 
	FE_OFN17_SE, 
	FE_OFN18_SE, 
	FE_OFN20_SE, 
	CLK_SCAN_REF__L5_N10, 
	CLK_SCAN_REF__L5_N12, 
	CLK_SCAN_REF__L5_N13, 
	CLK_SCAN_REF__L5_N14, 
	CLK_SCAN_REF__L5_N15, 
	CLK_SCAN_REF__L5_N8, 
	CLK_SCAN_REF__L5_N9);
   input CLK_regfile;
   input RST_regfile;
   input [7:0] WrData;
   input [3:0] Address;
   input WrEn;
   input RdEn;
   output [7:0] RdData;
   output RdData_Valid;
   output [7:0] REG0;
   output [7:0] REG1;
   output [7:0] REG2;
   output [7:0] REG3;
   input test_si3;
   input test_si2;
   input test_si1;
   output test_so2;
   output test_so1;
   input test_se;
   input FE_OFN3_RST_SCAN_REF;
   input FE_OFN4_RST_SCAN_REF;
   input FE_OFN17_SE;
   input FE_OFN18_SE;
   input FE_OFN20_SE;
   input CLK_SCAN_REF__L5_N10;
   input CLK_SCAN_REF__L5_N12;
   input CLK_SCAN_REF__L5_N13;
   input CLK_SCAN_REF__L5_N14;
   input CLK_SCAN_REF__L5_N15;
   input CLK_SCAN_REF__L5_N8;
   input CLK_SCAN_REF__L5_N9;

   // Internal wires
   wire FE_OFN8_n423;
   wire FE_OFN7_n422;
   wire FE_OFN6_n424;
   wire N11;
   wire N12;
   wire N13;
   wire N14;
   wire n511;
   wire n512;
   wire n513;
   wire n518;
   wire n519;
   wire \Reg_File[15][7] ;
   wire \Reg_File[15][6] ;
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
	.SE(test_se), 
	.RN(FE_OFN3_RST_SCAN_REF), 
	.Q(REG0[5]), 
	.D(n190), 
	.CK(CLK_SCAN_REF__L5_N10));
   SDFFRQX4M \Reg_File_reg[11][5]  (.SI(\Reg_File[11][4] ), 
	.SE(test_se), 
	.RN(FE_OFN3_RST_SCAN_REF), 
	.Q(\Reg_File[11][5] ), 
	.D(n278), 
	.CK(CLK_SCAN_REF__L5_N15));
endmodule
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
