Shnassar25/-Digital-IC-Design-SoC-RTL2GDS/PNR/pnr/export/SYS_TOP_pg.v

module CLKINVX8M (
	Y, 
	A, 
	VDD, 
	VSS);
   output Y;
   input A;
   inout VDD;
   inout VSS;
endmodule

module CLKINVX40M (
	Y, 
	A, 
	VDD, 
	VSS);
   output Y;
   input A;
   inout VDD;
   inout VSS;
endmodule

module CLKINVX16M (
	Y, 
	A, 
	VDD, 
	VSS);
   output Y;
   input A;
   inout VDD;
   inout VSS;
endmodule

module CLKINVX32M (
	Y, 
	A, 
	VDD, 
	VSS);
   output Y;
   input A;
   inout VDD;
   inout VSS;
endmodule

module CLKBUFX40M (
	Y, 
	A, 
	VDD, 
	VSS);
   output Y;
   input A;
   inout VDD;
   inout VSS;
endmodule

module CLKBUFX24M (
	Y, 
	A, 
	VDD, 
	VSS);
   output Y;
   input A;
   inout VDD;
   inout VSS;
endmodule

module BUFX16M (
	Y, 
	A, 
	VDD, 
	VSS);
   output Y;
   input A;
   inout VDD;
   inout VSS;
endmodule

module CLKBUFX12M (
	Y, 
	A, 
	VDD, 
	VSS);
   output Y;
   input A;
   inout VDD;
   inout VSS;
endmodule

module BUFX14M (
	Y, 
	A, 
	VDD, 
	VSS);
   output Y;
   input A;
   inout VDD;
   inout VSS;
endmodule

module CLKINVX6M (
	Y, 
	A, 
	VDD, 
	VSS);
   output Y;
   input A;
   inout VDD;
   inout VSS;
endmodule

module CLKINVX24M (
	Y, 
	A, 
	VDD, 
	VSS);
   output Y;
   input A;
   inout VDD;
   inout VSS;
endmodule

module CLKBUFX20M (
	Y, 
	A, 
	VDD, 
	VSS);
   output Y;
   input A;
   inout VDD;
   inout VSS;
endmodule

module BUFX8M (
	Y, 
	A, 
	VDD, 
	VSS);
   output Y;
   input A;
   inout VDD;
   inout VSS;
endmodule

module BUFX4M (
	Y, 
	A, 
	VDD, 
	VSS);
   output Y;
   input A;
   inout VDD;
   inout VSS;
endmodule

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
	SEL, 
	OUT, 
	VDD, 
	VSS);
   input IN_0;
   input IN_1;
   input SEL;
   output OUT;
   inout VDD;
   inout VSS;

   // Internal wires
   wire N0;

   assign N0 = SEL ;

   // Module instantiations
   MX2X2M U1 (
	.Y(OUT),
	.S0(N0),
	.B(IN_1),
	.A(IN_0), 
	.VDD(VDD), 
	.VSS(VSS));
endmodule

module mux2X1_6 (
	IN_0, 
	IN_1, 
	SEL, 
	OUT, 
	VDD, 
	VSS);
   input IN_0;
   input IN_1;
   input SEL;
   output OUT;
   inout VDD;
   inout VSS;

   // Internal wires
   wire N0;

   assign N0 = SEL ;

   // Module instantiations
   MX2X8M U1 (
	.Y(OUT),
	.S0(N0),
	.B(IN_1),
	.A(IN_0), 
	.VDD(VDD), 
	.VSS(VSS));
endmodule

module mux2X1_5 (
	IN_0, 
	IN_1, 
	SEL, 
	OUT, 
	VDD, 
	VSS);
   input IN_0;
   input IN_1;
   input SEL;
   output OUT;
   inout VDD;
   inout VSS;

   // Internal wires
   wire N0;

   assign N0 = SEL ;

   // Module instantiations
   MX2X8M U1 (
	.Y(OUT),
	.S0(N0),
	.B(IN_1),
	.A(IN_0), 
	.VDD(VDD), 
	.VSS(VSS));
endmodule

module RST_SYNC_NUM_STAGES2_test_0 (
	CLK_Rsync, 
	RST_Rsync, 
	SYNC_RST, 
	test_si, 
	test_se, 
	VDD, 
	VSS);
   input CLK_Rsync;
   input RST_Rsync;
   output SYNC_RST;
   input test_si;
   input test_se;
   inout VDD;
   inout VSS;

   // Internal wires
   wire HTIE_LTIEHI_NET;
   wire \sync_reg[0] ;

   // Module instantiations
   TIEHIM HTIE_LTIEHI (
	.Y(HTIE_LTIEHI_NET), 
	.VDD(VDD), 
	.VSS(VSS));
   SDFFRQX2M \sync_reg_reg[1]  (
	.SI(\sync_reg[0] ),
	.SE(test_se),
	.RN(RST_Rsync),
	.Q(SYNC_RST),
	.D(\sync_reg[0] ),
	.CK(CLK_Rsync), 
	.VDD(VDD), 
	.VSS(VSS));
   SDFFRQX2M \sync_reg_reg[0]  (
	.SI(test_si),
	.SE(test_se),
	.RN(RST_Rsync),
	.Q(\sync_reg[0] ),
	.D(HTIE_LTIEHI_NET),
	.CK(CLK_Rsync), 
	.VDD(VDD), 
	.VSS(VSS));
endmodule

module RST_SYNC_NUM_STAGES2_test_1 (
	CLK_Rsync, 
	RST_Rsync, 
	SYNC_RST, 
	test_si, 
	test_se, 
	VDD, 
	VSS);
   input CLK_Rsync;
   input RST_Rsync;
   output SYNC_RST;
   input test_si;
   input test_se;
   inout VDD;
   inout VSS;

   // Internal wires
   wire HTIE_LTIEHI_NET;
   wire \sync_reg[0] ;

   // Module instantiations
   TIEHIM HTIE_LTIEHI (
	.Y(HTIE_LTIEHI_NET), 
	.VDD(VDD), 
	.VSS(VSS));
   SDFFRQX1M \sync_reg_reg[1]  (
	.SI(\sync_reg[0] ),
	.SE(test_se),
	.RN(RST_Rsync),
	.Q(SYNC_RST),
	.D(\sync_reg[0] ),
	.CK(CLK_Rsync), 
	.VDD(VDD), 
	.VSS(VSS));
   SDFFRQX1M \sync_reg_reg[0]  (
	.SI(test_si),
	.SE(test_se),
	.RN(RST_Rsync),
	.Q(\sync_reg[0] ),
	.D(HTIE_LTIEHI_NET),
	.CK(CLK_Rsync), 
	.VDD(VDD), 
	.VSS(VSS));
endmodule

module Clk_div_50_Div_Ratio8_test_0 (
	i_ref_clk, 
	i_rst_n, 
	i_clk_en, 
	i_div_ratio, 
	o_div_clk, 
	test_si2, 
	test_si1, 
	test_so2, 
	test_so1, 
	test_se, 
	n24__Exclude_0_NET, 
	SPCPT1_SO_3_, 
	CLK_SCAN_UART__L18_N1, 
	CLK_SCAN_UART__L4_N0, 
	CLK_SCAN_UART__L9_N1, 
	VDD, 
	VSS);
   input i_ref_clk;
   input i_rst_n;
   input i_clk_en;
   input [7:0] i_div_ratio;
   output o_div_clk;
   input test_si2;
   input test_si1;
   output test_so2;
   output test_so1;
   input test_se;
   input n24__Exclude_0_NET;
   input SPCPT1_SO_3_;
   input CLK_SCAN_UART__L18_N1;
   input CLK_SCAN_UART__L4_N0;
   input CLK_SCAN_UART__L9_N1;
   inout VDD;
   inout VSS;

   // Internal wires
   wire n32__Exclude_0_NET;
   wire HTIE_LTIEHI_NET;
   wire N8;
   wire N9;
   wire N10;
   wire N11;
   wire N12;
   wire N13;
   wire N14;
   wire N15;
   wire N18;
   wire N19;
   wire N20;
   wire N21;
   wire N22;
   wire N23;
   wire N24;
   wire N25;
   wire N34;
   wire N35;
   wire N36;
   wire N37;
   wire N38;
   wire N39;
   wire N40;
   wire N41;
   wire q1;
   wire n17;
   wire n19;
   wire n1;
   wire n2;
   wire n3;
   wire n4;
   wire n11;
   wire n12;
   wire n13;
   wire n14;
   wire n28;
   wire n29;
   wire n30;
   wire n31;
   wire n32;
   wire n33;
   wire n34;
   wire n35;
   wire n36;
   wire n37;
   wire n38;
   wire n39;
   wire n40;
   wire n41;
   wire n42;
   wire n43;
   wire n44;
   wire n45;
   wire n46;
   wire n47;
   wire n48;
   wire n49;
   wire n50;
   wire n51;
   wire n52;
   wire n53;
   wire n54;
   wire n55;
   wire n56;
   wire n57;
   wire n58;
   wire n59;
   wire n60;
   wire n61;
   wire n62;
   wire n63;
   wire n64;
   wire n65;
   wire n66;
   wire n67;
   wire n68;
   wire n69;
   wire n70;
   wire n71;
   wire n90;
   wire n5;
   wire [7:0] counter;

   // Module instantiations
   BUFX8M n32__Exclude_0 (
	.Y(n32__Exclude_0_NET),
	.A(n32), 
	.VDD(VDD), 
	.VSS(VSS));
   TIEHIM HTIE_LTIEHI (
	.Y(HTIE_LTIEHI_NET), 
	.VDD(VDD), 
	.VSS(VSS));
   SDFFRQX2M \counter_reg[4]  (
	.SI(counter[3]),
	.SE(test_se),
	.RN(i_rst_n),
	.Q(counter[4]),
	.D(N38),
	.CK(CLK_SCAN_UART__L18_N1), 
	.VDD(VDD), 
	.VSS(VSS));
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
	.VDD(VDD), 
	.VSS(VSS));
   NOR2X1M U90 (
	.Y(n62),
	.B(n40),
	.A(N12), 
	.VDD(VDD), 
	.VSS(VSS));
   Clk_div_50_Div_Ratio8_0_DW01_inc_0 add_36 (
	.A({ counter[7],
		n4,
		counter[5],
		counter[4],
		counter[3],
		counter[2],
		counter[1],
		n2 }),
	.SUM({ N25,
		N24,
		N23,
		N22,
		N21,
		N20,
		N19,
		N18 }), 
	.VDD(VDD), 
	.VSS(VSS));
   SDFFRQX2M \counter_reg[6]  (
	.SI(counter[5]),
	.SE(test_se),
	.RN(i_rst_n),
	.Q(counter[6]),
	.D(N40),
	.CK(CLK_SCAN_UART__L18_N1), 
	.VDD(VDD), 
	.VSS(VSS));
   SDFFRQX2M \counter_reg[0]  (
	.SI(test_si1),
	.SE(test_se),
	.RN(i_rst_n),
	.Q(counter[0]),
	.D(N34),
	.CK(CLK_SCAN_UART__L18_N1), 
	.VDD(VDD), 
	.VSS(VSS));
   INVXLM U8 (
	.Y(n5),
	.A(n90), 
	.VDD(VDD), 
	.VSS(VSS));
   INVX2M U9 (
	.Y(test_so2),
	.A(n5), 
	.VDD(VDD), 
	.VSS(VSS));
endmodule

module Clk_div_50_Div_Ratio8_0_DW01_inc_0 (
	A, 
	SUM, 
	VDD, 
	VSS);
   input [7:0] A;
   output [7:0] SUM;
   inout VDD;
   inout VSS;

   // Internal wires
   wire [7:2] carry;

   // Module instantiations
   ADDHX1M U1_1_6 (
	.S(SUM[6]),
	.CO(carry[7]),
	.B(carry[6]),
	.A(A[6]), 
	.VDD(VDD), 
	.VSS(VSS));
   ADDHX1M U1_1_4 (
	.S(SUM[4]),
	.CO(carry[5]),
	.B(carry[4]),
	.A(A[4]), 
	.VDD(VDD), 
	.VSS(VSS));
   ADDHX1M U1_1_5 (
	.S(SUM[5]),
	.CO(carry[6]),
	.B(carry[5]),
	.A(A[5]), 
	.VDD(VDD), 
	.VSS(VSS));
   ADDHX1M U1_1_3 (
	.S(SUM[3]),
	.CO(carry[4]),
	.B(carry[3]),
	.A(A[3]), 
	.VDD(VDD), 
	.VSS(VSS));
   ADDHX1M U1_1_2 (
	.S(SUM[2]),
	.CO(carry[3]),
	.B(carry[2]),
	.A(A[2]), 
	.VDD(VDD), 
	.VSS(VSS));
   ADDHX1M U1_1_1 (
	.S(SUM[1]),
	.CO(carry[2]),
	.B(A[0]),
	.A(A[1]), 
	.VDD(VDD), 
	.VSS(VSS));
   CLKXOR2X2M U1 (
	.Y(SUM[7]),
	.B(A[7]),
	.A(carry[7]), 
	.VDD(VDD), 
	.VSS(VSS));
   CLKINVX1M U2 (
	.Y(SUM[0]),
	.A(A[0]), 
	.VDD(VDD), 
	.VSS(VSS));
endmodule

module Clk_div_50_Div_Ratio8_test_1 (
	i_ref_clk, 
	i_rst_n, 
	i_clk_en, 
	i_div_ratio, 
	o_div_clk, 
	test_si2, 
	test_si1, 
	test_so2, 
	test_so1, 
	test_se, 
	FE_OFN18_SE, 
	n25__Exclude_0_NET, 
	CLK_SCAN_UART__L18_N0, 
	CLK_SCAN_UART__L3_N0, 
	CLK_SCAN_UART__L6_N0, 
	VDD, 
	VSS);
   input i_ref_clk;
   input i_rst_n;
   input i_clk_en;
   input [7:0] i_div_ratio;
   output o_div_clk;
   input test_si2;
   input test_si1;
   output test_so2;
   output test_so1;
   input test_se;
   input FE_OFN18_SE;
   input n25__Exclude_0_NET;
   input CLK_SCAN_UART__L18_N0;
   input CLK_SCAN_UART__L3_N0;
   input CLK_SCAN_UART__L6_N0;
   inout VDD;
   inout VSS;

   // Internal wires
   wire n14__Exclude_0_NET;
   wire q2__Exclude_0_NET;
   wire HTIE_LTIEHI_NET;
   wire LTIE_LTIELO_NET;
   wire FE_UNCONNECTED_0;
   wire N9;
   wire N10;
   wire N11;
   wire N12;
   wire N13;
   wire N14;
   wire N15;
   wire N19;
   wire N20;
   wire N21;
   wire N22;
   wire N23;
   wire N24;
   wire N25;
   wire N34;
   wire N35;
   wire N36;
   wire N37;
   wire N38;
   wire N39;
   wire N40;
   wire N41;
   wire q2;
   wire n1;
   wire n4;
   wire n5;
   wire n7;
   wire n8;
   wire n9;
   wire n10;
   wire n11;
   wire n12;
   wire n13;
   wire n14;
   wire n28;
   wire n29;
   wire n30;
   wire n31;
   wire n32;
   wire n33;
   wire n34;
   wire n35;
   wire n36;
   wire n37;
   wire n38;
   wire n39;
   wire n40;
   wire n41;
   wire n42;
   wire n43;
   wire n44;
   wire n45;
   wire n46;
   wire n47;
   wire n48;
   wire n49;
   wire n50;
   wire n51;
   wire n52;
   wire n53;
   wire n54;
   wire n55;
   wire n56;
   wire n57;
   wire n58;
   wire n59;
   wire n60;
   wire n61;
   wire n62;
   wire n63;
   wire n64;
   wire n65;
   wire n66;
   wire n67;
   wire n76;
   wire n78;
   wire n98;
   wire [7:0] counter;

   // Module instantiations
   BUFX8M n14__Exclude_0 (
	.Y(n14__Exclude_0_NET),
	.A(n14), 
	.VDD(VDD), 
	.VSS(VSS));
   BUFX8M q2__Exclude_0 (
	.Y(q2__Exclude_0_NET),
	.A(q2), 
	.VDD(VDD), 
	.VSS(VSS));
   TIEHIM HTIE_LTIEHI (
	.Y(HTIE_LTIEHI_NET), 
	.VDD(VDD), 
	.VSS(VSS));
   TIELOM LTIE_LTIELO (
	.Y(LTIE_LTIELO_NET), 
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
	.VDD(VDD), 
	.VSS(VSS));
   CLKINVX1M U79 (
	.Y(n67),
	.A(counter[0]), 
	.VDD(VDD), 
	.VSS(VSS));
   AOI22X1M U80 (
	.Y(n63),
	.B1(n66),
	.B0(N9),
	.A1(n41),
	.A0(N10), 
	.VDD(VDD), 
	.VSS(VSS));
   CLKINVX1M U81 (
	.Y(n66),
	.A(counter[1]), 
	.VDD(VDD), 
	.VSS(VSS));
   CLKINVX1M U82 (
	.Y(n41),
	.A(counter[2]), 
	.VDD(VDD), 
	.VSS(VSS));
   CLKINVX1M U83 (
	.Y(n62),
	.A(N10), 
	.VDD(VDD), 
	.VSS(VSS));
   CLKINVX1M U84 (
	.Y(n45),
	.A(counter[3]), 
	.VDD(VDD), 
	.VSS(VSS));
   NOR2X1M U85 (
	.Y(n57),
	.B(n35),
	.A(N12), 
	.VDD(VDD), 
	.VSS(VSS));
   INVXLM U99 (
	.Y(n98),
	.A(n31), 
	.VDD(VDD), 
	.VSS(VSS));
   Clk_div_50_Div_Ratio8_1_DW01_inc_0 add_36 (
	.A({ n98,
		counter[6],
		counter[5],
		counter[4],
		counter[3],
		counter[2],
		counter[1],
		counter[0] }),
	.SUM({ N25,
		N24,
		N23,
		N22,
		N21,
		N20,
		N19,
		FE_UNCONNECTED_0 }), 
	.VDD(VDD), 
	.VSS(VSS));
endmodule

module Clk_div_50_Div_Ratio8_1_DW01_inc_0 (
	A, 
	SUM, 
	VDD, 
	VSS);
   input [7:0] A;
   output [7:0] SUM;
   inout VDD;
   inout VSS;

   // Internal wires
   wire [7:2] carry;

   // Module instantiations
   ADDHX1M U1_1_6 (
	.S(SUM[6]),
	.CO(carry[7]),
	.B(carry[6]),
	.A(A[6]), 
	.VDD(VDD), 
	.VSS(VSS));
   ADDHX1M U1_1_4 (
	.S(SUM[4]),
	.CO(carry[5]),
	.B(carry[4]),
	.A(A[4]), 
	.VDD(VDD), 
	.VSS(VSS));
   ADDHX1M U1_1_5 (
	.S(SUM[5]),
	.CO(carry[6]),
	.B(carry[5]),
	.A(A[5]), 
	.VDD(VDD), 
	.VSS(VSS));
   ADDHX1M U1_1_3 (
	.S(SUM[3]),
	.CO(carry[4]),
	.B(carry[3]),
	.A(A[3]), 
	.VDD(VDD), 
	.VSS(VSS));
   ADDHX1M U1_1_2 (
	.S(SUM[2]),
	.CO(carry[3]),
	.B(carry[2]),
	.A(A[2]), 
	.VDD(VDD), 
	.VSS(VSS));
   ADDHX1M U1_1_1 (
	.S(SUM[1]),
	.CO(carry[2]),
	.B(A[0]),
	.A(A[1]), 
	.VDD(VDD), 
	.VSS(VSS));
   CLKXOR2X2M U1 (
	.Y(SUM[7]),
	.B(A[7]),
	.A(carry[7]), 
	.VDD(VDD), 
	.VSS(VSS));
endmodule

module CLK_DIV_MUX_WIDTH8 (
	IN, 
	OUT, 
	VDD, 
	VSS);
   input [5:0] IN;
   output [7:0] OUT;
   inout VDD;
   inout VSS;

   // Internal wires
   wire HTIE_LTIEHI_NET;
   wire n5;
   wire n6;
   wire n7;
   wire n8;
   wire n9;
   wire n14;
   wire n15;
   wire n16;
   wire n17;

   // Module instantiations
   TIEHIM HTIE_LTIEHI (
	.Y(HTIE_LTIEHI_NET), 
	.VDD(VDD), 
	.VSS(VSS));
   OAI211X2M U11 (
	.Y(OUT[0]),
	.C0(n16),
	.B0(n17),
	.A1(n9),
	.A0(n8), 
	.VDD(VDD), 
	.VSS(VSS));
   NOR4X1M U12 (
	.Y(OUT[3]),
	.D(IN[4]),
	.C(IN[5]),
	.B(IN[3]),
	.A(n5), 
	.VDD(VDD), 
	.VSS(VSS));
   INVX2M U13 (
	.Y(n15),
	.A(IN[2]), 
	.VDD(VDD), 
	.VSS(VSS));
   NOR3X2M U14 (
	.Y(OUT[2]),
	.C(IN[0]),
	.B(IN[1]),
	.A(n6), 
	.VDD(VDD), 
	.VSS(VSS));
   NOR3X2M U15 (
	.Y(OUT[1]),
	.C(IN[0]),
	.B(IN[1]),
	.A(n7), 
	.VDD(VDD), 
	.VSS(VSS));
   NOR4X1M U16 (
	.Y(n8),
	.D(n15),
	.C(IN[3]),
	.B(IN[4]),
	.A(IN[5]), 
	.VDD(VDD), 
	.VSS(VSS));
   CLKINVX1M U17 (
	.Y(n16),
	.A(IN[1]), 
	.VDD(VDD), 
	.VSS(VSS));
   NAND4BX1M U18 (
	.Y(n7),
	.D(n14),
	.C(n15),
	.B(IN[4]),
	.AN(IN[3]), 
	.VDD(VDD), 
	.VSS(VSS));
   NAND4BX1M U19 (
	.Y(n6),
	.D(n14),
	.C(n15),
	.B(IN[3]),
	.AN(IN[4]), 
	.VDD(VDD), 
	.VSS(VSS));
   NAND3X1M U20 (
	.Y(n5),
	.C(IN[2]),
	.B(n16),
	.A(n17), 
	.VDD(VDD), 
	.VSS(VSS));
   CLKINVX1M U21 (
	.Y(n14),
	.A(IN[5]), 
	.VDD(VDD), 
	.VSS(VSS));
   INVX2M U22 (
	.Y(n17),
	.A(IN[0]), 
	.VDD(VDD), 
	.VSS(VSS));
   NAND2X2M U23 (
	.Y(n9),
	.B(n6),
	.A(n7), 
	.VDD(VDD), 
	.VSS(VSS));
   INVX2M U3 (
	.Y(OUT[7]),
	.A(HTIE_LTIEHI_NET), 
	.VDD(VDD), 
	.VSS(VSS));
   INVX2M U5 (
	.Y(OUT[6]),
	.A(HTIE_LTIEHI_NET), 
	.VDD(VDD), 
	.VSS(VSS));
   INVX2M U7 (
	.Y(OUT[5]),
	.A(HTIE_LTIEHI_NET), 
	.VDD(VDD), 
	.VSS(VSS));
   INVX2M U9 (
	.Y(OUT[4]),
	.A(HTIE_LTIEHI_NET), 
	.VDD(VDD), 
	.VSS(VSS));
endmodule

module PULSE_GEN_test_1 (
	clk, 
	rst, 
	lvl_sig, 
	pulse_sig, 
	test_si, 
	test_so, 
	test_se, 
	CLK_SCAN_UART_TX__L3_N2, 
	VDD, 
	VSS);
   input clk;
   input rst;
   input lvl_sig;
   output pulse_sig;
   input test_si;
   output test_so;
   input test_se;
   input CLK_SCAN_UART_TX__L3_N2;
   inout VDD;
   inout VSS;

   // Internal wires
   wire lvl_sig_ff;
   wire pulse_flop;

   assign test_so = pulse_flop ;

   // Module instantiations
   SDFFRQX2M pulse_flop_reg (
	.SI(lvl_sig_ff),
	.SE(test_se),
	.RN(rst),
	.Q(pulse_flop),
	.D(lvl_sig_ff),
	.CK(CLK_SCAN_UART_TX__L3_N2), 
	.VDD(VDD), 
	.VSS(VSS));
   SDFFRQX2M lvl_sig_ff_reg (
	.SI(test_si),
	.SE(test_se),
	.RN(rst),
	.Q(lvl_sig_ff),
	.D(lvl_sig),
	.CK(clk), 
	.VDD(VDD), 
	.VSS(VSS));
   NOR2BX2M U5 (
	.Y(pulse_sig),
	.B(pulse_flop),
	.AN(lvl_sig_ff), 
	.VDD(VDD), 
	.VSS(VSS));
endmodule

module Data_SYNC_NUM_STAGES2_BUS_WIDTH8_test_1 (
	CLK, 
	RST, 
	ASYNC, 
	BUS_EN, 
	ENABLE_PULSE, 
	SYNC_BUS, 
	test_si, 
	test_so, 
	test_se, 
	FE_OFN4_RST_SCAN_REF, 
	CLK_SCAN_REF__L5_N14, 
	VDD, 
	VSS);
   input CLK;
   input RST;
   input [7:0] ASYNC;
   input BUS_EN;
   output ENABLE_PULSE;
   output [7:0] SYNC_BUS;
   input test_si;
   output test_so;
   input test_se;
   input FE_OFN4_RST_SCAN_REF;
   input CLK_SCAN_REF__L5_N14;
   inout VDD;
   inout VSS;

   // Internal wires
   wire pulse_flop;
   wire n1;
   wire n4;
   wire n6;
   wire n8;
   wire n10;
   wire n12;
   wire n14;
   wire n16;
   wire n18;
   wire n30;
   wire [1:0] sync_enable_reg;

   assign test_so = sync_enable_reg[1] ;

   // Module instantiations
   SDFFRQX2M pulse_flop_reg (
	.SI(SYNC_BUS[7]),
	.SE(test_se),
	.RN(RST),
	.Q(pulse_flop),
	.D(sync_enable_reg[1]),
	.CK(CLK), 
	.VDD(VDD), 
	.VSS(VSS));
   SDFFRQX2M \sync_enable_reg_reg[1]  (
	.SI(sync_enable_reg[0]),
	.SE(test_se),
	.RN(RST),
	.Q(sync_enable_reg[1]),
	.D(sync_enable_reg[0]),
	.CK(CLK), 
	.VDD(VDD), 
	.VSS(VSS));
   SDFFRQX2M \SYNC_BUS_reg[7]  (
	.SI(SYNC_BUS[6]),
	.SE(test_se),
	.RN(RST),
	.Q(SYNC_BUS[7]),
	.D(n18),
	.CK(CLK), 
	.VDD(VDD), 
	.VSS(VSS));
   SDFFRQX2M \SYNC_BUS_reg[3]  (
	.SI(SYNC_BUS[2]),
	.SE(test_se),
	.RN(RST),
	.Q(SYNC_BUS[3]),
	.D(n10),
	.CK(CLK), 
	.VDD(VDD), 
	.VSS(VSS));
   SDFFRQX2M \sync_enable_reg_reg[0]  (
	.SI(pulse_flop),
	.SE(test_se),
	.RN(RST),
	.Q(sync_enable_reg[0]),
	.D(BUS_EN),
	.CK(CLK), 
	.VDD(VDD), 
	.VSS(VSS));
   SDFFRQX2M \SYNC_BUS_reg[5]  (
	.SI(SYNC_BUS[4]),
	.SE(test_se),
	.RN(RST),
	.Q(SYNC_BUS[5]),
	.D(n14),
	.CK(CLK), 
	.VDD(VDD), 
	.VSS(VSS));
   SDFFRQX2M \SYNC_BUS_reg[1]  (
	.SI(SYNC_BUS[0]),
	.SE(test_se),
	.RN(FE_OFN4_RST_SCAN_REF),
	.Q(SYNC_BUS[1]),
	.D(n6),
	.CK(CLK_SCAN_REF__L5_N14), 
	.VDD(VDD), 
	.VSS(VSS));
   CLKINVX2M U8 (
	.Y(n30),
	.A(n1), 
	.VDD(VDD), 
	.VSS(VSS));
   NAND2BX2M U12 (
	.Y(n1),
	.B(sync_enable_reg[1]),
	.AN(pulse_flop), 
	.VDD(VDD), 
	.VSS(VSS));
   AO22X1M U25 (
	.Y(n4),
	.B1(n1),
	.B0(SYNC_BUS[0]),
	.A1(n30),
	.A0(ASYNC[0]), 
	.VDD(VDD), 
	.VSS(VSS));
   AO22X1M U26 (
	.Y(n12),
	.B1(n1),
	.B0(SYNC_BUS[4]),
	.A1(n30),
	.A0(ASYNC[4]), 
	.VDD(VDD), 
	.VSS(VSS));
   AO22X1M U27 (
	.Y(n8),
	.B1(n1),
	.B0(SYNC_BUS[2]),
	.A1(n30),
	.A0(ASYNC[2]), 
	.VDD(VDD), 
	.VSS(VSS));
   AO22X1M U28 (
	.Y(n16),
	.B1(n1),
	.B0(SYNC_BUS[6]),
	.A1(n30),
	.A0(ASYNC[6]), 
	.VDD(VDD), 
	.VSS(VSS));
   AO22X1M U29 (
	.Y(n6),
	.B1(n1),
	.B0(SYNC_BUS[1]),
	.A1(n30),
	.A0(ASYNC[1]), 
	.VDD(VDD), 
	.VSS(VSS));
   AO22X1M U30 (
	.Y(n14),
	.B1(n1),
	.B0(SYNC_BUS[5]),
	.A1(n30),
	.A0(ASYNC[5]), 
	.VDD(VDD), 
	.VSS(VSS));
   AO22X1M U31 (
	.Y(n10),
	.B1(n1),
	.B0(SYNC_BUS[3]),
	.A1(n30),
	.A0(ASYNC[3]), 
	.VDD(VDD), 
	.VSS(VSS));
   AO22X1M U32 (
	.Y(n18),
	.B1(n1),
	.B0(SYNC_BUS[7]),
	.A1(n30),
	.A0(ASYNC[7]), 
	.VDD(VDD), 
	.VSS(VSS));
   SDFFRQX4M ENABLE_PULSE_reg (
	.SI(test_si),
	.SE(test_se),
	.RN(FE_OFN4_RST_SCAN_REF),
	.Q(ENABLE_PULSE),
	.D(n30),
	.CK(CLK), 
	.VDD(VDD), 
	.VSS(VSS));
   SDFFRQX4M \SYNC_BUS_reg[0]  (
	.SI(ENABLE_PULSE),
	.SE(test_se),
	.RN(FE_OFN4_RST_SCAN_REF),
	.Q(SYNC_BUS[0]),
	.D(n4),
	.CK(CLK), 
	.VDD(VDD), 
	.VSS(VSS));
   SDFFRQX4M \SYNC_BUS_reg[2]  (
	.SI(SYNC_BUS[1]),
	.SE(test_se),
	.RN(FE_OFN4_RST_SCAN_REF),
	.Q(SYNC_BUS[2]),
	.D(n8),
	.CK(CLK), 
	.VDD(VDD), 
	.VSS(VSS));
   SDFFRQX4M \SYNC_BUS_reg[6]  (
	.SI(SYNC_BUS[5]),
	.SE(test_se),
	.RN(RST),
	.Q(SYNC_BUS[6]),
	.D(n16),
	.CK(CLK), 
	.VDD(VDD), 
	.VSS(VSS));
   SDFFRQX4M \SYNC_BUS_reg[4]  (
	.SI(SYNC_BUS[3]),
	.SE(test_se),
	.RN(RST),
	.Q(SYNC_BUS[4]),
	.D(n12),
	.CK(CLK), 
	.VDD(VDD), 
	.VSS(VSS));
endmodule

module REG_file_WIDTH8_NO_OF_REG16_ADDR4_test_1 (
	CLK_regfile, 
	RST_regfile, 
	WrData, 
	Address, 
	WrEn, 
	RdEn, 
	RdData, 
	RdData_Valid, 
	REG0, 
	REG1, 
	REG2, 
	REG3, 
	test_si3, 
	test_si2, 
	test_si1, 
	test_so2, 
	test_so1, 
	test_se, 
	FE_OFN3_RST_SCAN_REF, 
	FE_OFN4_RST_SCAN_REF, 
	FE_OFN17_SE, 
	FE_OFN18_SE, 
	FE_OFN20_SE, 
	CLK_SCAN_REF__L5_N10, 
	CLK_SCAN_REF__L5_N12, 
	CLK_SCAN_REF__L5_N13, 
	CLK_SCAN_REF__L5_N14, 
	CLK_SCAN_REF__L5_N15, 
	CLK_SCAN_REF__L5_N8, 
	CLK_SCAN_REF__L5_N9, 
	VDD, 
	VSS);
   input CLK_regfile;
   input RST_regfile;
   input [7:0] WrData;
   input [3:0] Address;
   input WrEn;
   input RdEn;
   output [7:0] RdData;
   output RdData_Valid;
   output [7:0] REG0;
   output [7:0] REG1;
   output [7:0] REG2;
   output [7:0] REG3;
   input test_si3;
   input test_si2;
   input test_si1;
   output test_so2;
   output test_so1;
   input test_se;
   input FE_OFN3_RST_SCAN_REF;
   input FE_OFN4_RST_SCAN_REF;
   input FE_OFN17_SE;
   input FE_OFN18_SE;
   input FE_OFN20_SE;
   input CLK_SCAN_REF__L5_N10;
   input CLK_SCAN_REF__L5_N12;
   input CLK_SCAN_REF__L5_N13;
   input CLK_SCAN_REF__L5_N14;
   input CLK_SCAN_REF__L5_N15;
   input CLK_SCAN_REF__L5_N8;
   input CLK_SCAN_REF__L5_N9;
   inout VDD;
   inout VSS;

   // Internal wires
   wire FE_OFN8_n423;
   wire FE_OFN7_n422;
   wire FE_OFN6_n424;
   wire N11;
   wire N12;
   wire N13;
   wire N14;
   wire n511;
   wire n512;
   wire n513;
   wire n518;
   wire n519;
   wire \Reg_File[15][7] ;
   wire \Reg_File[15][6] ;
   wire \Reg_File[15][5] ;
   wire \Reg_File[15][4] ;
   wire \Reg_File[15][3] ;
   wire \Reg_File[15][2] ;
   wire \Reg_File[15][1] ;
   wire \Reg_File[15][0] ;
   wire \Reg_File[14][7] ;
   wire \Reg_File[14][6] ;
   wire \Reg_File[14][5] ;
   wire \Reg_File[14][4] ;
   wire \Reg_File[14][3] ;
   wire \Reg_File[14][2] ;
   wire \Reg_File[14][1] ;
   wire \Reg_File[14][0] ;
   wire \Reg_File[13][7] ;
   wire \Reg_File[13][6] ;
   wire \Reg_File[13][5] ;
   wire \Reg_File[13][4] ;
   wire \Reg_File[13][3] ;
   wire \Reg_File[13][2] ;
   wire \Reg_File[13][1] ;
   wire \Reg_File[13][0] ;
   wire \Reg_File[12][7] ;
   wire \Reg_File[12][6] ;
   wire \Reg_File[12][5] ;
   wire \Reg_File[12][4] ;
   wire \Reg_File[12][3] ;
   wire \Reg_File[12][2] ;
   wire \Reg_File[12][1] ;
   wire \Reg_File[12][0] ;
   wire \Reg_File[11][7] ;
   wire \Reg_File[11][6] ;
   wire \Reg_File[11][5] ;
   wire \Reg_File[11][4] ;
   wire \Reg_File[11][3] ;
   wire \Reg_File[11][2] ;
   wire \Reg_File[11][1] ;
   wire \Reg_File[11][0] ;
   wire \Reg_File[10][7] ;
   wire \Reg_File[10][6] ;
   wire \Reg_File[10][5] ;
   wire \Reg_File[10][4] ;
   wire \Reg_File[10][3] ;
   wire \Reg_File[10][2] ;
   wire \Reg_File[10][1] ;
   wire \Reg_File[10][0] ;
   wire \Reg_File[9][7] ;
   wire \Reg_File[9][6] ;
   wire \Reg_File[9][5] ;
   wire \Reg_File[9][4] ;
   wire \Reg_File[9][3] ;
   wire \Reg_File[9][2] ;
   wire \Reg_File[9][1] ;
   wire \Reg_File[9][0] ;
   wire \Reg_File[8][7] ;
   wire \Reg_File[8][6] ;
   wire \Reg_File[8][5] ;
   wire \Reg_File[8][4] ;
   wire \Reg_File[8][3] ;
   wire \Reg_File[8][2] ;
   wire \Reg_File[8][1] ;
   wire \Reg_File[8][0] ;
   wire \Reg_File[7][7] ;
   wire \Reg_File[7][6] ;
   wire \Reg_File[7][5] ;
   wire \Reg_File[7][4] ;
   wire \Reg_File[7][3] ;
   wire \Reg_File[7][2] ;
   wire \Reg_File[7][1] ;
   wire \Reg_File[7][0] ;
   wire \Reg_File[6][7] ;
   wire \Reg_File[6][6] ;
   wire \Reg_File[6][5] ;
   wire \Reg_File[6][4] ;
   wire \Reg_File[6][3] ;
   wire \Reg_File[6][2] ;
   wire \Reg_File[6][1] ;
   wire \Reg_File[6][0] ;
   wire \Reg_File[5][7] ;
   wire \Reg_File[5][6] ;
   wire \Reg_File[5][5] ;
   wire \Reg_File[5][4] ;
   wire \Reg_File[5][3] ;
   wire \Reg_File[5][2] ;
   wire \Reg_File[5][1] ;
   wire \Reg_File[5][0] ;
   wire \Reg_File[4][7] ;
   wire \Reg_File[4][6] ;
   wire \Reg_File[4][5] ;
   wire \Reg_File[4][4] ;
   wire \Reg_File[4][3] ;
   wire \Reg_File[4][2] ;
   wire \Reg_File[4][1] ;
   wire \Reg_File[4][0] ;
   wire N36;
   wire N37;
   wire N38;
   wire N39;
   wire N40;
   wire N41;
   wire N42;
   wire N43;
   wire n149;
   wire n150;
   wire n151;
   wire n152;
   wire n153;
   wire n154;
   wire n155;
   wire n156;
   wire n157;
   wire n158;
   wire n159;
   wire n160;
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
	.Q(REG0[5]),
	.D(n190),
	.CK(CLK_SCAN_REF__L5_N10), 
	.VDD(VDD), 
	.VSS(VSS));
   SDFFRQX4M \Reg_File_reg[11][5]  (
	.SI(\Reg_File[11][4] ),
	.SE(test_se),
	.RN(FE_OFN3_RST_SCAN_REF),
	.Q(\Reg_File[11][5] ),
	.D(n278),
	.CK(CLK_SCAN_REF__L5_N15), 
	.VDD(VDD), 
	.VSS(VSS));
endmodule
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
