Shnassar25/-Digital-IC-Design-SoC-RTL2GDS/(commit log)

2026-10-11 Revise README for ASIC/SoC Design Project
    Updated the README to reflect the complete ASIC/SoC design flow and added project details.
2026-10-11 Revise README for ASIC design flow documentation
    Updated the README to reflect the complete ASIC design flow and added detailed sections on features, architecture, and verification.
